tgtakaoka/RetroCyborg/schematics/mc6809/mezzanine_pin.txt

                      BionicMC6809 (backside)
              _________                       _____
 #HALT P40 40|        *|1  VSS        GND  48|    *|1   GND
  XTAL P50 39|         |2  P43 #NMI   P20  47|     |2   P10
 EXTAL P46 38|         |3  P42 #IRQ   P21  46|     |3   P11
#RESET P53 37|         |4  P45 #FIRQ  P22  45|     |4   P12
  MRDY P52 36|         |5  P51 BS     P23  44|  B  |5   P13
     Q P44 35|         |6  P55 BA     P24  43|  i  |6   P14
     E P47 34|         |7  VCC        P25  42|  o  |7   P15
 #BREQ P54 33|    M    |8  P20 A0     P26  41|  n  |8   P16
   R/W P41 32|    C    |9  P21 A1     P27  40|  i  |9   P17
    D0 P10 31|    6    |10 P22 A2      E1  39|  c  |10  E0
    D1 P11 30|    8    |11 P23 A3     P40  38|     |11  P30
    D2 P12 29|    0    |12 P24 A4     P41  37|  C  |12  P31
    D3 P13 28|    9    |13 P25 A5     P42  36|  o  |13  P32
    D4 P14 27|         |14 P26 A6     P43  35|  n  |14  P33
    D5 P15 26|         |15 P27 A7     P44  34|  n  |15  P34
    D6 P16 25|         |16 P30 A8     P45  33|  e  |16  P35
    D7 P17 24|         |17 P31 A9     P46  32|  c  |17  P36
   A15 P37 23|         |18 P32 A10    P47  31|  t  |18  P37
   A14 P36 22|         |19 P33 A11    15V  30|  o  |19  15V
   A13 P35 21|_________|20 P34 A12    P54  29|  r  |20  P50
                                      P55  28|     |21  P51
                                      P56  27|     |22  P52
                                      P57  26|     |23  P53
                                      VCC  25|_____|24  VCC
                                         Bionic Connector
