tgtakaoka/RetroCyborg/schematics/mc6801/mezzanine_pin.txt

                      BionicMC6801 (backside)
              _________                       _____
     E P47 40|        *|1  VSS        GND  48|    *|1   GND
    AS P40 39|         |2  P55 XTAL   P20  47|     |2   P10
   R/W P41 38|         |3  P46 EXTAL  P21  46|     |3   P11
   AD0 P10 37|         |4  P43 #NMI   P22  45|     |4   P12
   AD1 P11 36|         |5  P42 #IRQ1  P23  44|  B  |5   P13
   AD2 P12 35|         |6  P53 #RESET P24  43|  i  |6   P14
   AD3 P13 34|         |7  VCC        P25  42|  o  |7   P15
   AD4 P14 33|    M    |8  P50 PC0    P26  41|  n  |8   P16
   AD5 P15 32|    C    |9  P51 PC1    P27  40|  i  |9   P17
   AD6 P16 31|    6    |10 P52 PC2     E1  39|  c  |10  E0
   AD7 P17 30|    8    |11 P45 RXD    P40  38|     |11  P30
    A8 P20 29|    0    |12 P44 TXD    P41  37|  C  |12  P31
    A9 P21 28|    1    |13 P30 P10    P42  36|  o  |13  P32
   A10 P22 27|         |14 P31 P11    P43  35|  n  |14  P33
   A11 P23 26|         |15 P32 P12    P44  34|  n  |15  P34
   A12 P24 25|         |16 P33 P13    P45  33|  e  |16  P35
   A13 P25 24|         |17 P34 P14    P46  32|  c  |17  P36
   A14 P26 23|         |18 P35 P15    P47  31|  t  |18  P37
   A15 P27 22|         |19 P36 P16    15V  30|  o  |19  15V
       VCC 21|_________|20 P37 P17    P54  29|  r  |20  P50
                                      P55  28|     |21  P51
                                      P56  27|     |22  P52
                                      P57  26|     |23  P53
                                      VCC  25|_____|24  VCC
                                         Bionic Connector
