tgtakaoka/RetroCyborg/schematics/mc6800/mezzanine_pin.txt

                      BionicMC6800 (backside)
              _________                       _____
#RESET P53 40|        *|1  VSS        GND  48|    *|1   GND
   TSC P54 39|         |2  P40 #HALT  P20  47|     |2   P10
           38|         |3  P46 PHI1   P21  46|     |3   P11
  PHI2 P47 37|         |4  P42 #IRQ   P22  45|     |4   P12
   DBE P52 36|         |5  P50 VMA    P23  44|  B  |5   P13
           35|         |6  P43 #NMI   P24  43|  i  |6   P14
  R/#W P41 34|         |7  P55 BA     P25  42|  o  |7   P15
    D0 P00 33|    M    |8  VCC        P26  41|  n  |8   P16
    D1 P01 32|    C    |9  P20 A0     P27  40|  i  |9   P17
    D2 P02 31|    6    |10 P21 A1      E1  39|  c  |10  E0
    D3 P03 30|    8    |11 P22 A2     P40  38|     |11  P30
    D4 P04 29|    0    |12 P23 A3     P41  37|  C  |12  P31
    D5 P05 28|    0    |13 P24 A4     P42  36|  o  |13  P32
    D6 P06 27|         |14 P25 A5     P43  35|  n  |14  P33
    D7 P07 26|         |15 P26 A6     P44  34|  n  |15  P34
   A15 P37 25|         |16 P27 A7     P45  33|  e  |16  P35
   A14 P36 24|         |17 P30 A8     P46  32|  c  |17  P36
   A13 P35 23|         |18 P31 A9     P47  31|  t  |18  P37
   A12 P34 22|         |19 P32 A10    15V  30|  o  |19  15V
       VSS 21|_________|20 P33 A11    P54  29|  r  |20  P50
                                      P55  28|     |21  P51
                                      P56  27|     |22  P52
                                      P57  26|     |23  P53
                                      VCC  25|_____|24  VCC
                                         Bionic Connector
