tgtakaoka/RetroCyborg/schematics/mc146805e2/mezzanine_pin.txt

                     BionicMC146805E (backside)
             _________                        _____
      VDD 40|        *|1  P53 #RESETT GND  48|    *|1   GND
 OSC1 P46 39|         |2  P42 #IRQ    P20  47|     |2   P10
 OSC2     38|         |3  P51 LI      P21  46|     |3   P11
TIMER P45 37|         |4  P50 DS      P22  45|     |4   P12
  PB0     36|         |5  P41 R/W     P23  44|  B  |5   P13
  PB1     35|         |6  P40 AS      P24  43|  i  |6   P14
  PB2     34|    M    |7      PA7     P25  42|  o  |7   P15
  PB3     33|    C    |8      PA6     P26  41|  n  |8   P16
  PB4     32|    1    |9      PA5     P27  40|  i  |9   P17
  PB5     31|    4    |10     PA4      E1  39|  c  |10  E0
  PB6     30|    6    |11     PA3     P40  38|     |11  P30
  PB7     29|    8    |12     PA2     P41  37|  C  |12  P31
   B0 P10 28|    0    |13     PA1     P42  36|  o  |13  P32
   B1 P11 27|    5    |14     PA0     P43  35|  n  |14  P33
   B2 P12 26|         |15 P24 A12     P44  34|  n  |15  P34
   B3 P13 25|         |16 P23 A11     P45  33|  e  |16  P35
   B4 P14 24|         |17 P22 A10     P46  32|  c  |17  P36
   B5 P15 23|         |18 P21 A9      P47  31|  t  |18  P37
   B6 P16 22|         |19 P20 A8      15V  30|  o  |19  15V
   B7 P17 21|_________|20 VSS         P54  29|  r  |20  P50
                                      P55  28|     |21  P51
                                      P56  27|     |22  P52
                                      P57  26|     |23  P53
                                      VCC  25|_____|24  VCC
                                         Bionic Connector
