tgtakaoka/RetroCyborg/schematics/ins8070/mezzanine_pin.txt

                      BionicINS8070 (backside)
              _________                       _____
       VCC 40|        *|1  P55 #ENOUT GND  48|    *|1   GND
    SB P43 39|         |2  P54 #ENIN  P20  47|     |2   P10
    SA P42 38|         |3  P47 #BREQ  P21  46|     |3   P11
  #RST P53 37|         |4  P50 #RDS   P22  45|     |4   P12
    F3 P51 36|         |5  P52 #HOLD  P23  44|  B  |5   P13
    F2 P45 35|         |6  P41 #WDS   P24  43|  i  |6   P14
    F1 P44 34|    I    |7      XOUT   P25  42|  o  |7   P15
    D0 P10 33|    N    |8  P46 XIN    P26  41|  n  |8   P16
    D1 P11 32|    S    |9  P37 A15    P27  40|  i  |9   P17
    D2 P12 31|    8    |10 P36 A14     E1  39|  c  |10  E0
    D3 P13 30|    0    |11 P35 A13    P40  38|     |11  P30
    D4 P14 29|    7    |12 P34 A12    P41  37|  C  |12  P31
    D5 P15 28|    0    |13 P33 A11    P42  36|  o  |13  P32
    D6 P16 27|         |14 P32 A10    P43  35|  n  |14  P33
    D7 P17 26|         |15 P31 A9     P44  34|  n  |15  P34
    A0 P20 25|         |16 P30 A8     P45  33|  e  |16  P35
    A1 P21 24|         |17 P27 A7     P46  32|  c  |17  P36
    A2 P22 23|         |18 P26 A6     P47  31|  t  |18  P37
    A3 P23 22|         |19 P25 A5     15V  30|  o  |19  15V
    A4 P24 21|_________|20 GND        P54  29|  r  |20  P50
                                      P55  28|     |21  P51
                                      P56  27|     |22  P52
                                      P57  26|     |23  P53
                                      VCC  25|_____|24  VCC
                                         Bionic Connector
