tgtakaoka/RetroCyborg/BionicMC6800/breadboard_pin.txt

   Bionic Teensy 3.5 Bread board
              _________
 1        GND|*        |VIN        1
 2  P44 PTB16|         |AGND       2
 3  P45 PTB17|         |3.3V       3
 4  P10  PTD0|         |PTC2  P22  4
 5  P34 PTA12|         |PTC1  P21  5
 6  P35 PTA13|         |PTD6  P16  6
 7  P17  PTD7|         |PTD5  P15  7
 8  P14  PTD4|    T    |PTB2  P42  8
 9  P12  PTD2|    e    |PTB3  P43  9
10  P13  PTD3|    e    |PTB1  P41  10
11  P23  PTC3|    n    |PTB0  P40  11
12  P24  PTC4|    s    |PTC0  P20  12
13  P26  PTC6|    y    |PTD1  P11  13
14  P27  PTC7|         |PTC5  P25  14
15       3.3V|    3    |GND        15
16  P52 PTE26|    .    |           16
17  P53  PTA5|    5    |           17
18  P36 PTA14|         |PTA17 P55  18
19  P37 PTA15|         |PTC11 P33  19
20  P54 PTA16|         |PTC10 P32  20
21  P46 PTB18|         |PTC9  P31  21
22  P47 PTB19|         |PTC8  P30  22
23  P56 PTB10|         |PTE25 P51  23
24  P57 PTB11|_________|PTE24 P50  24
25                                 25
26                                 26
27                                 27
28                                 28
29            _________            29
30           |         |           30
31           |         |           31
32           |         |           32
33           |_________|           33
34    VSS   1|*        |40  #RESET 34
35  #HALT   2|         |39  TSC    35
36   PHI1   3|         |38  NC     36
37   #IRQ   4|         |37  PHI2   37
38    VMA   5|         |36  DBE    38
39   #NMI   6|         |35  NC     39
40     BA   7|         |34  R/W    40
41    VCC   8|    M    |33  D0     41
42     A0   9|    C    |32  D1     42
43     A1  10|    6    |31  D2     43
44     A2  11|    8    |30  D3     44
45     A3  12|    0    |29  D4     45
46     A4  13|    0    |28  D5     46
47     A5  14|         |27  D6     47
48     A6  15|         |26  D7     48
49     A7  16|         |25  A15    49
50     A8  17|         |24  A14    50
51     A9  18|         |23  A13    51
52    A10  19|         |22  A12    52
53    A11  20|_________|21  VSS    53
54                                 54
55                                 55
56              _____              56
57       1OE  1|*    |14  Vcc      57
58        1A  2|  7  |13  4OE      58
59        1Y  3|  4  |12  4A       59
60       2OE  4|  1  |11  4Y       60
61        2A  5|  2  |10  3OE      61
62        2Y  6|  6  |9   3A       62
63       GND  7|_____|8   3Y       63
