tgtakaoka/RetroCyborg/schematics/base/0-LocalLibrary/3D/ZIF-Socket-48-pin.stp

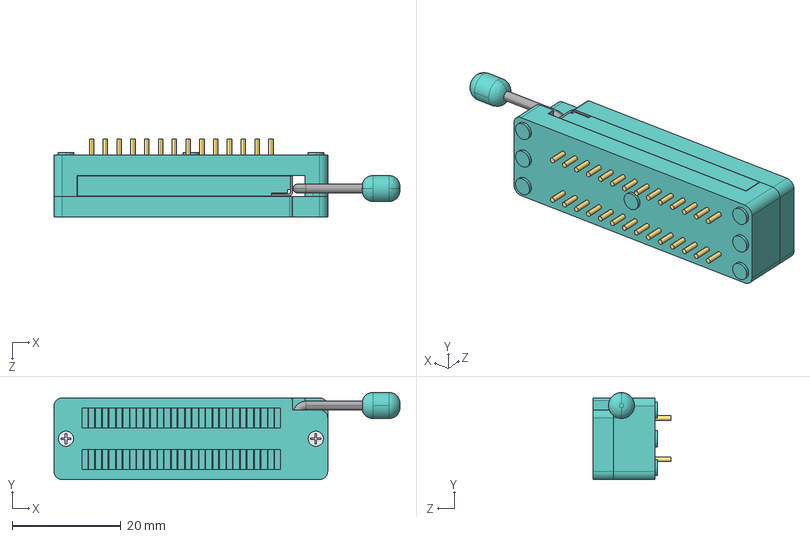
[picture p1: CAD file, 2021-11-28]
schematics/base/0-LocalLibrary/3D/ZIF-Socket-48-pin.stp
63.7 x 16.0 x 14.4 mm
Contacts
Pins001
Screw002
Bottom-Shape
Lever-Tip
Top-Shape
Push-Bar
Lever-Bar
Screw001
