tgtakaoka/RetroCyborg/(threads)

Thread 17 (2021-02-02):

[CyborgHD6309E] Clock generator can't start at power on

tgtakaoka, 2021-02-02:
Frequently on power on, the clock generator doesn't start oscillating and stuck with #INT=L.

Closed 2021-06-16.

Thread 18 (2021-02-05):

[CyborgHD6309E] Prototype5 MC6850 emulator sometimes repeats input unexpectedly

tgtakaoka, 2021-02-05:
HD63C09E suffers this issue much often than MC68B09E.
MC68B09E runs almost perfectly.
