tgtakaoka/RetroCyborg/schematics/z8800/bionic-z8800.pdf

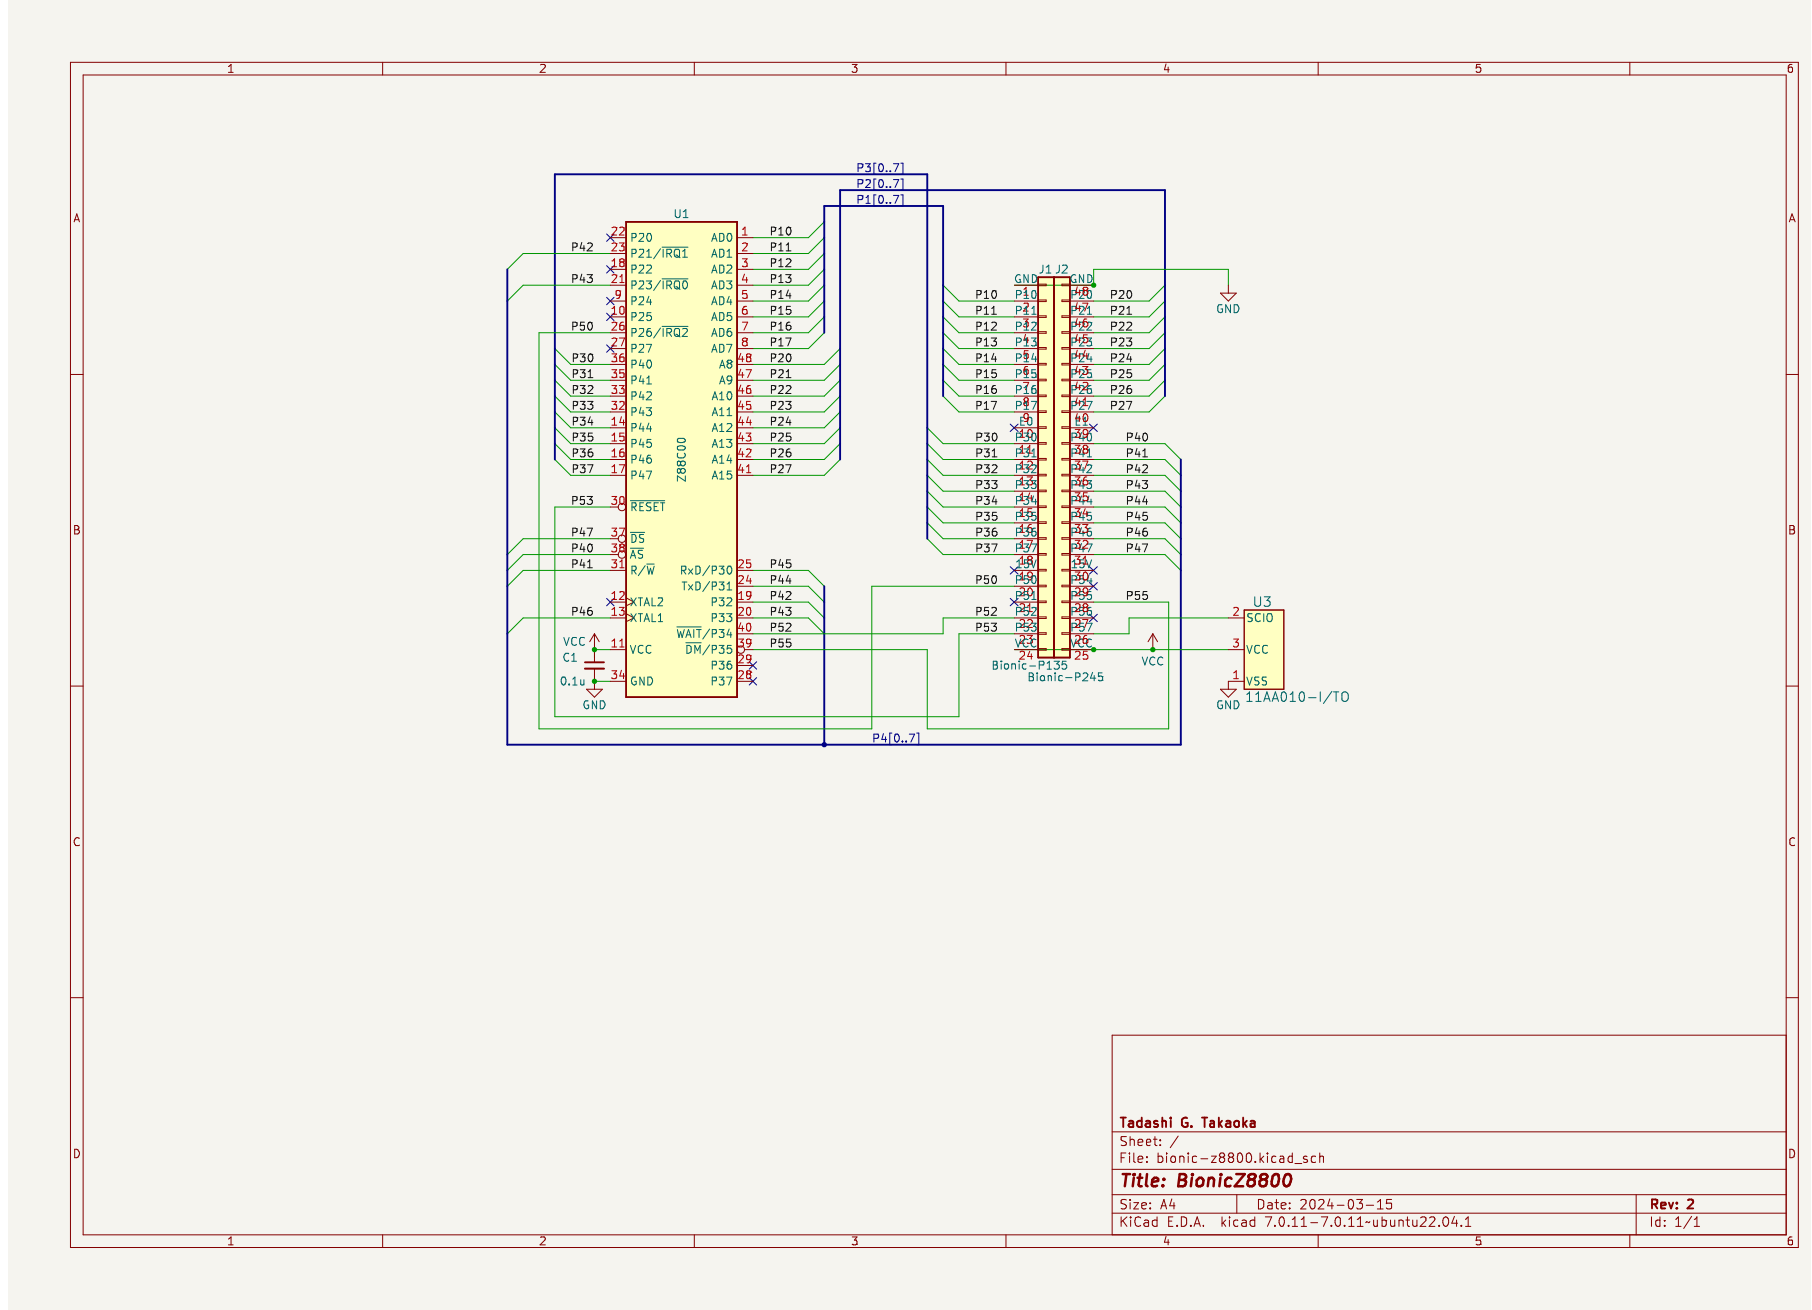
[picture p2: page 1]
