tgtakaoka/RetroCyborg/schematics/z8691/bionic-z8691.pdf

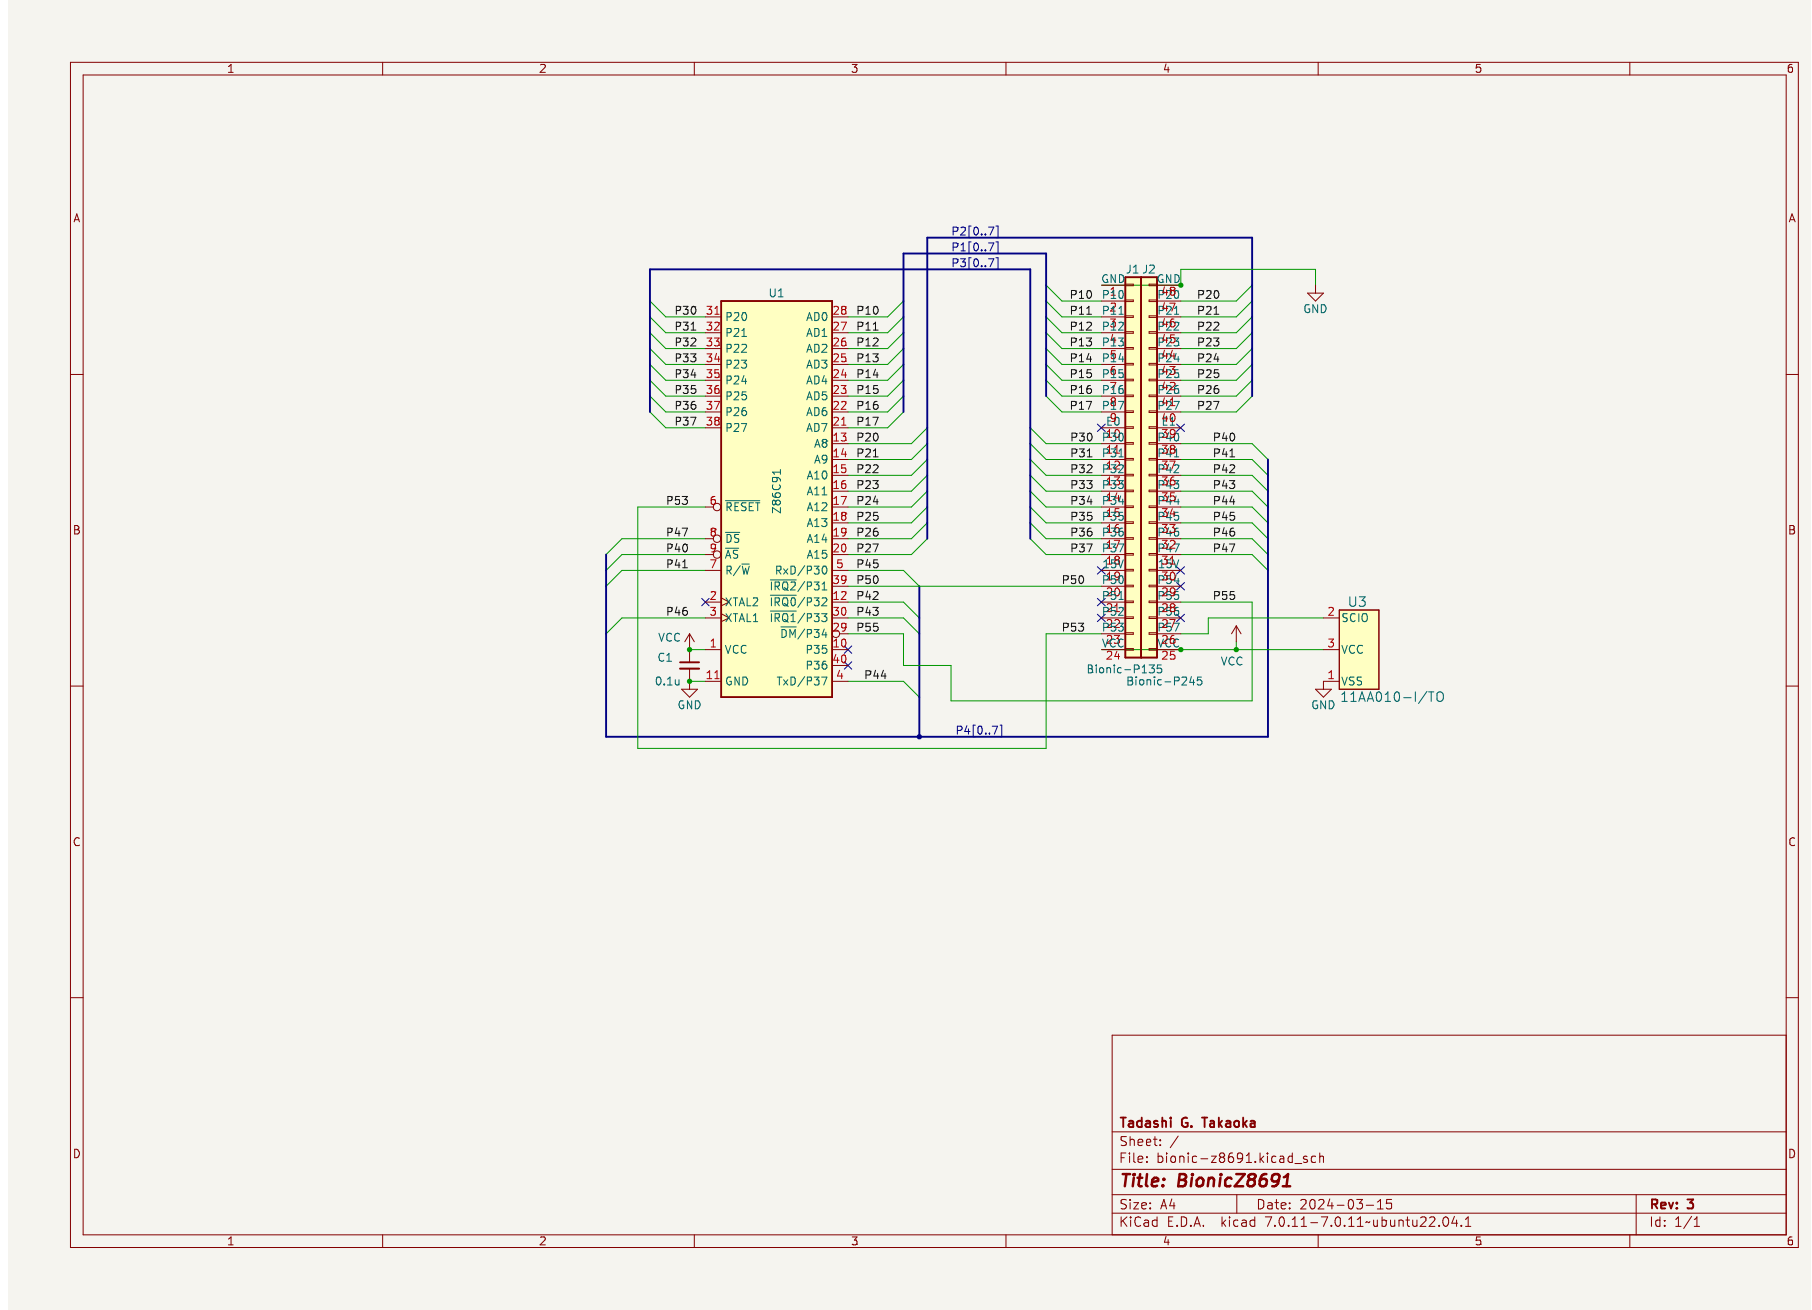
[picture p3: page 1]
