tgtakaoka/RetroCyborg/schematics/tmp90c802/bionic-tmp90c802.pdf

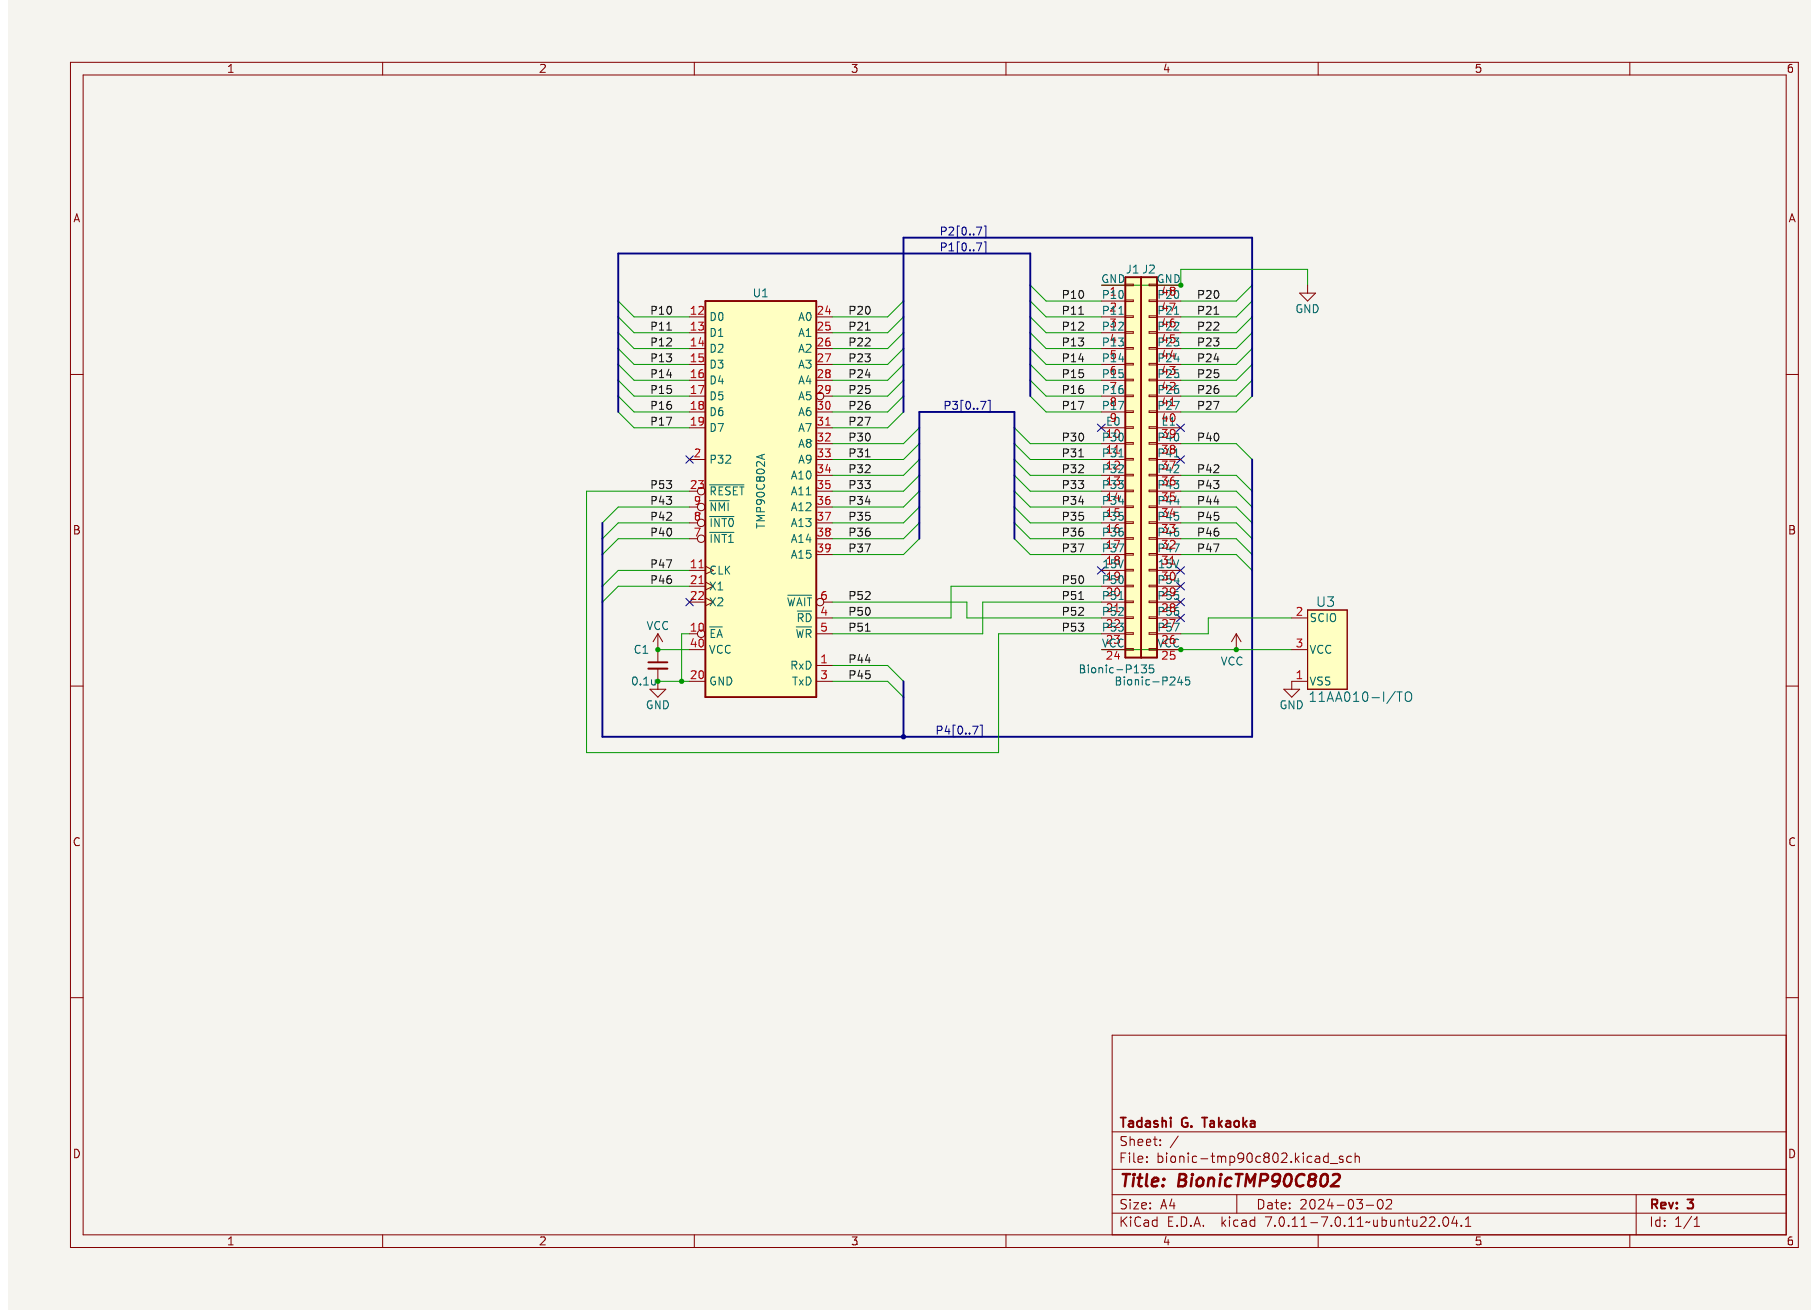
[picture p4: page 1]
