tgtakaoka/RetroCyborg/schematics/p8085/bionic-p8085.pdf

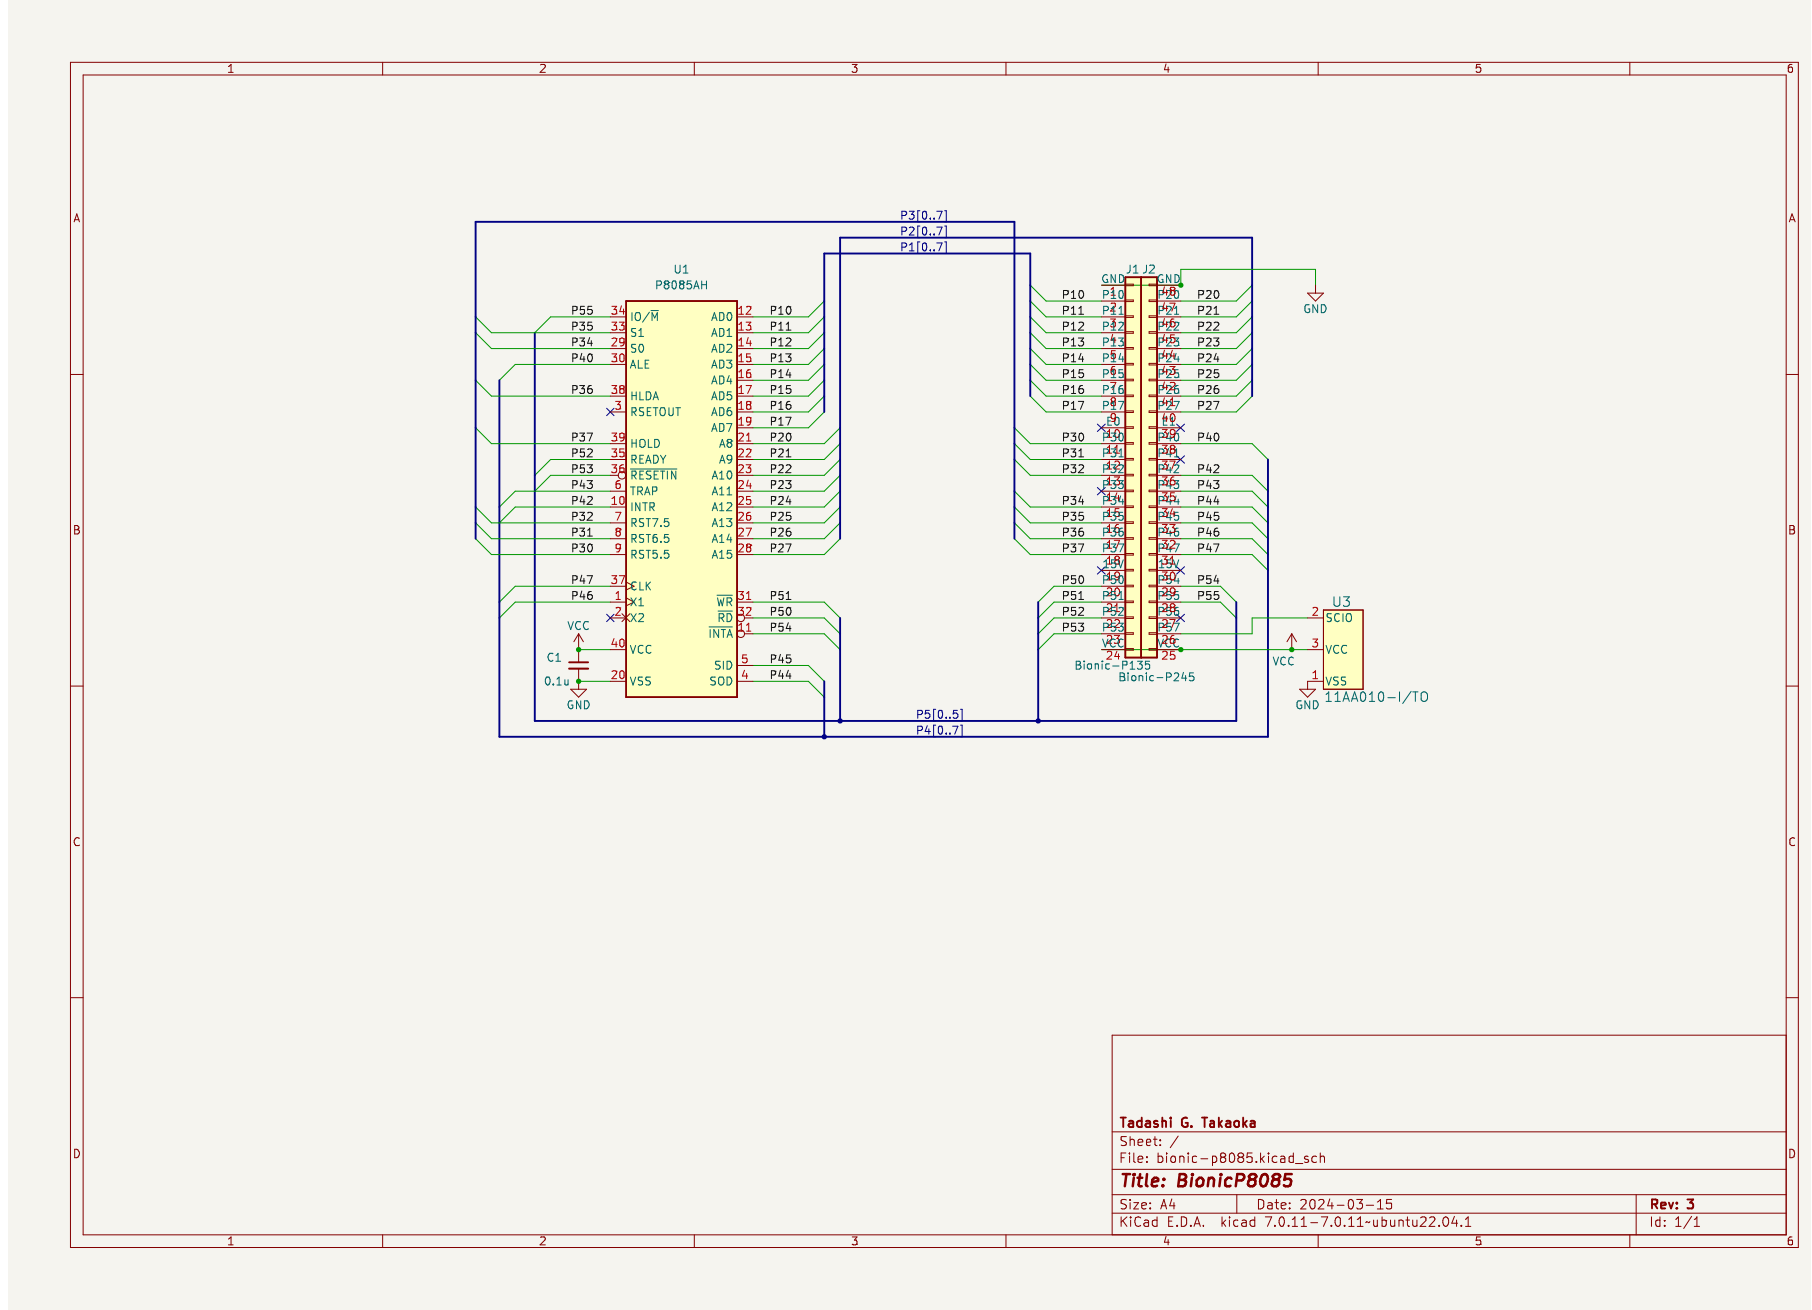
[picture p5: page 1]
