tgtakaoka/RetroCyborg/schematics/mos6502/bionic-mos6502.pdf

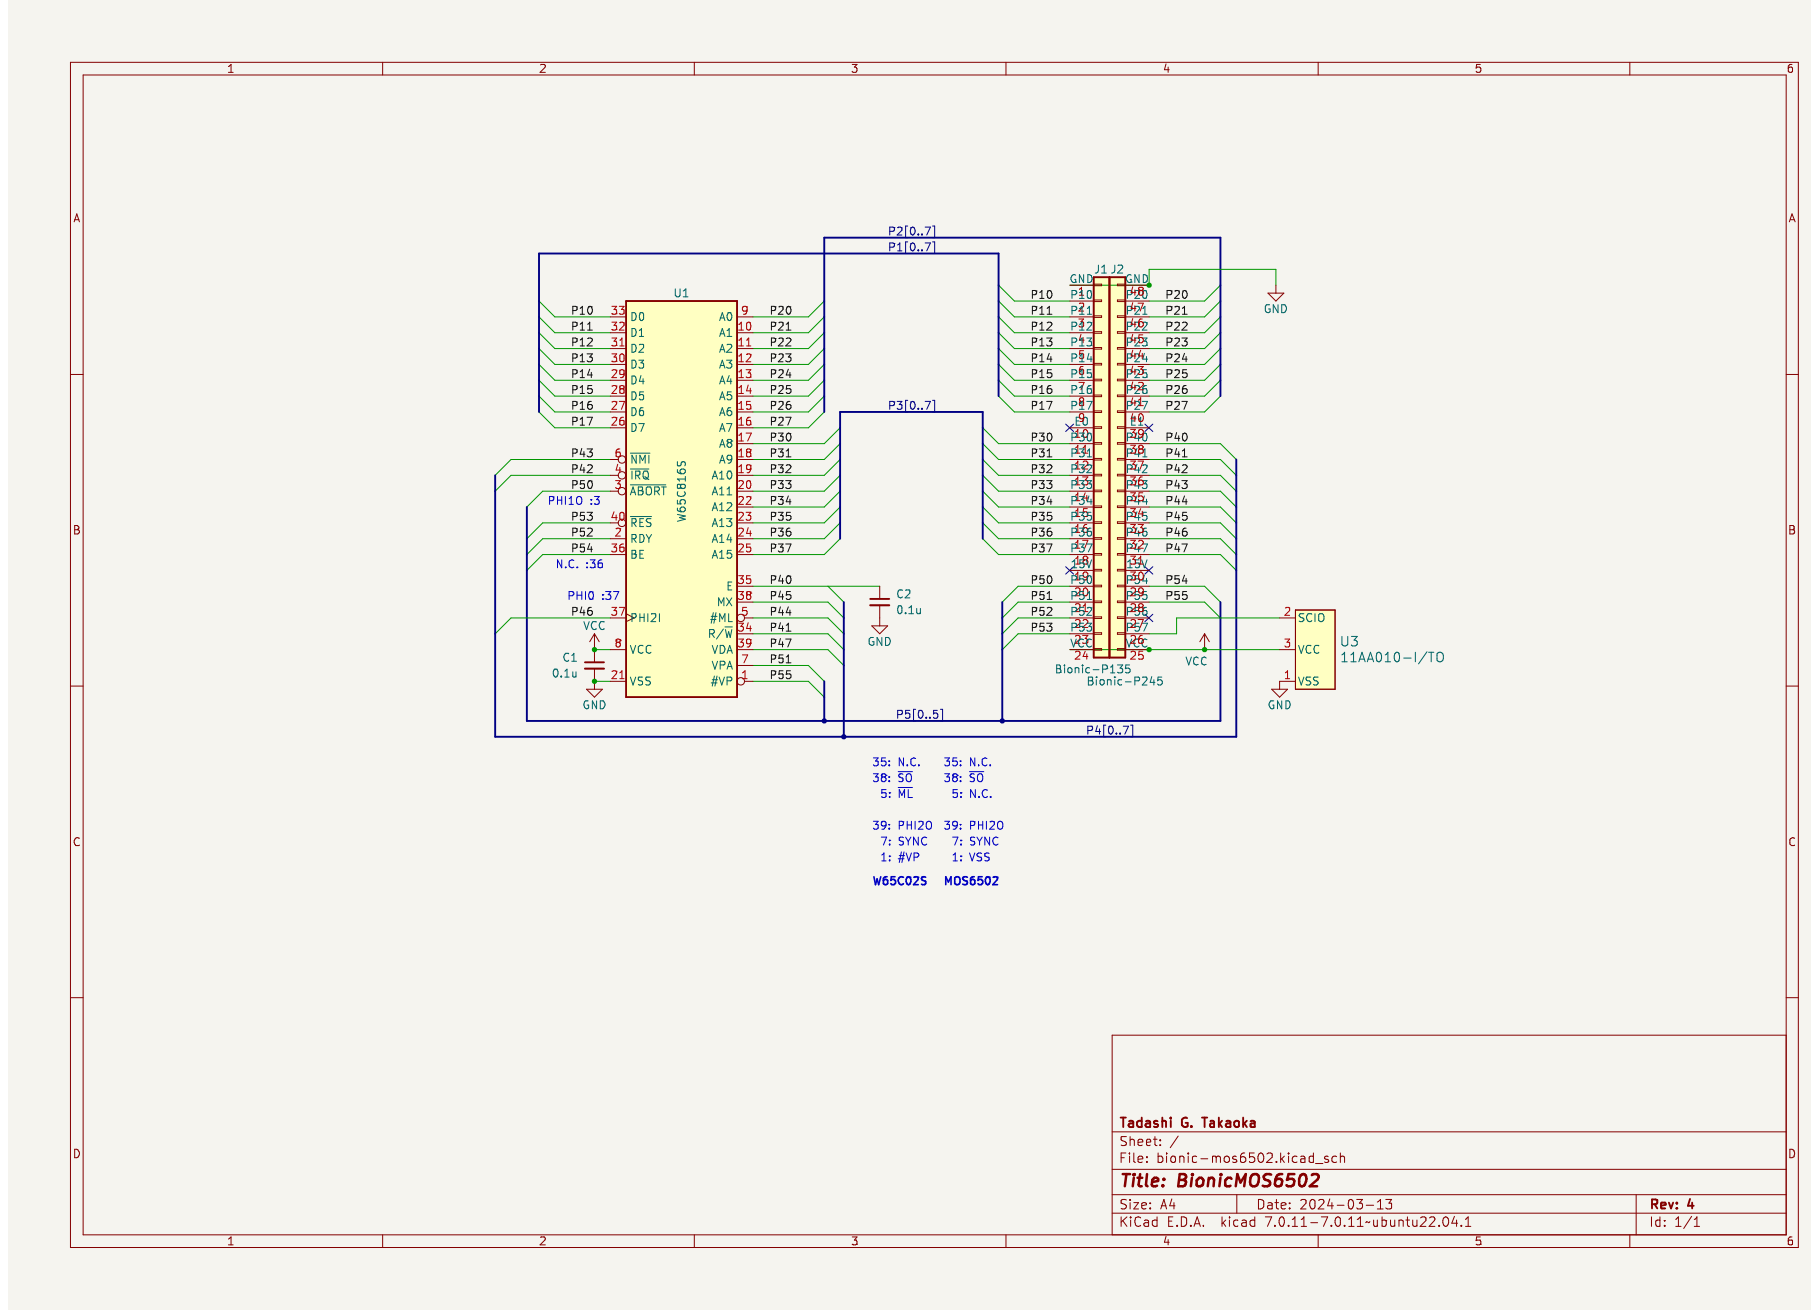
[picture p6: page 1]
