tgtakaoka/RetroCyborg/schematics/mc68hc11d/bionic-mc68hc11d.pdf

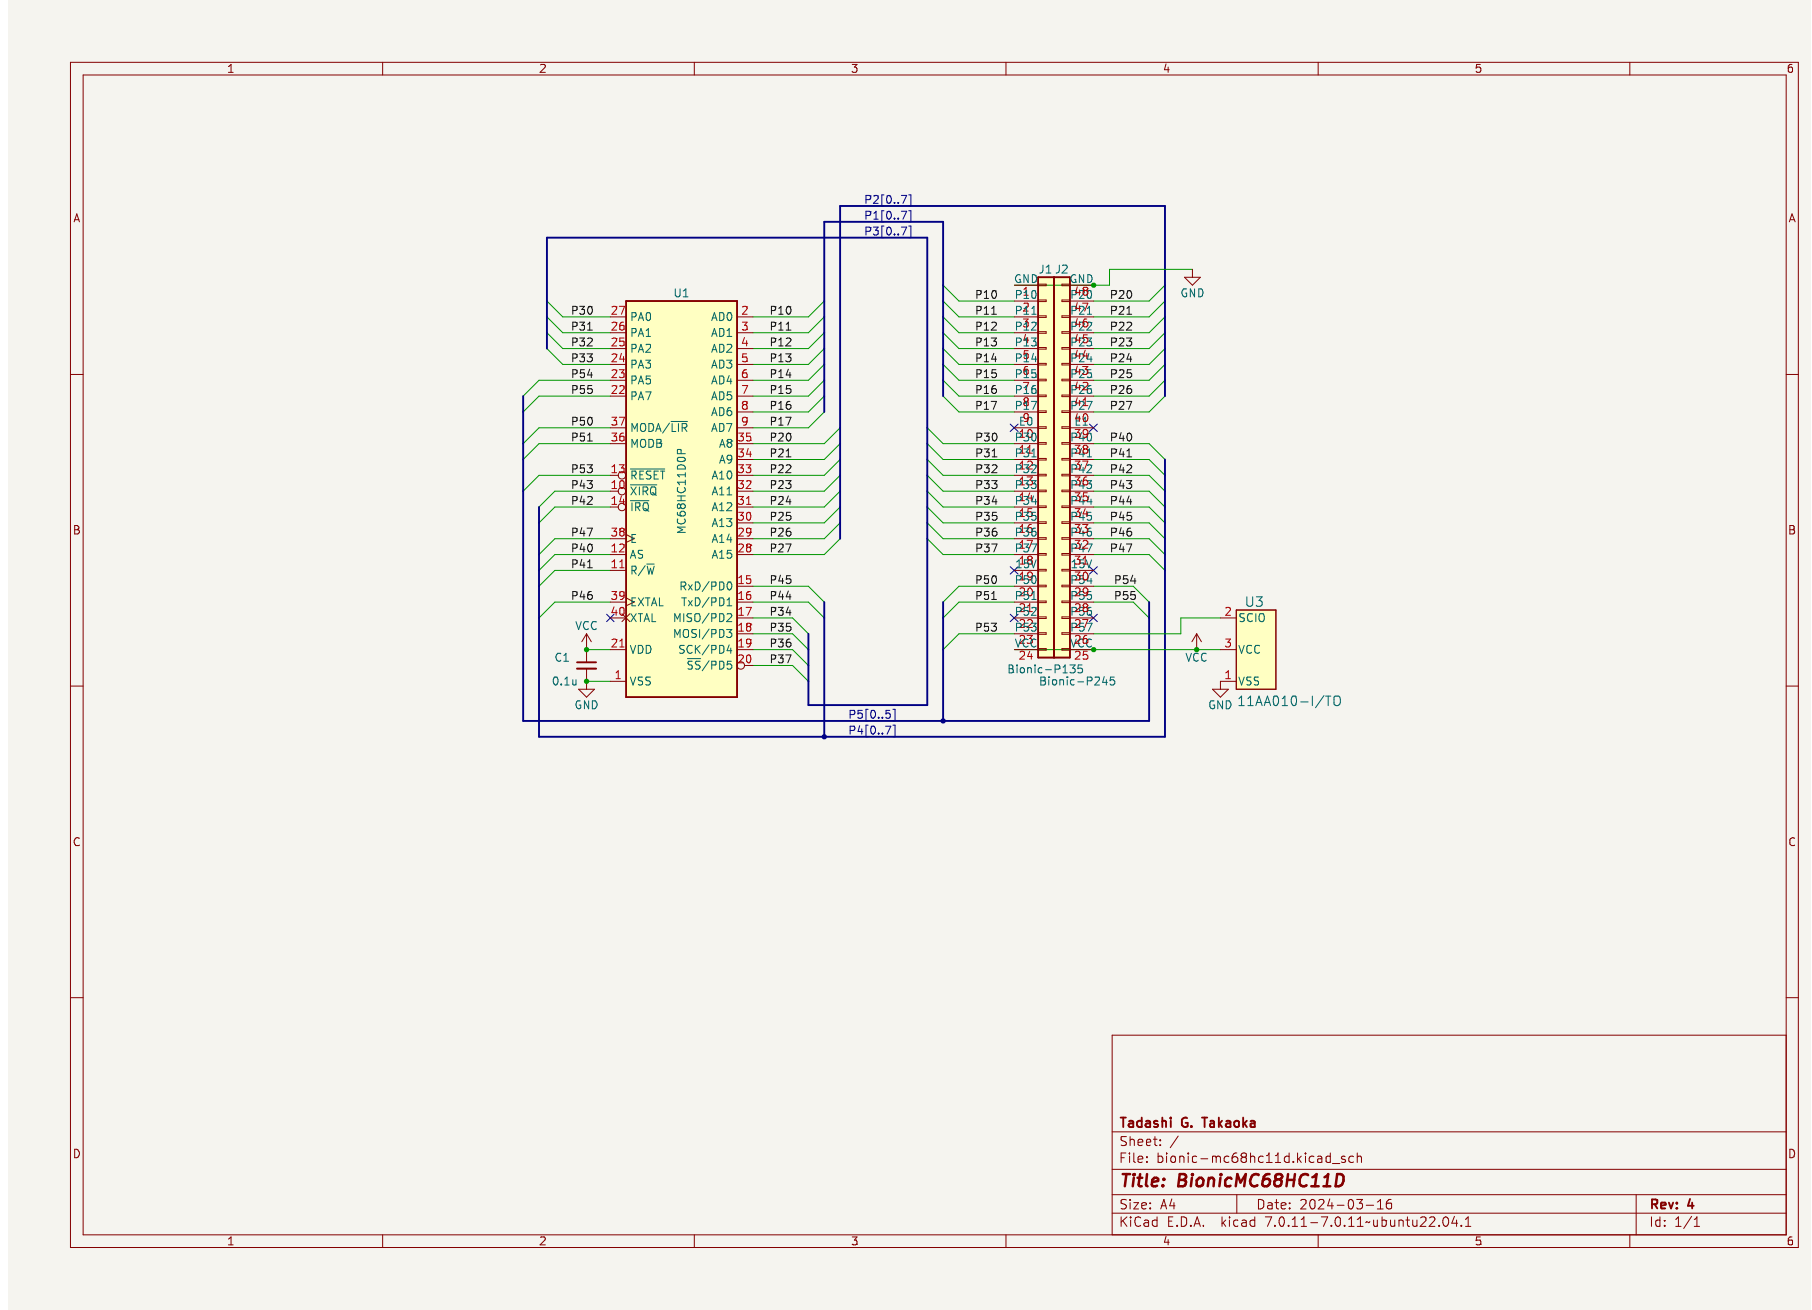
[picture p7: page 1]
