tgtakaoka/RetroCyborg/schematics/mc6809e/bionic-mc6809e.pdf

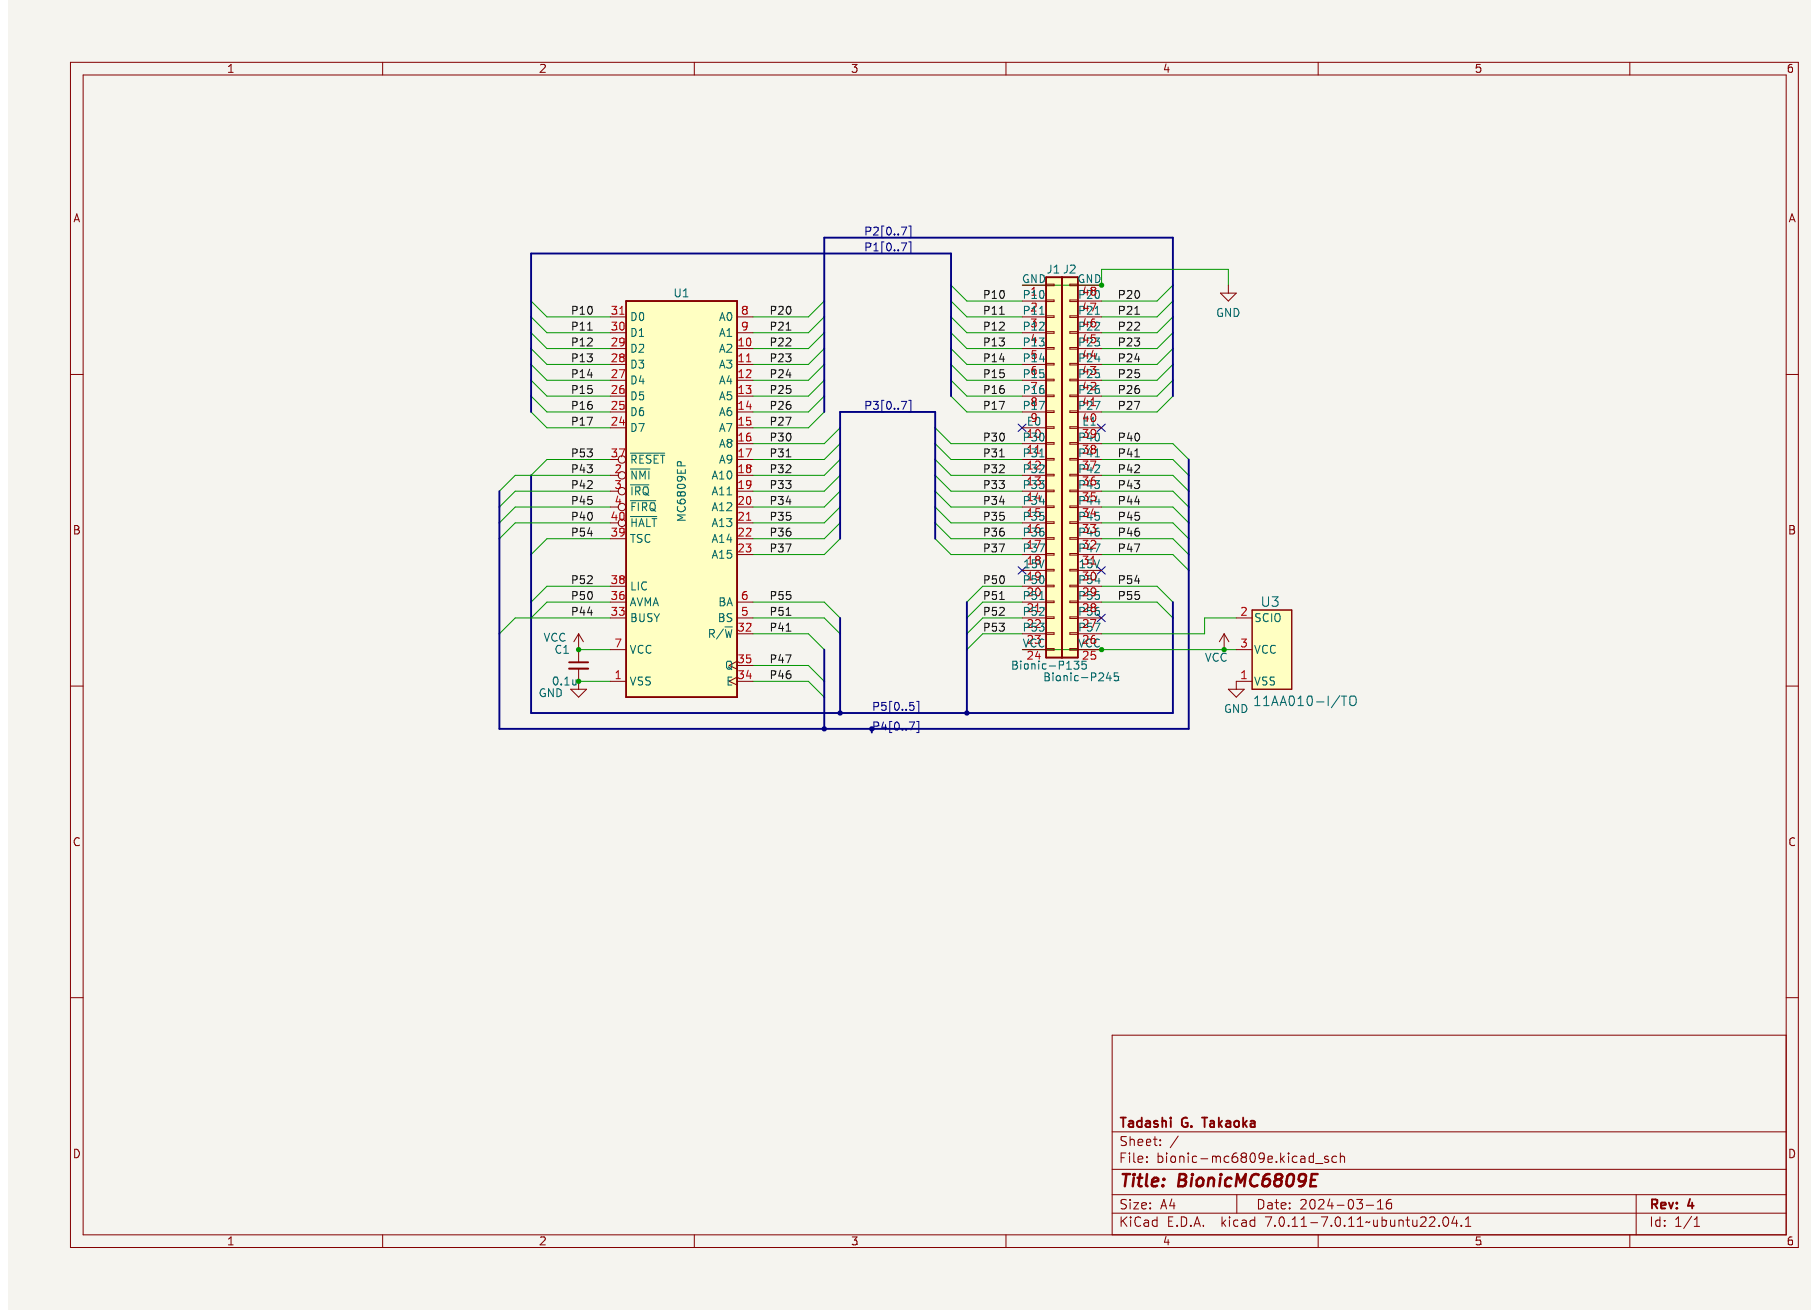
[picture p8: page 1]
