tgtakaoka/RetroCyborg/schematics/mc6809/bionic-mc6809.pdf

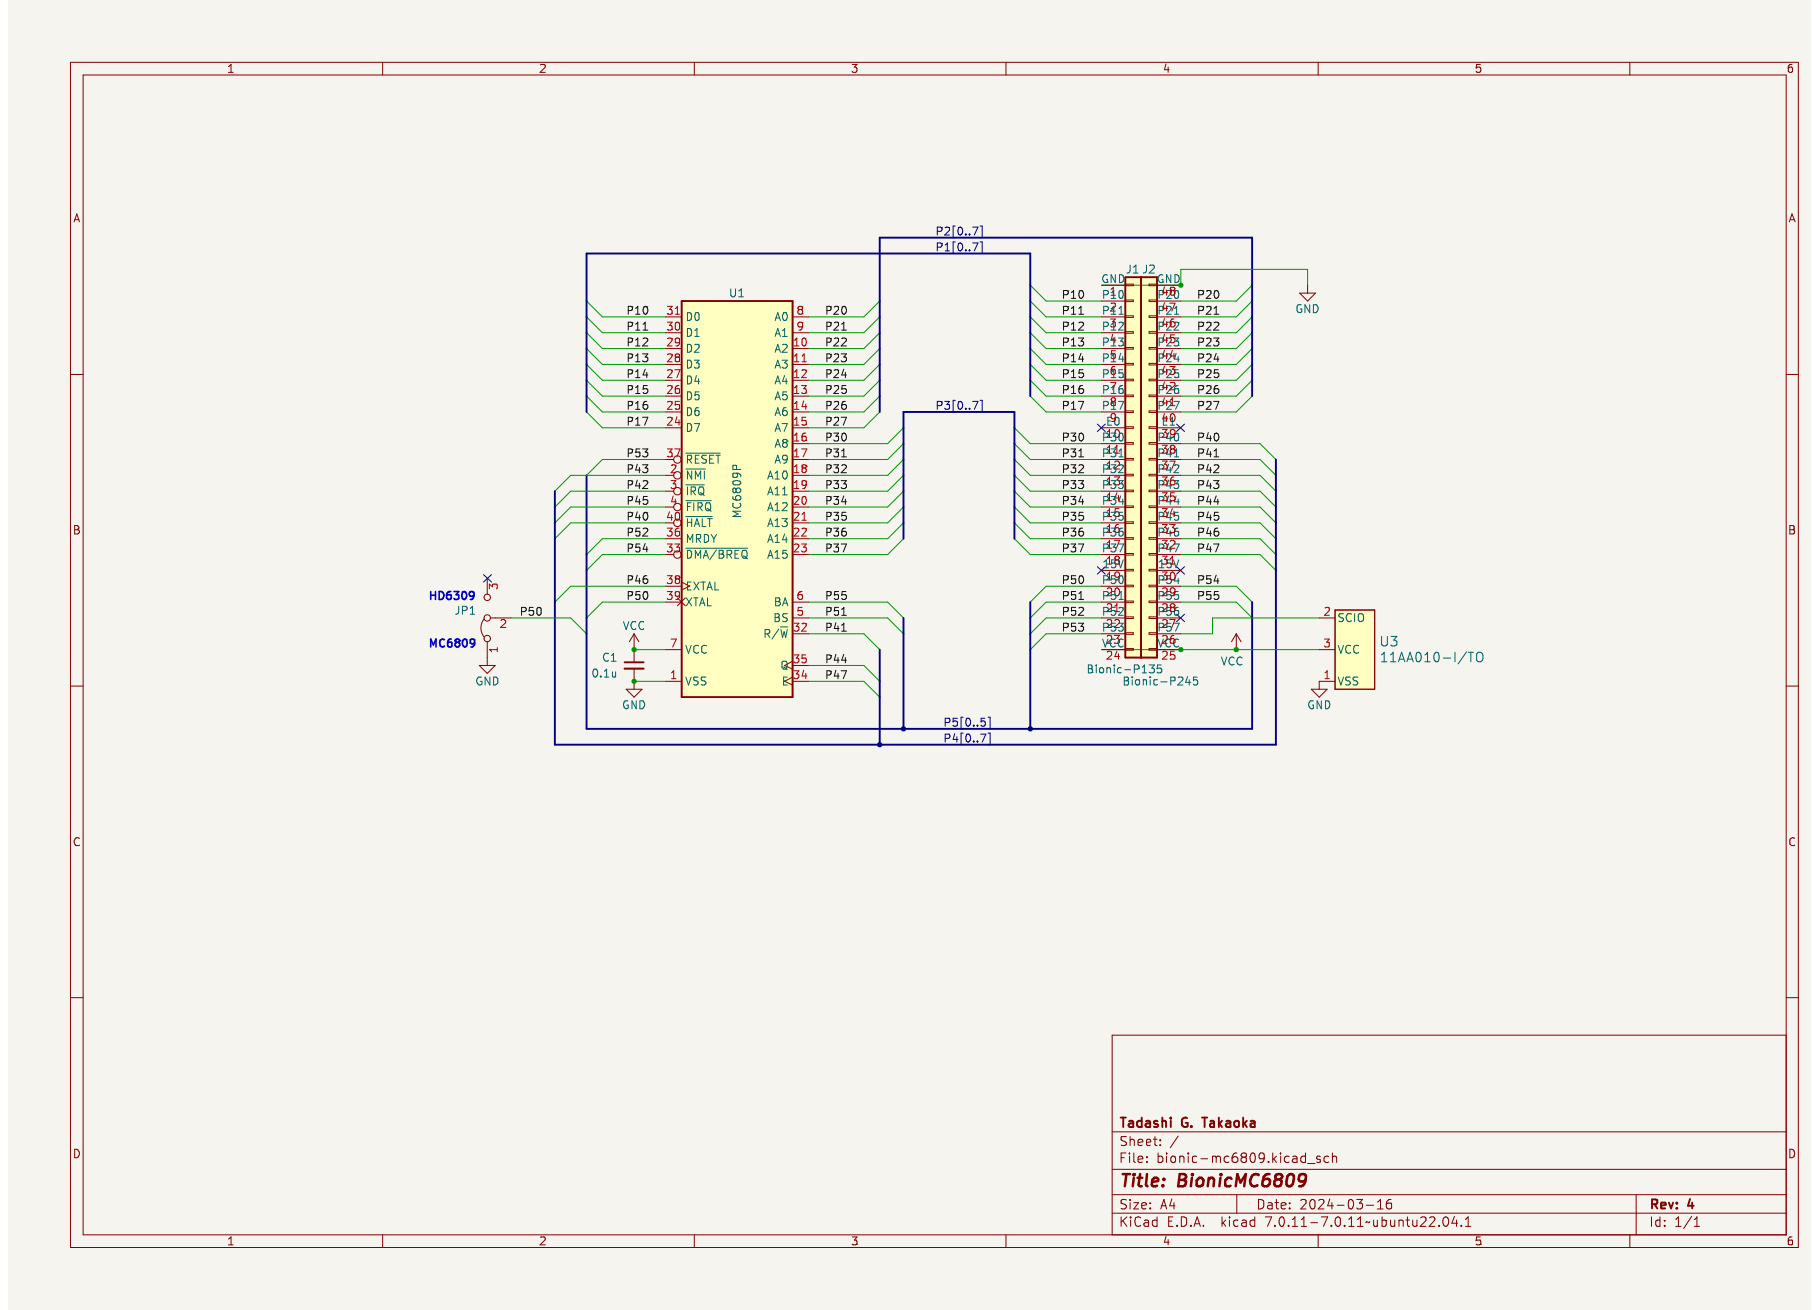
[picture p9: page 1]
