tgtakaoka/RetroCyborg/schematics/mc6802/bionic-mc6802.pdf

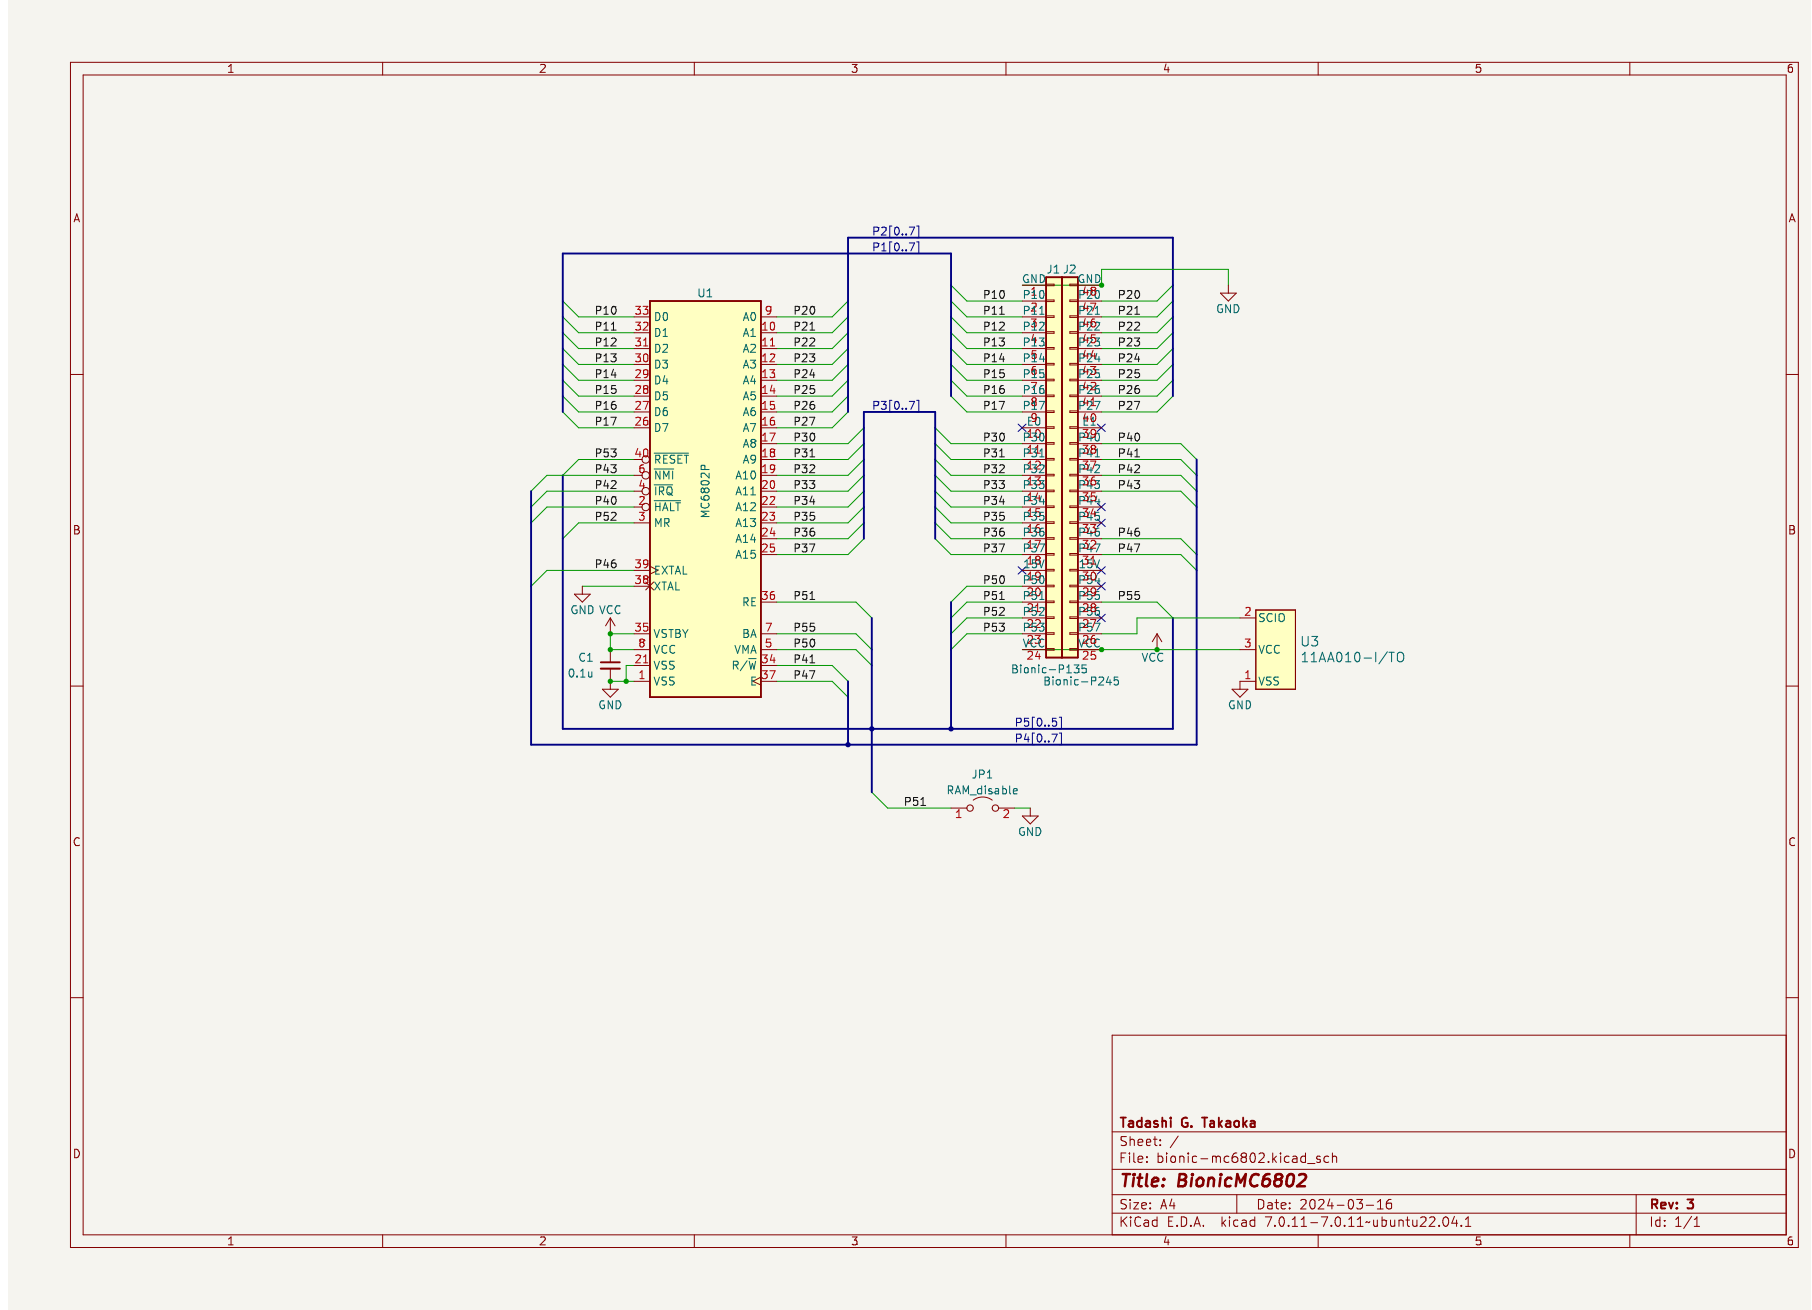
[picture p10: page 1]
