tgtakaoka/RetroCyborg/schematics/mc6801/bionic-mc6801.pdf

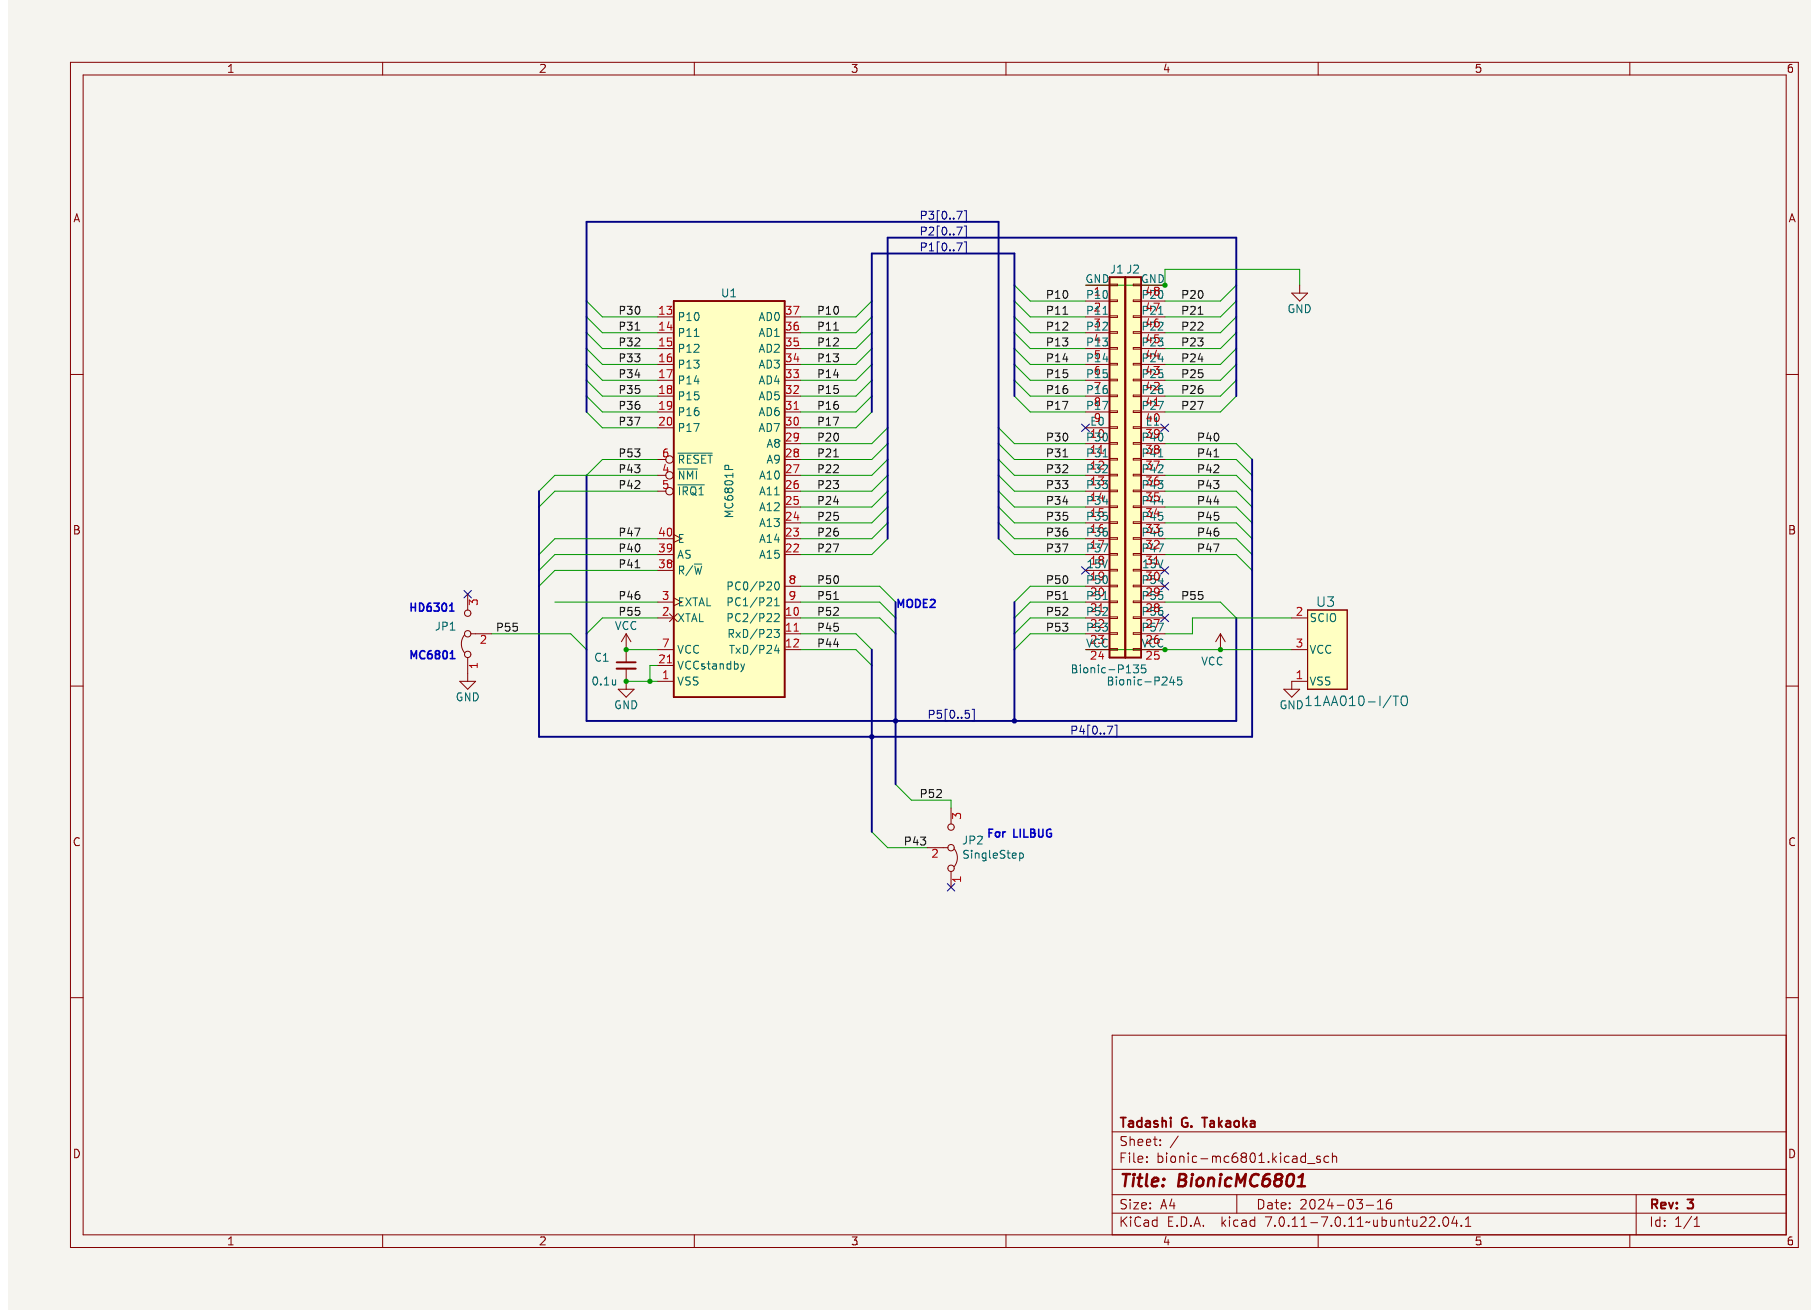
[picture p11: page 1]
