tgtakaoka/RetroCyborg/schematics/mc6800/bionic-mc6800.pdf

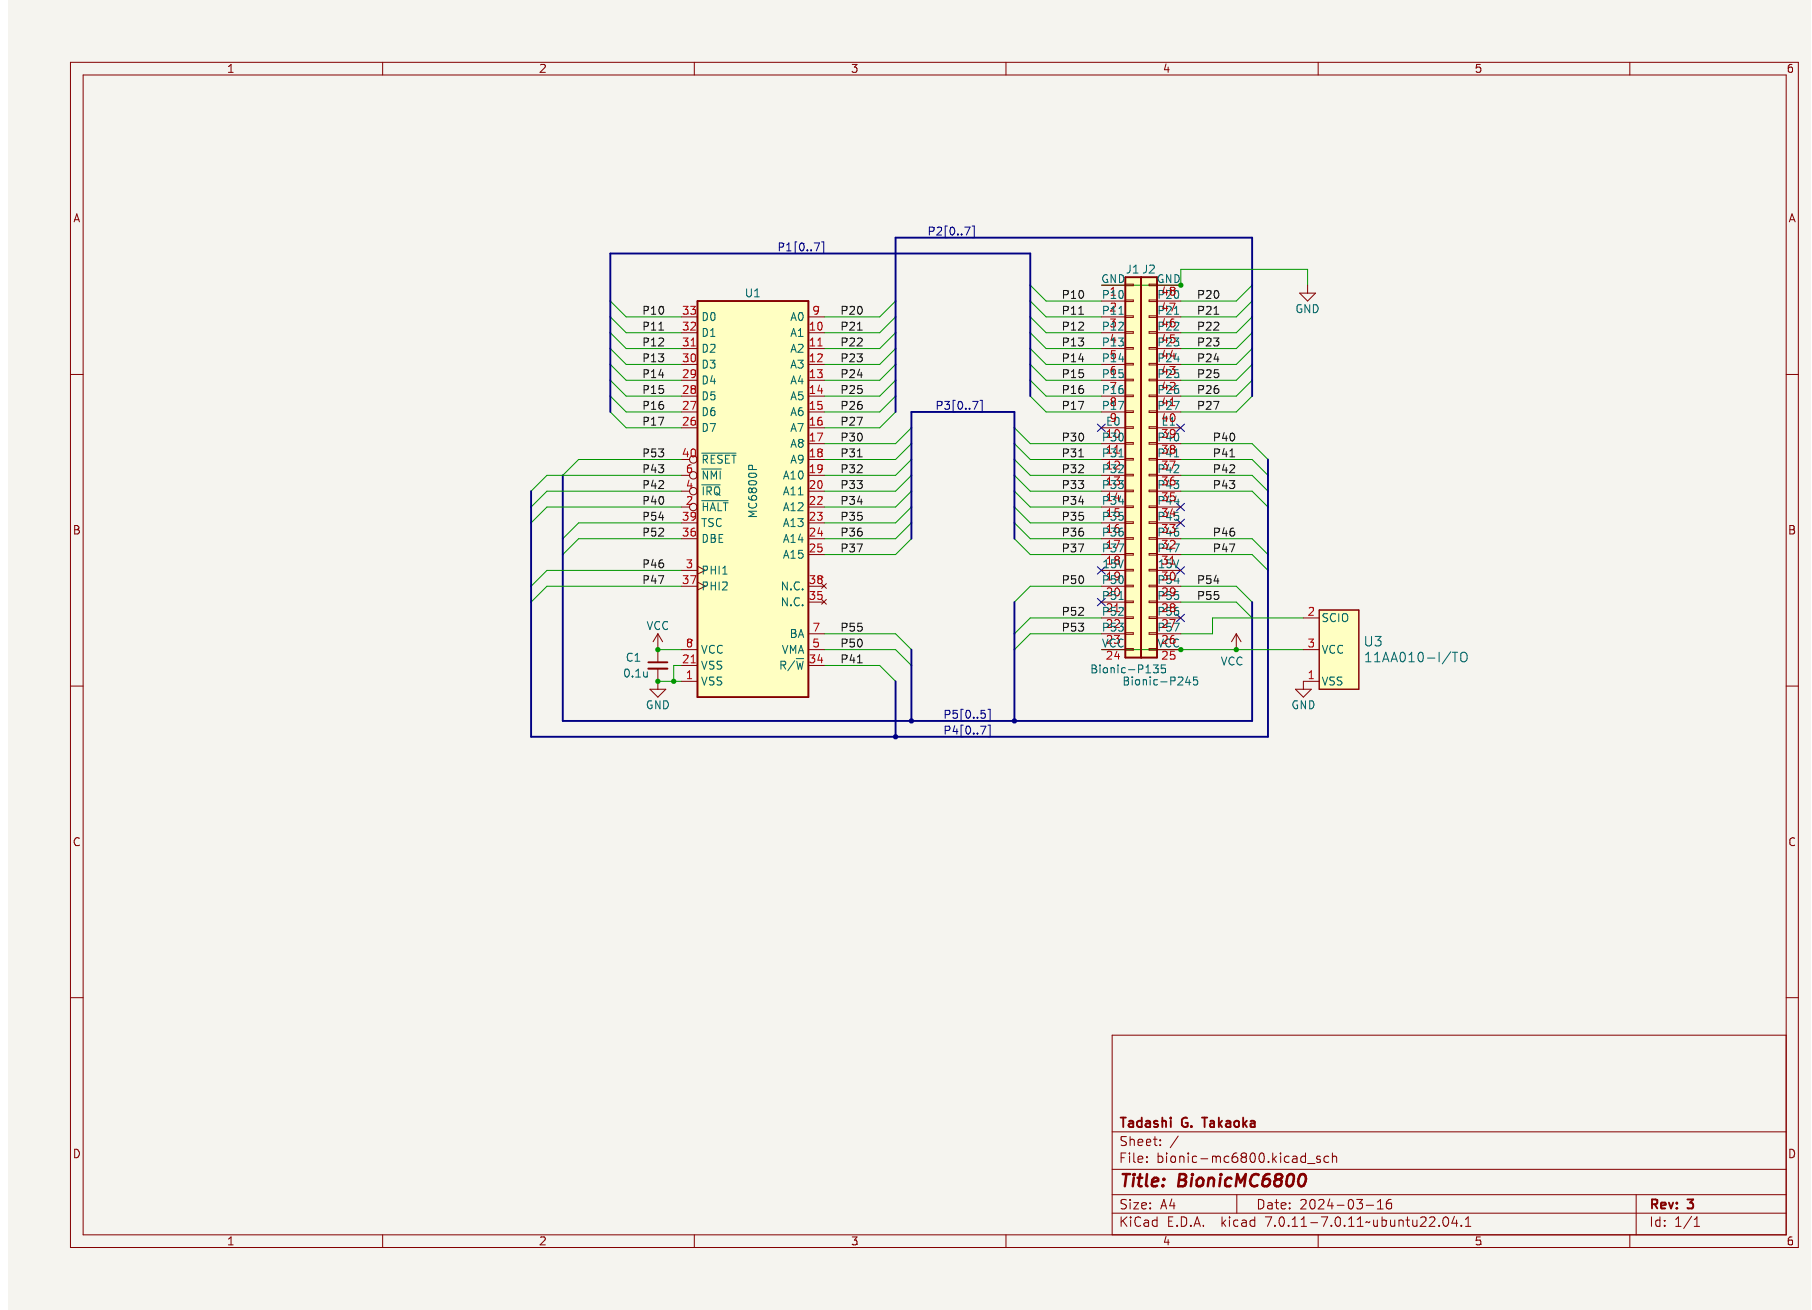
[picture p12: page 1]
