tgtakaoka/RetroCyborg/schematics/mc146805e2/bionic-mc146805e2.pdf

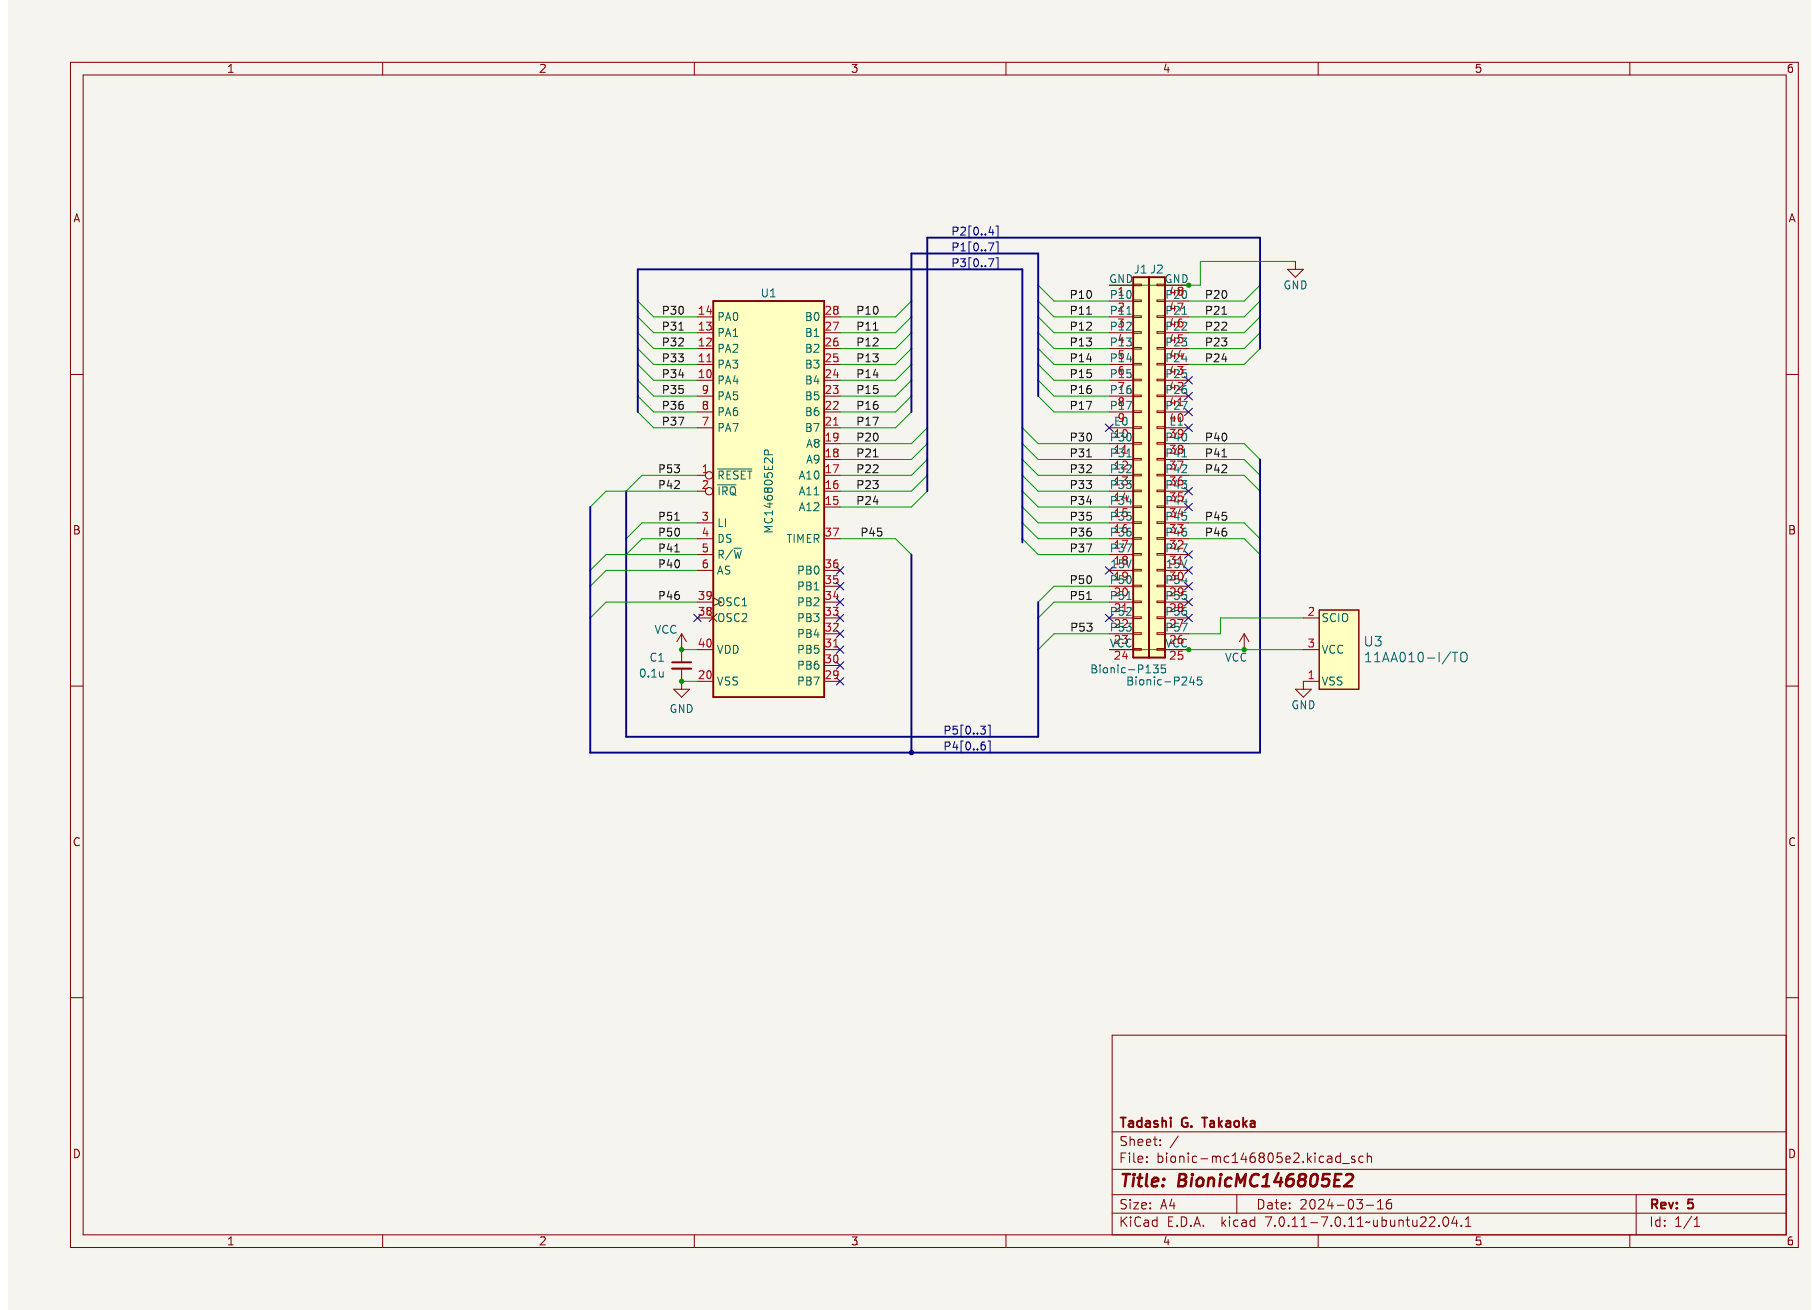
[picture p13: page 1]
