tgtakaoka/RetroCyborg/schematics/ins8070/bionic-ins8070.pdf

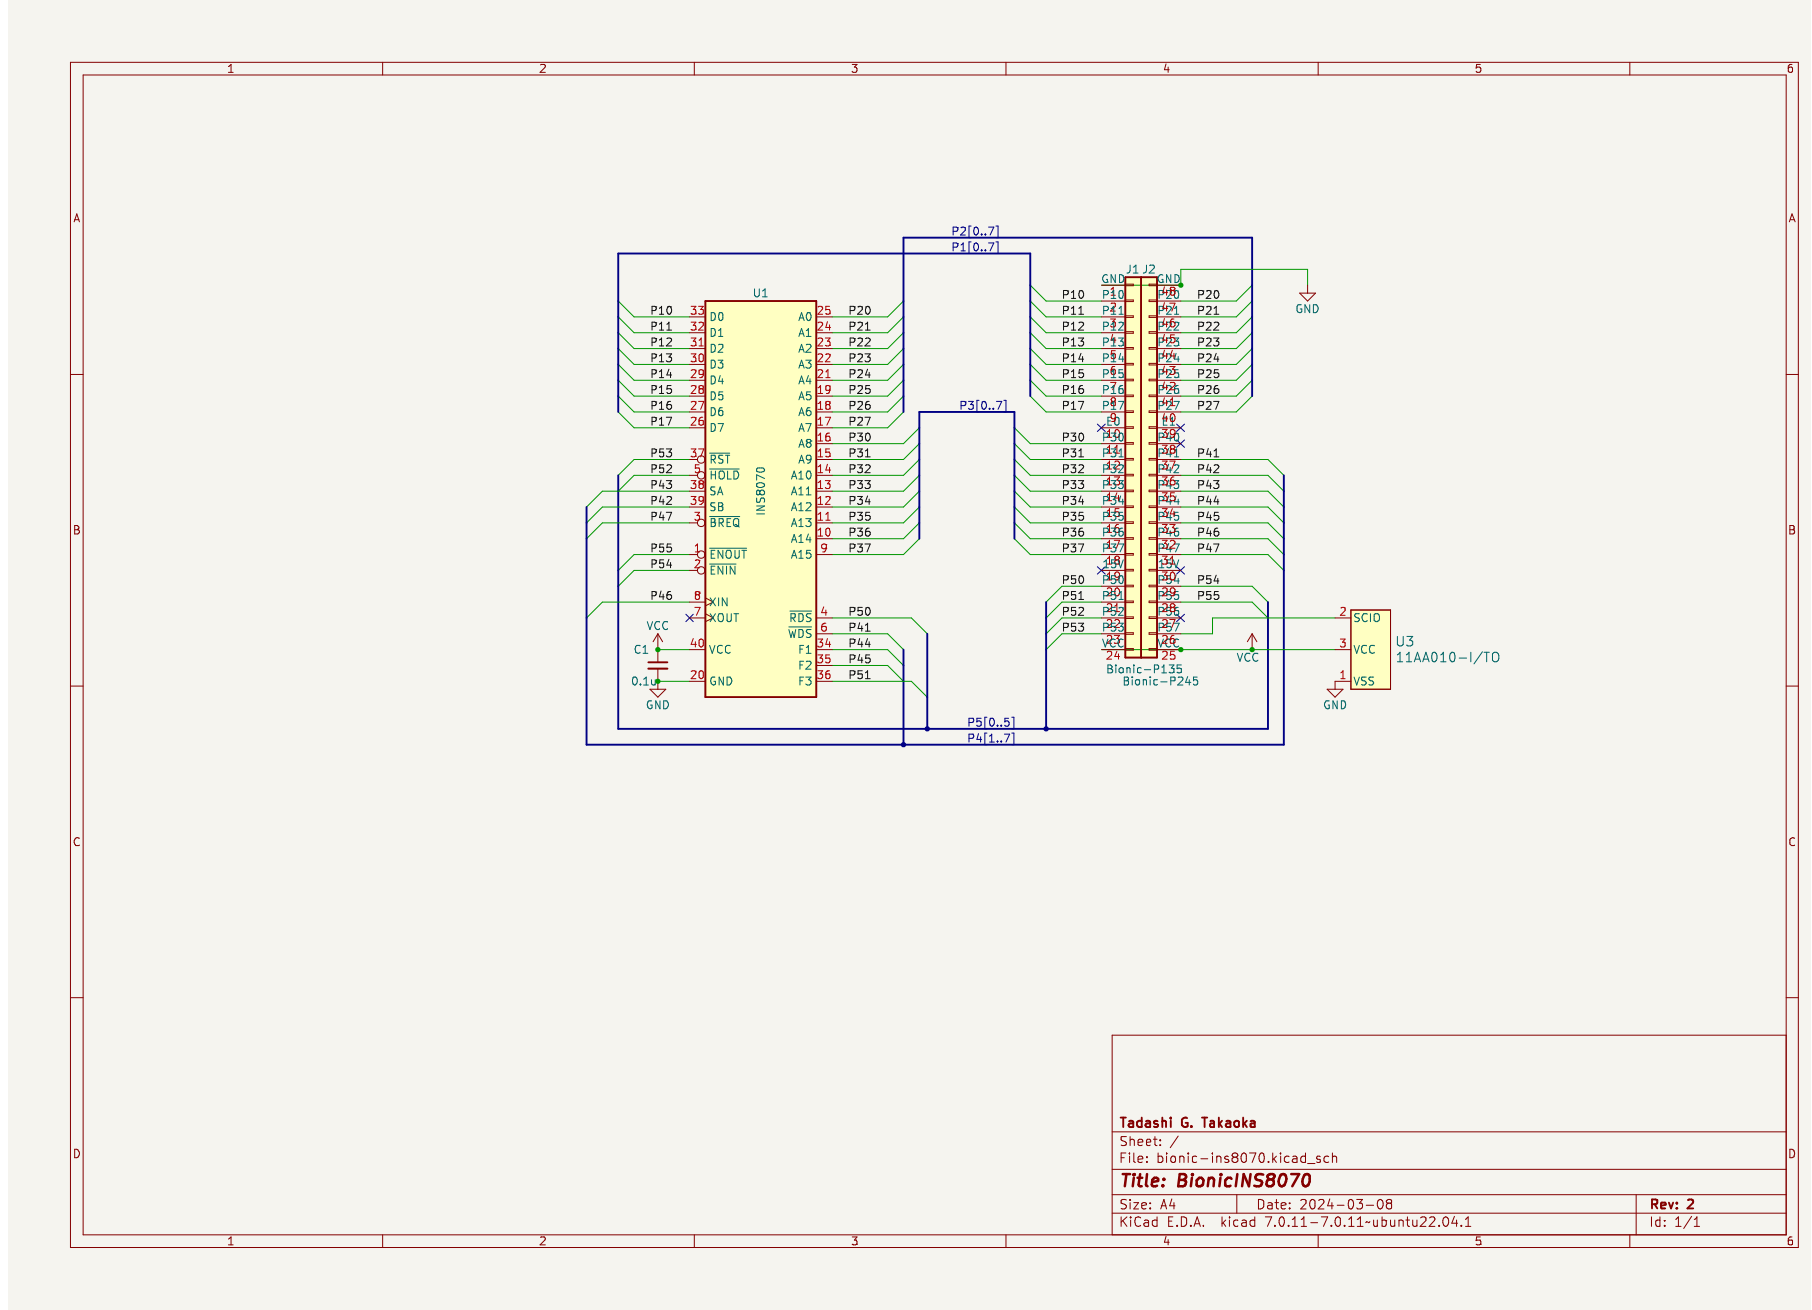
[picture p14: page 1]
