tgtakaoka/RetroCyborg/schematics/ins8060/bionic-ins8060.pdf

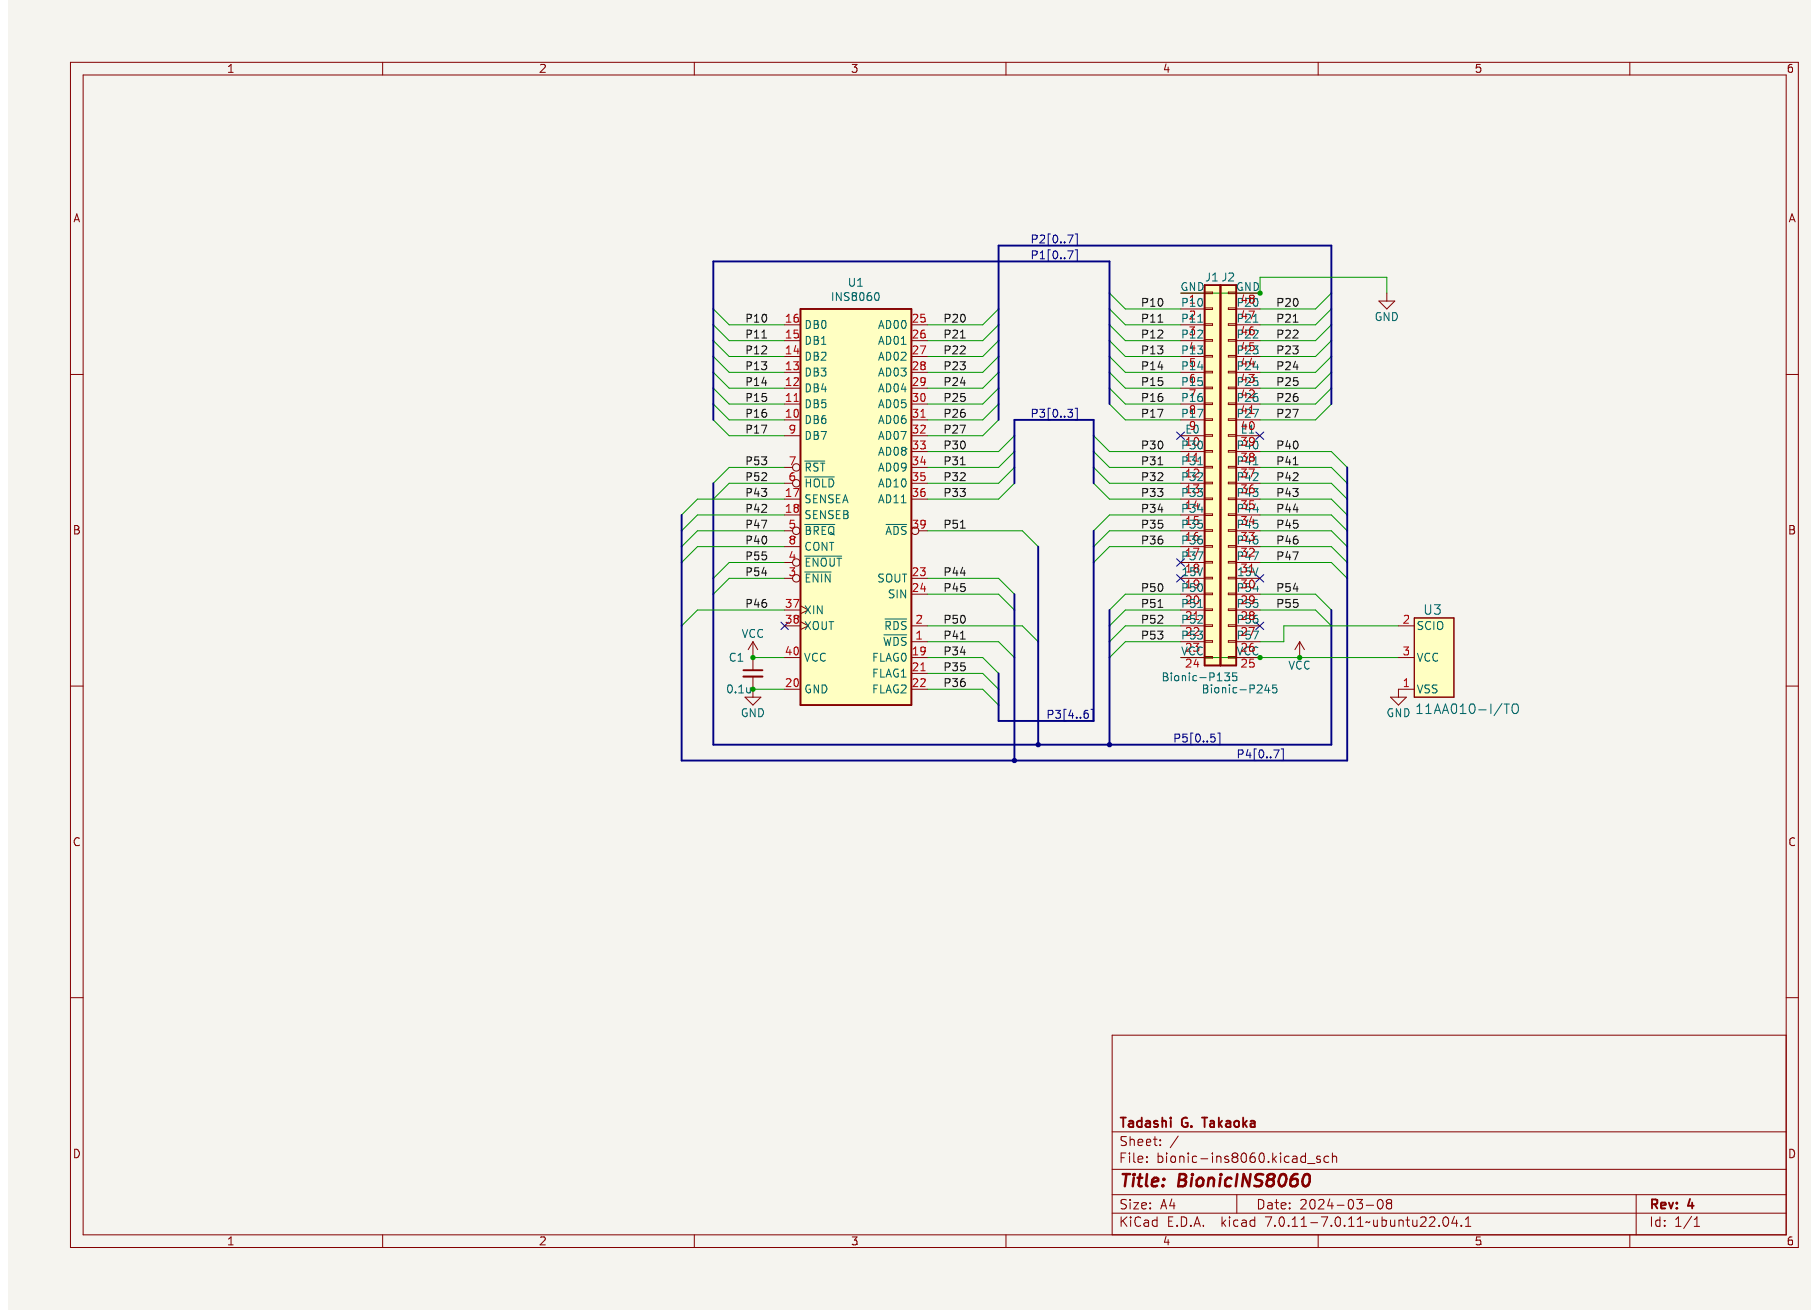
[picture p15: page 1]
