tgtakaoka/RetroCyborg/schematics/f3850/bionic-f3850.pdf

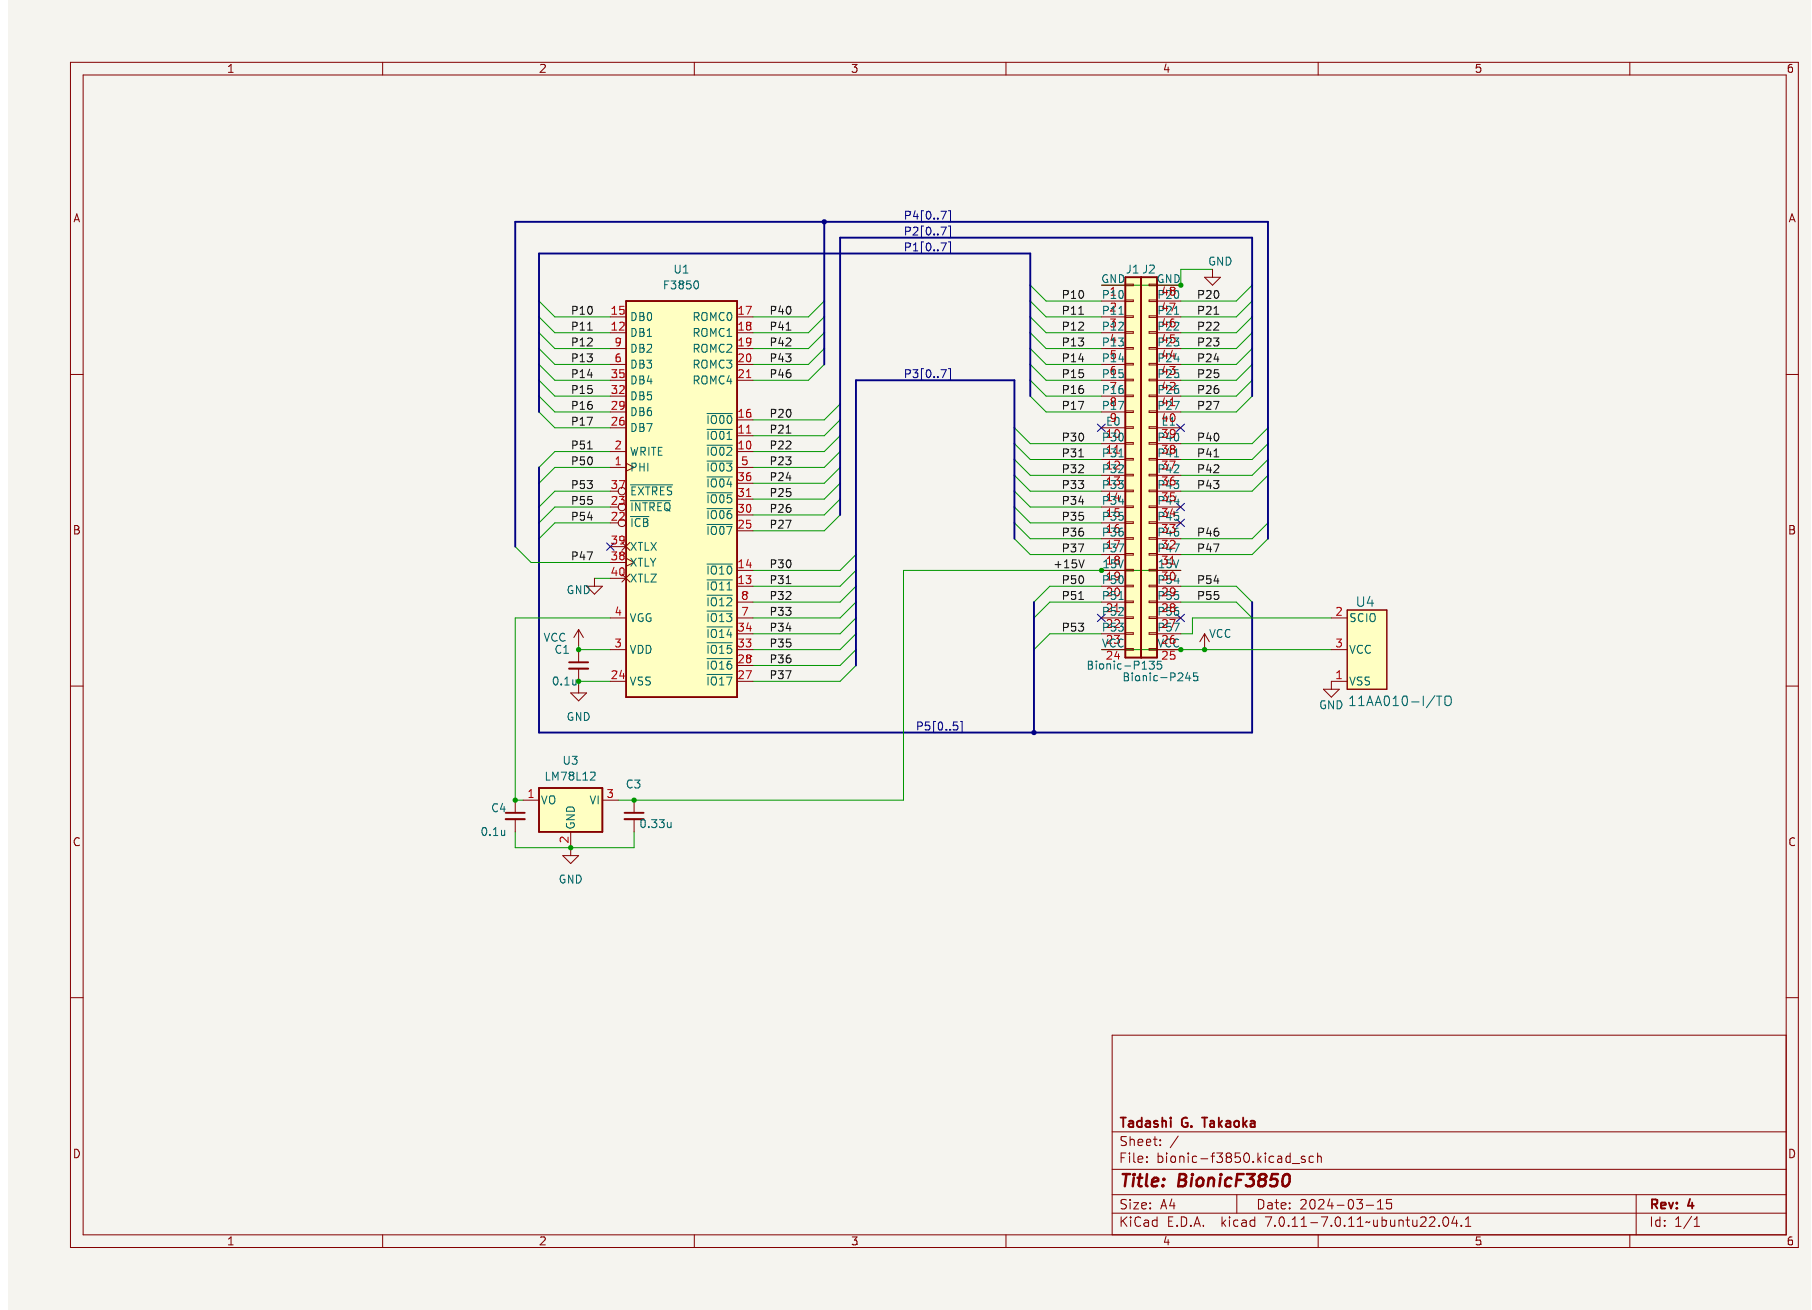
[picture p16: page 1]
