tgtakaoka/RetroCyborg/schematics/cdp1802/bionic-cdp1802.pdf

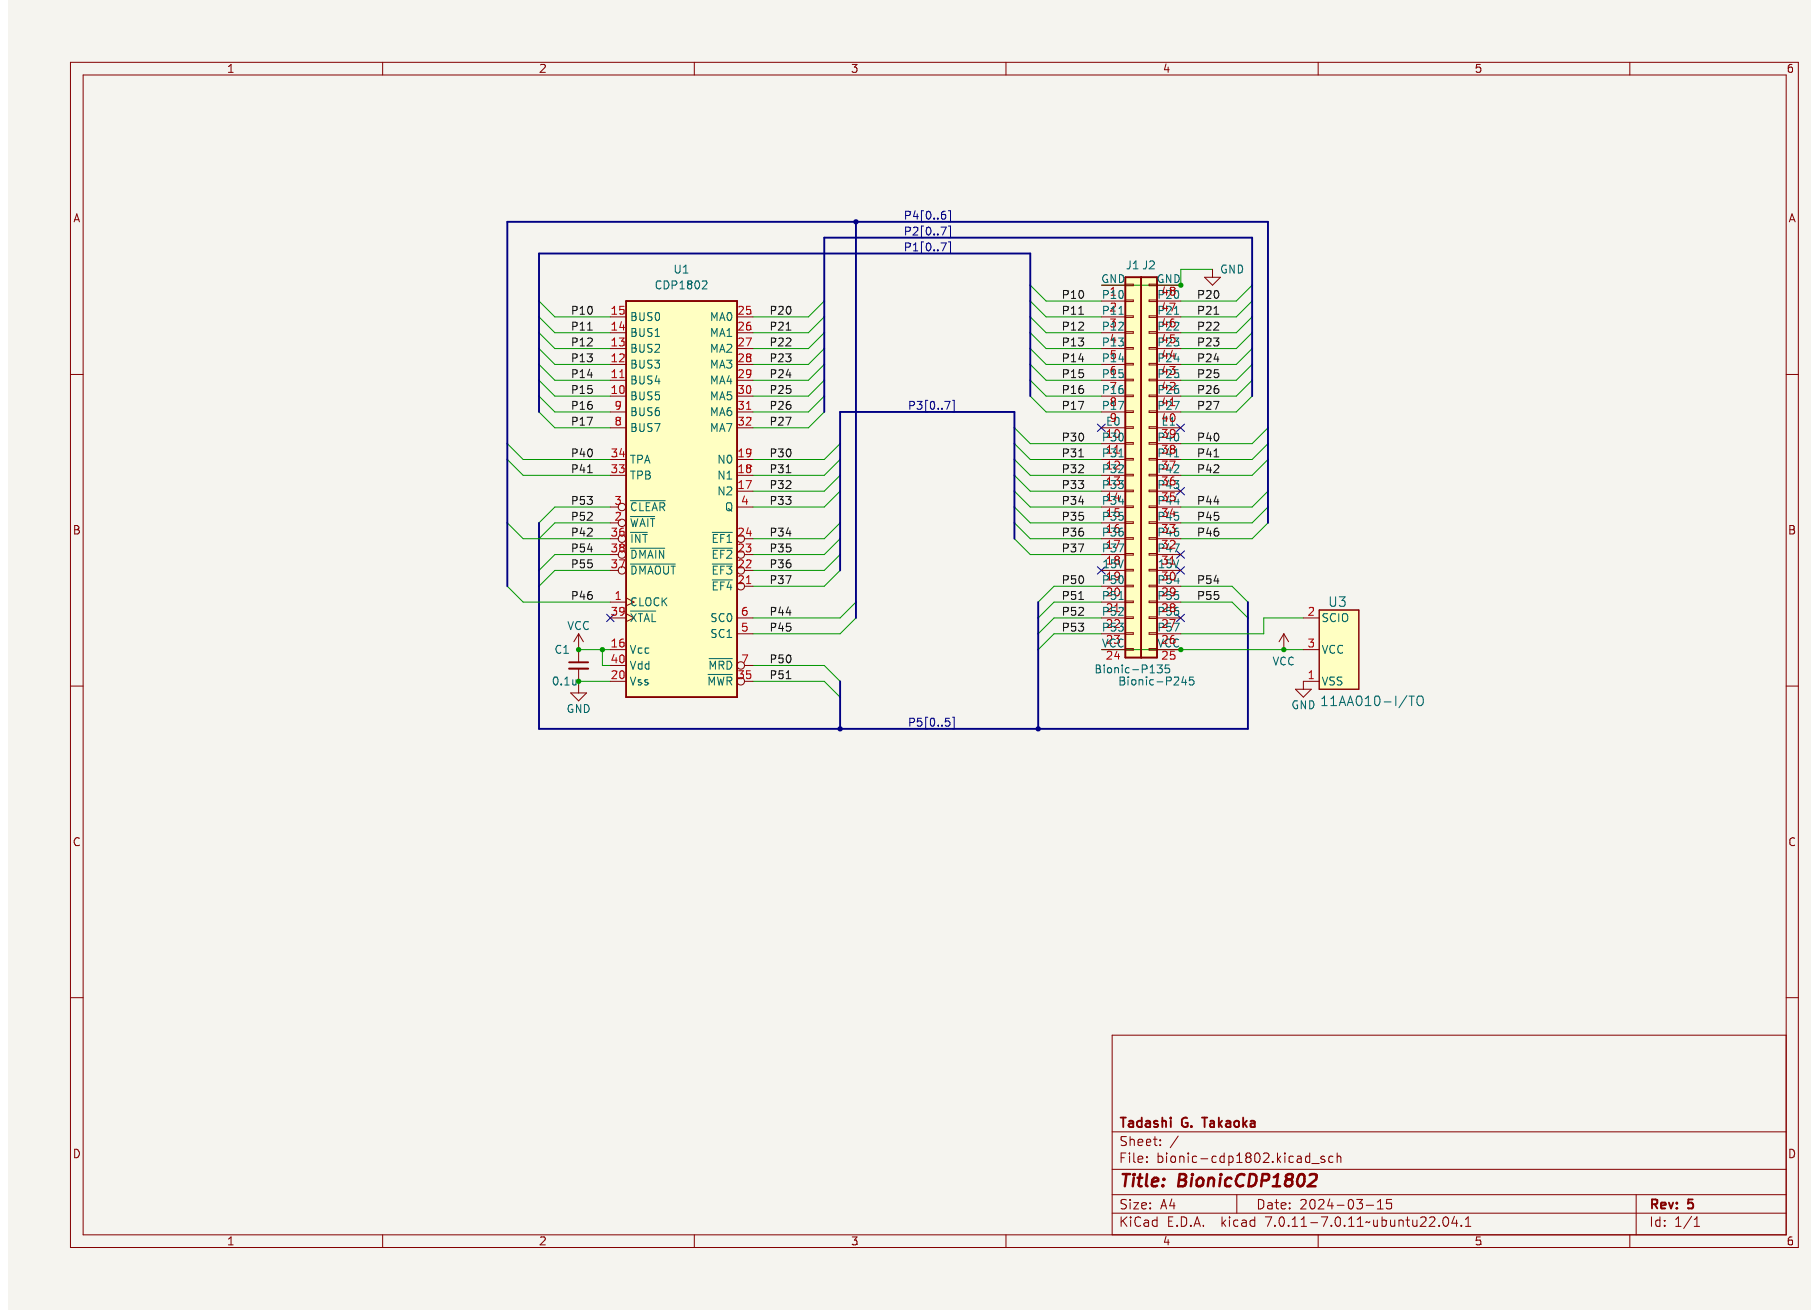
[picture p17: page 1]
