tgtakaoka/RetroCyborg/schematics/hd6120/bionic-hd6120.pdf

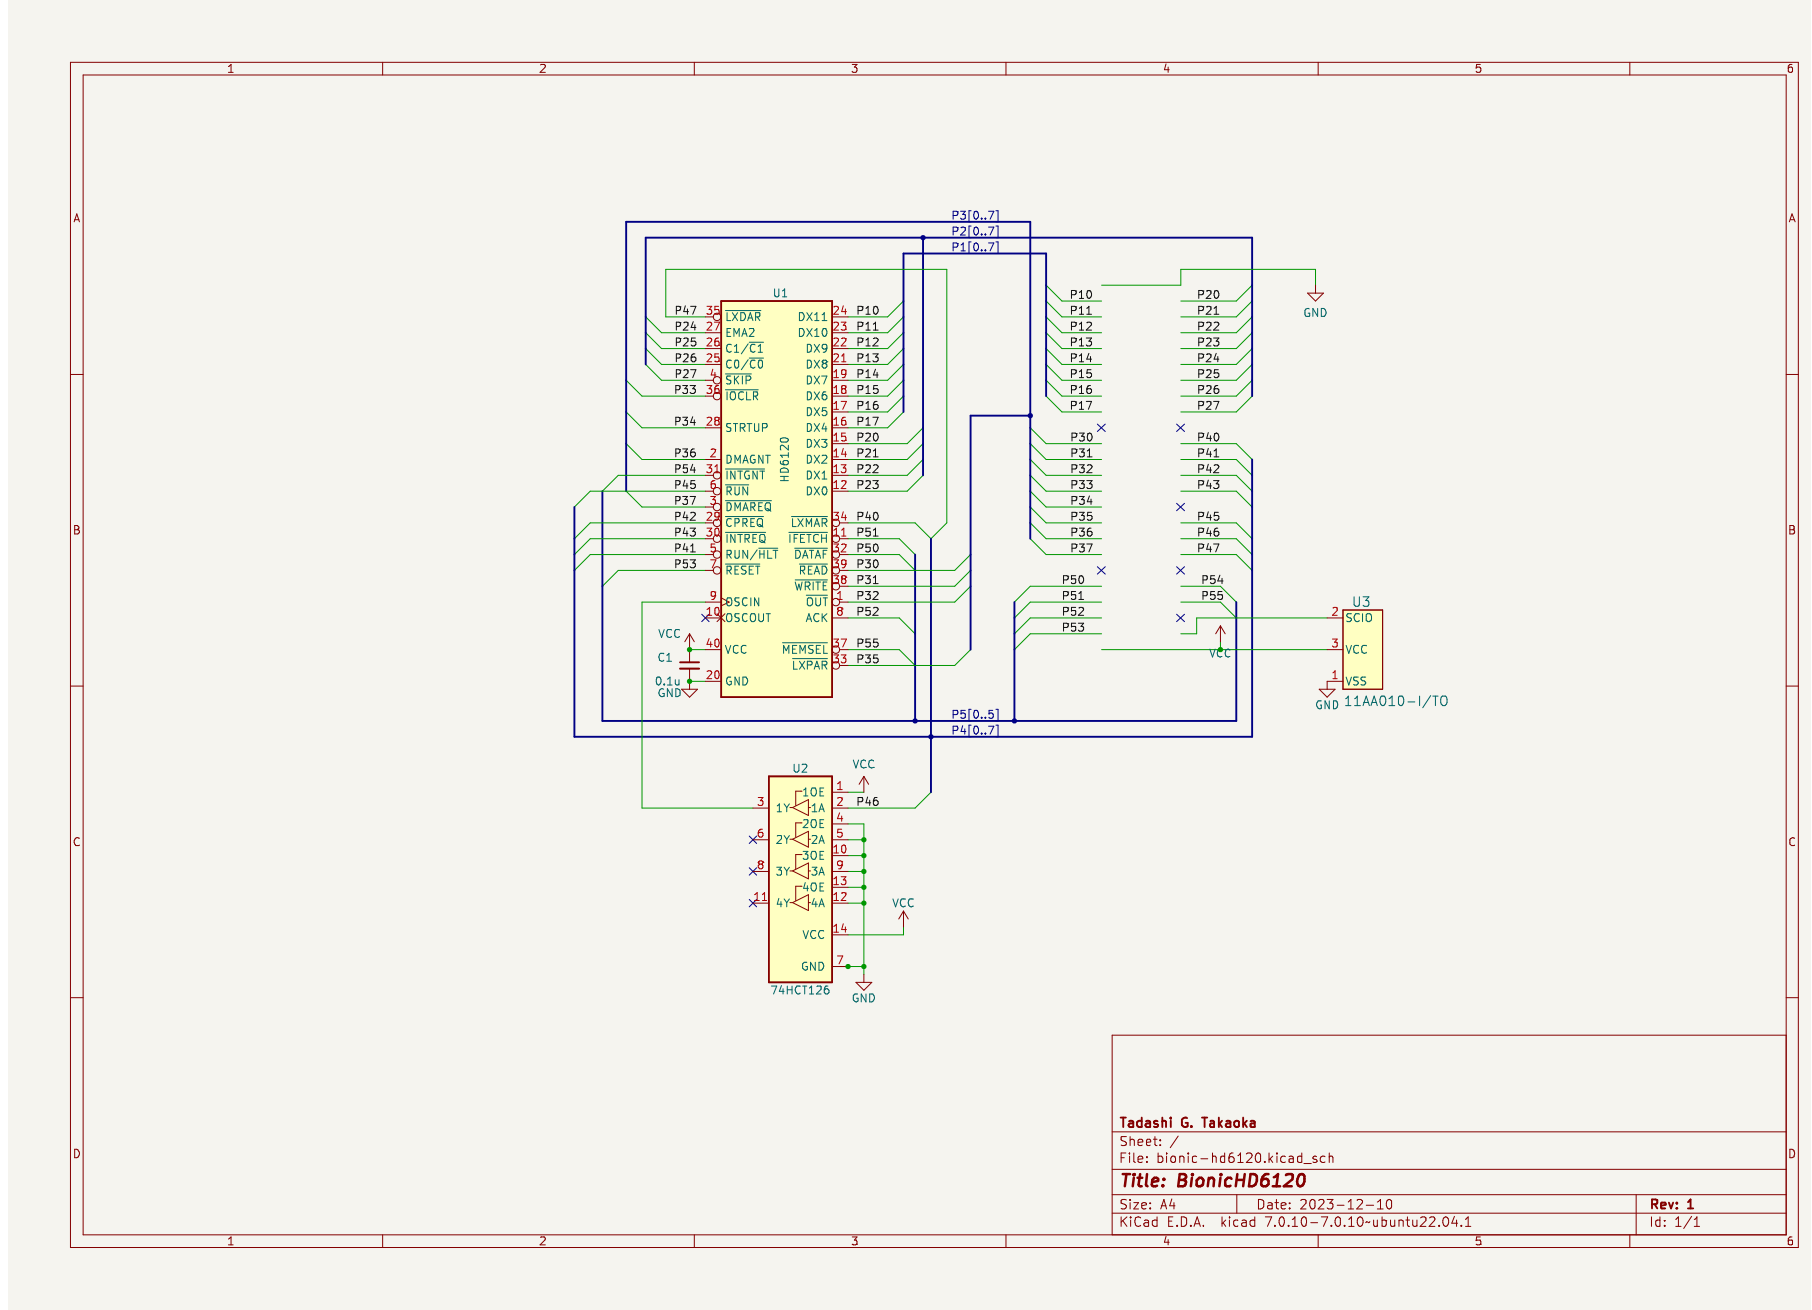
[picture p18: page 1]
