tgtakaoka/RetroCyborg/schematics/im6100/bionic-im6100.pdf

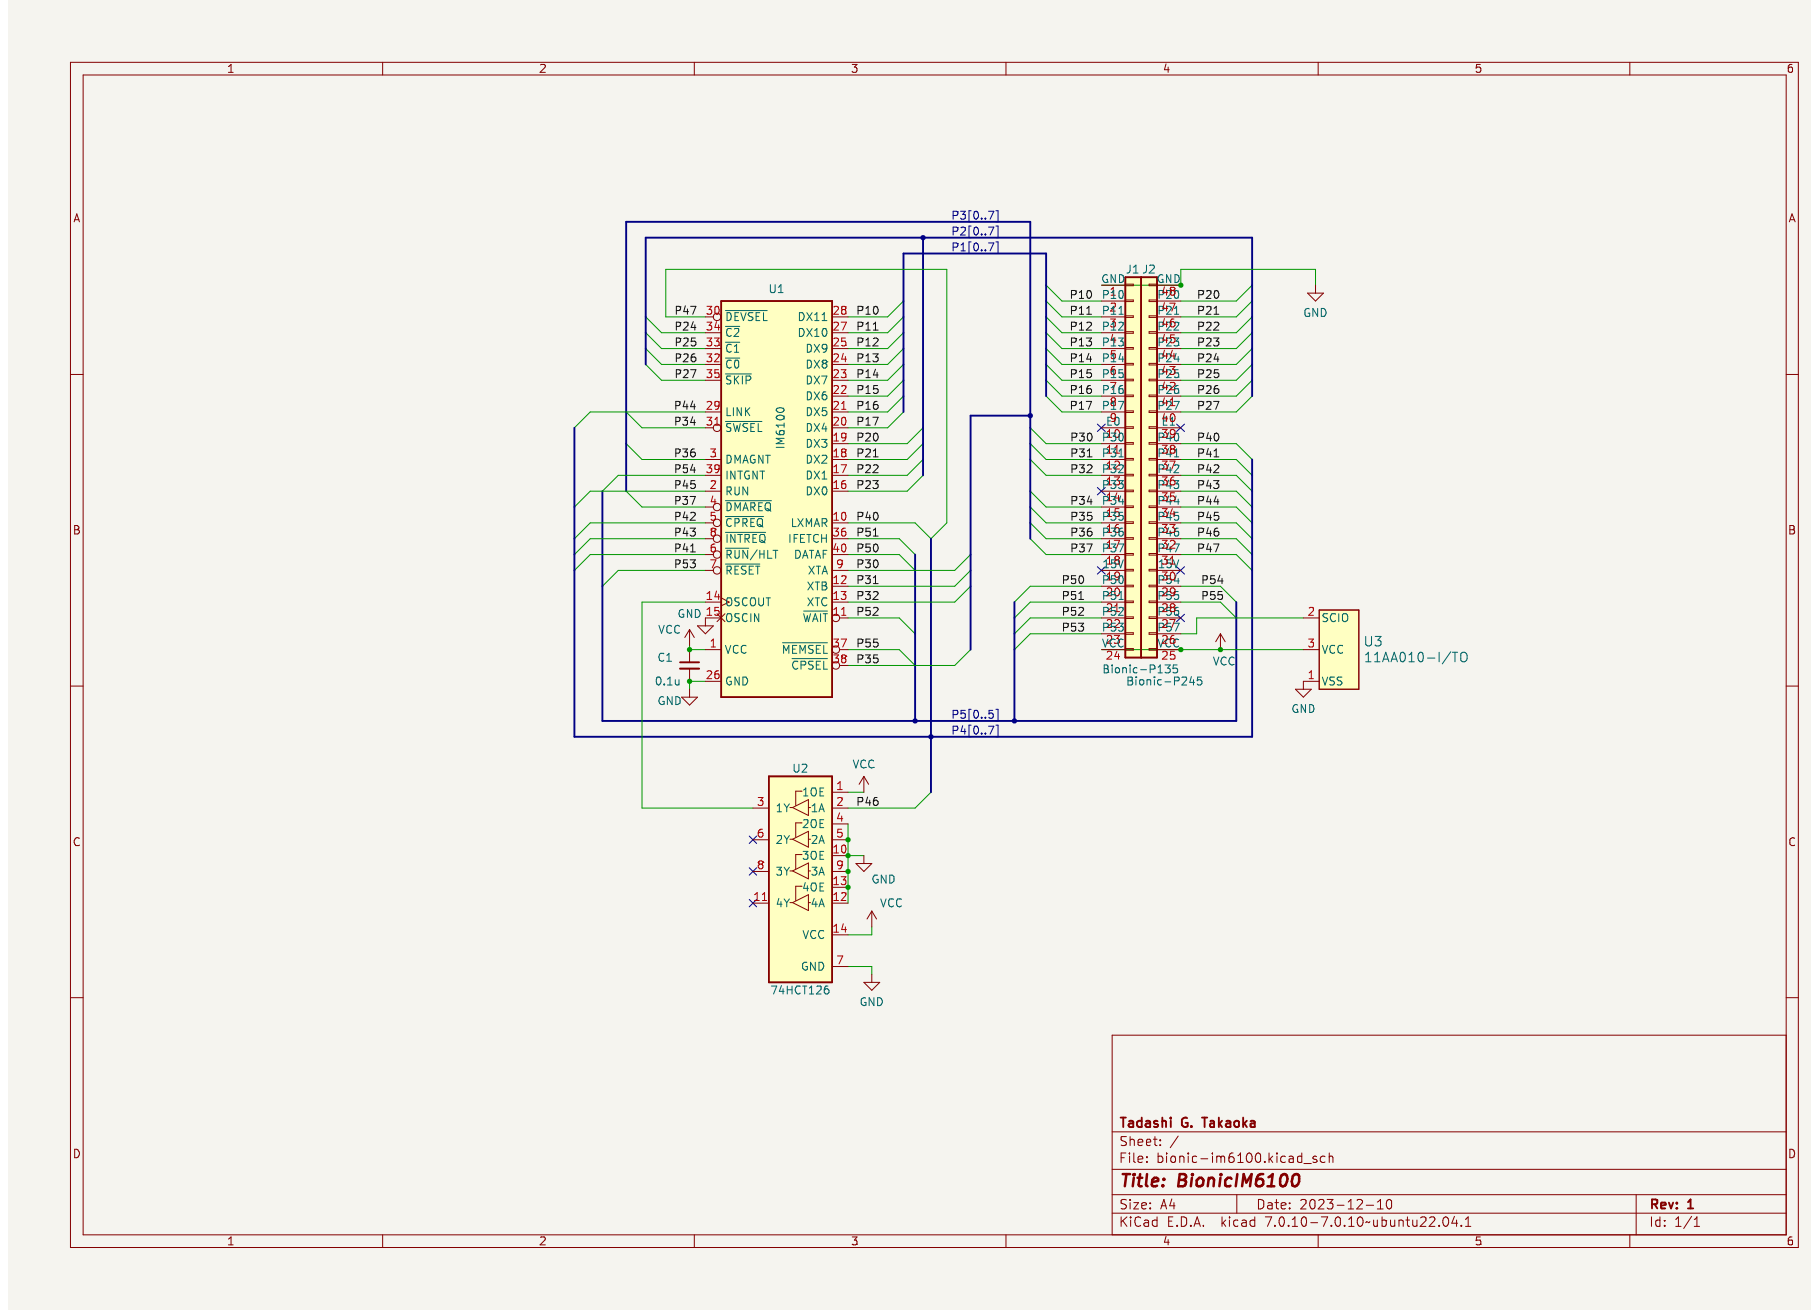
[picture p19: page 1]
