tgtakaoka/RetroCyborg/schematics/mc68008/bionic-mc68008.pdf

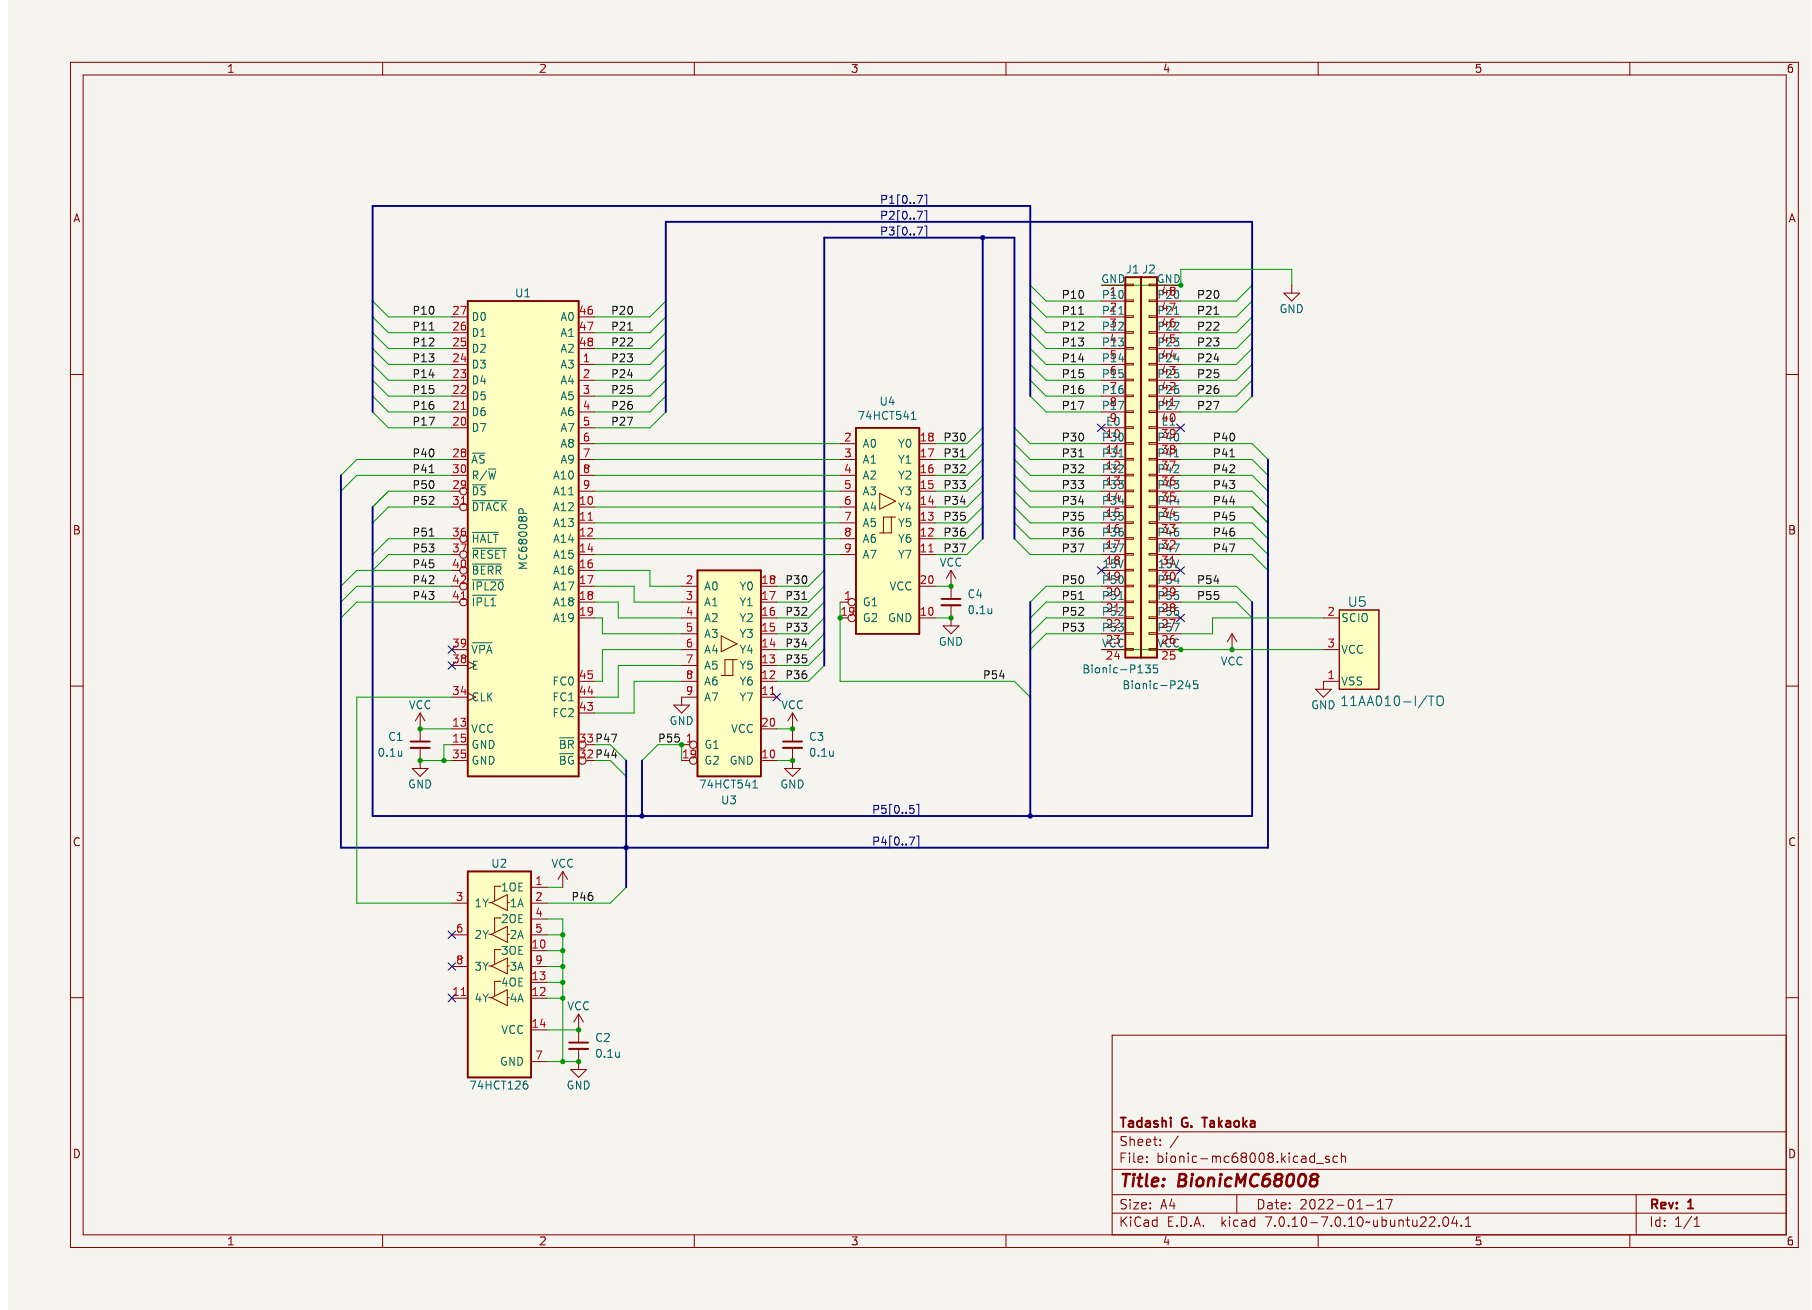
[picture p20: page 1]
