tgtakaoka/RetroCyborg/schematics/mn1613/bionic-mn1613.pdf

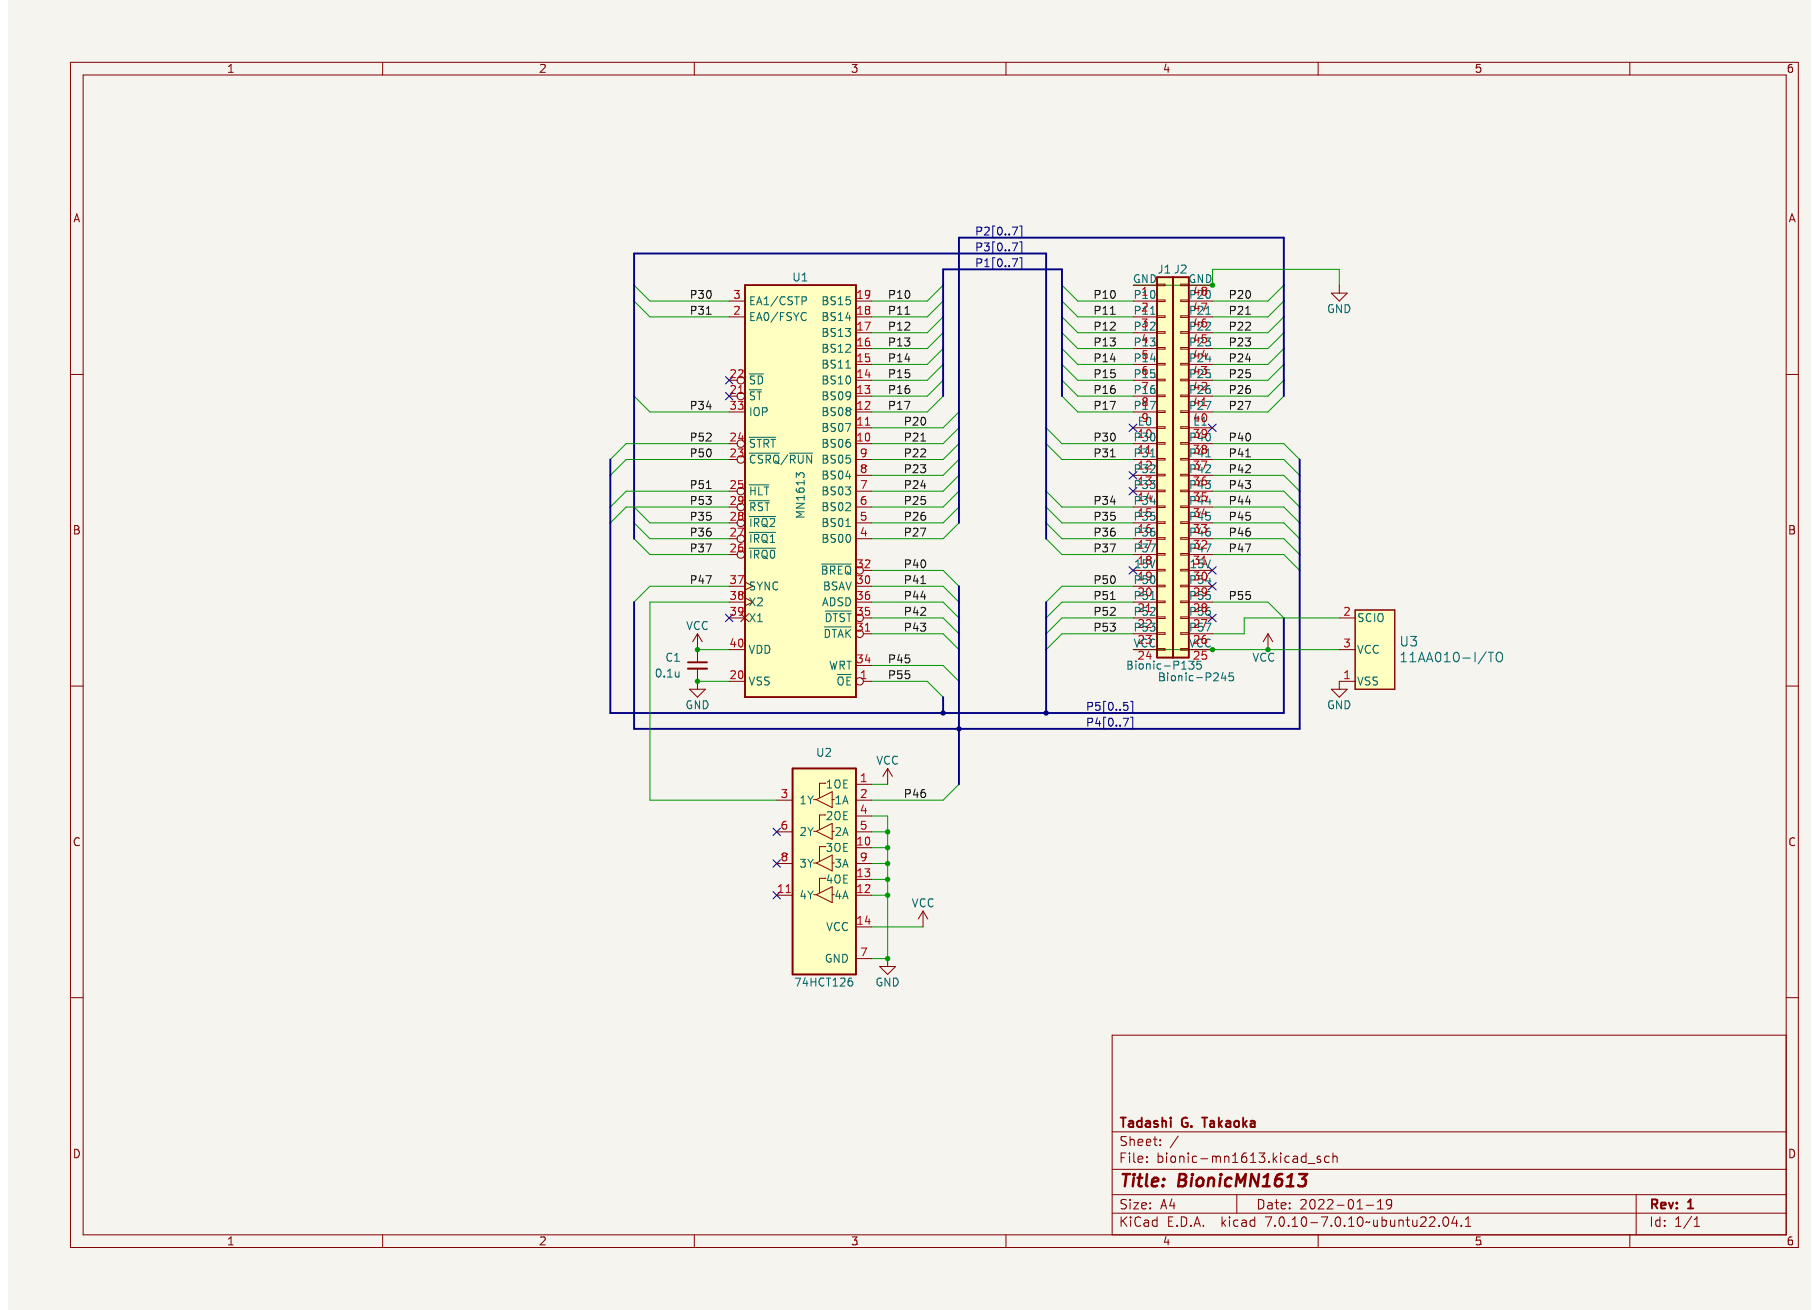
[picture p21: page 1]
