tgtakaoka/RetroCyborg/schematics/mn1613/bionic-mn1613a.pdf

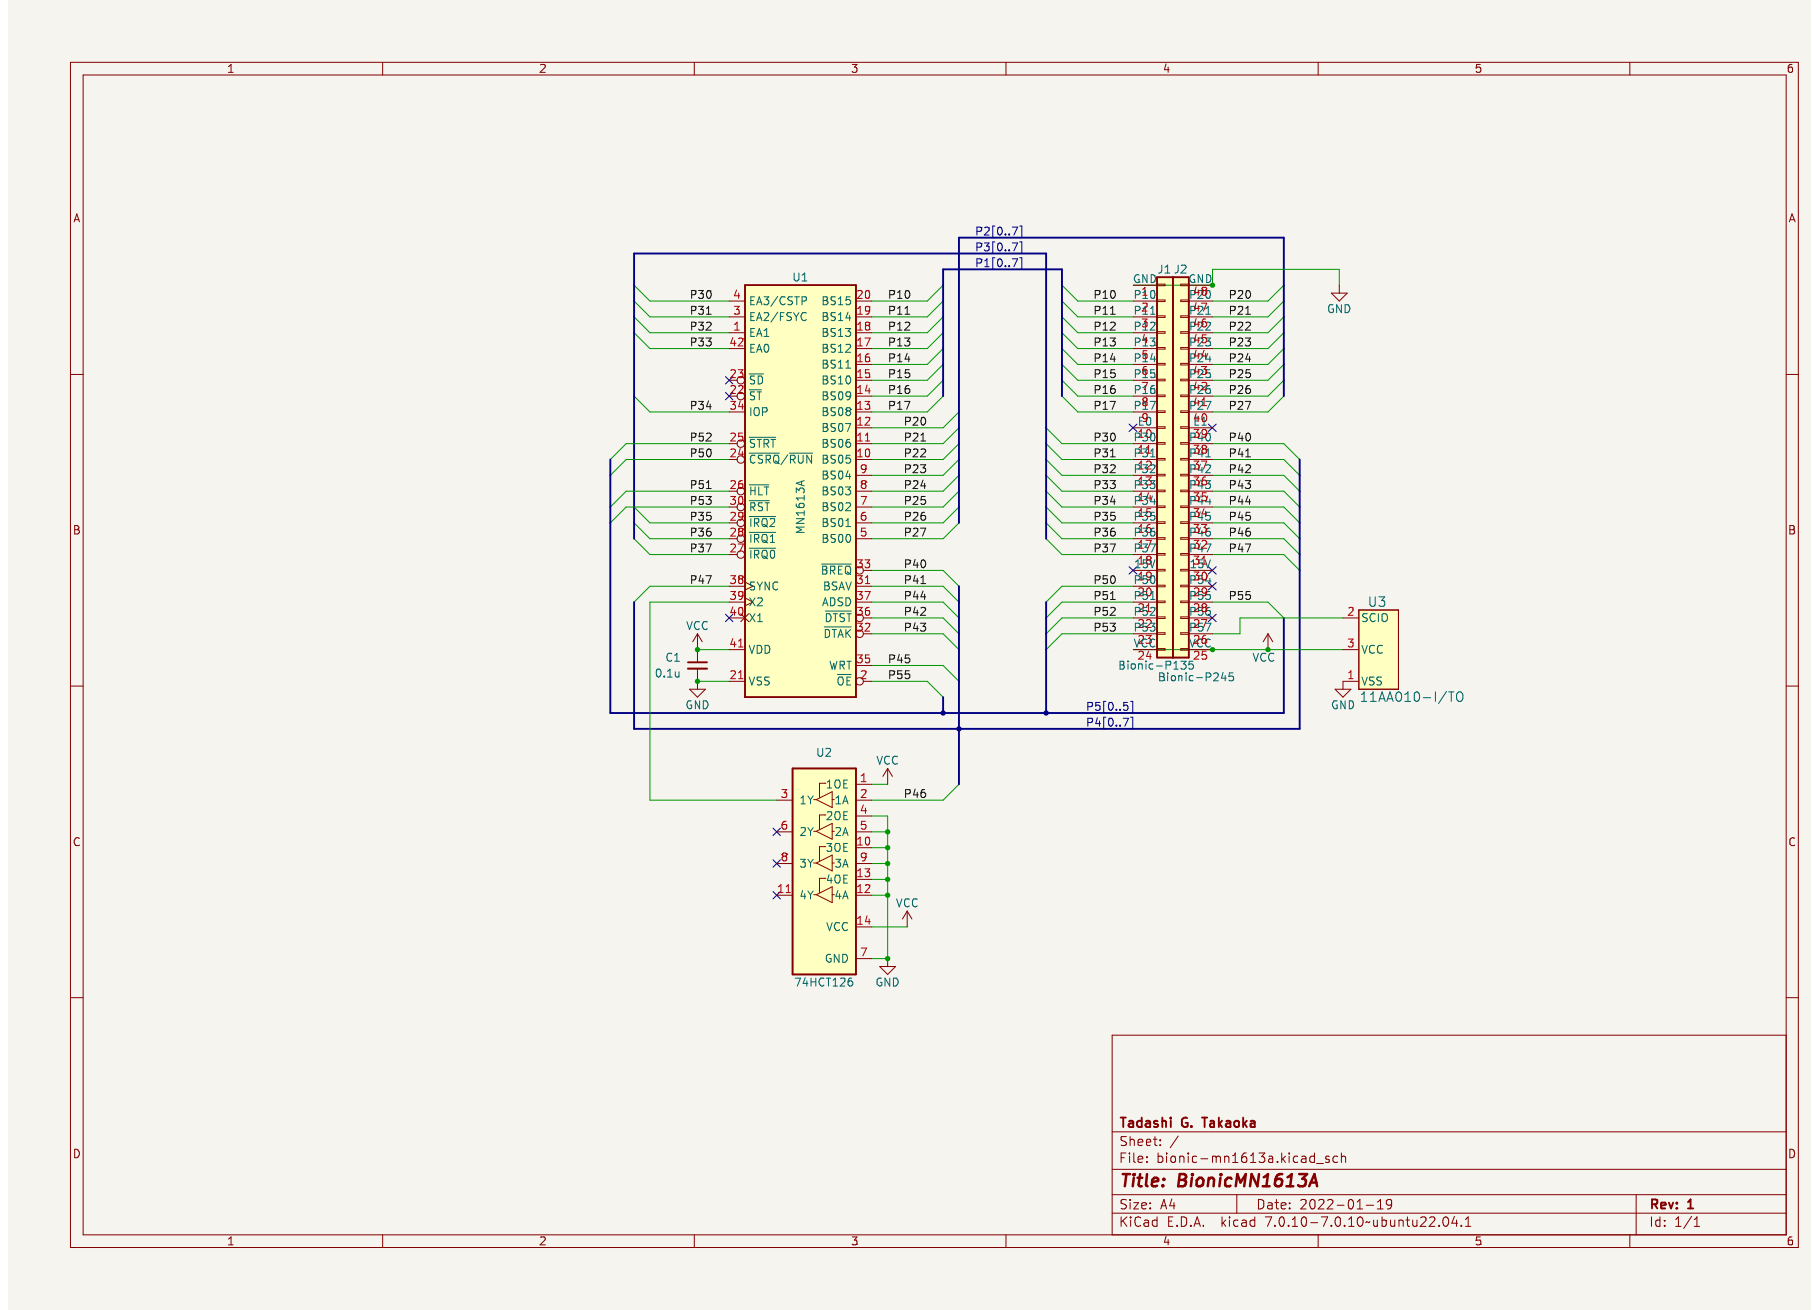
[picture p22: page 1]
