tgtakaoka/RetroCyborg/schematics/ns32016/bionic-ns32016.pdf

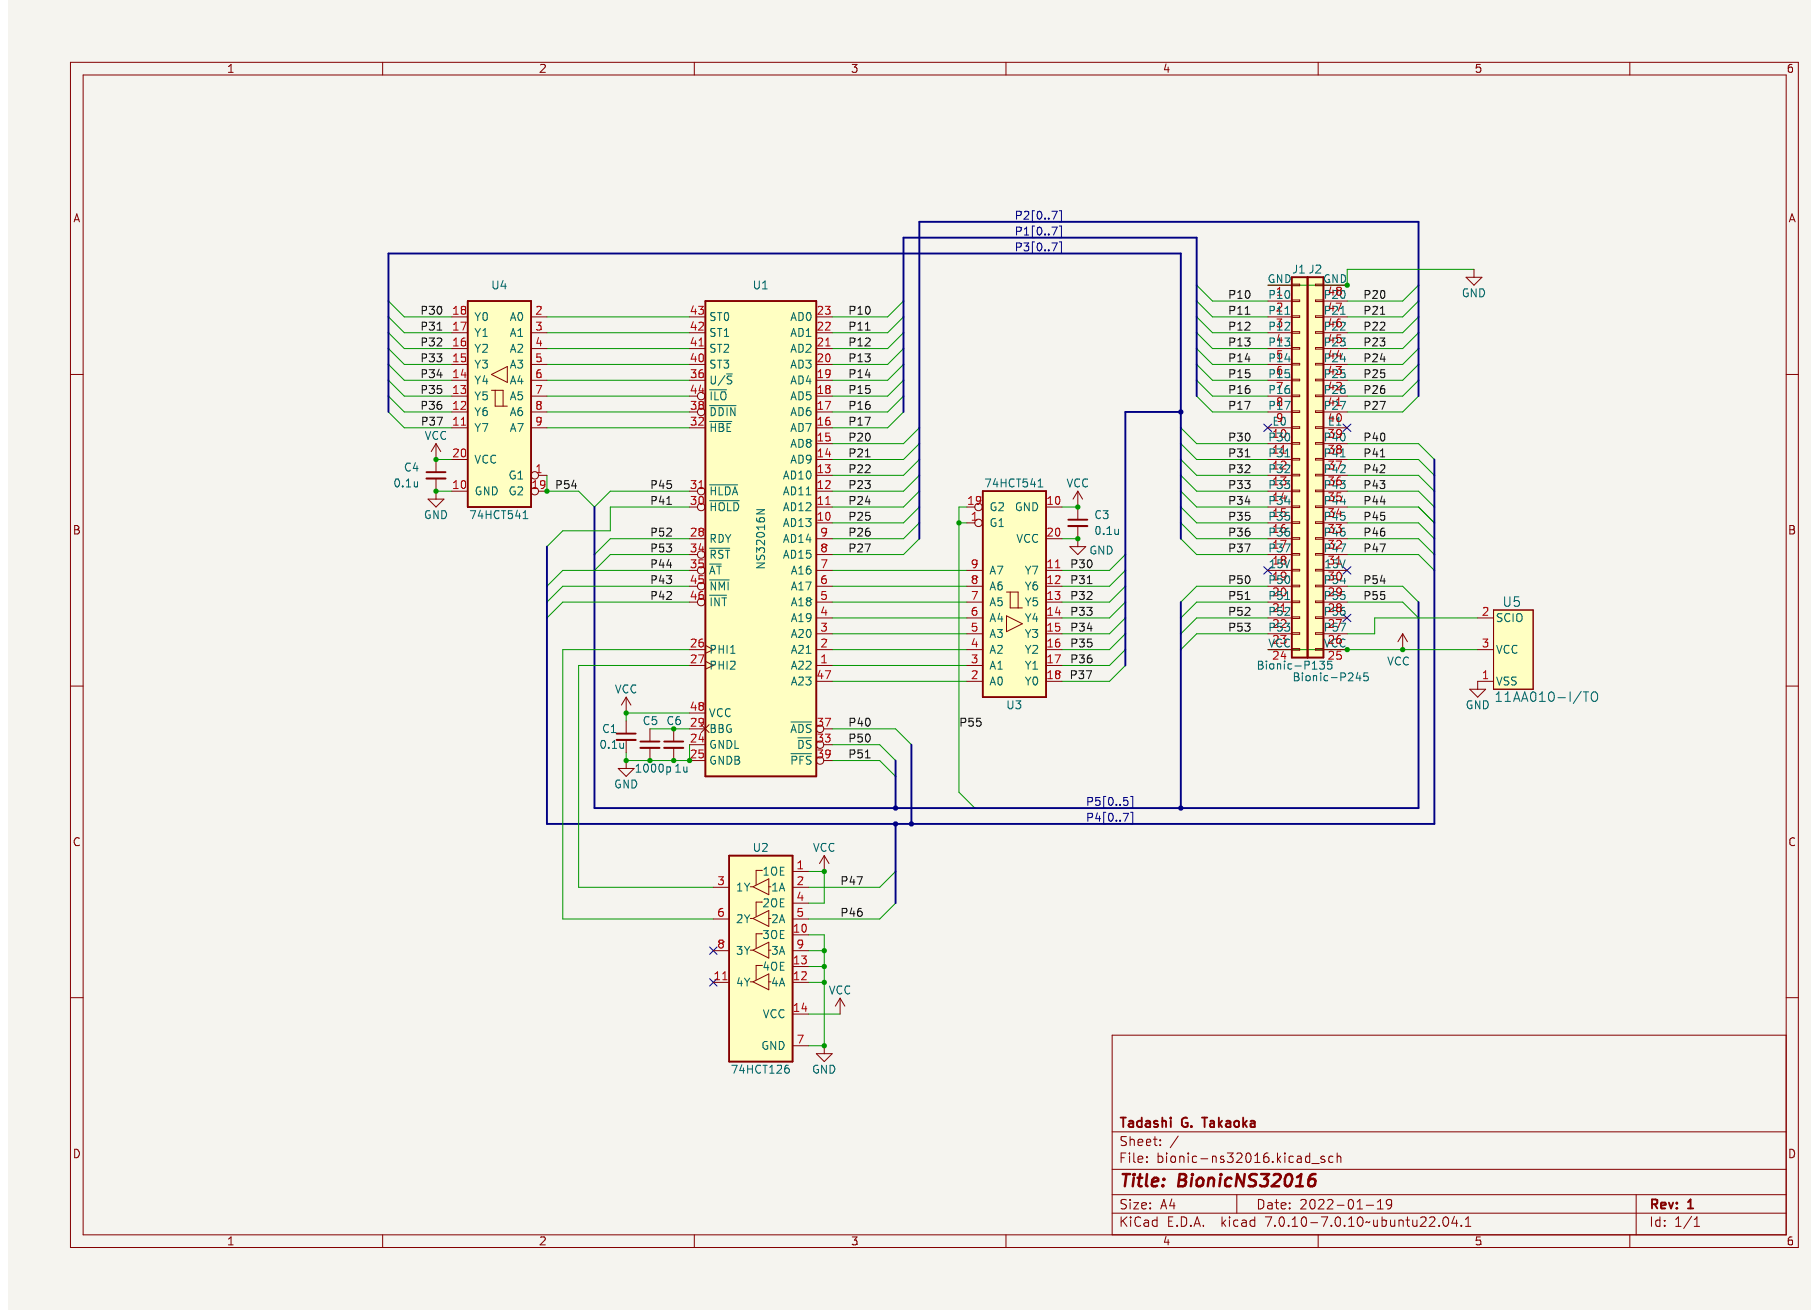
[picture p23: page 1]
