tgtakaoka/RetroCyborg/schematics/nsc800/bionic-nsc800.pdf

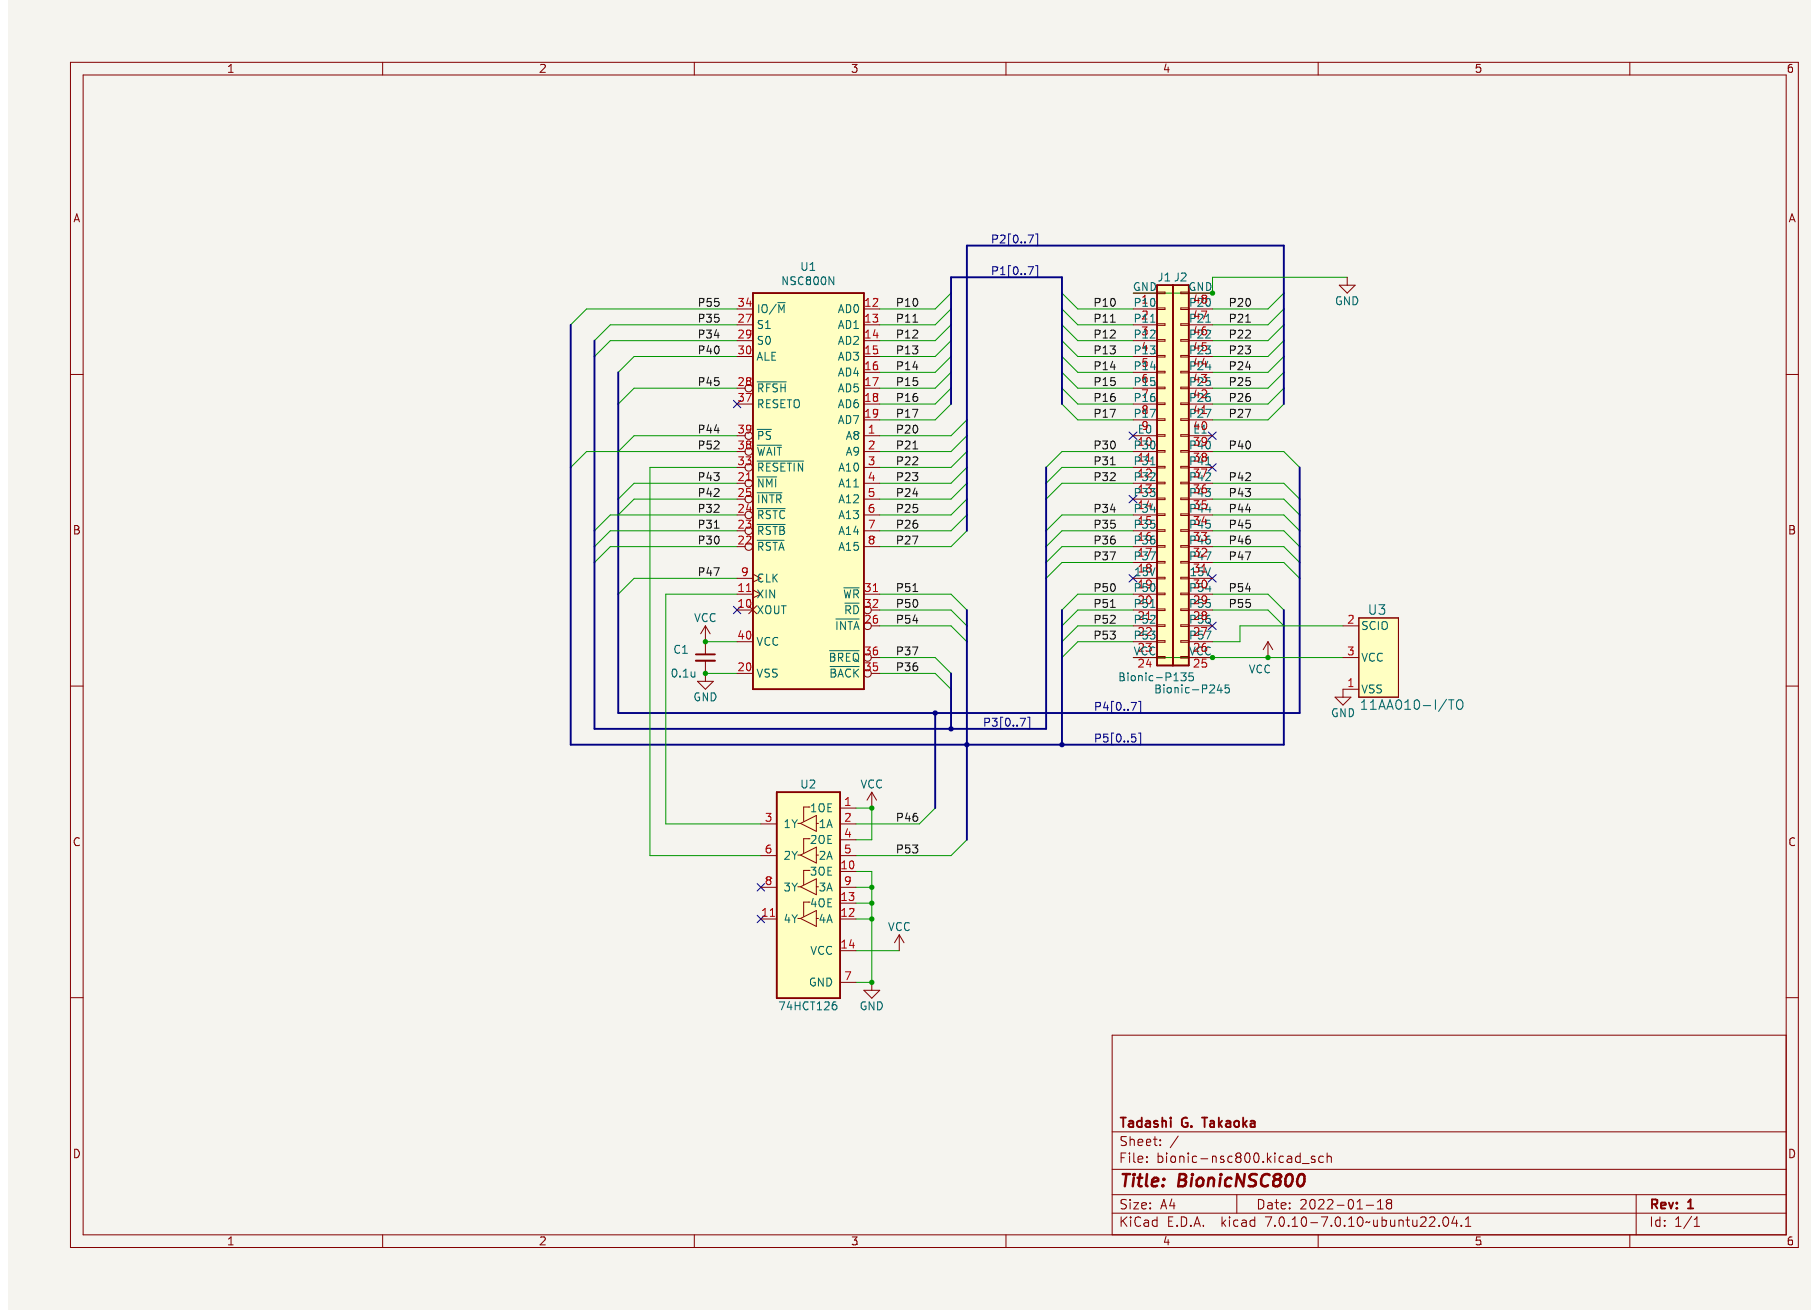
[picture p24: page 1]
