tgtakaoka/RetroCyborg/schematics/p8048/bionic-p8048.pdf

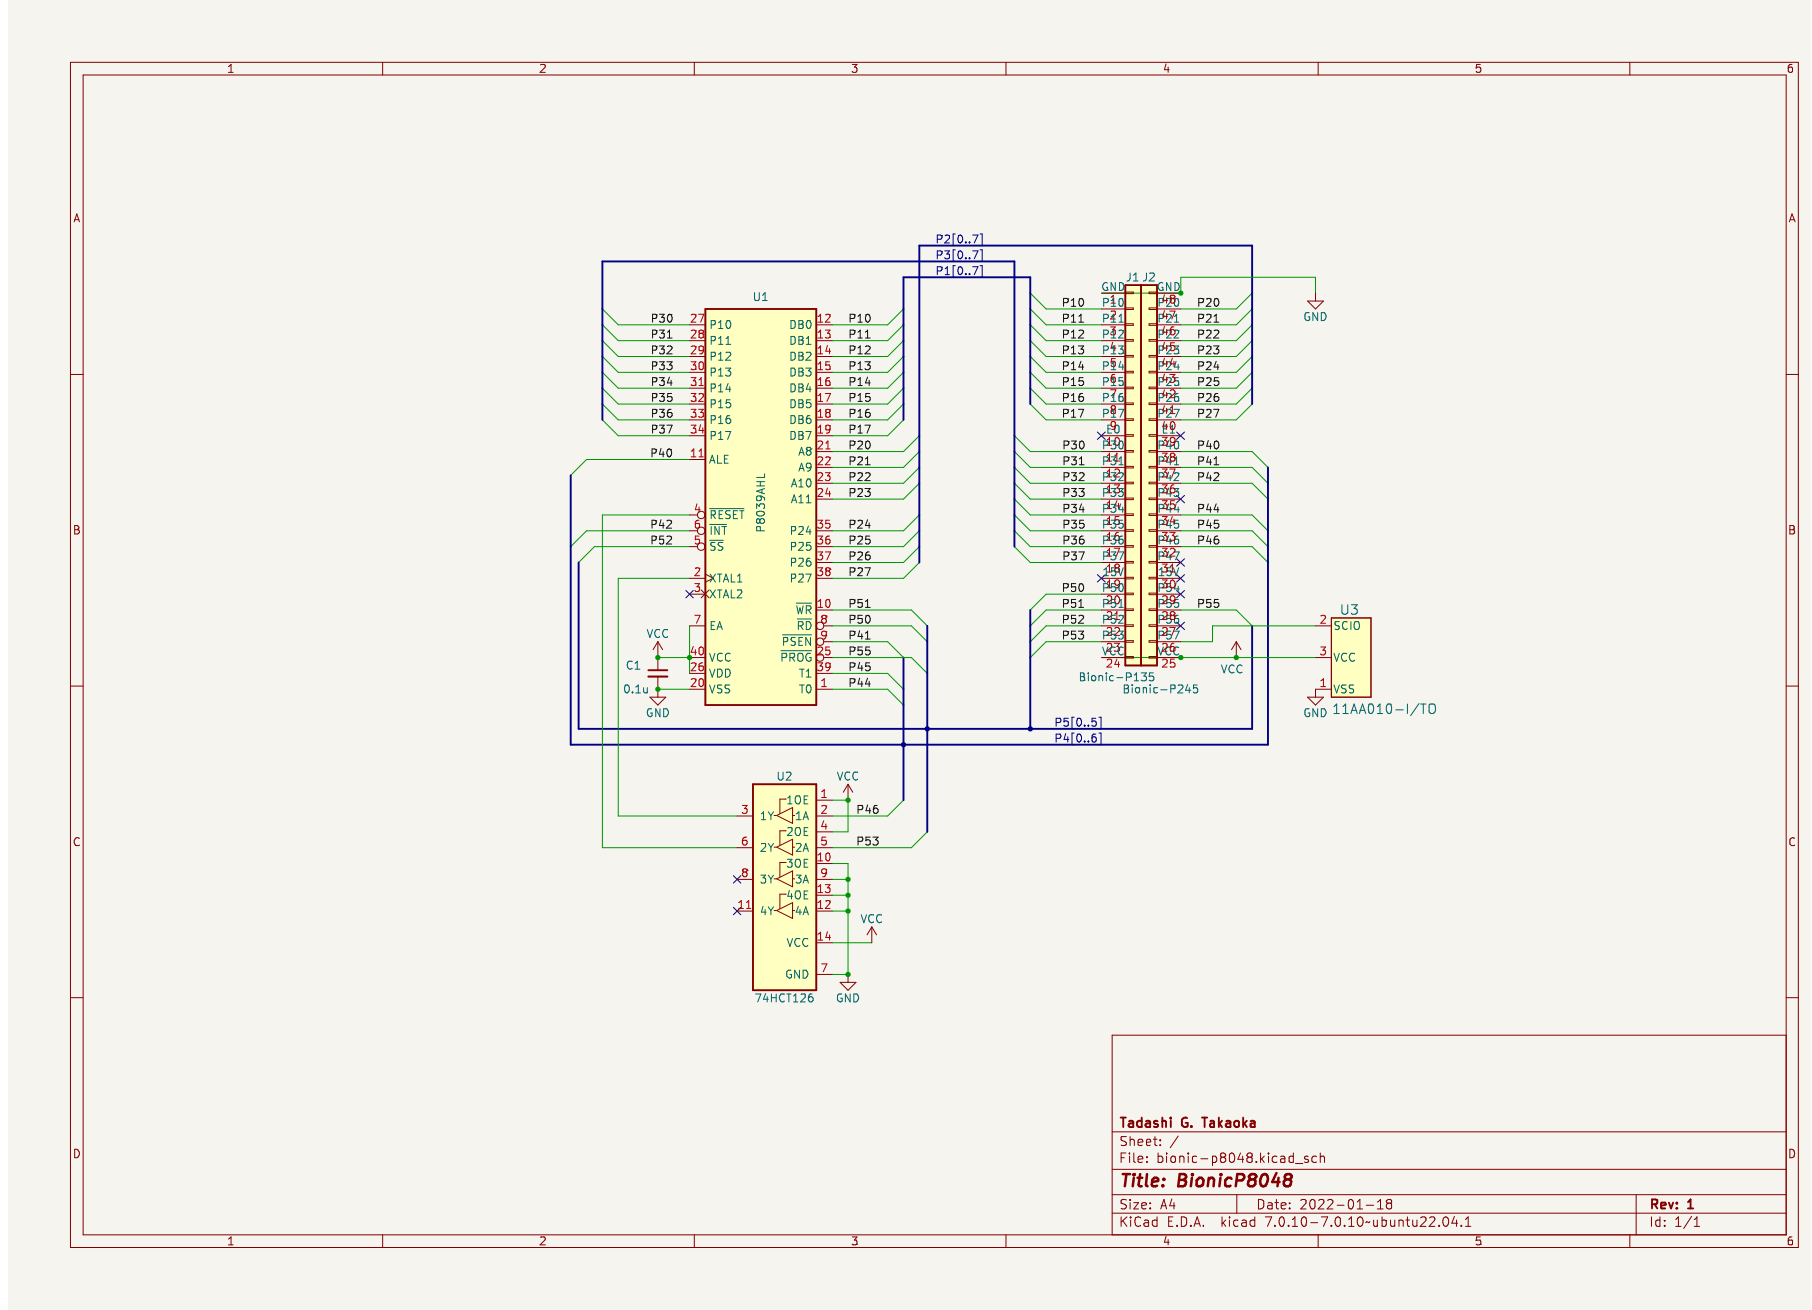
[picture p25: page 1]
