tgtakaoka/RetroCyborg/schematics/p8051/bionic-p8051.pdf

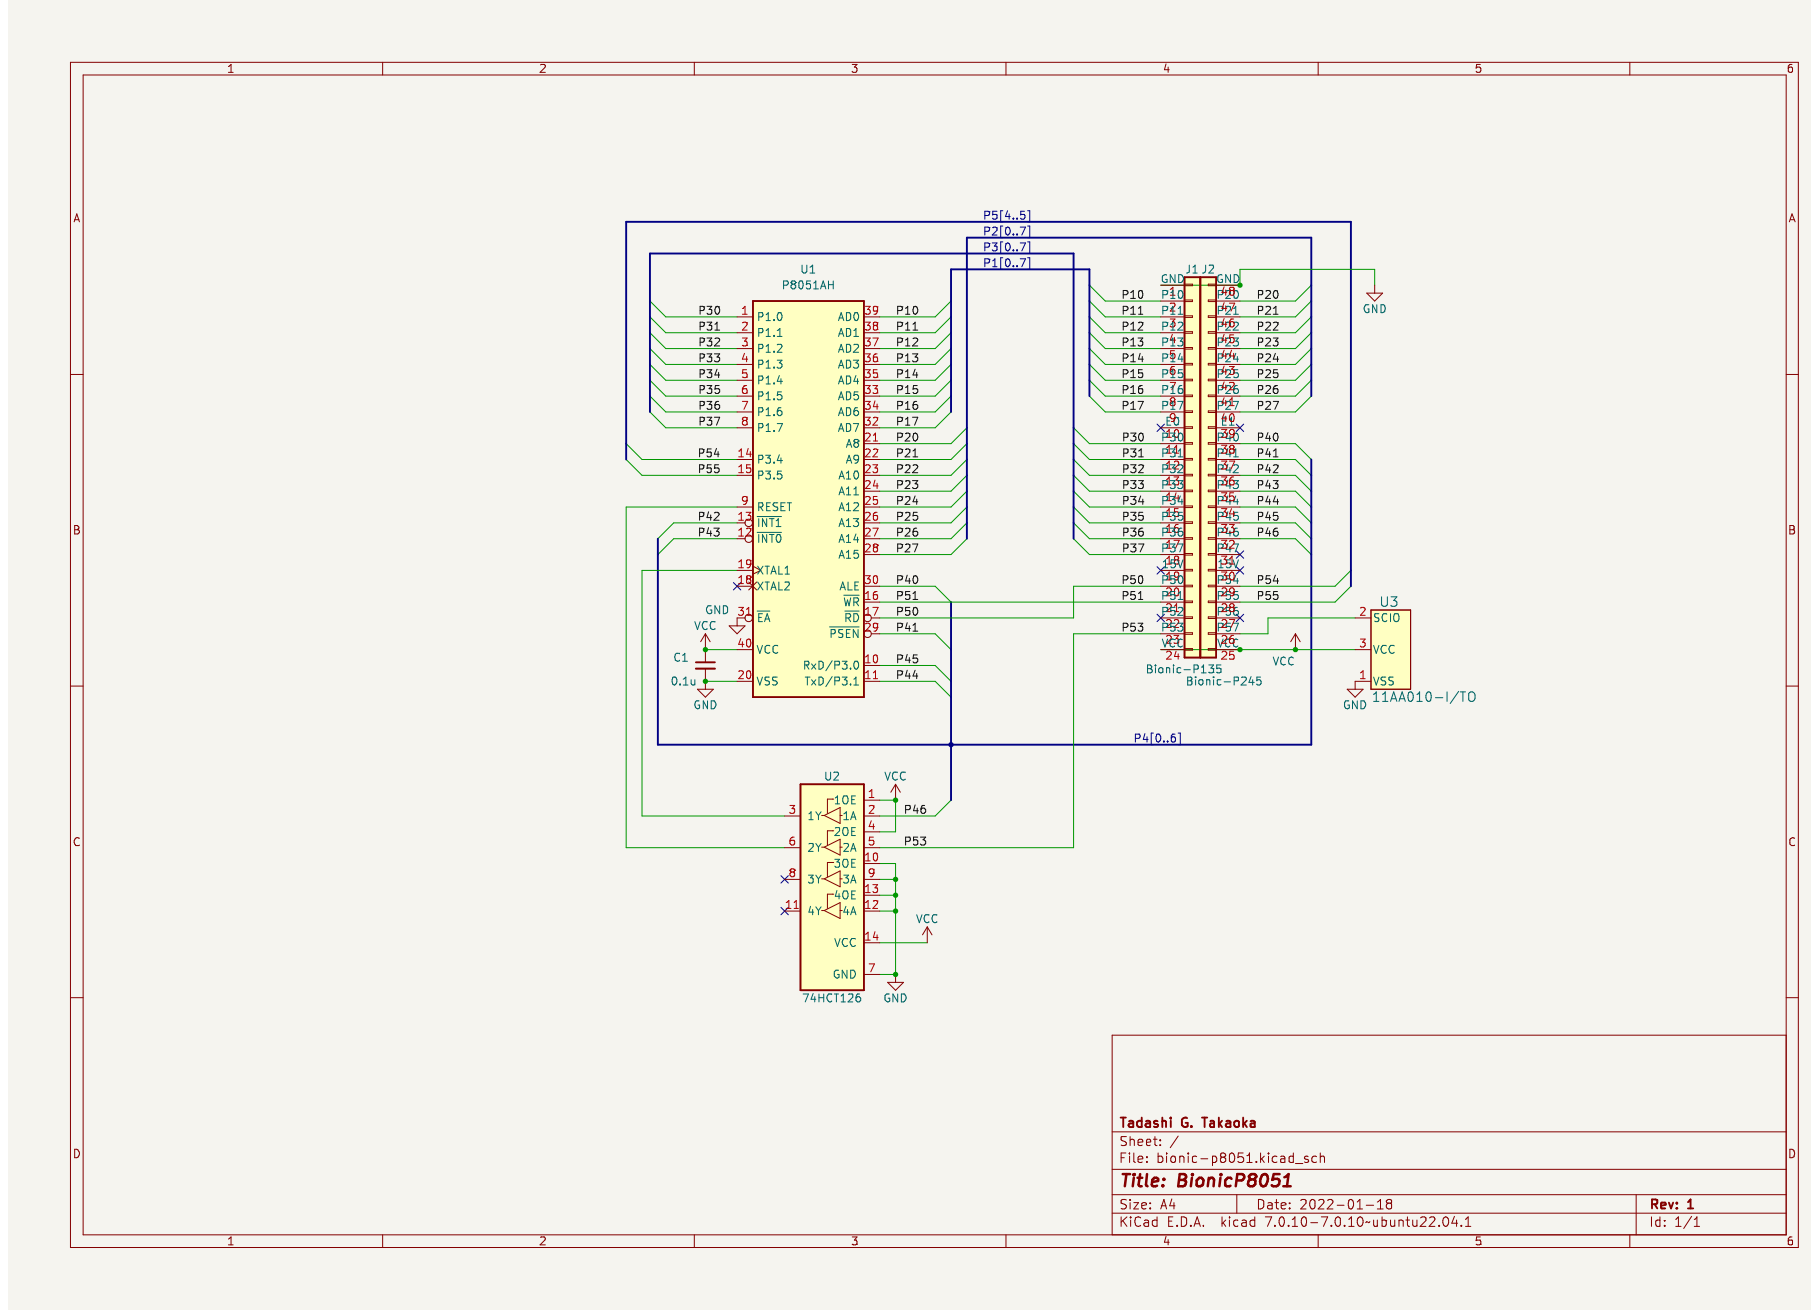
[picture p26: page 1]
