tgtakaoka/RetroCyborg/schematics/p8086/bionic-p8086.pdf

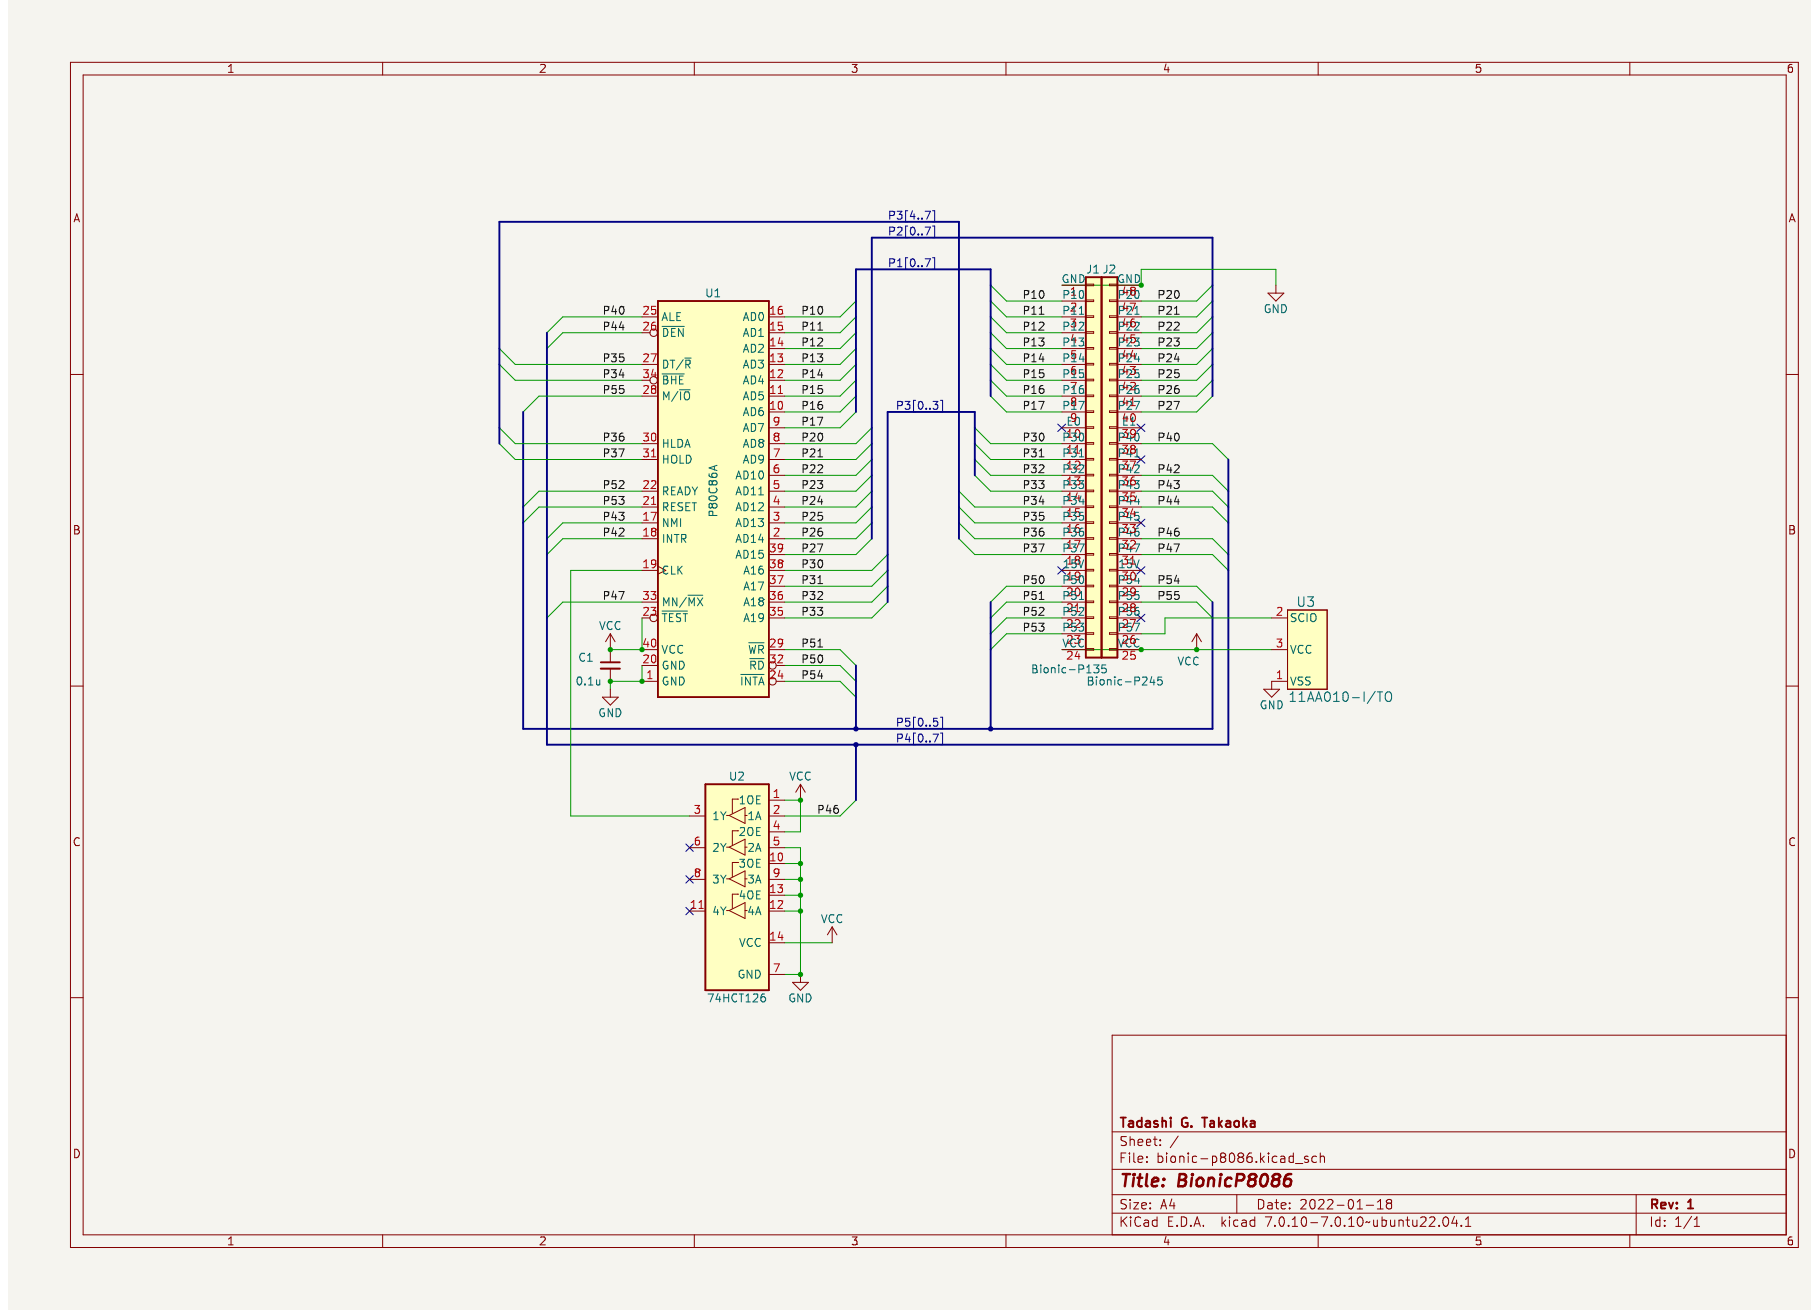
[picture p27: page 1]
