tgtakaoka/RetroCyborg/schematics/p8095/bionic-p8095.pdf

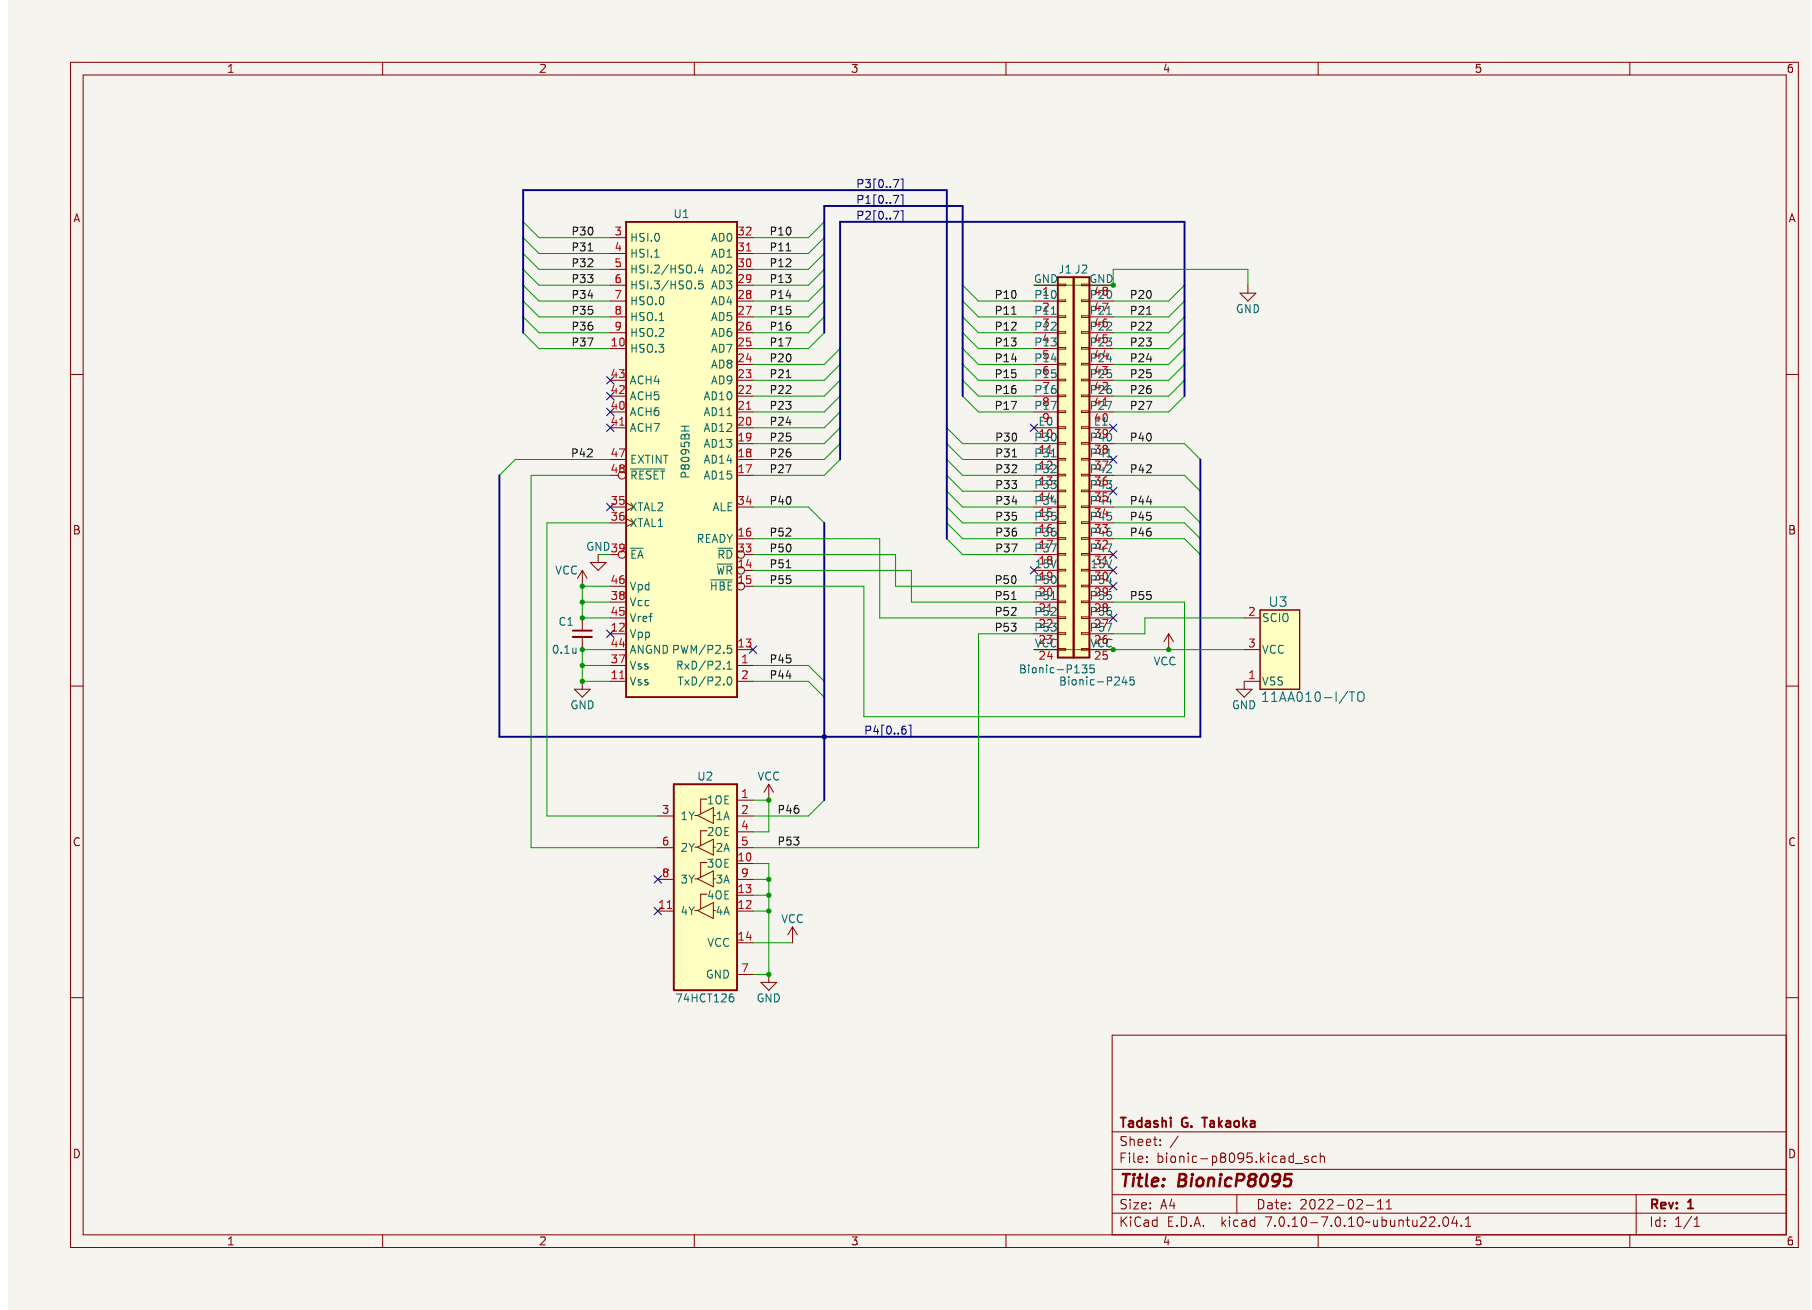
[picture p28: page 1]
