tgtakaoka/RetroCyborg/schematics/tms32010/bionic-tms32010.pdf

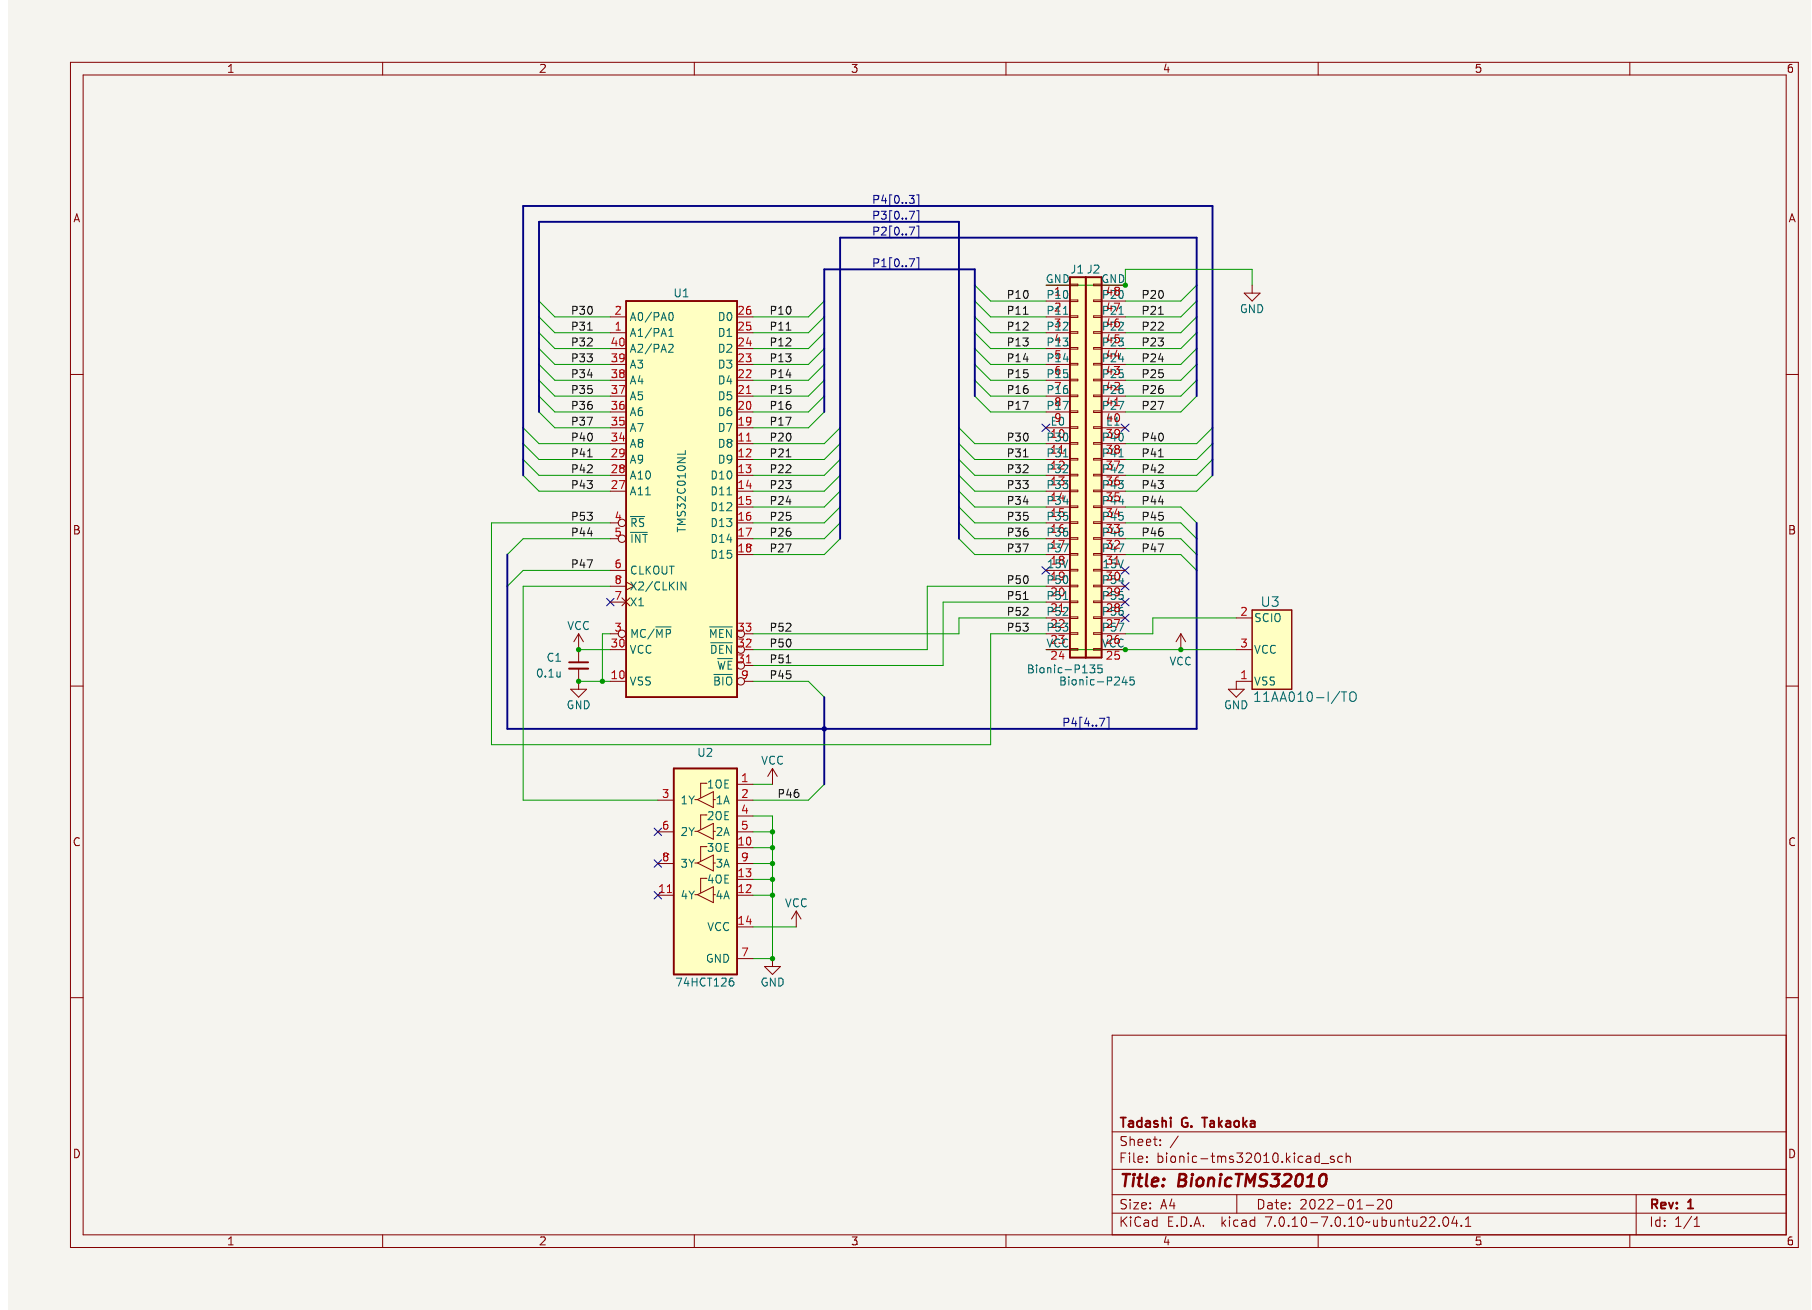
[picture p29: page 1]
