tgtakaoka/RetroCyborg/schematics/tms7000/bionic-tms7000.pdf

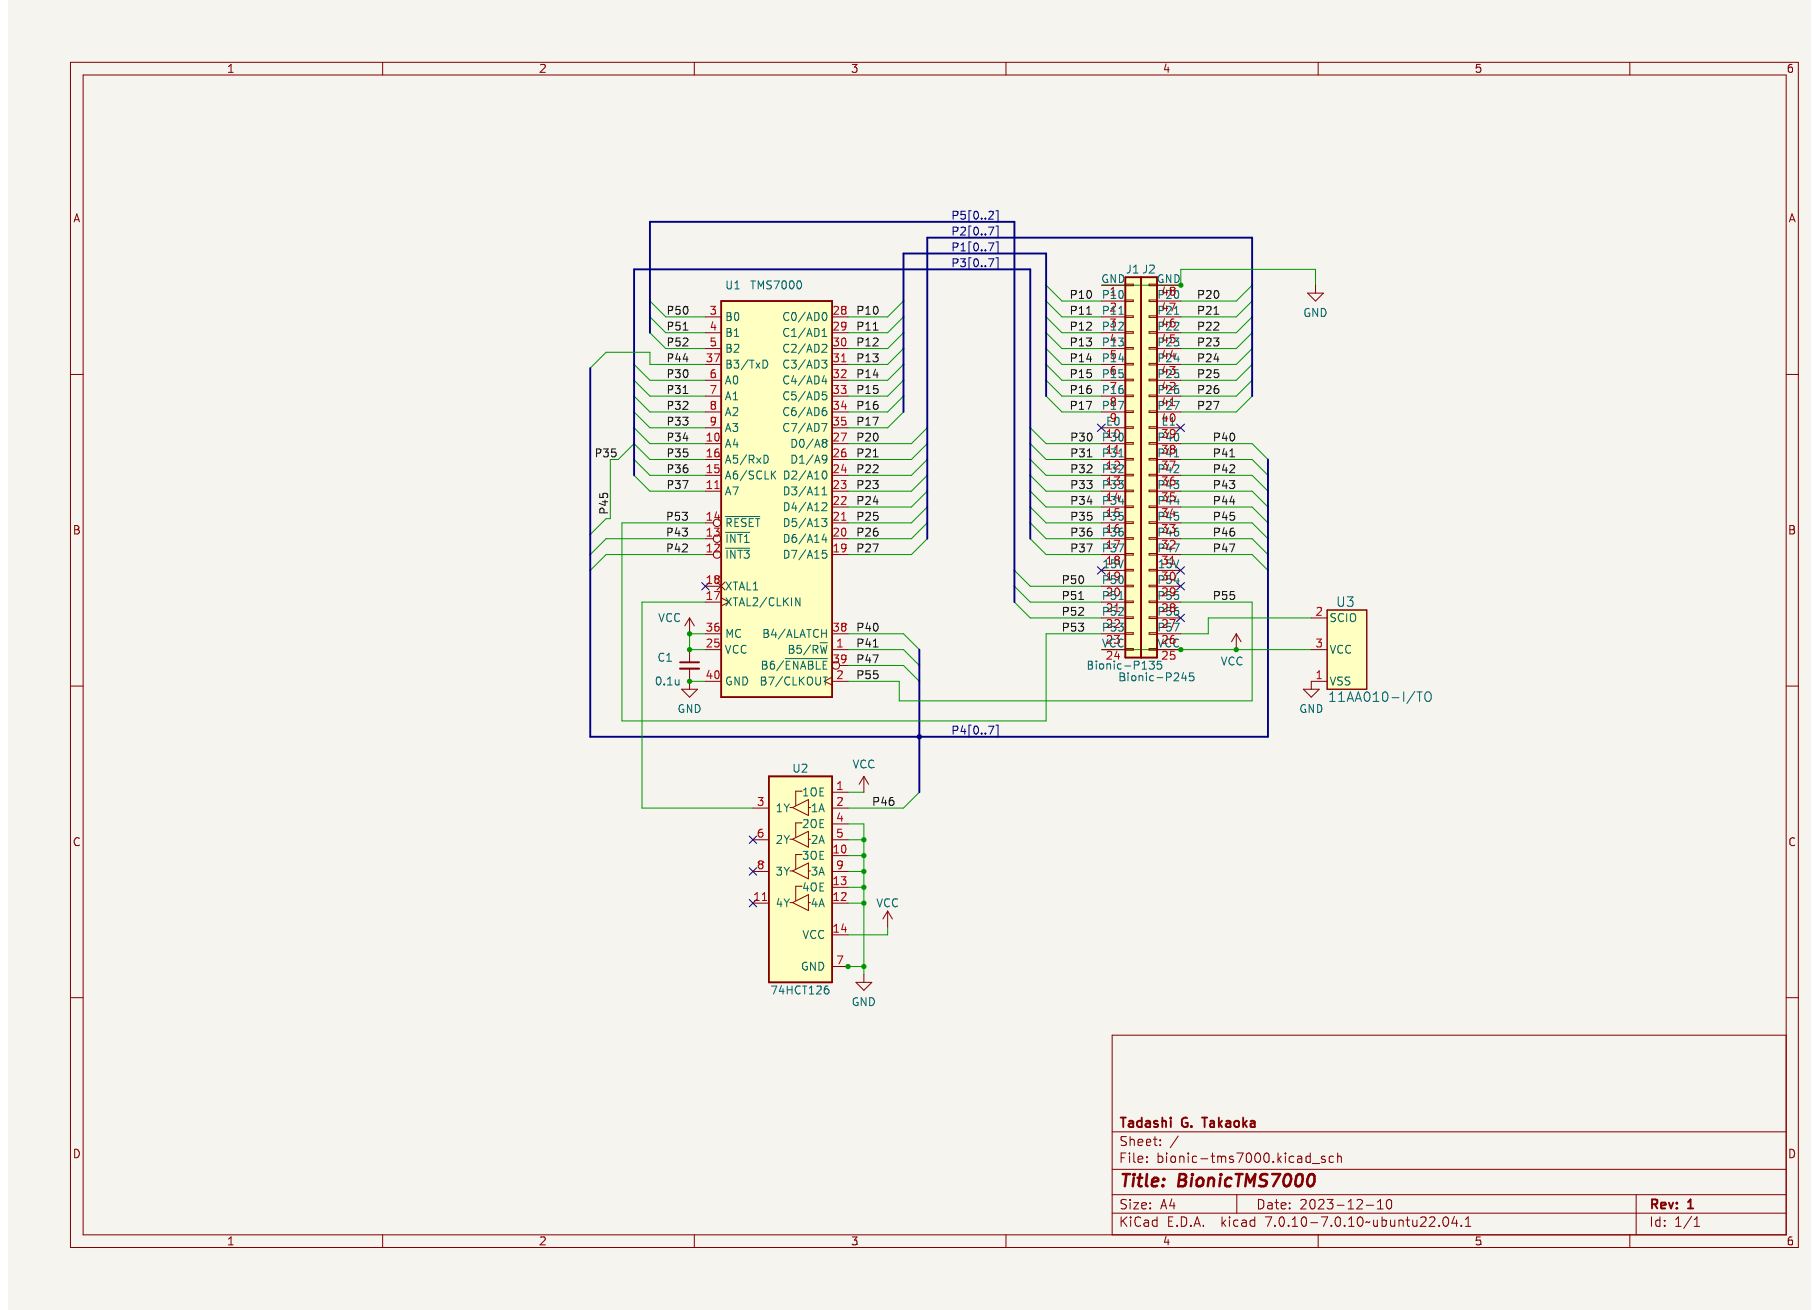
[picture p30: page 1]
