tgtakaoka/RetroCyborg/schematics/tms99105/bionic-tms99105.pdf

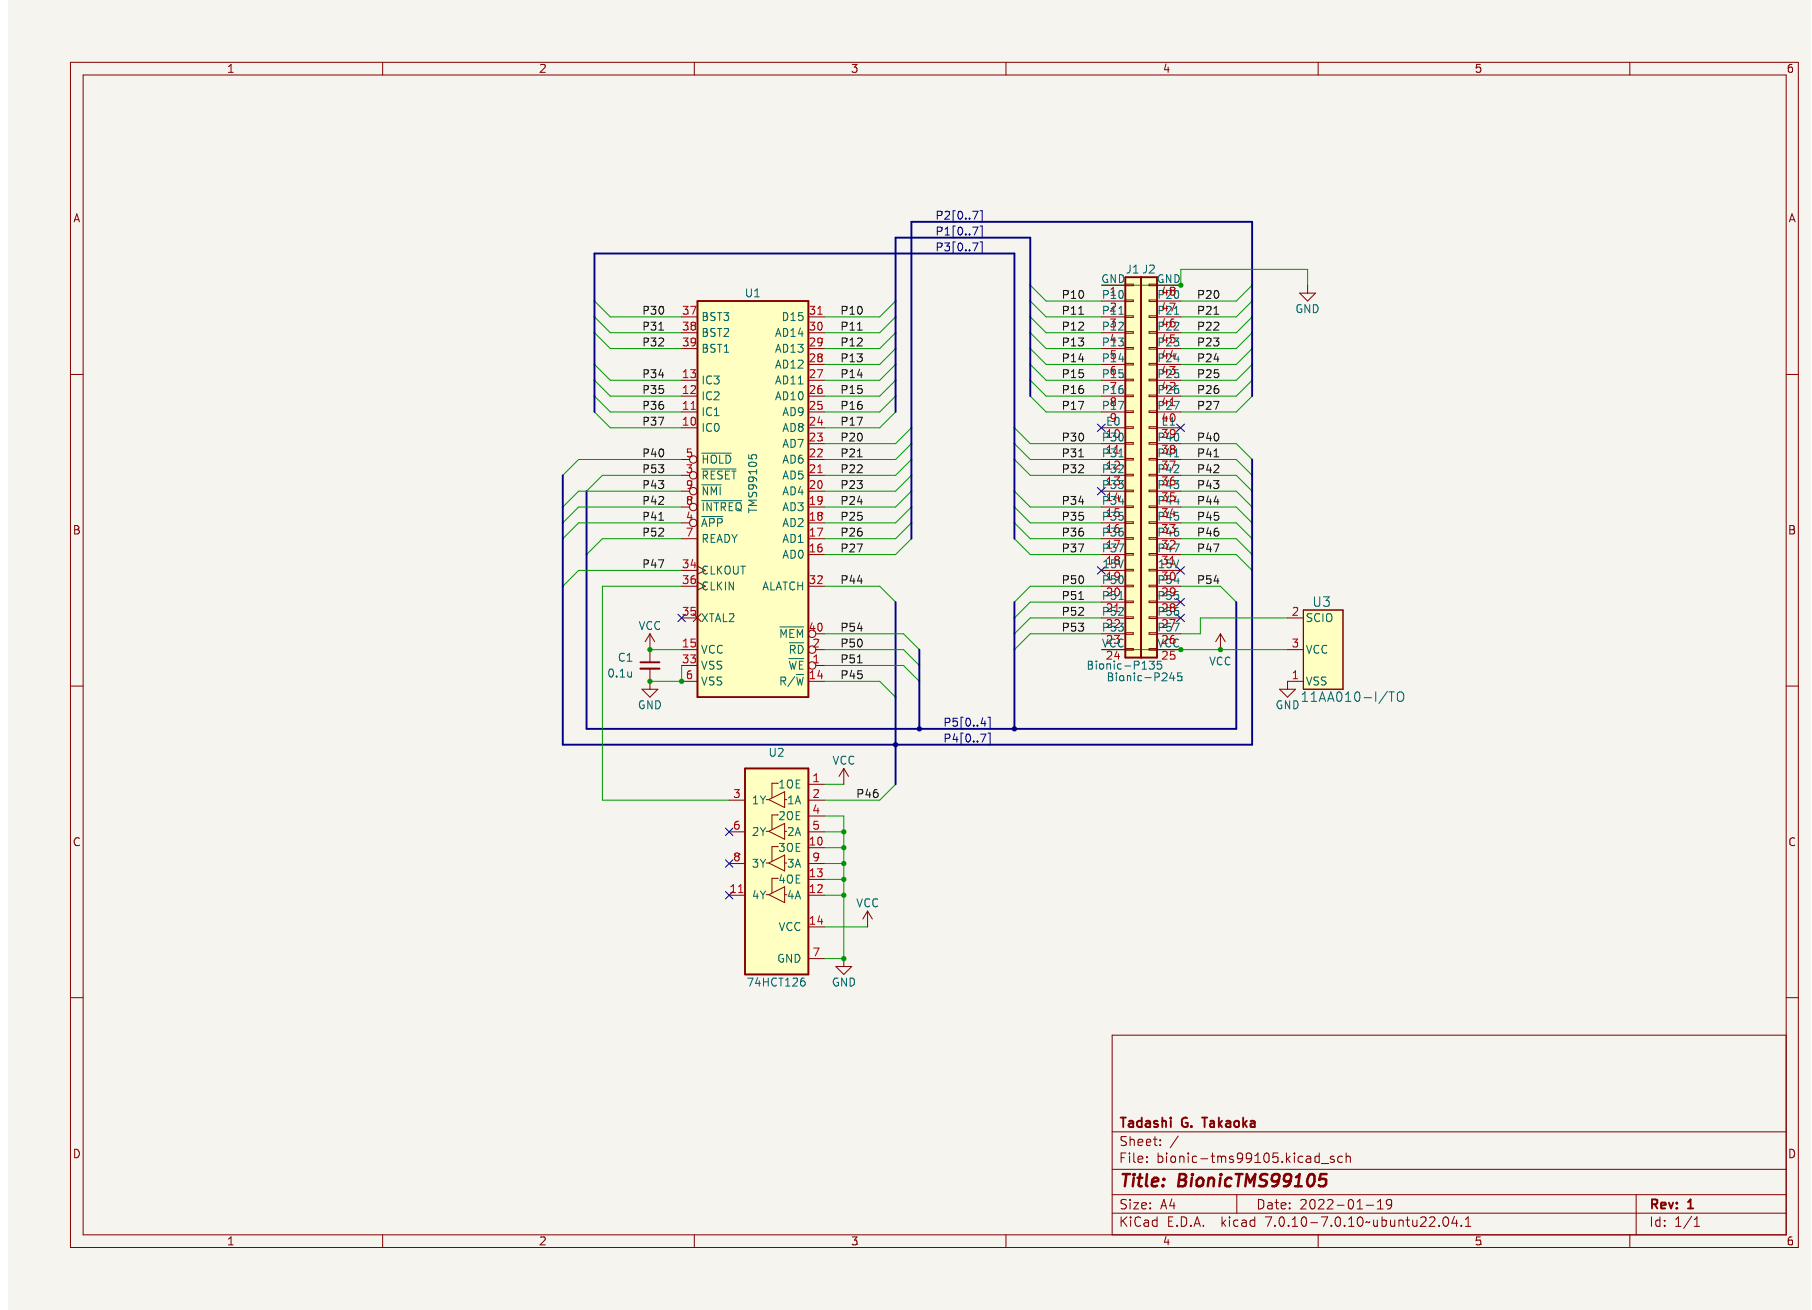
[picture p31: page 1]
