tgtakaoka/RetroCyborg/schematics/tms9981/bionic-tms9981.pdf

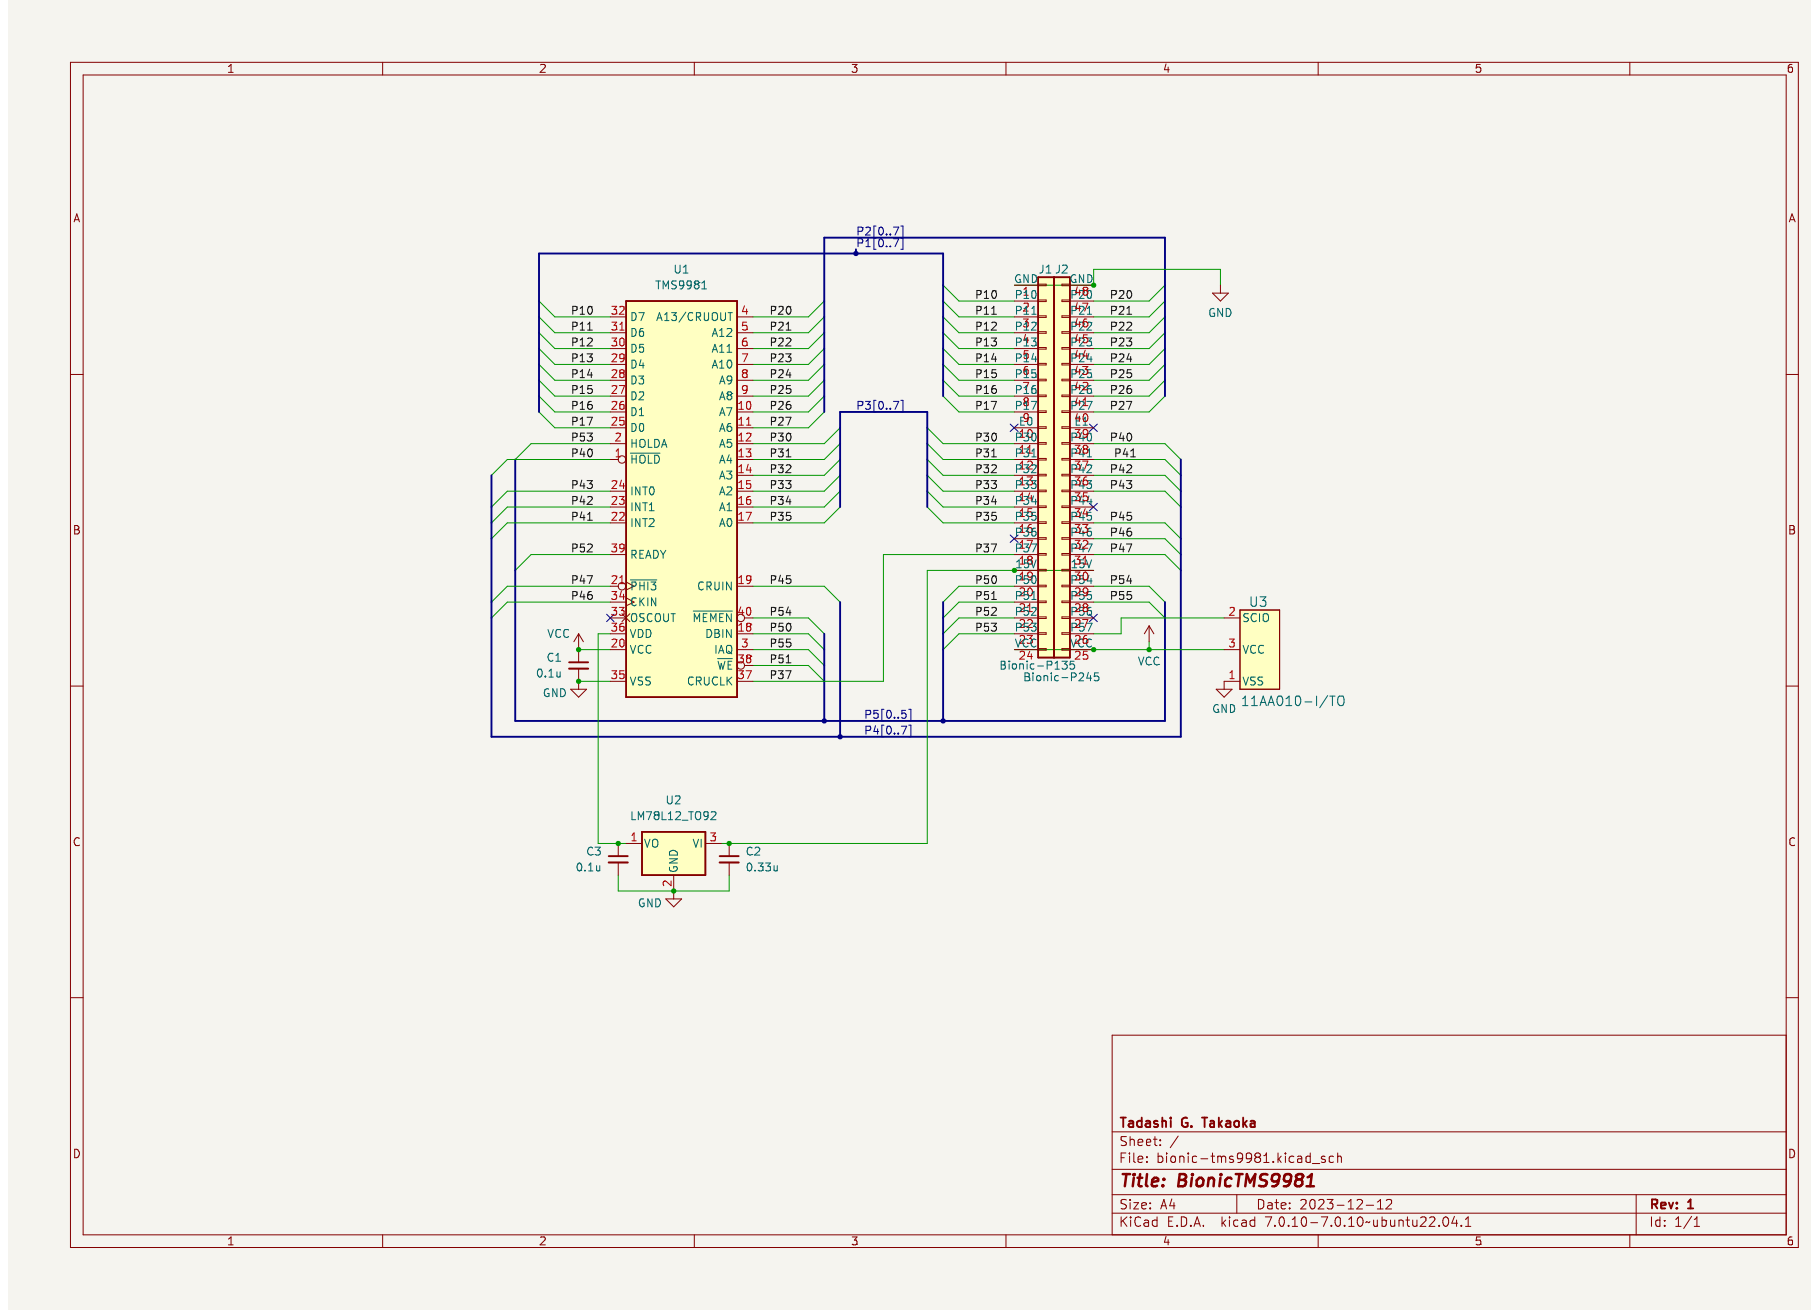
[picture p32: page 1]
