tgtakaoka/RetroCyborg/schematics/tms9995/bionic-tms9995.pdf

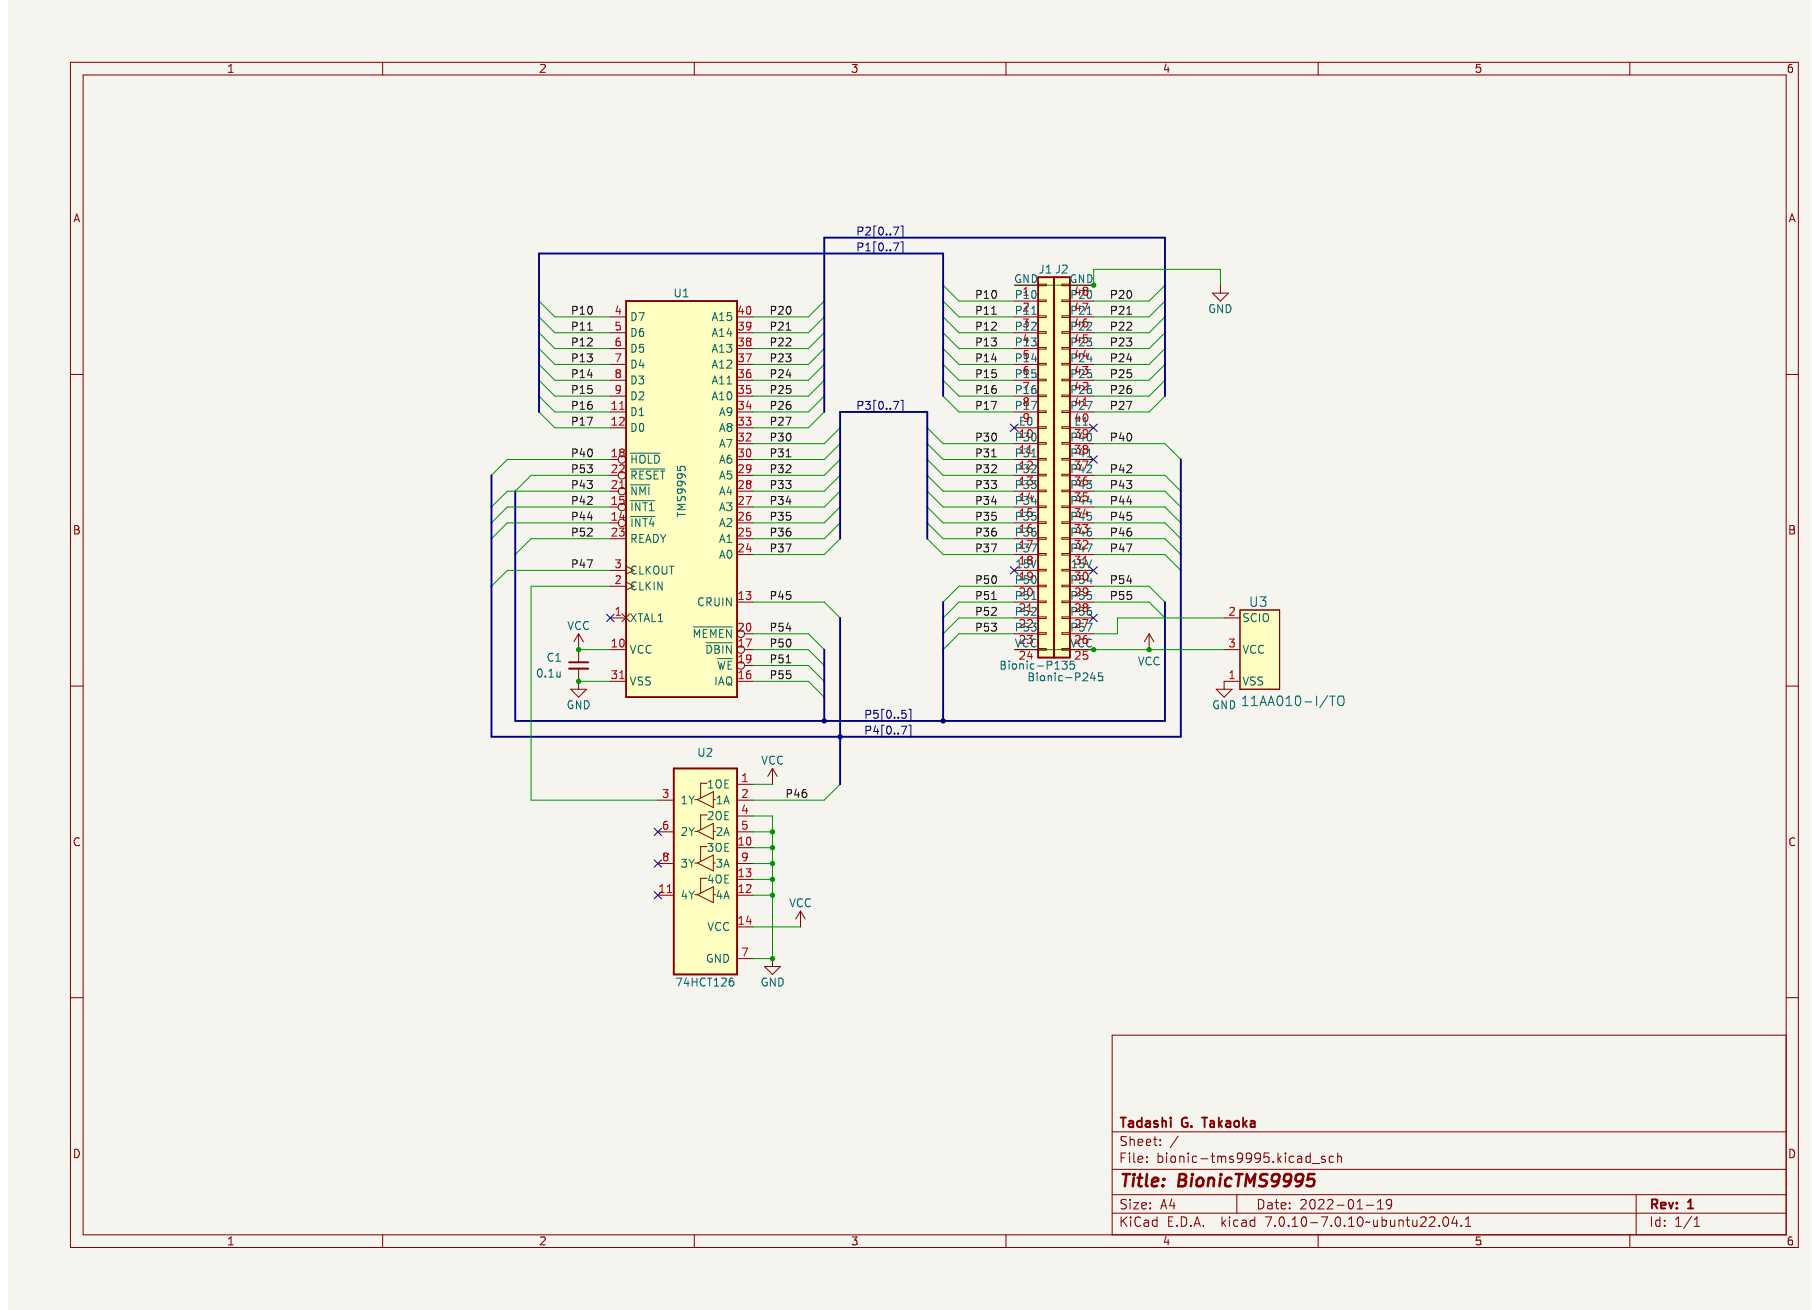
[picture p33: page 1]
