tgtakaoka/RetroCyborg/schematics/z80/bionic-z80.pdf

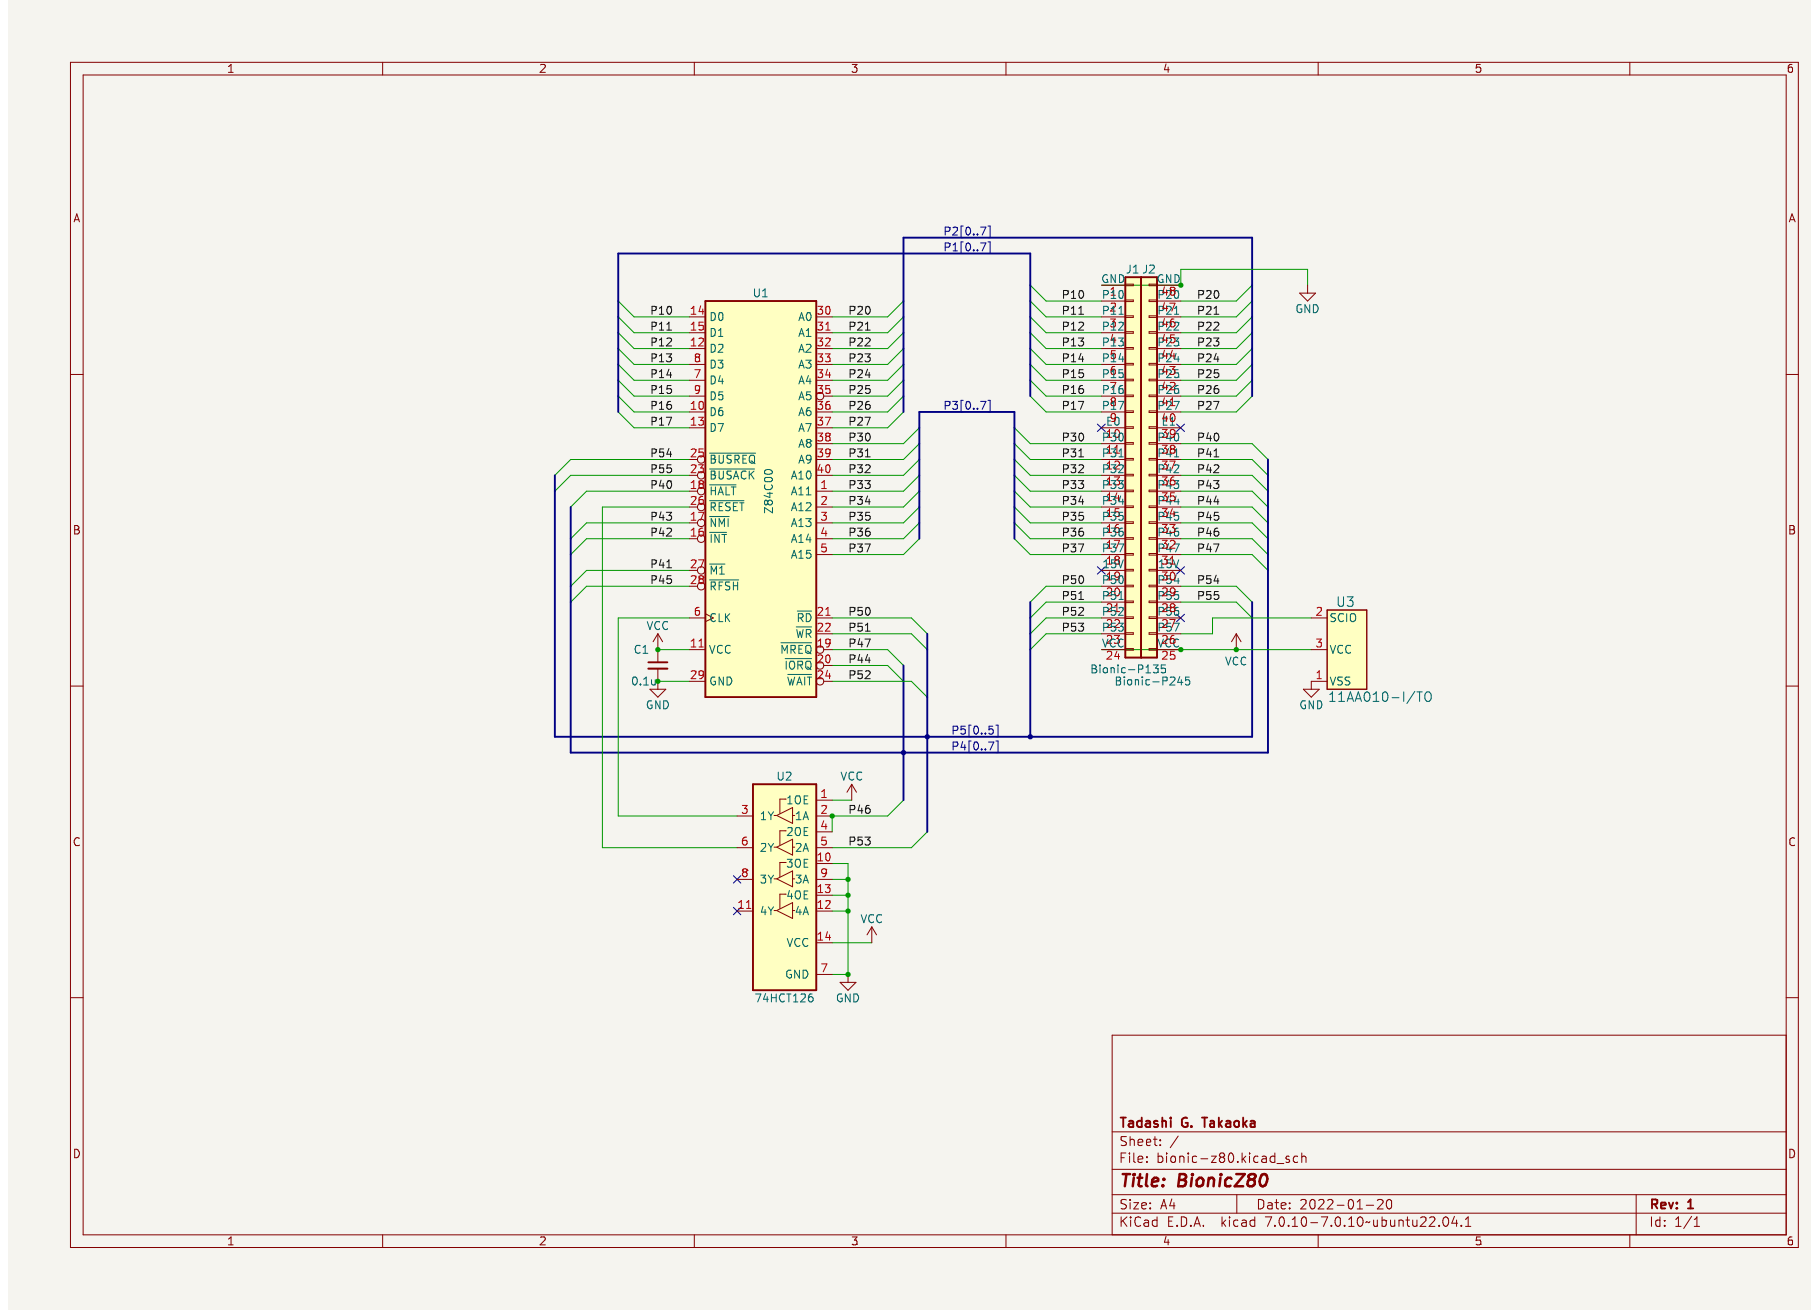
[picture p34: page 1]
