tgtakaoka/RetroCyborg/schematics/z8001/bionic-z8001.pdf

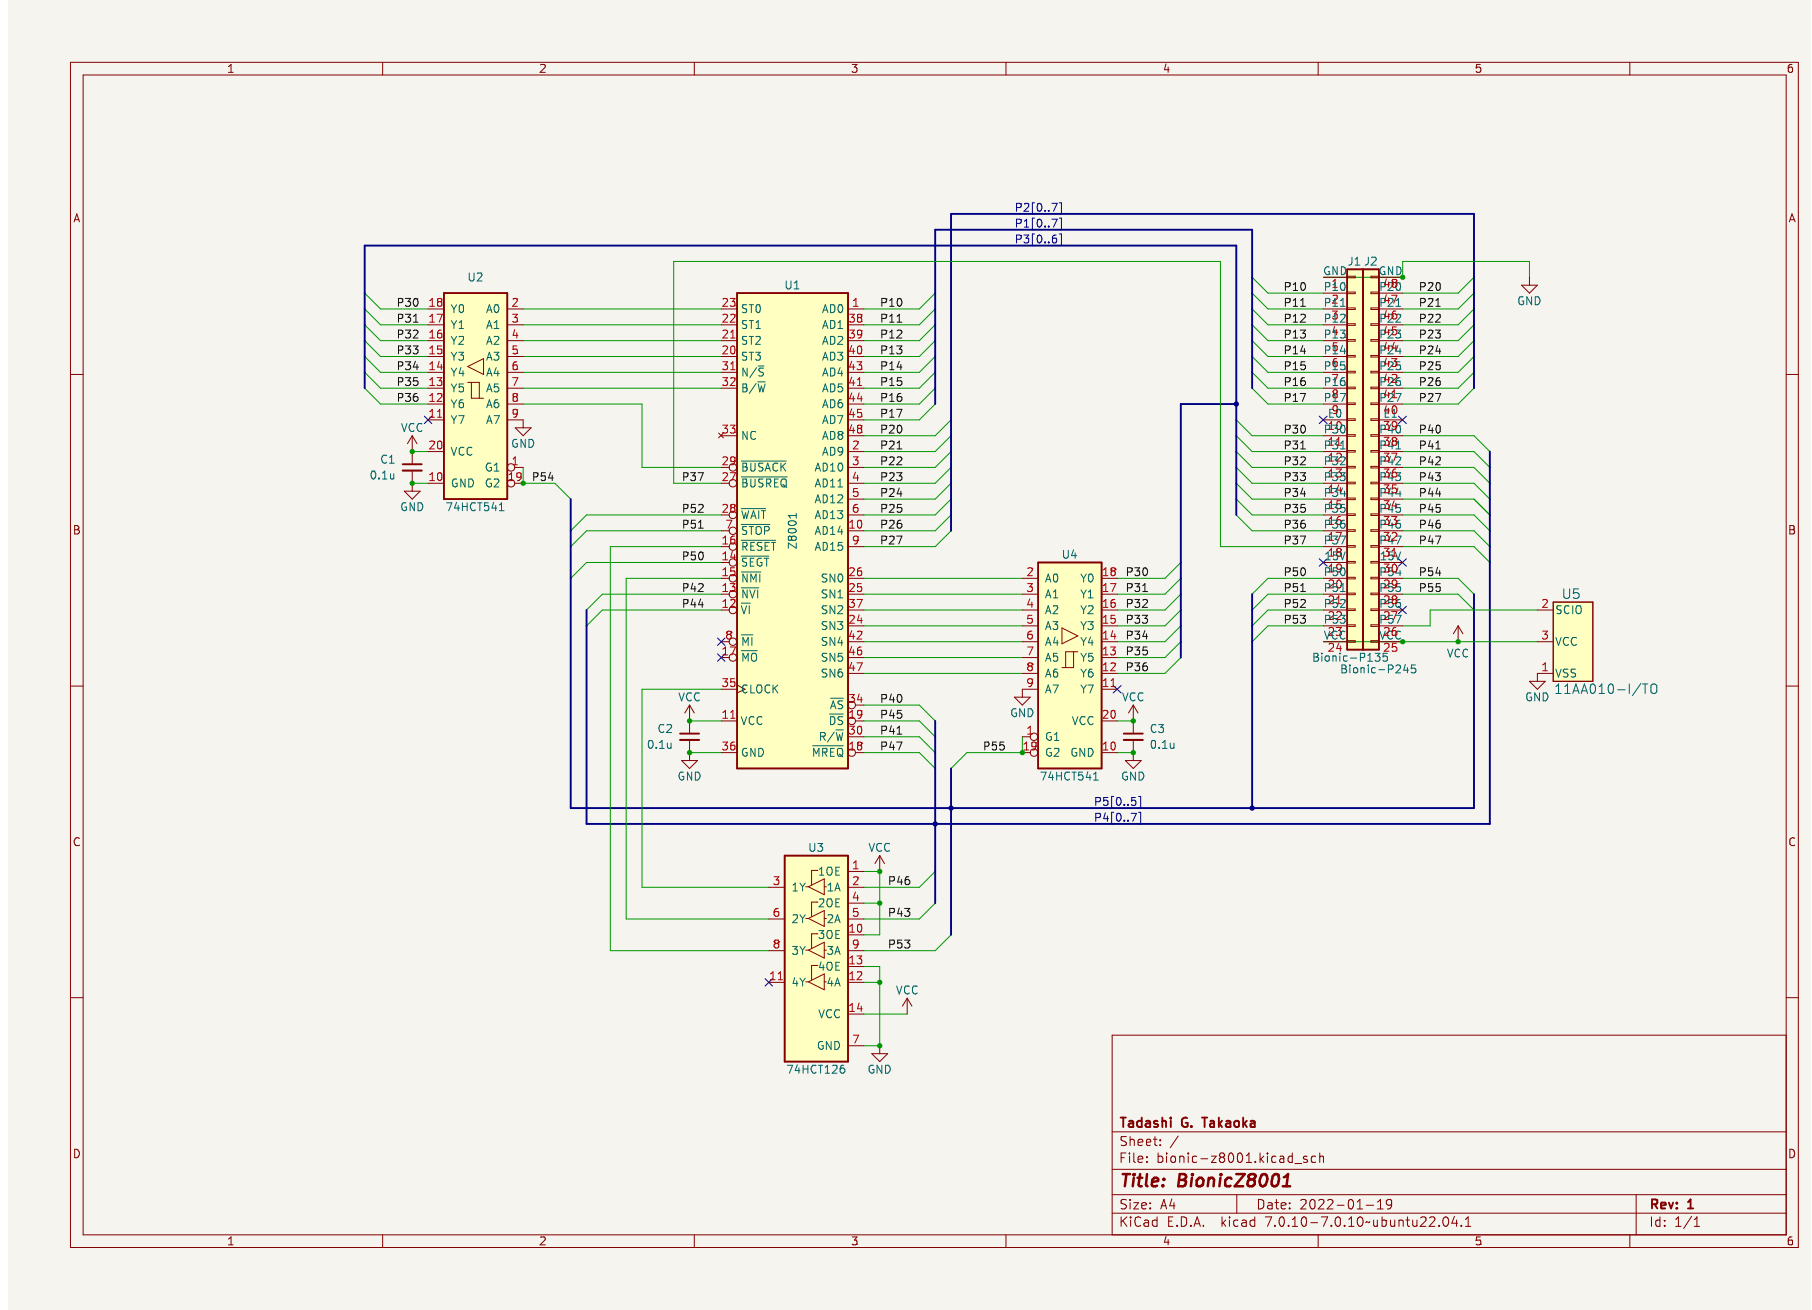
[picture p35: page 1]
