tgtakaoka/RetroCyborg/schematics/z8002/bionic-z8002.pdf

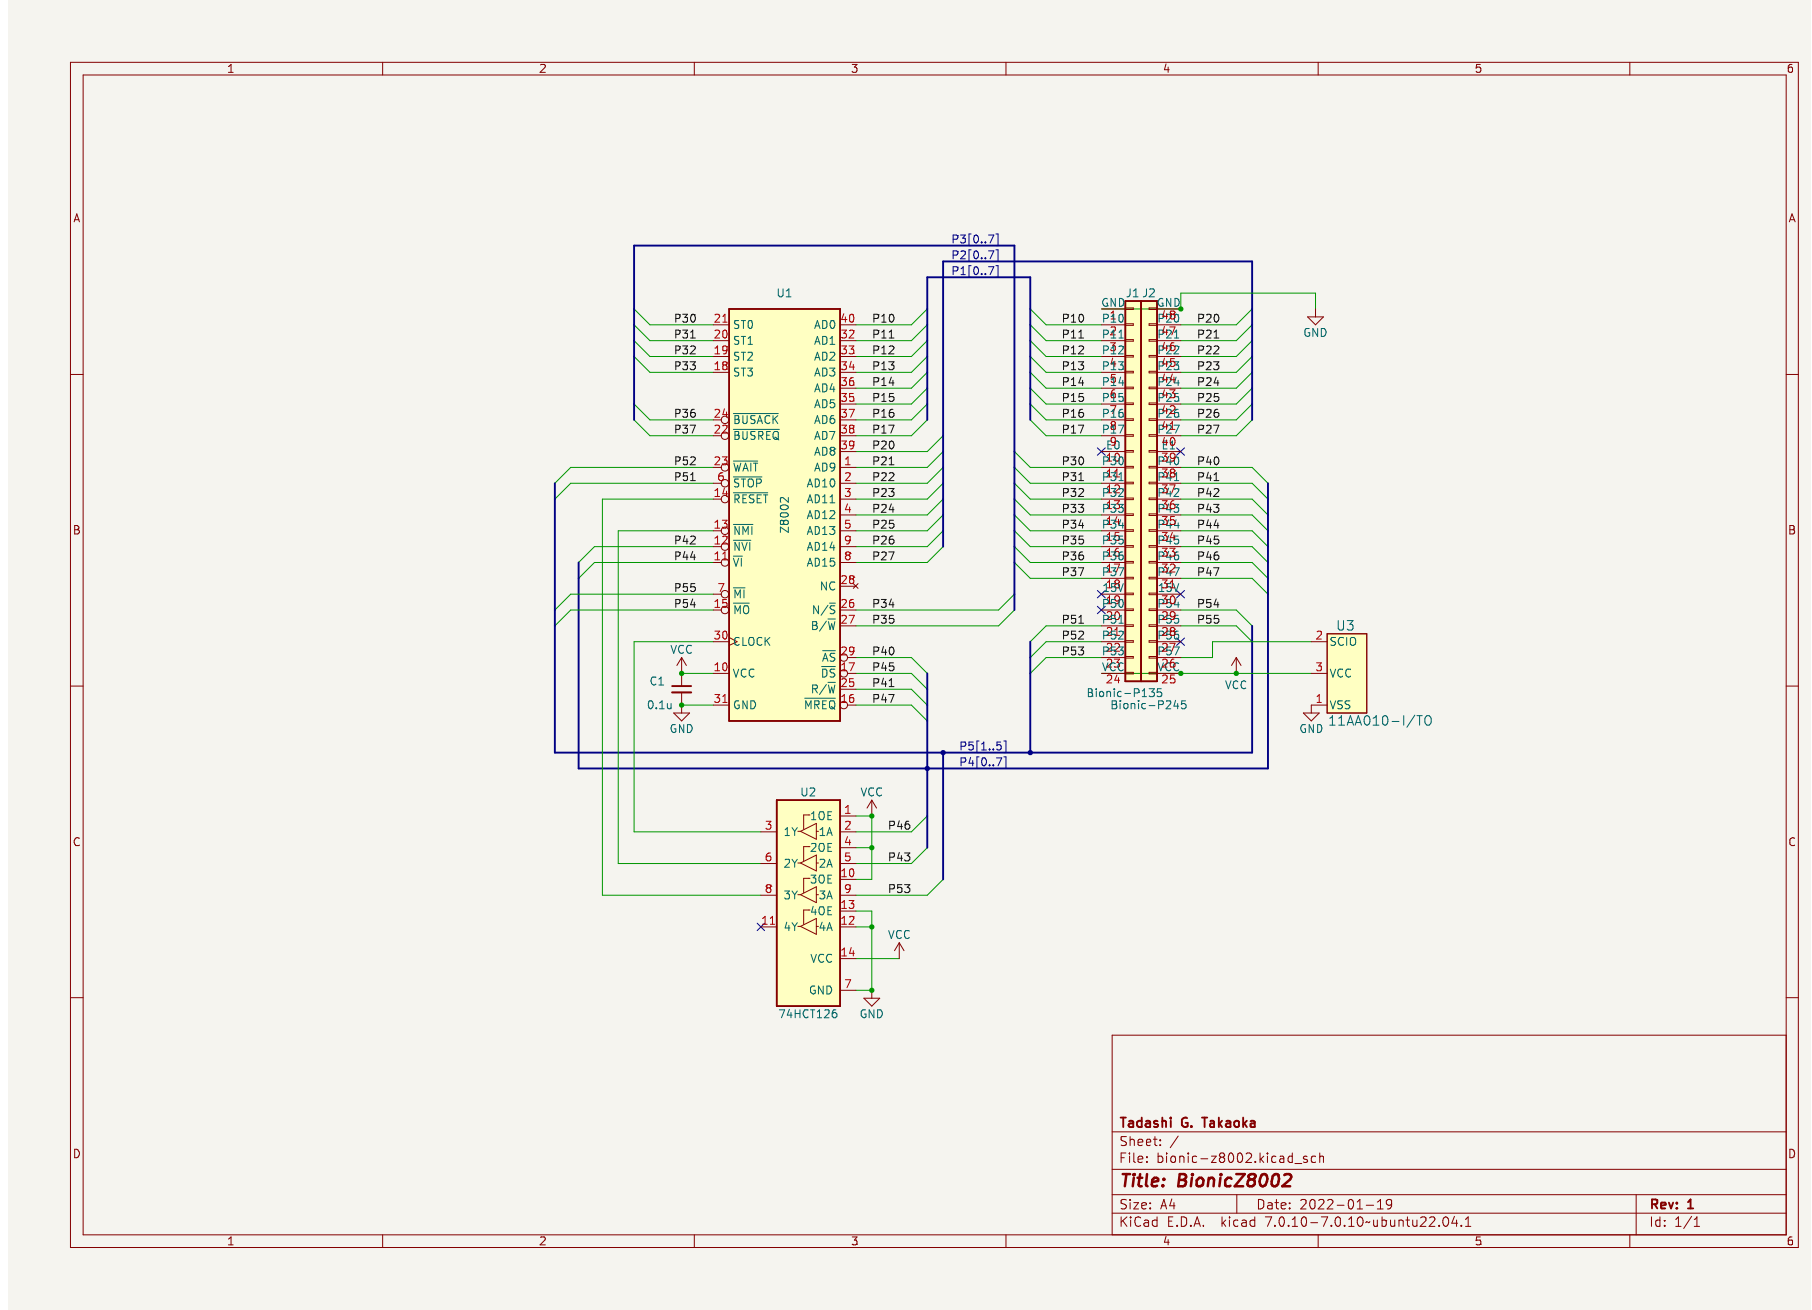
[picture p36: page 1]
