tgtakaoka/RetroCyborg/schematics/scn2650/bionic-scn2650.pdf

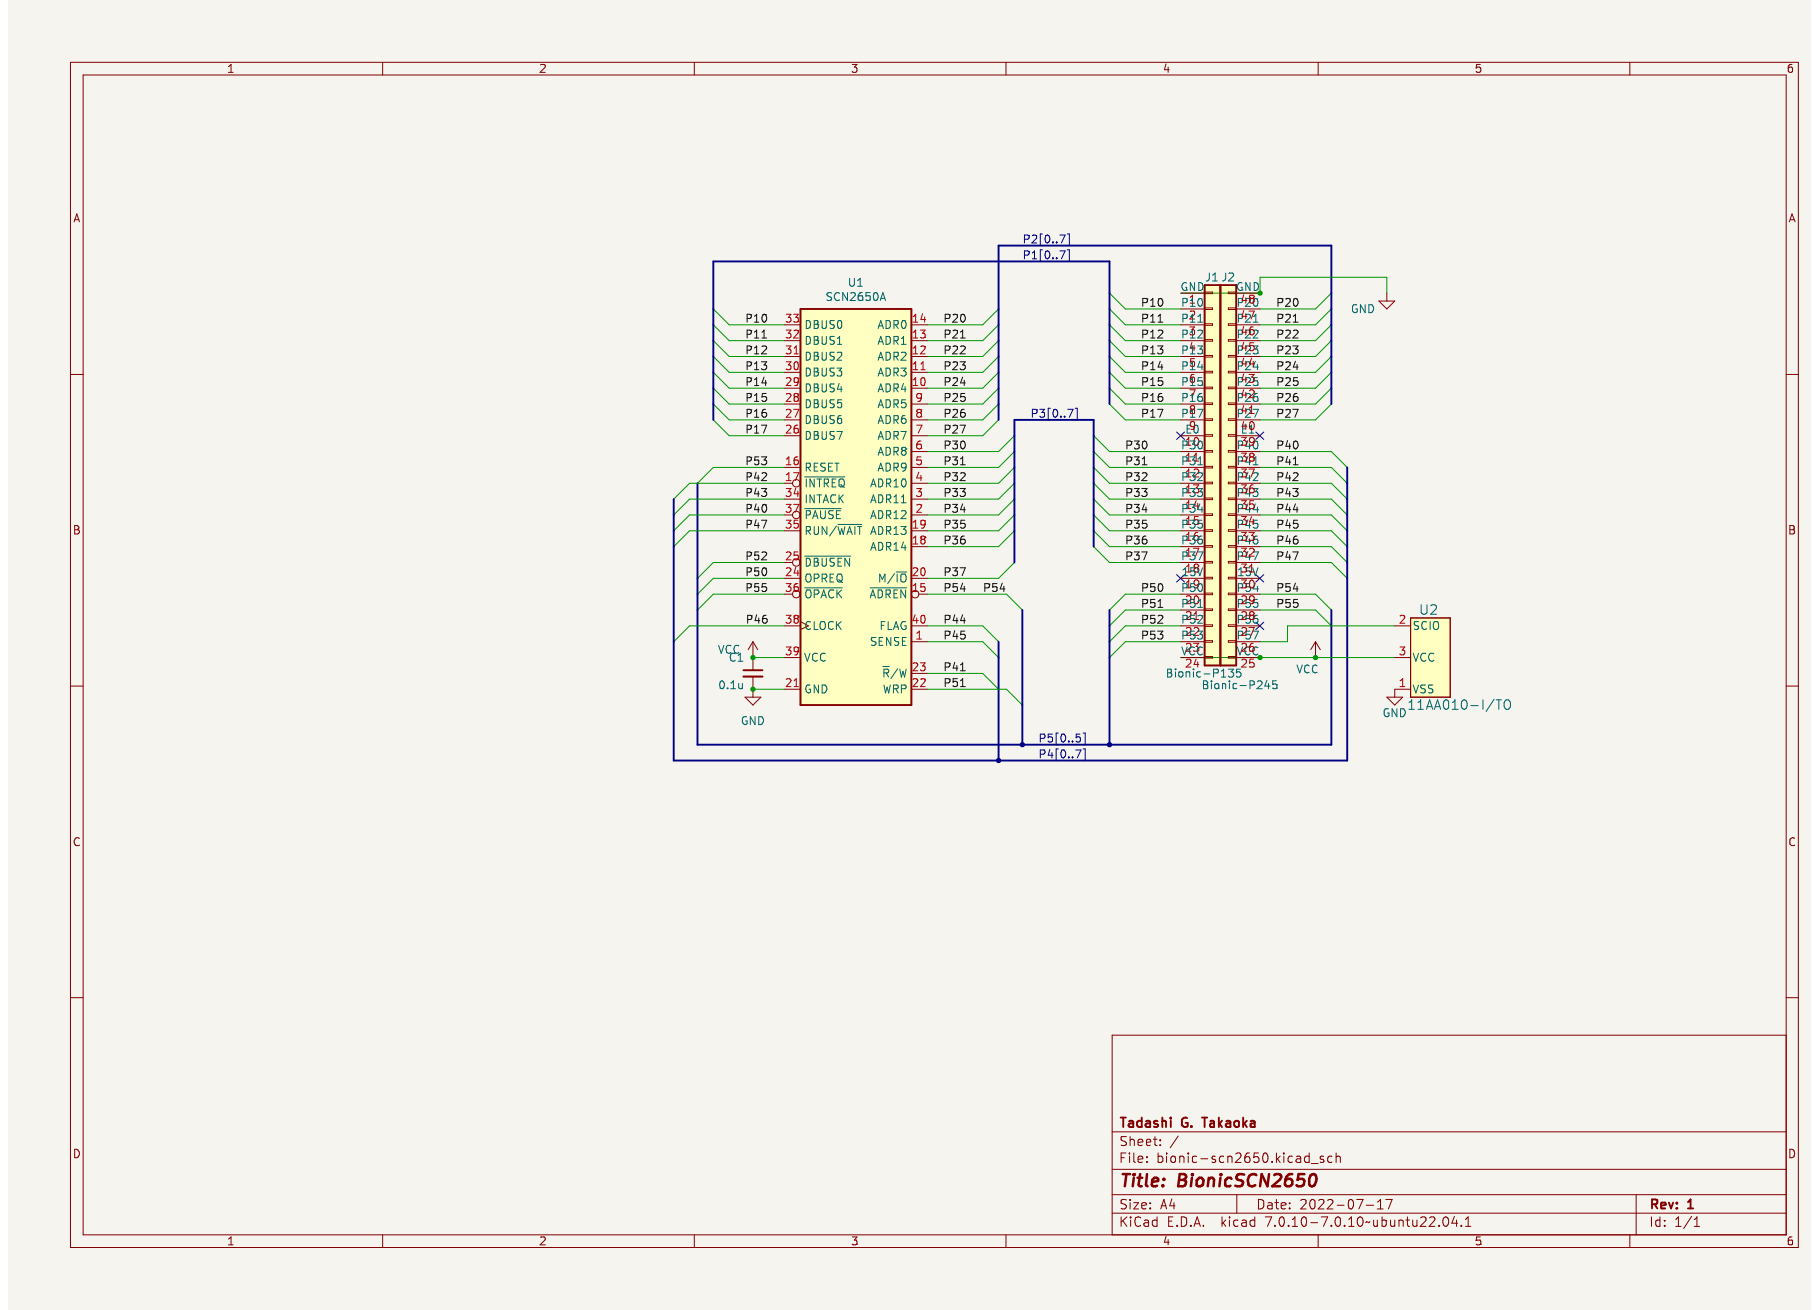
[picture p37: page 1]
