tgtakaoka/RetroCyborg/schematics/mos6502/bionic-mos6502.kicad_pcb

## KiCad design schematics/mos6502/bionic-mos6502.kicad_pcb (2024-03-21)

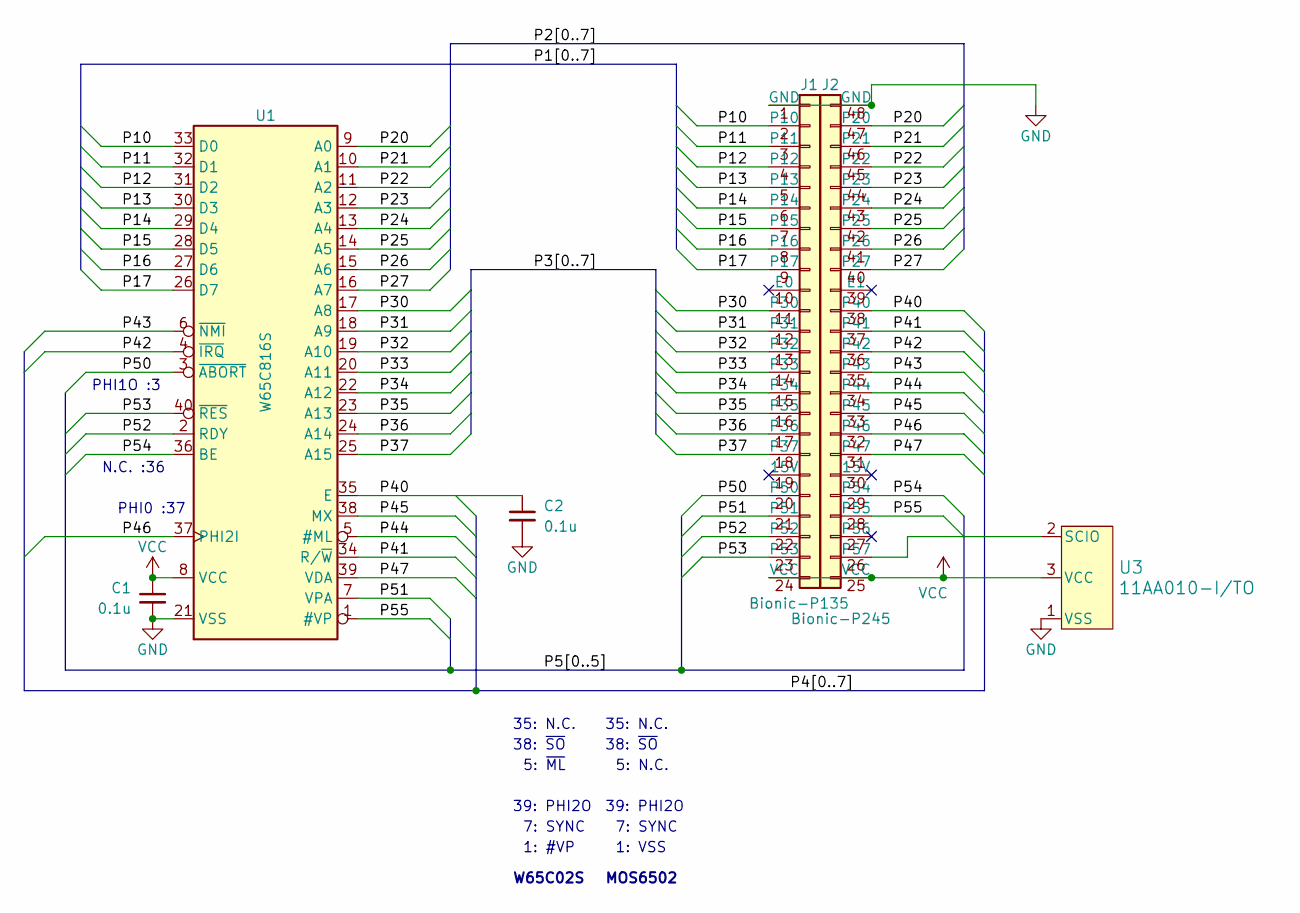
[picture p42: schematic bionic-mos6502.kicad_sch, BionicMOS6502]

Parts:
C1, C2: 0.1u; C_Disc_D3.4mm_W2.1mm_P2.50mm
J1: Bionic-P135; Bionic-P135_Vertical
J2: Bionic-P245; Bionic-P245_Vertical
U1: W65C816S; DIP-40_W15.24mm
U3: 11AA010-I/TO; TO-92_MC_MCH

Connections:
/P10: J1.2 (P10), U1.33 (D0)
/P11: J1.3 (P11), U1.32 (D1)
/P12: J1.4 (P12), U1.31 (D2)
/P13: J1.5 (P13), U1.30 (D3)
/P14: J1.6 (P14), U1.29 (D4)
/P15: J1.7 (P15), U1.28 (D5)
/P16: J1.8 (P16), U1.27 (D6)
/P17: J1.9 (P17), U1.26 (D7)
/P20: J2.47 (P20), U1.9 (A0)
/P21: J2.46 (P21), U1.10 (A1)
/P22: J2.45 (P22), U1.11 (A2)
/P23: J2.44 (P23), U1.12 (A3)
/P24: J2.43 (P24), U1.13 (A4)
/P25: J2.42 (P25), U1.14 (A5)
/P26: J2.41 (P26), U1.15 (A6)
/P27: J2.40 (P27), U1.16 (A7)
/P30: J1.11 (P30), U1.17 (A8)
/P31: J1.12 (P31), U1.18 (A9)
/P32: J1.13 (P32), U1.19 (A10)
/P33: J1.14 (P33), U1.20 (A11)
/P34: J1.15 (P34), U1.22 (A12)
/P35: J1.16 (P35), U1.23 (A13)
/P36: J1.17 (P36), U1.24 (A14)
/P37: J1.18 (P37), U1.25 (A15)
/P40: C2.1, J2.38 (P40), U1.35 (E)
/P41: J2.37 (P41), U1.34 (R/~W)
/P42: J2.36 (P42), U1.4 (~IRQ)
/P43: J2.35 (P43), U1.6 (~NMI)
/P44: J2.34 (P44), U1.5 (#ML)
/P45: J2.33 (P45), U1.38 (MX)
/P46: J2.32 (P46), U1.37 (PHI2I)
/P47: J2.31 (P47), U1.39 (VDA)
/P50: J1.20 (P50), U1.3 (~ABORT)
/P51: J1.21 (P51), U1.7 (VPA)
/P52: J1.22 (P52), U1.2 (RDY)
/P53: J1.23 (P53), U1.40 (~RES)
/P54: J2.29 (P54), U1.36 (BE)
/P55: J2.28 (P55), U1.1 (#VP)
GND: C1.2, C2.2, J1.1 (GND), J2.48 (GND), U1.21 (VSS), U3.1 (VSS)
unnamed: J2.26 (P57), U3.2 (SCIO)
VCC: C1.1, J1.24 (VCC), J2.25 (VCC), U1.8 (VCC), U3.3 (VCC)

Notes on the sheet:
N.C. :36
PHI0 :37
35: N.C.
MOS6502
5: N.C.
W65C02S
7: SYNC
PHI1O :3
39: PHI2O
1: VSS
5: ~{ML}
1: #VP
38: ~{SO}

Board: 2 copper layers, 10 parts (0 on the bottom side), 41 nets, no tracks yet.

Other parts of the board:
MH1, MH2, MH3, MH4: MountingHole_3.2mm_M3
