tgtakaoka/RetroCyborg/schematics/mc68hc11d/bionic-mc68hc11d.kicad_pcb

## KiCad design schematics/mc68hc11d/bionic-mc68hc11d.kicad_pcb (2024-03-21)

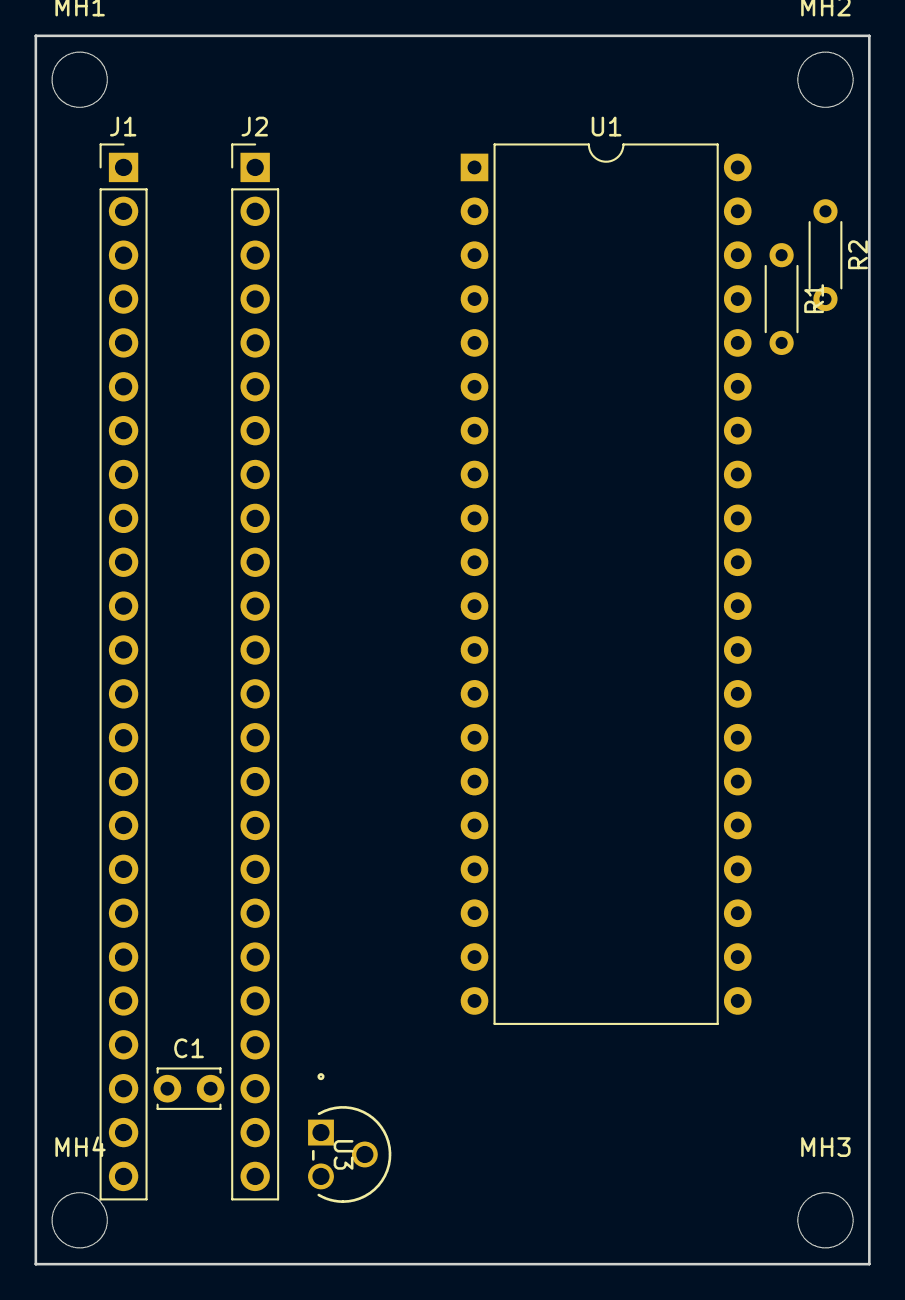
[picture p43: board bionic-mc68hc11d.kicad_pcb from above]

Board: 2 copper layers, 48.3 x 71.1 mm, 11 parts (0 on the bottom side), 40 nets, no tracks yet.

Parts:
C1: 0.1u; C_Disc_D3.4mm_W2.1mm_P2.50mm
J1: Bionic-P135; Bionic-P135_Vertical
J2: Bionic-P245; Bionic-P245_Vertical
MH1, MH2, MH3, MH4: MountingHole_3.2mm_M3
R1, R2: 10k; R_Axial_DIN0204_L3.6mm_D1.6mm_P5.08mm_Horizontal
U1: MC68HC11D0P; DIP-40_W15.24mm
U3: 11AA010-I/TO; TO-92_MC_MCH

Connections:
/P10: J1.2 (P10), U1.2 (AD0)
/P11: J1.3 (P11), U1.3 (AD1)
/P12: J1.4 (P12), U1.4 (AD2)
/P13: J1.5 (P13), U1.5 (AD3)
/P14: J1.6 (P14), U1.6 (AD4)
/P15: J1.7 (P15), U1.7 (AD5)
/P16: J1.8 (P16), U1.8 (AD6)
/P17: J1.9 (P17), U1.9 (AD7)
/P20: J2.47 (P20), U1.35 (A8)
/P21: J2.46 (P21), U1.34 (A9)
/P22: J2.45 (P22), U1.33 (A10)
/P23: J2.44 (P23), U1.32 (A11)
/P24: J2.43 (P24), U1.31 (A12)
/P25: J2.42 (P25), U1.30 (A13)
/P26: J2.41 (P26), U1.29 (A14)
/P27: J2.40 (P27), U1.28 (A15)
/P30: J1.11 (P30), U1.27 (PA0)
/P31: J1.12 (P31), U1.26 (PA1)
/P32: J1.13 (P32), U1.25 (PA2)
/P33: J1.14 (P33), U1.24 (PA3)
/P34: J1.15 (P34), U1.17 (MISO/PD2)
/P35: J1.16 (P35), U1.18 (MOSI/PD3)
/P36: J1.17 (P36), U1.19 (SCK/PD4)
/P37: J1.18 (P37), U1.20 (~SS/PD5)
/P40: J2.38 (P40), U1.12 (AS)
/P41: J2.37 (P41), U1.11 (R/~W)
/P42: J2.36 (P42), U1.14 (~IRQ)
/P43: J2.35 (P43), U1.10 (~XIRQ)
/P44: J2.34 (P44), U1.16 (TxD/PD1)
/P45: J2.33 (P45), U1.15 (RxD/PD0)
/P46: J2.32 (P46), U1.39 (EXTAL)
/P47: J2.31 (P47), U1.38 (E)
/P50: J1.20 (P50), R2.2, U1.37 (MODA/~LIR)
/P51: J1.21 (P51), R1.2, U1.36 (MODB)
/P53: J1.23 (P53), U1.13 (~RESET)
/P54: J2.29 (P54), U1.23 (PA5)
/P55: J2.28 (P55), U1.22 (PA7)
GND: C1.2, J1.1 (GND), J2.48 (GND), U1.1 (VSS), U3.1 (VSS)
unnamed: J2.26 (P57), U3.2 (SCIO)
VCC: C1.1, J1.24 (VCC), J2.25 (VCC), R1.1, R2.1, U1.21 (VDD), U3.3 (VCC)
