tgtakaoka/RetroCyborg/schematics/mc6809e/bionic-mc6809e.kicad_pcb

## KiCad design schematics/mc6809e/bionic-mc6809e.kicad_pcb (2024-03-21)

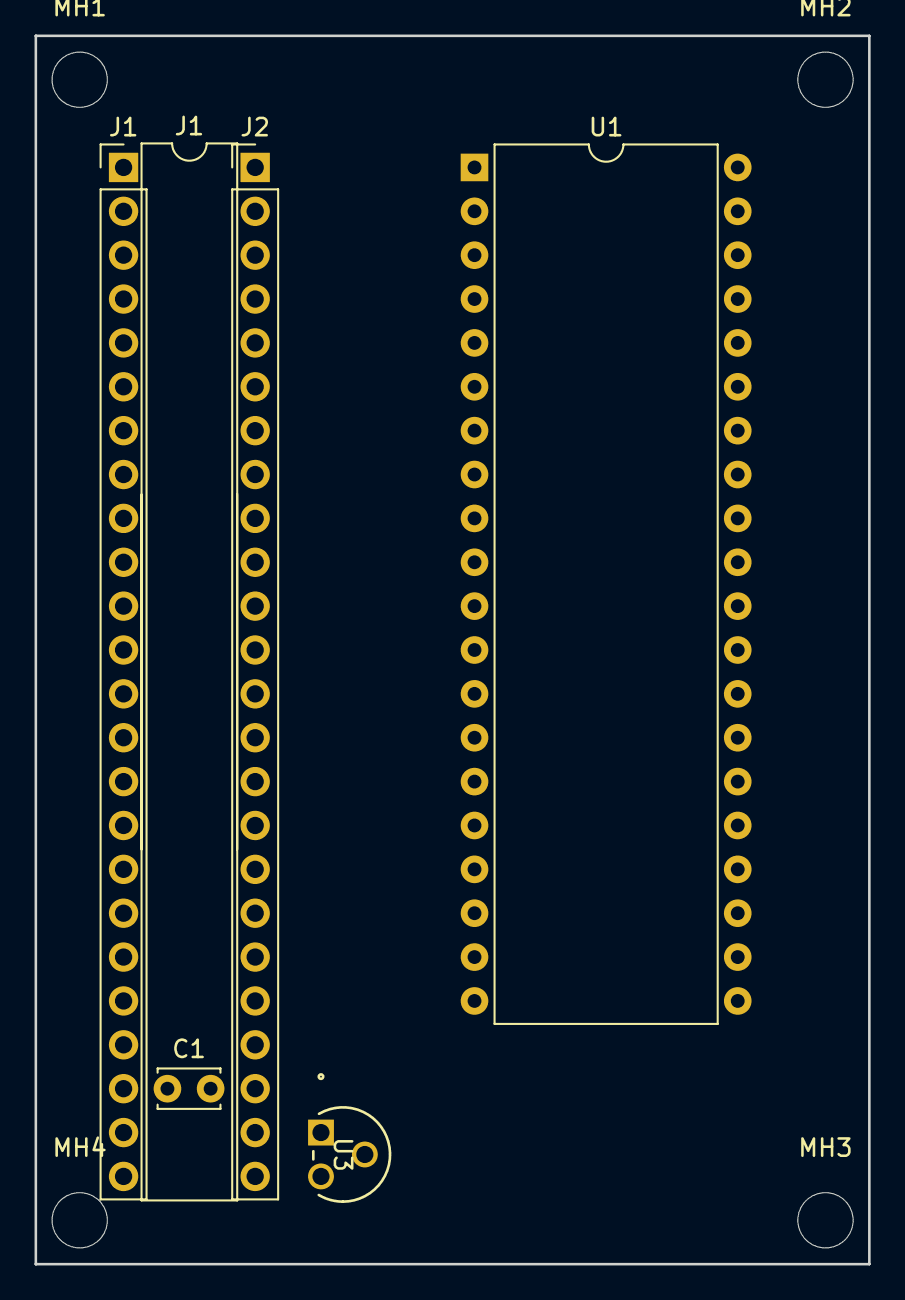
[picture p44: board bionic-mc6809e.kicad_pcb from above]

Board: 2 copper layers, 48.3 x 71.1 mm, 10 parts (0 on the bottom side), 41 nets, no tracks yet.

Parts:
C1: 0.1u; C_Disc_D3.4mm_W2.1mm_P2.50mm
J1: BionicConnector; DIP-48_W7.62mm
J1#2: Bionic-P135; Bionic-P135_Vertical
J2: Bionic-P245; Bionic-P245_Vertical
MH1, MH2, MH3, MH4: MountingHole_3.2mm_M3
U1: MC6809EP; DIP-40_W15.24mm
U3: 11AA010-I/TO; TO-92_MC_MCH

Connections:
/P10: J1.2 (P10), J1#2.2 (P10), U1.31 (D0)
/P11: J1.3 (P11), J1#2.3 (P11), U1.30 (D1)
/P12: J1.4 (P12), J1#2.4 (P12), U1.29 (D2)
/P13: J1.5 (P13), J1#2.5 (P13), U1.28 (D3)
/P14: J1.6 (P14), J1#2.6 (P14), U1.27 (D4)
/P15: J1.7 (P15), J1#2.7 (P15), U1.26 (D5)
/P16: J1.8 (P16), J1#2.8 (P16), U1.25 (D6)
/P17: J1.9 (P17), J1#2.9 (P17), U1.24 (D7)
/P20: J1.47 (P20), J2.47 (P20), U1.8 (A0)
/P21: J1.46 (P21), J2.46 (P21), U1.9 (A1)
/P22: J1.45 (P22), J2.45 (P22), U1.10 (A2)
/P23: J1.44 (P23), J2.44 (P23), U1.11 (A3)
/P24: J1.43 (P24), J2.43 (P24), U1.12 (A4)
/P25: J1.42 (P25), J2.42 (P25), U1.13 (A5)
/P26: J1.41 (P26), J2.41 (P26), U1.14 (A6)
/P27: J1.40 (P27), J2.40 (P27), U1.15 (A7)
/P30: J1.11 (P30), J1#2.11 (P30), U1.16 (A8)
/P31: J1.12 (P31), J1#2.12 (P31), U1.17 (A9)
/P32: J1.13 (P32), J1#2.13 (P32), U1.18 (A10)
/P33: J1.14 (P33), J1#2.14 (P33), U1.19 (A11)
/P34: J1.15 (P34), J1#2.15 (P34), U1.20 (A12)
/P35: J1.16 (P35), J1#2.16 (P35), U1.21 (A13)
/P36: J1.17 (P36), J1#2.17 (P36), U1.22 (A14)
/P37: J1.18 (P37), J1#2.18 (P37), U1.23 (A15)
/P40: J1.38 (P40), J2.38 (P40), U1.40 (~HALT)
/P41: J1.37 (P41), J2.37 (P41), U1.32 (R/~W)
/P42: J1.36 (P42), J2.36 (P42), U1.3 (~IRQ)
/P43: J1.35 (P43), J2.35 (P43), U1.2 (~NMI)
/P44: J1.34 (P44), J2.34 (P44), U1.33 (BUSY)
/P45: J1.33 (P45), J2.33 (P45), U1.4 (~FIRQ)
/P46: J1.32 (P46), J2.32 (P46), U1.34 (E)
/P47: J1.31 (P47), J2.31 (P47), U1.35 (Q)
/P50: J1.20 (P50), J1#2.20 (P50), U1.36 (AVMA)
/P51: J1.21 (P51), J1#2.21 (P51), U1.5 (BS)
/P52: J1.22 (P52), J1#2.22 (P52), U1.38 (LIC)
/P53: J1.23 (P53), J1#2.23 (P53), U1.37 (~RESET)
/P54: J1.29 (P54), J2.29 (P54), U1.39 (TSC)
/P55: J1.28 (P55), J2.28 (P55), U1.6 (BA)
GND: C1.2, J1.1 (GND), J1.48 (GND), J1#2.1 (GND), J2.48 (GND), U1.1 (VSS), U3.1 (VSS)
unnamed: J2.26 (P57), U3.2 (SCIO)
VCC: C1.1, J1.24 (VCC), J1.25 (VCC), J1#2.24 (VCC), J2.25 (VCC), U1.7 (VCC), U3.3 (VCC)
