tgtakaoka/RetroCyborg/schematics/mc6801/bionic-mc6801.kicad_pcb

## KiCad design schematics/mc6801/bionic-mc6801.kicad_pcb (2024-03-21)

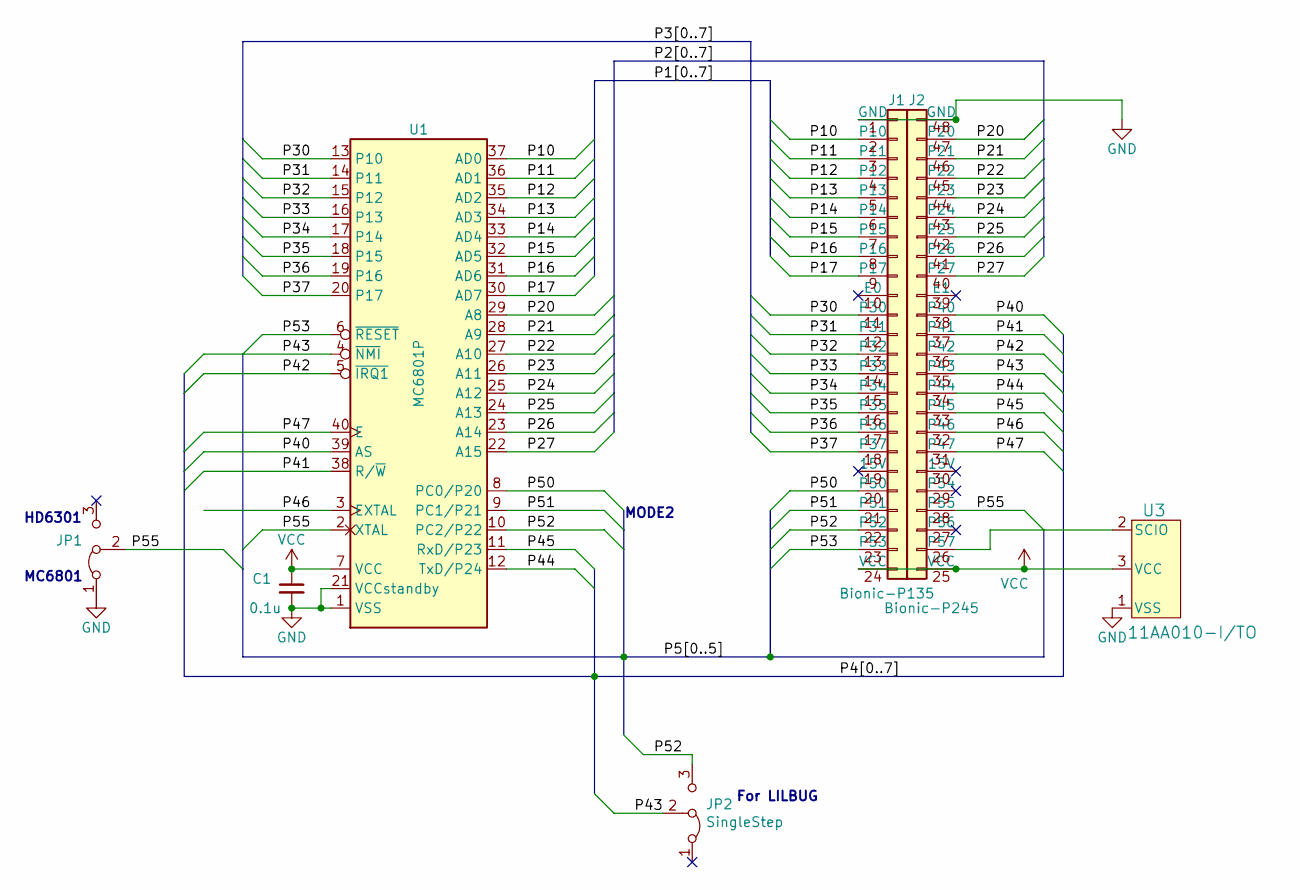
[picture p45: schematic bionic-mc6801.kicad_sch, BionicMC6801]

Parts:
C1: 0.1u; C_Disc_D3.4mm_W2.1mm_P2.50mm
J1: Bionic-P135; Bionic-P135_Vertical
J2: Bionic-P245; Bionic-P245_Vertical
JP1: MC6801; PinHeader_1x03_P2.54mm_Vertical
JP2: SingleStep; PinHeader_1x03_P2.54mm_Vertical
U1: MC6801P; DIP-40_W15.24mm
U3: 11AA010-I/TO; TO-92_MC_MCH

Connections:
/P10: J1.2 (P10), U1.37 (AD0)
/P11: J1.3 (P11), U1.36 (AD1)
/P12: J1.4 (P12), U1.35 (AD2)
/P13: J1.5 (P13), U1.34 (AD3)
/P14: J1.6 (P14), U1.33 (AD4)
/P15: J1.7 (P15), U1.32 (AD5)
/P16: J1.8 (P16), U1.31 (AD6)
/P17: J1.9 (P17), U1.30 (AD7)
/P20: J2.47 (P20), U1.29 (A8)
/P21: J2.46 (P21), U1.28 (A9)
/P22: J2.45 (P22), U1.27 (A10)
/P23: J2.44 (P23), U1.26 (A11)
/P24: J2.43 (P24), U1.25 (A12)
/P25: J2.42 (P25), U1.24 (A13)
/P26: J2.41 (P26), U1.23 (A14)
/P27: J2.40 (P27), U1.22 (A15)
/P30: J1.11 (P30), U1.13 (P10)
/P31: J1.12 (P31), U1.14 (P11)
/P32: J1.13 (P32), U1.15 (P12)
/P33: J1.14 (P33), U1.16 (P13)
/P34: J1.15 (P34), U1.17 (P14)
/P35: J1.16 (P35), U1.18 (P15)
/P36: J1.17 (P36), U1.19 (P16)
/P37: J1.18 (P37), U1.20 (P17)
/P40: J2.38 (P40), U1.39 (AS)
/P41: J2.37 (P41), U1.38 (R/~W)
/P42: J2.36 (P42), U1.5 (~IRQ1)
/P43: J2.35 (P43), JP2.2 (C), U1.4 (~NMI)
/P44: J2.34 (P44), U1.12 (TxD/P24)
/P45: J2.33 (P45), U1.11 (RxD/P23)
/P46: J2.32 (P46), U1.3 (EXTAL)
/P47: J2.31 (P47), U1.40 (E)
/P50: J1.20 (P50), U1.8 (PC0/P20)
/P51: J1.21 (P51), U1.9 (PC1/P21)
/P52: J1.22 (P52), JP2.3 (B), U1.10 (PC2/P22)
/P53: J1.23 (P53), U1.6 (~RESET)
/P55: J2.28 (P55), JP1.2 (C), U1.2 (XTAL)
GND: C1.2, J1.1 (GND), J2.48 (GND), JP1.1 (A), U1.1 (VSS), U1.21 (VCCstandby), U3.1 (VSS)
unnamed: J2.26 (P57), U3.2 (SCIO)
VCC: C1.1, J1.24 (VCC), J2.25 (VCC), U1.7 (VCC), U3.3 (VCC)

Notes on the sheet:
MODE2
For LILBUG
HD6301
MC6801

Board: 2 copper layers, 11 parts (0 on the bottom side), 40 nets, no tracks yet.

Other parts of the board:
MH1, MH2, MH3, MH4: MountingHole_3.2mm_M3
