tgtakaoka/RetroCyborg/schematics/ins8070/bionic-ins8070.kicad_pcb

## KiCad design schematics/ins8070/bionic-ins8070.kicad_pcb (2024-03-21)

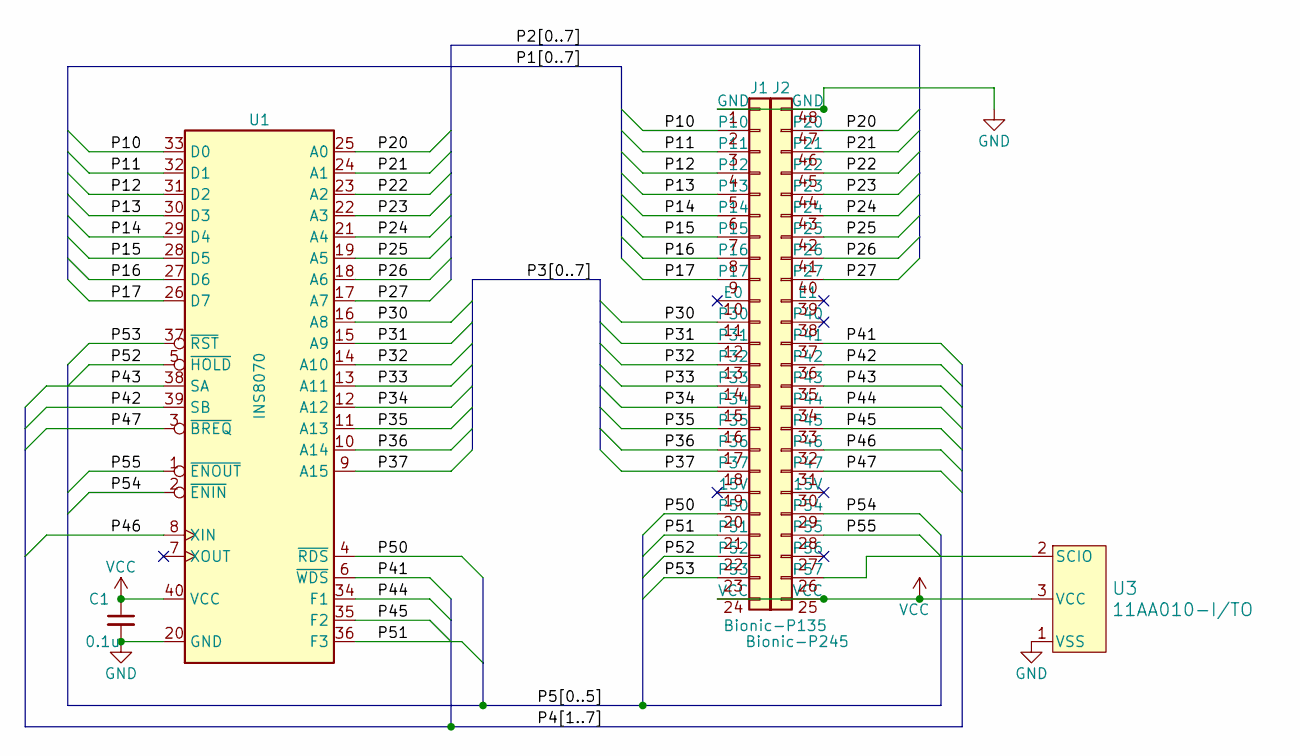
[picture p47: schematic bionic-ins8070.kicad_sch, BionicINS8070]

Parts:
C1: 0.1u; C_Disc_D3.4mm_W2.1mm_P2.50mm
J1: Bionic-P135; Bionic-P135_Vertical
J2: Bionic-P245; Bionic-P245_Vertical
U1: INS8070; DIP-40_W15.24mm
U3: 11AA010-I/TO; TO-92_MC_MCH

Connections:
/P10: J1.2 (P10), U1.33 (D0)
/P11: J1.3 (P11), U1.32 (D1)
/P12: J1.4 (P12), U1.31 (D2)
/P13: J1.5 (P13), U1.30 (D3)
/P14: J1.6 (P14), U1.29 (D4)
/P15: J1.7 (P15), U1.28 (D5)
/P16: J1.8 (P16), U1.27 (D6)
/P17: J1.9 (P17), U1.26 (D7)
/P20: J2.47 (P20), U1.25 (A0)
/P21: J2.46 (P21), U1.24 (A1)
/P22: J2.45 (P22), U1.23 (A2)
/P23: J2.44 (P23), U1.22 (A3)
/P24: J2.43 (P24), U1.21 (A4)
/P25: J2.42 (P25), U1.19 (A5)
/P26: J2.41 (P26), U1.18 (A6)
/P27: J2.40 (P27), U1.17 (A7)
/P30: J1.11 (P30), U1.16 (A8)
/P31: J1.12 (P31), U1.15 (A9)
/P32: J1.13 (P32), U1.14 (A10)
/P33: J1.14 (P33), U1.13 (A11)
/P34: J1.15 (P34), U1.12 (A12)
/P35: J1.16 (P35), U1.11 (A13)
/P36: J1.17 (P36), U1.10 (A14)
/P37: J1.18 (P37), U1.9 (A15)
/P41: J2.37 (P41), U1.6 (~WDS)
/P42: J2.36 (P42), U1.39 (SB)
/P43: J2.35 (P43), U1.38 (SA)
/P44: J2.34 (P44), U1.34 (F1)
/P45: J2.33 (P45), U1.35 (F2)
/P46: J2.32 (P46), U1.8 (XIN)
/P47: J2.31 (P47), U1.3 (~BREQ)
/P50: J1.20 (P50), U1.4 (~RDS)
/P51: J1.21 (P51), U1.36 (F3)
/P52: J1.22 (P52), U1.5 (~HOLD)
/P53: J1.23 (P53), U1.37 (~RST)
/P54: J2.29 (P54), U1.2 (~ENIN)
/P55: J2.28 (P55), U1.1 (~ENOUT)
GND: C1.2, J1.1 (GND), J2.48 (GND), U1.20 (GND), U3.1 (VSS)
unnamed: J2.26 (P57), U3.2 (SCIO)
VCC: C1.1, J1.24 (VCC), J2.25 (VCC), U1.40 (VCC), U3.3 (VCC)

Board: 2 copper layers, 9 parts (0 on the bottom side), 40 nets, no tracks yet.

Other parts of the board:
MH1, MH2, MH3, MH4: MountingHole_3.2mm_M3
