tgtakaoka/RetroCyborg/schematics/cdp1802/bionic-cdp1802.kicad_pcb

## KiCad design schematics/cdp1802/bionic-cdp1802.kicad_pcb (2024-03-21)

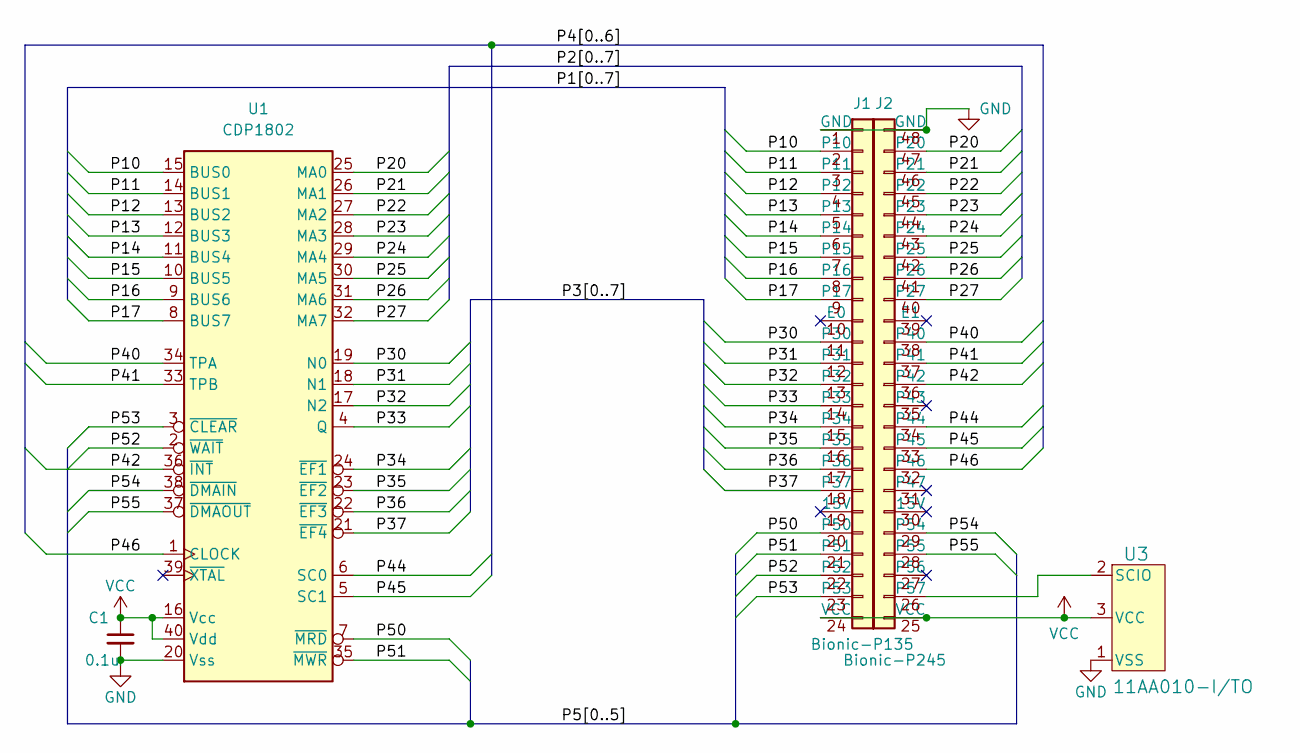
[picture p50: schematic bionic-cdp1802.kicad_sch, BionicCDP1802]

Parts:
C1: 0.1u; C_Disc_D3.4mm_W2.1mm_P2.50mm
J1: Bionic-P135; Bionic-P135_Vertical
J2: Bionic-P245; Bionic-P245_Vertical
U1: CDP1802; DIP-40_W15.24mm
U3: 11AA010-I/TO; TO-92_MC_MCH

Connections:
/P10: J1.2 (P10), U1.15 (BUS0)
/P11: J1.3 (P11), U1.14 (BUS1)
/P12: J1.4 (P12), U1.13 (BUS2)
/P13: J1.5 (P13), U1.12 (BUS3)
/P14: J1.6 (P14), U1.11 (BUS4)
/P15: J1.7 (P15), U1.10 (BUS5)
/P16: J1.8 (P16), U1.9 (BUS6)
/P17: J1.9 (P17), U1.8 (BUS7)
/P20: J2.47 (P20), U1.25 (MA0)
/P21: J2.46 (P21), U1.26 (MA1)
/P22: J2.45 (P22), U1.27 (MA2)
/P23: J2.44 (P23), U1.28 (MA3)
/P24: J2.43 (P24), U1.29 (MA4)
/P25: J2.42 (P25), U1.30 (MA5)
/P26: J2.41 (P26), U1.31 (MA6)
/P27: J2.40 (P27), U1.32 (MA7)
/P30: J1.11 (P30), U1.19 (N0)
/P31: J1.12 (P31), U1.18 (N1)
/P32: J1.13 (P32), U1.17 (N2)
/P33: J1.14 (P33), U1.4 (Q)
/P34: J1.15 (P34), U1.24 (~EF1)
/P35: J1.16 (P35), U1.23 (~EF2)
/P36: J1.17 (P36), U1.22 (~EF3)
/P37: J1.18 (P37), U1.21 (~EF4)
/P40: J2.38 (P40), U1.34 (TPA)
/P41: J2.37 (P41), U1.33 (TPB)
/P42: J2.36 (P42), U1.36 (~INT)
/P44: J2.34 (P44), U1.6 (SC0)
/P45: J2.33 (P45), U1.5 (SC1)
/P46: J2.32 (P46), U1.1 (CLOCK)
/P50: J1.20 (P50), U1.7 (~MRD)
/P51: J1.21 (P51), U1.35 (~MWR)
/P52: J1.22 (P52), U1.2 (~WAIT)
/P53: J1.23 (P53), U1.3 (~CLEAR)
/P54: J2.29 (P54), U1.38 (~DMAIN)
/P55: J2.28 (P55), U1.37 (~DMAOUT)
GND: C1.2, J1.1 (GND), J2.48 (GND), U1.20 (Vss), U3.1 (VSS)
unnamed: J2.26 (P57), U3.2 (SCIO)
VCC: C1.1, J1.24 (VCC), J2.25 (VCC), U1.16 (Vcc), U1.40 (Vdd), U3.3 (VCC)

Board: 2 copper layers, 9 parts (0 on the bottom side), 39 nets, no tracks yet.

Other parts of the board:
MH1, MH2, MH3, MH4: MountingHole_3.2mm_M3
