tgtakaoka/RetroCyborg/schematics/mc68008/bionic-mc68008.kicad_pcb

## KiCad design schematics/mc68008/bionic-mc68008.kicad_pcb (2024-03-21)

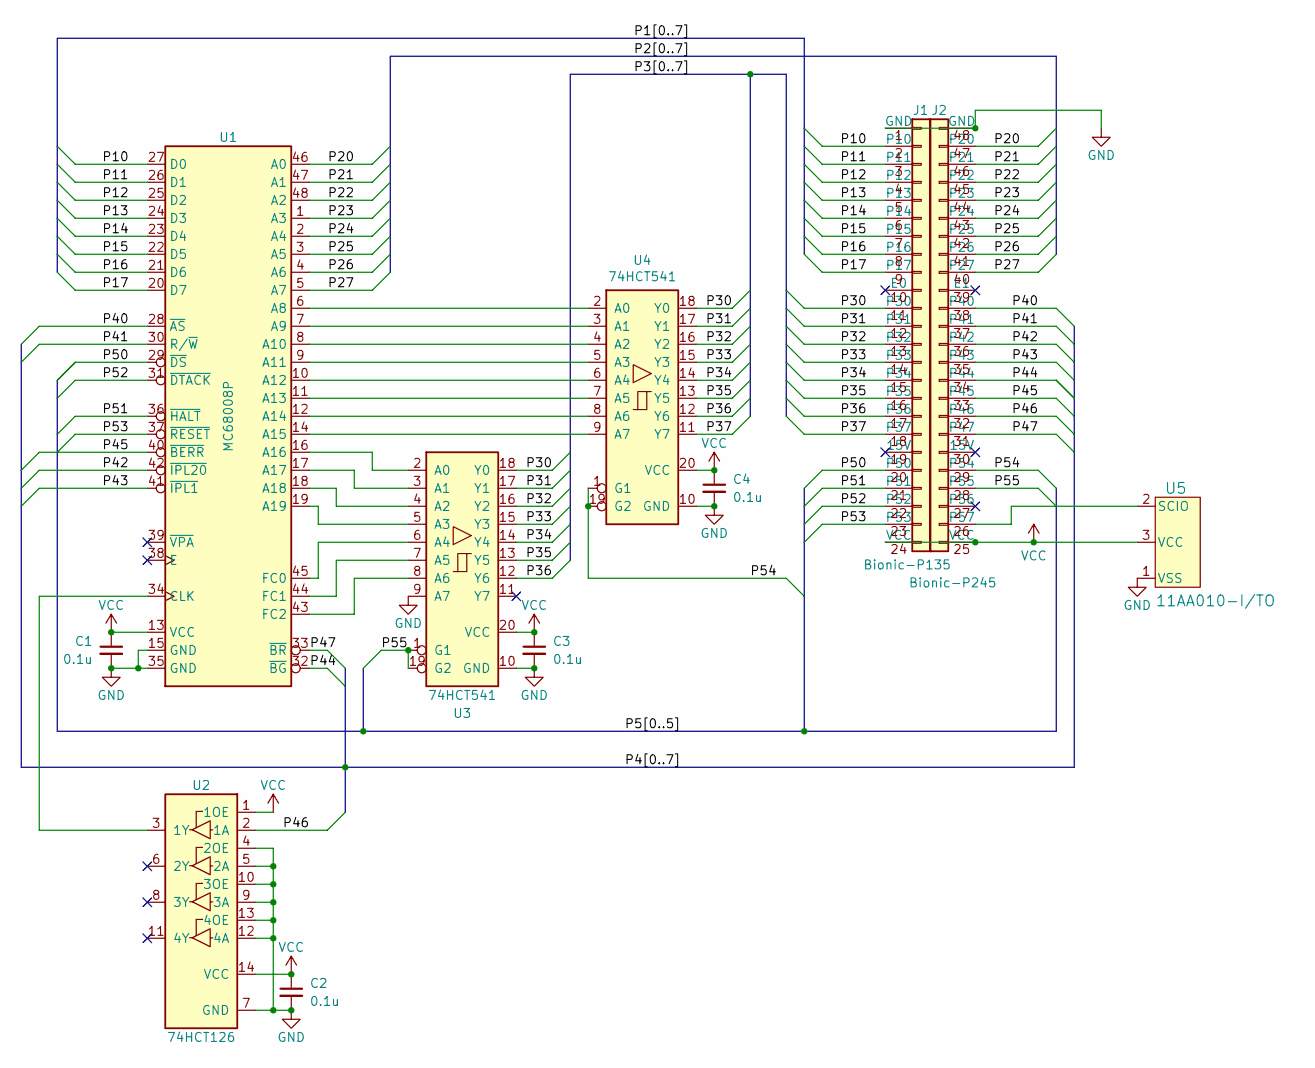
[picture p54: schematic bionic-mc68008.kicad_sch, BionicMC68008]

Parts:
C1, C2, C3, C4: 0.1u; C_Disc_D3.4mm_W2.1mm_P2.50mm
J1: Bionic-P135; Bionic-P135_Vertical
J2: Bionic-P245; Bionic-P245_Vertical
U1: MC68008P; DIP-48_W15.24mm
U2: 74HCT126; DIP-14_W7.62mm
U3, U4: 74HCT541; DIP-20_W7.62mm
U5: 11AA010-I/TO; TO-92_MC_MCH

Connections:
/P10: J1.2 (P10), U1.27 (D0); also elsewhere on the board
/P11: J1.3 (P11), U1.26 (D1); also elsewhere on the board
/P12: J1.4 (P12), U1.25 (D2); also elsewhere on the board
/P13: J1.5 (P13), U1.24 (D3); also elsewhere on the board
/P14: J1.6 (P14), U1.23 (D4); also elsewhere on the board
/P15: J1.7 (P15), U1.22 (D5); also elsewhere on the board
/P16: J1.8 (P16), U1.21 (D6); also elsewhere on the board
/P17: J1.9 (P17), U1.20 (D7); also elsewhere on the board
/P20: J1.47 (P20), J2.47 (P20), U1.46 (A0)
/P21: J1.46 (P21), J2.46 (P21), U1.47 (A1)
/P22: J1.45 (P22), J2.45 (P22), U1.48 (A2)
/P23: J1.44 (P23), J2.44 (P23), U1.1 (A3)
/P24: J1.43 (P24), J2.43 (P24), U1.2 (A4)
/P25: J1.42 (P25), J2.42 (P25), U1.3 (A5)
/P26: J1.41 (P26), J2.41 (P26), U1.4 (A6)
/P27: J1.40 (P27), J2.40 (P27), U1.5 (A7)
/P30: J1.11 (P30), U3.18 (Y0), U4.18 (Y0); also elsewhere on the board
/P31: J1.12 (P31), U3.17 (Y1), U4.17 (Y1); also elsewhere on the board
/P32: J1.13 (P32), U3.16 (Y2), U4.16 (Y2); also elsewhere on the board
/P33: J1.14 (P33), U3.15 (Y3), U4.15 (Y3); also elsewhere on the board
/P34: J1.15 (P34), U3.14 (Y4), U4.14 (Y4); also elsewhere on the board
/P35: J1.16 (P35), U3.13 (Y5), U4.13 (Y5); also elsewhere on the board
/P36: J1.17 (P36), U3.12 (Y6), U4.12 (Y6); also elsewhere on the board
/P37: J1.18 (P37), U4.11 (Y7); also elsewhere on the board
/P40: J1.38 (P40), J2.38 (P40), U1.28 (~AS)
/P41: J1.37 (P41), J2.37 (P41), U1.30 (R/~W)
/P42: J1.36 (P42), J2.36 (P42), U1.42 (~IPL20)
/P43: J1.35 (P43), J2.35 (P43), U1.41 (~IPL1)
/P44: J1.34 (P44), J2.34 (P44), U1.32 (~BG)
/P45: J1.33 (P45), J2.33 (P45), U1.40 (~BERR)
/P46: J1.32 (P46), J2.32 (P46), U2.2 (1A)
/P47: J1.31 (P47), J2.31 (P47), U1.33 (~BR)
/P50: J1.20 (P50), U1.29 (~DS); also elsewhere on the board
/P51: J1.21 (P51), U1.36 (~HALT); also elsewhere on the board
/P52: J1.22 (P52), U1.31 (~DTACK); also elsewhere on the board
/P53: J1.23 (P53), U1.37 (~RESET); also elsewhere on the board
/P54: J1.29 (P54), J2.29 (P54), U4.1 (G1), U4.19 (G2)
/P55: J1.28 (P55), J2.28 (P55), U3.1 (G1), U3.19 (G2)
GND: C1.2, C2.2, C3.2, C4.2, J1.1 (GND), J1.48 (GND), J2.48 (GND), U1.15 (GND), U1.35 (GND), U2.4 (2OE), U2.5 (2A), U2.7 (GND), U2.9 (3A), U2.10 (3OE), U2.12 (4A), U2.13 (4OE), U3.9 (A7), U3.10 (GND), U4.10 (GND), U5.1 (VSS); also elsewhere on the board
unnamed: J2.26 (P57), U5.2 (SCIO)
unnamed: U1.6 (A8), U4.2 (A0)
unnamed: U1.7 (A9), U4.3 (A1)
unnamed: U1.8 (A10), U4.4 (A2)
unnamed: U1.9 (A11), U4.5 (A3)
unnamed: U1.10 (A12), U4.6 (A4)
unnamed: U1.11 (A13), U4.7 (A5)
unnamed: U1.12 (A14), U4.8 (A6)
unnamed: U1.14 (A15), U4.9 (A7)
unnamed: U1.16 (A16), U3.2 (A0)
unnamed: U1.17 (A17), U3.3 (A1)
unnamed: U1.18 (A18), U3.4 (A2)
unnamed: U1.19 (A19), U3.5 (A3)
unnamed: U1.34 (CLK), U2.3 (1Y)
unnamed: U1.45 (FC0), U3.6 (A4)
unnamed: U1.44 (FC1), U3.7 (A5)
unnamed: U1.43 (FC2), U3.8 (A6)
VCC: C1.1, C2.1, C3.1, C4.1, J1.24 (VCC), J1.25 (VCC), J2.25 (VCC), U1.13 (VCC), U2.1 (1OE), U2.14 (VCC), U3.20 (VCC), U4.20 (VCC), U5.3 (VCC); also elsewhere on the board

Board: 2 copper layers, 16 parts (0 on the bottom side), 57 nets, no tracks yet.

Other parts of the board:
J1#2: Bionic-P135; Bionic-P135_Vertical
MH1, MH2, MH3, MH4: MountingHole_3.2mm_M3

Their connections:
/P10: J1#2.2 (P10); also elsewhere on the board
/P11: J1#2.3 (P11); also elsewhere on the board
/P12: J1#2.4 (P12); also elsewhere on the board
/P13: J1#2.5 (P13); also elsewhere on the board
/P14: J1#2.6 (P14); also elsewhere on the board
/P15: J1#2.7 (P15); also elsewhere on the board
/P16: J1#2.8 (P16); also elsewhere on the board
/P17: J1#2.9 (P17); also elsewhere on the board
/P30: J1#2.11 (P30); also elsewhere on the board
/P31: J1#2.12 (P31); also elsewhere on the board
/P32: J1#2.13 (P32); also elsewhere on the board
/P33: J1#2.14 (P33); also elsewhere on the board
/P34: J1#2.15 (P34); also elsewhere on the board
/P35: J1#2.16 (P35); also elsewhere on the board
/P36: J1#2.17 (P36); also elsewhere on the board
/P37: J1#2.18 (P37); also elsewhere on the board
/P50: J1#2.20 (P50); also elsewhere on the board
/P51: J1#2.21 (P51); also elsewhere on the board
/P52: J1#2.22 (P52); also elsewhere on the board
/P53: J1#2.23 (P53); also elsewhere on the board
GND: J1#2.1 (GND); also elsewhere on the board
VCC: J1#2.24 (VCC); also elsewhere on the board
