tgtakaoka/RetroCyborg/schematics/tms9981/bionic-tms9981.kicad_pcb

## KiCad design schematics/tms9981/bionic-tms9981.kicad_pcb (2024-03-21)

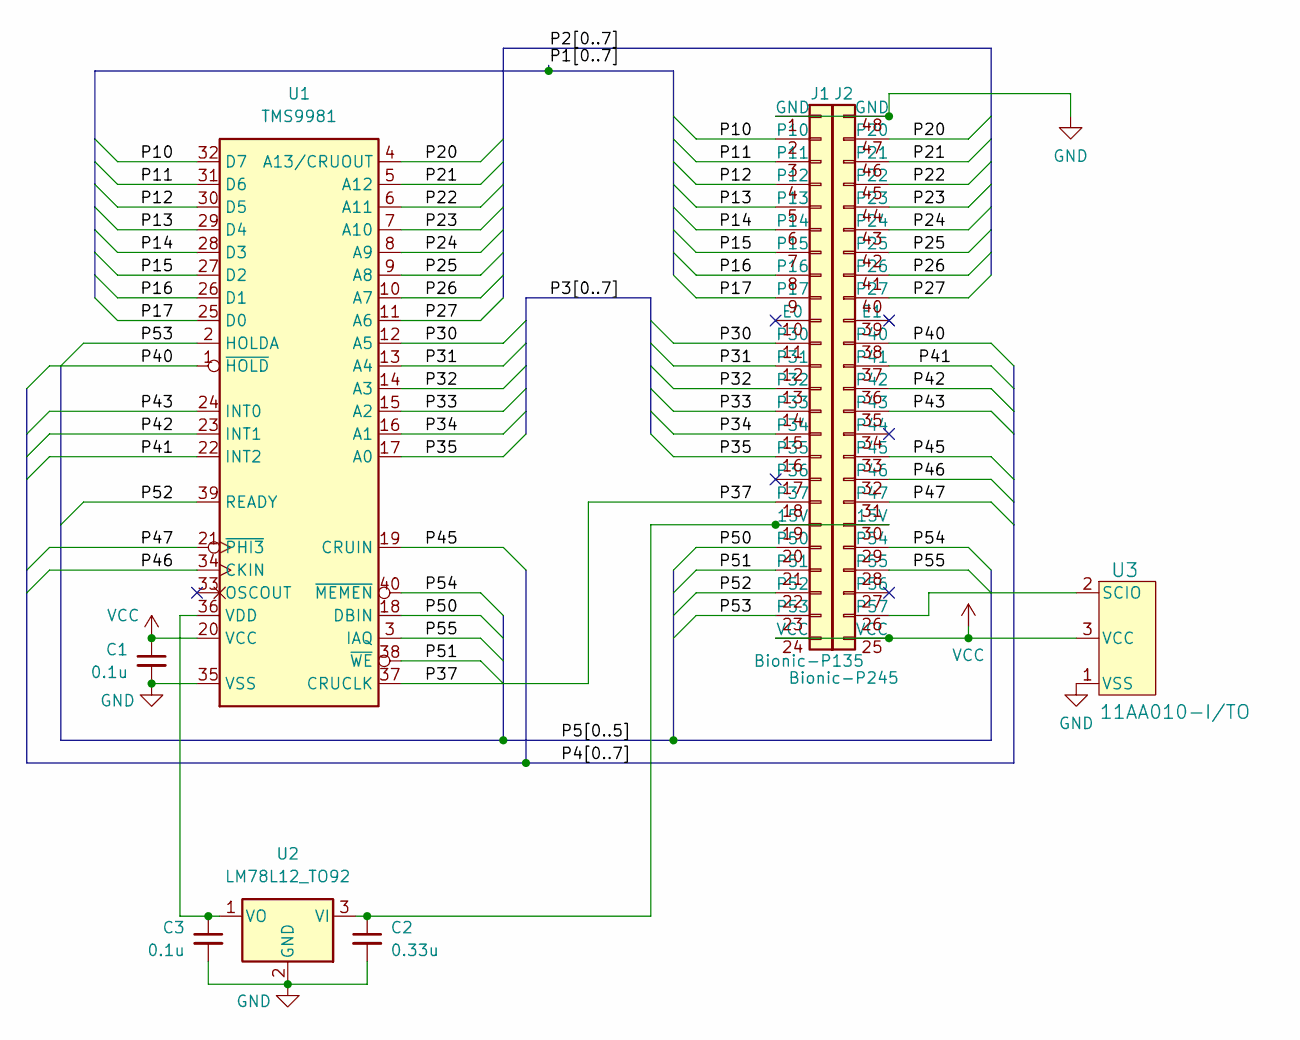
[picture p55: schematic bionic-tms9981.kicad_sch, BionicTMS9981]

Parts:
C1, C3: 0.1u; C_Disc_D3.4mm_W2.1mm_P2.50mm
C2: 0.33u; C_Disc_D3.4mm_W2.1mm_P2.50mm
J1: Bionic-P135; Bionic-P135_Vertical
J2: Bionic-P245; Bionic-P245_Vertical
U1: TMS9981; DIP-40_W15.24mm
U2: LM78L12_TO92; TO-92_Inline
U3: 11AA010-I/TO; TO-92_MC_MCH

Connections:
/P10: J1.2 (P10), U1.32 (D7); also elsewhere on the board
/P11: J1.3 (P11), U1.31 (D6); also elsewhere on the board
/P12: J1.4 (P12), U1.30 (D5); also elsewhere on the board
/P13: J1.5 (P13), U1.29 (D4); also elsewhere on the board
/P14: J1.6 (P14), U1.28 (D3); also elsewhere on the board
/P15: J1.7 (P15), U1.27 (D2); also elsewhere on the board
/P16: J1.8 (P16), U1.26 (D1); also elsewhere on the board
/P17: J1.9 (P17), U1.25 (D0); also elsewhere on the board
/P20: J1.47 (P20), J2.47 (P20), U1.4 (A13/CRUOUT)
/P21: J1.46 (P21), J2.46 (P21), U1.5 (A12)
/P22: J1.45 (P22), J2.45 (P22), U1.6 (A11)
/P23: J1.44 (P23), J2.44 (P23), U1.7 (A10)
/P24: J1.43 (P24), J2.43 (P24), U1.8 (A9)
/P25: J1.42 (P25), J2.42 (P25), U1.9 (A8)
/P26: J1.41 (P26), J2.41 (P26), U1.10 (A7)
/P27: J1.40 (P27), J2.40 (P27), U1.11 (A6)
/P30: J1.11 (P30), U1.12 (A5); also elsewhere on the board
/P31: J1.12 (P31), U1.13 (A4); also elsewhere on the board
/P32: J1.13 (P32), U1.14 (A3); also elsewhere on the board
/P33: J1.14 (P33), U1.15 (A2); also elsewhere on the board
/P34: J1.15 (P34), U1.16 (A1); also elsewhere on the board
/P35: J1.16 (P35), U1.17 (A0); also elsewhere on the board
/P37: J1.18 (P37), U1.37 (CRUCLK); also elsewhere on the board
/P40: J1.38 (P40), J2.38 (P40), U1.1 (~HOLD)
/P41: J1.37 (P41), J2.37 (P41), U1.22 (INT2)
/P42: J1.36 (P42), J2.36 (P42), U1.23 (INT1)
/P43: J1.35 (P43), J2.35 (P43), U1.24 (INT0)
/P45: J1.33 (P45), J2.33 (P45), U1.19 (CRUIN)
/P46: J1.32 (P46), J2.32 (P46), U1.34 (CKIN)
/P47: J1.31 (P47), J2.31 (P47), U1.21 (~PHI3)
/P50: J1.20 (P50), U1.18 (DBIN); also elsewhere on the board
/P51: J1.21 (P51), U1.38 (~WE); also elsewhere on the board
/P52: J1.22 (P52), U1.39 (READY); also elsewhere on the board
/P53: J1.23 (P53), U1.2 (HOLDA); also elsewhere on the board
/P54: J1.29 (P54), J2.29 (P54), U1.40 (~MEMEN)
/P55: J1.28 (P55), J2.28 (P55), U1.3 (IAQ)
GND: C1.2, C2.2, C3.2, J1.1 (GND), J1.48 (GND), J2.48 (GND), U1.35 (VSS), U2.2 (GND), U3.1 (VSS); also elsewhere on the board
unnamed: J2.26 (P57), U3.2 (SCIO)
unnamed: C3.1, U1.36 (VDD), U2.1 (VO)
VCC: C1.1, J1.24 (VCC), J1.25 (VCC), J2.25 (VCC), U1.20 (VCC), U3.3 (VCC); also elsewhere on the board

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
Board: 2 copper layers, 13 parts (0 on the bottom side), 42 nets, no tracks yet.

Other parts of the board:
J1#2: Bionic-P135; Bionic-P135_Vertical
MH1, MH2, MH3, MH4: MountingHole_3.2mm_M3

Their connections:
/P10: J1#2.2 (P10); also elsewhere on the board
/P11: J1#2.3 (P11); also elsewhere on the board
/P12: J1#2.4 (P12); also elsewhere on the board
/P13: J1#2.5 (P13); also elsewhere on the board
/P14: J1#2.6 (P14); also elsewhere on the board
/P15: J1#2.7 (P15); also elsewhere on the board
/P16: J1#2.8 (P16); also elsewhere on the board
/P17: J1#2.9 (P17); also elsewhere on the board
/P30: J1#2.11 (P30); also elsewhere on the board
/P31: J1#2.12 (P31); also elsewhere on the board
/P32: J1#2.13 (P32); also elsewhere on the board
/P33: J1#2.14 (P33); also elsewhere on the board
/P34: J1#2.15 (P34); also elsewhere on the board
/P35: J1#2.16 (P35); also elsewhere on the board
/P37: J1#2.18 (P37); also elsewhere on the board
/P50: J1#2.20 (P50); also elsewhere on the board
/P51: J1#2.21 (P51); also elsewhere on the board
/P52: J1#2.22 (P52); also elsewhere on the board
/P53: J1#2.23 (P53); also elsewhere on the board
GND: J1#2.1 (GND); also elsewhere on the board
VCC: J1#2.24 (VCC); also elsewhere on the board
