tgtakaoka/RetroCyborg/schematics/ns32016/bionic-ns32016.kicad_pcb

## KiCad design schematics/ns32016/bionic-ns32016.kicad_pcb (2024-03-21)

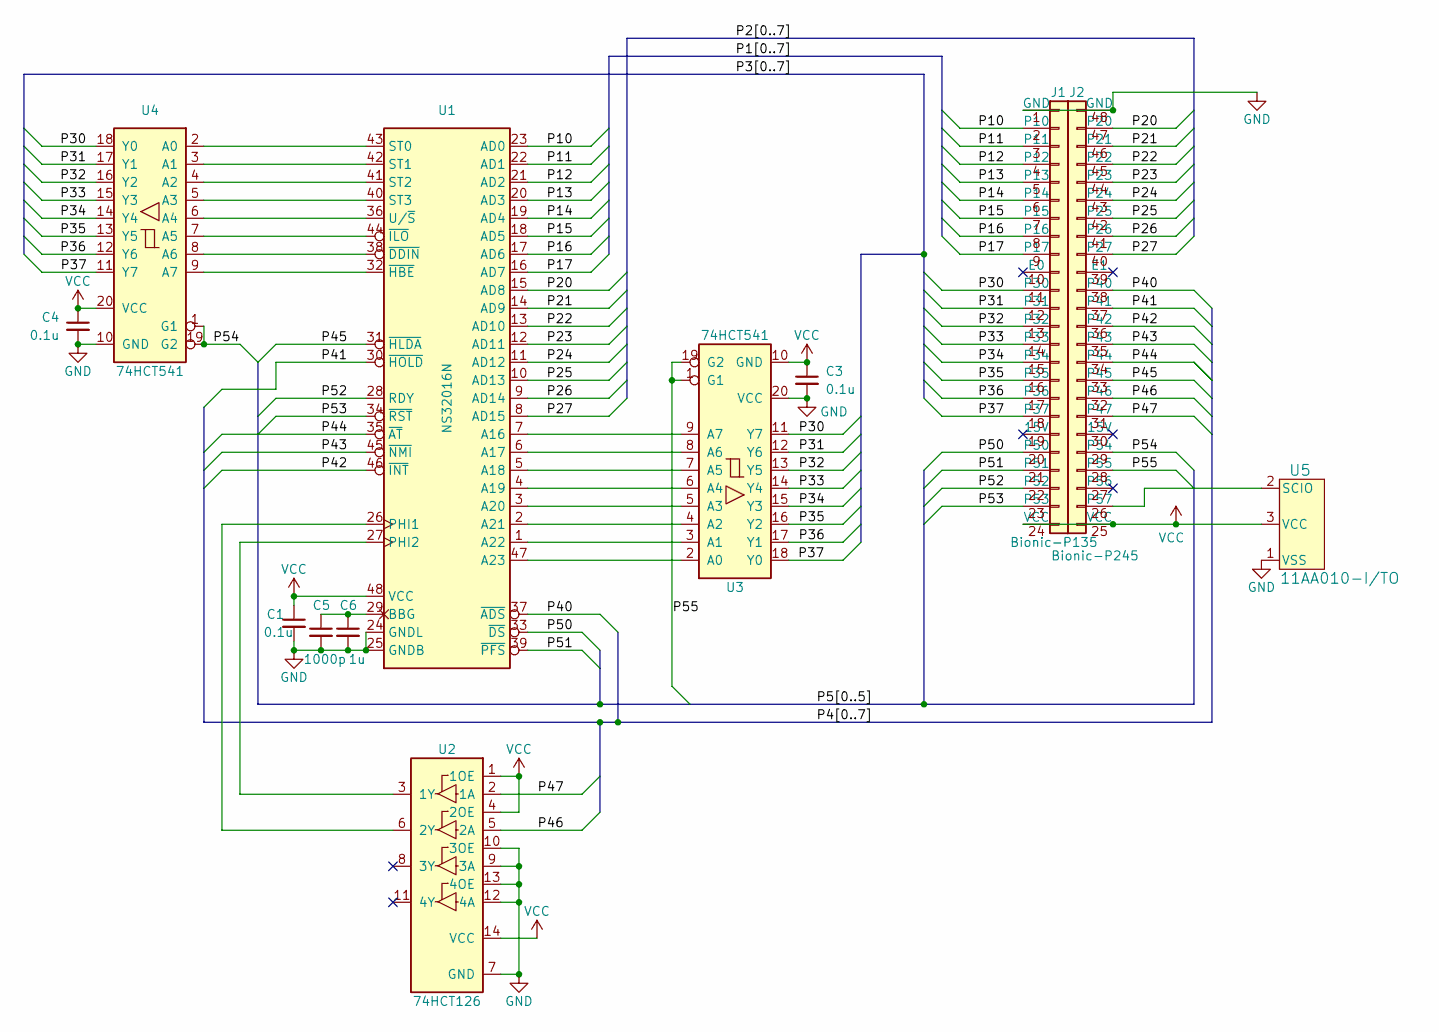
[picture p56: schematic bionic-ns32016.kicad_sch, BionicNS32016]

Parts:
C1, C3, C4: 0.1u; C_Disc_D3.4mm_W2.1mm_P2.50mm
C5: 1000p; C_Disc_D3.4mm_W2.1mm_P2.50mm
C6: 1u; C_Disc_D3.4mm_W2.1mm_P2.50mm
J1: Bionic-P135; Bionic-P135_Vertical
J2: Bionic-P245; Bionic-P245_Vertical
U1: NS32016N; DIP-48_W15.24mm
U2: 74HCT126; DIP-14_W7.62mm
U3, U4: 74HCT541; DIP-20_W7.62mm
U5: 11AA010-I/TO; TO-92_MC_MCH

Connections:
/P10: J1.2 (P10), U1.23 (AD0)
/P11: J1.3 (P11), U1.22 (AD1)
/P12: J1.4 (P12), U1.21 (AD2)
/P13: J1.5 (P13), U1.20 (AD3)
/P14: J1.6 (P14), U1.19 (AD4)
/P15: J1.7 (P15), U1.18 (AD5)
/P16: J1.8 (P16), U1.17 (AD6)
/P17: J1.9 (P17), U1.16 (AD7)
/P20: J2.47 (P20), U1.15 (AD8)
/P21: J2.46 (P21), U1.14 (AD9)
/P22: J2.45 (P22), U1.13 (AD10)
/P23: J2.44 (P23), U1.12 (AD11)
/P24: J2.43 (P24), U1.11 (AD12)
/P25: J2.42 (P25), U1.10 (AD13)
/P26: J2.41 (P26), U1.9 (AD14)
/P27: J2.40 (P27), U1.8 (AD15)
/P30: J1.11 (P30), U3.11 (Y7), U4.18 (Y0)
/P31: J1.12 (P31), U3.12 (Y6), U4.17 (Y1)
/P32: J1.13 (P32), U3.13 (Y5), U4.16 (Y2)
/P33: J1.14 (P33), U3.14 (Y4), U4.15 (Y3)
/P34: J1.15 (P34), U3.15 (Y3), U4.14 (Y4)
/P35: J1.16 (P35), U3.16 (Y2), U4.13 (Y5)
/P36: J1.17 (P36), U3.17 (Y1), U4.12 (Y6)
/P37: J1.18 (P37), U3.18 (Y0), U4.11 (Y7)
/P40: J2.38 (P40), U1.37 (~ADS)
/P41: J2.37 (P41), U1.30 (~HOLD)
/P42: J2.36 (P42), U1.46 (~INT)
/P43: J2.35 (P43), U1.45 (~NMI)
/P44: J2.34 (P44), U1.35 (~AT)
/P45: J2.33 (P45), U1.31 (~HLDA)
/P46: J2.32 (P46), U2.5 (2A)
/P47: J2.31 (P47), U2.2 (1A)
/P50: J1.20 (P50), U1.33 (~DS)
/P51: J1.21 (P51), U1.39 (~PFS)
/P52: J1.22 (P52), U1.28 (RDY)
/P53: J1.23 (P53), U1.34 (~RST)
/P54: J2.29 (P54), U4.1 (G1), U4.19 (G2)
/P55: J2.28 (P55), U3.1 (G1), U3.19 (G2)
GND: C1.2, C3.2, C4.2, C5.2, C6.2, J1.1 (GND), J2.48 (GND), U1.24 (GNDL), U1.25 (GNDB), U2.7 (GND), U2.9 (3A), U2.10 (3OE), U2.12 (4A), U2.13 (4OE), U3.20 (VCC), U4.10 (GND), U5.1 (VSS); also elsewhere on the board
unnamed: J2.26 (P57), U5.2 (SCIO)
unnamed: U1.7 (A16), U3.9 (A7)
unnamed: U1.6 (A17), U3.8 (A6)
unnamed: U1.5 (A18), U3.7 (A5)
unnamed: U1.4 (A19), U3.6 (A4)
unnamed: U1.3 (A20), U3.5 (A3)
unnamed: U1.2 (A21), U3.4 (A2)
unnamed: U1.1 (A22), U3.3 (A1)
unnamed: U1.47 (A23), U3.2 (A0)
unnamed: C5.1, C6.1, U1.29 (BBG)
unnamed: U1.26 (PHI1), U2.6 (2Y)
unnamed: U1.27 (PHI2), U2.3 (1Y)
unnamed: U1.43 (ST0), U4.2 (A0)
unnamed: U1.42 (ST1), U4.3 (A1)
unnamed: U1.41 (ST2), U4.4 (A2)
unnamed: U1.40 (ST3), U4.5 (A3)
unnamed: U1.36 (U/~S), U4.6 (A4)
unnamed: U1.38 (~DDIN), U4.8 (A6)
unnamed: U1.32 (~HBE), U4.9 (A7)
unnamed: U1.44 (~ILO), U4.7 (A5)
VCC: C1.1, C3.1, C4.1, J1.24 (VCC), J2.25 (VCC), U1.48 (VCC), U2.1 (1OE), U2.4 (2OE), U2.14 (VCC), U3.10 (GND), U4.20 (VCC), U5.3 (VCC); also elsewhere on the board

Board: 2 copper layers, 17 parts (0 on the bottom side), 60 nets, no tracks yet.

Other parts of the board:
C2: 0.1u; C_Disc_D3.4mm_W2.1mm_P2.50mm
MH1, MH2, MH3, MH4: MountingHole_3.2mm_M3

Their connections:
GND: C2.2; also elsewhere on the board
VCC: C2.1; also elsewhere on the board
