tgtakaoka/RetroCyborg/schematics/z8001/bionic-z8001.kicad_pcb

## KiCad design schematics/z8001/bionic-z8001.kicad_pcb (2024-03-21)

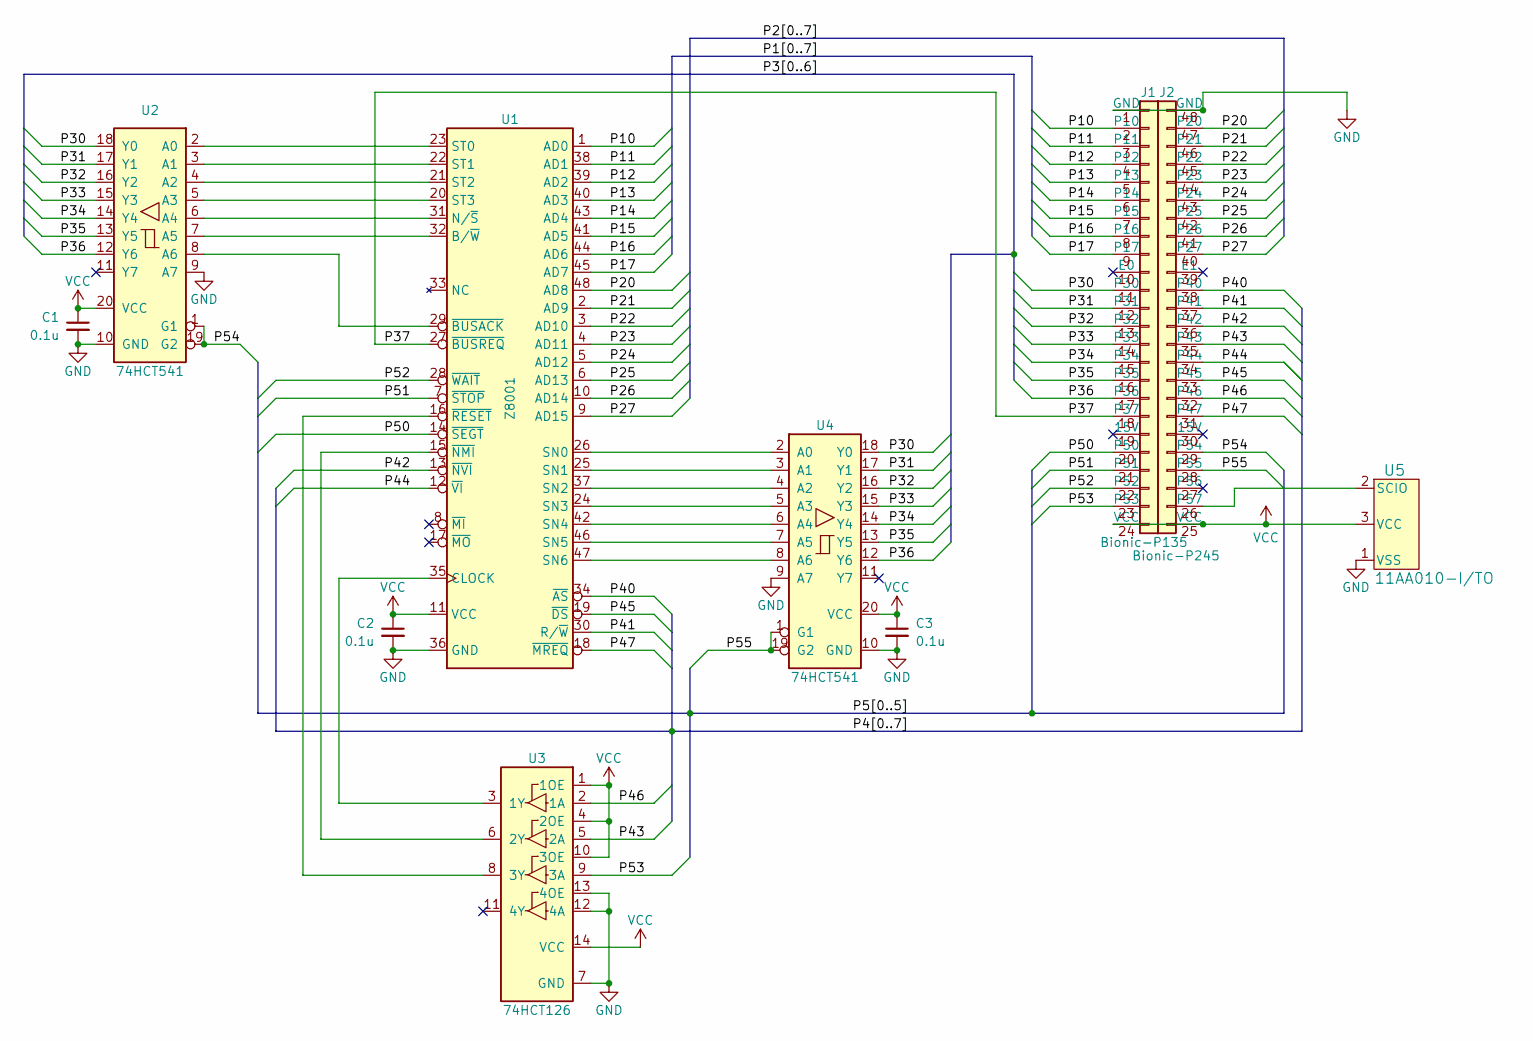
[picture p57: schematic bionic-z8001.kicad_sch, BionicZ8001]

Parts:
C1, C2, C3: 0.1u; C_Disc_D3.4mm_W2.1mm_P2.50mm
J1: Bionic-P135; Bionic-P135_Vertical
J2: Bionic-P245; Bionic-P245_Vertical
U1: Z8001; DIP-48_W15.24mm
U2, U4: 74HCT541; DIP-20_W7.62mm
U3: 74HCT126; DIP-14_W7.62mm
U5: 11AA010-I/TO; TO-92_MC_MCH

Connections:
/P10: J1.2 (P10), U1.1 (AD0)
/P11: J1.3 (P11), U1.38 (AD1)
/P12: J1.4 (P12), U1.39 (AD2)
/P13: J1.5 (P13), U1.40 (AD3)
/P14: J1.6 (P14), U1.43 (AD4)
/P15: J1.7 (P15), U1.41 (AD5)
/P16: J1.8 (P16), U1.44 (AD6)
/P17: J1.9 (P17), U1.45 (AD7)
/P20: J2.47 (P20), U1.48 (AD8)
/P21: J2.46 (P21), U1.2 (AD9)
/P22: J2.45 (P22), U1.3 (AD10)
/P23: J2.44 (P23), U1.4 (AD11)
/P24: J2.43 (P24), U1.5 (AD12)
/P25: J2.42 (P25), U1.6 (AD13)
/P26: J2.41 (P26), U1.10 (AD14)
/P27: J2.40 (P27), U1.9 (AD15)
/P30: J1.11 (P30), U2.18 (Y0), U4.18 (Y0)
/P31: J1.12 (P31), U2.17 (Y1), U4.17 (Y1)
/P32: J1.13 (P32), U2.16 (Y2), U4.16 (Y2)
/P33: J1.14 (P33), U2.15 (Y3), U4.15 (Y3)
/P34: J1.15 (P34), U2.14 (Y4), U4.14 (Y4)
/P35: J1.16 (P35), U2.13 (Y5), U4.13 (Y5)
/P36: J1.17 (P36), U2.12 (Y6), U4.12 (Y6)
/P37: J1.18 (P37), U1.27 (~BUSREQ)
/P40: J2.38 (P40), U1.34 (~AS)
/P41: J2.37 (P41), U1.30 (R/~W)
/P42: J2.36 (P42), U1.13 (~NVI)
/P43: J2.35 (P43), U3.5 (2A)
/P44: J2.34 (P44), U1.12 (~VI)
/P45: J2.33 (P45), U1.19 (~DS)
/P46: J2.32 (P46), U3.2 (1A)
/P47: J2.31 (P47), U1.18 (~MREQ)
/P50: J1.20 (P50), U1.14 (~SEGT)
/P51: J1.21 (P51), U1.7 (~STOP)
/P52: J1.22 (P52), U1.28 (~WAIT)
/P53: J1.23 (P53), U3.9 (3A)
/P54: J2.29 (P54), U2.1 (G1), U2.19 (G2)
/P55: J2.28 (P55), U4.1 (G1), U4.19 (G2)
GND: C1.2, C2.2, C3.2, J1.1 (GND), J2.48 (GND), U1.36 (GND), U2.9 (A7), U2.10 (GND), U3.7 (GND), U3.12 (4A), U3.13 (4OE), U4.9 (A7), U4.10 (GND), U5.1 (VSS)
unnamed: J2.26 (P57), U5.2 (SCIO)
unnamed: U1.32 (B/~W), U2.7 (A5)
unnamed: U1.35 (CLOCK), U3.3 (1Y)
unnamed: U1.31 (N/~S), U2.6 (A4)
unnamed: U1.26 (SN0), U4.2 (A0)
unnamed: U1.25 (SN1), U4.3 (A1)
unnamed: U1.37 (SN2), U4.4 (A2)
unnamed: U1.24 (SN3), U4.5 (A3)
unnamed: U1.42 (SN4), U4.6 (A4)
unnamed: U1.46 (SN5), U4.7 (A5)
unnamed: U1.47 (SN6), U4.8 (A6)
unnamed: U1.23 (ST0), U2.2 (A0)
unnamed: U1.22 (ST1), U2.3 (A1)
unnamed: U1.21 (ST2), U2.4 (A2)
unnamed: U1.20 (ST3), U2.5 (A3)
unnamed: U1.29 (~BUSACK), U2.8 (A6)
unnamed: U1.15 (~NMI), U3.6 (2Y)
unnamed: U1.16 (~RESET), U3.8 (3Y)
VCC: C1.1, C2.1, C3.1, J1.24 (VCC), J2.25 (VCC), U1.11 (VCC), U2.20 (VCC), U3.1 (1OE), U3.4 (2OE), U3.10 (3OE), U3.14 (VCC), U4.20 (VCC), U5.3 (VCC)

Board: 2 copper layers, 14 parts (0 on the bottom side), 58 nets, no tracks yet.

Other parts of the board:
MH1, MH2, MH3, MH4: MountingHole_3.2mm_M3
