tgtakaoka/RetroCyborg/BionicBase/schematic-teensy41/Prototype1.kicad_sch

## KiCad design BionicBase/schematic-teensy41/Prototype1.kicad_sch (2023-12-22)

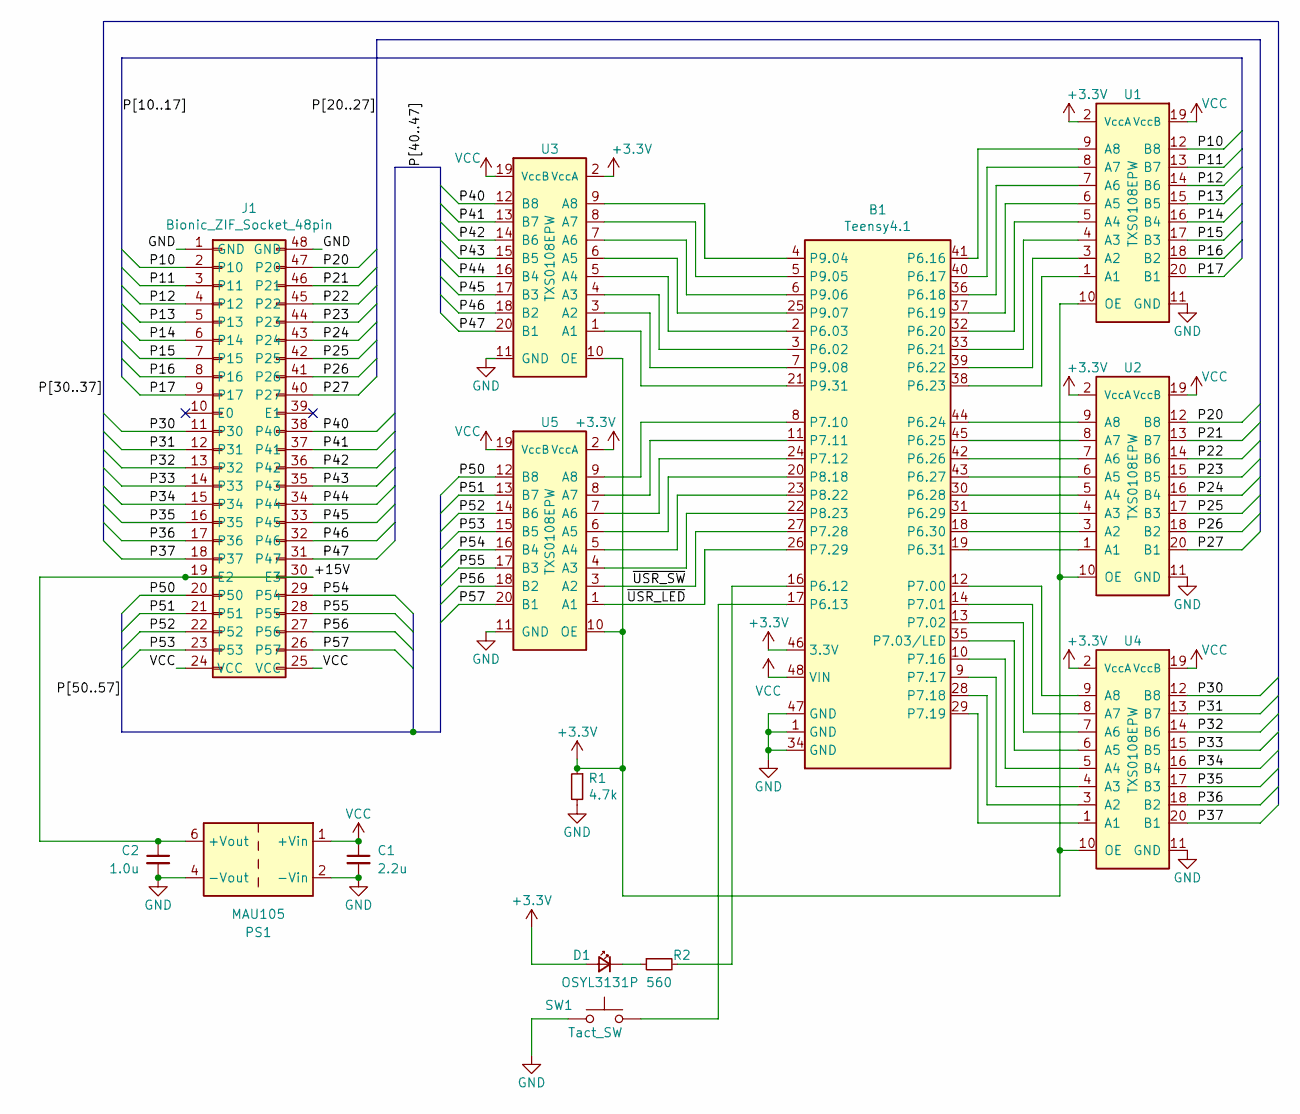
[picture p59: schematic Prototype1.kicad_sch]

Parts:
B1: Teensy4.1; DIP-48_W15.24mm_Socket
C1: 2.2u; C_Disc_D3.4mm_W2.1mm_P2.50mm
C2: 1.0u; C_Disc_D3.4mm_W2.1mm_P2.50mm
D1: OSYL3131P; LED_D3.0mm
J1: Bionic_ZIF_Socket_48pin; Aries-57-DIP48
PS1: MAU105; Converter_DCDC_Minmax_MAU100_THT
R1: 4.7k; R_Axial_DIN0204_L3.6mm_D1.6mm_P5.08mm_Horizontal
R2: 560; R_Axial_DIN0204_L3.6mm_D1.6mm_P5.08mm_Horizontal
SW1: Tact_SW; Tact_SW_6x6mm
U1, U2, U3, U4, U5: TXS0108EPW; TSSOP-20_4.4x6.5mm_P0.65mm

Connections:
+3.3V: B1.15 (3.3V), B1.46 (3.3V), D1.2 (A), R1.1, U1.2 (VccA), U1.10 (OE), U2.2 (VccA), U2.10 (OE), U3.2 (VccA), U3.10 (OE), U4.2 (VccA), U4.10 (OE), U5.2 (VccA), U5.10 (OE)
+15V: C2.1, J1.19 (E2), J1.30 (E3), PS1.6 (+Vout)
GND: B1.1 (GND), B1.34 (GND), B1.47 (GND), C1.2, C2.2, J1.1 (GND), J1.48 (GND), PS1.2 (-Vin), PS1.4 (-Vout), R1.2, SW1.2, U1.11 (GND), U2.11 (GND), U3.11 (GND), U4.11 (GND), U5.11 (GND)
unnamed: B1.2 (P6.03), U3.5 (A4)
unnamed: B1.3 (P6.02), U3.4 (A3)
unnamed: B1.4 (P9.04), U3.9 (A8)
unnamed: B1.5 (P9.05), U3.8 (A7)
unnamed: B1.6 (P9.06), U3.7 (A6)
unnamed: B1.7 (P9.08), U3.3 (A2)
unnamed: B1.8 (P7.10), U5.9 (A8)
unnamed: B1.9 (P7.17), U4.4 (A3)
unnamed: B1.10 (P7.16), U4.5 (A4)
unnamed: B1.11 (P7.11), U5.8 (A7)
unnamed: B1.12 (P7.00), U4.9 (A8)
unnamed: B1.13 (P7.02), U4.7 (A6)
unnamed: B1.14 (P7.01), U4.8 (A7)
unnamed: B1.16 (P6.12), R2.2
unnamed: B1.17 (P6.13), SW1.1
unnamed: B1.18 (P6.30), U2.3 (A2)
unnamed: B1.19 (P6.31), U2.1 (A1)
unnamed: B1.20 (P8.18), U5.6 (A5)
unnamed: B1.21 (P9.31), U3.1 (A1)
unnamed: B1.22 (P8.23), U5.4 (A3)
unnamed: B1.23 (P8.22), U5.5 (A4)
unnamed: B1.24 (P7.12), U5.7 (A6)
unnamed: B1.25 (P9.07), U3.6 (A5)
unnamed: B1.28 (P7.18), U4.3 (A2)
unnamed: B1.29 (P7.19), U4.1 (A1)
unnamed: B1.30 (P6.28), U2.5 (A4)
unnamed: B1.31 (P6.29), U2.4 (A3)
unnamed: B1.32 (P6.20), U1.5 (A4)
unnamed: B1.33 (P6.21), U1.4 (A3)
unnamed: B1.35 (P7.03/LED), U4.6 (A5)
unnamed: B1.36 (P6.18), U1.7 (A6)
unnamed: B1.37 (P6.19), U1.6 (A5)
unnamed: B1.38 (P6.23), U1.1 (A1)
unnamed: B1.39 (P6.22), U1.3 (A2)
unnamed: B1.40 (P6.17), U1.8 (A7)
unnamed: B1.41 (P6.16), U1.9 (A8)
unnamed: B1.42 (P6.26), U2.7 (A6)
unnamed: B1.43 (P6.27), U2.6 (A5)
unnamed: B1.44 (P6.24), U2.9 (A8)
unnamed: B1.45 (P6.25), U2.8 (A7)
unnamed: D1.1 (K), R2.1
P10: J1.2 (P10), U1.12 (B8)
P11: J1.3 (P11), U1.13 (B7)
P12: J1.4 (P12), U1.14 (B6)
P13: J1.5 (P13), U1.15 (B5)
P14: J1.6 (P14), U1.16 (B4)
P15: J1.7 (P15), U1.17 (B3)
P16: J1.8 (P16), U1.18 (B2)
P17: J1.9 (P17), U1.20 (B1)
P20: J1.47 (P20), U2.12 (B8)
P21: J1.46 (P21), U2.13 (B7)
P22: J1.45 (P22), U2.14 (B6)
P23: J1.44 (P23), U2.15 (B5)
P24: J1.43 (P24), U2.16 (B4)
P25: J1.42 (P25), U2.17 (B3)
P26: J1.41 (P26), U2.18 (B2)
P27: J1.40 (P27), U2.20 (B1)
P30: J1.11 (P30), U4.12 (B8)
P31: J1.12 (P31), U4.13 (B7)
P32: J1.13 (P32), U4.14 (B6)
P33: J1.14 (P33), U4.15 (B5)
P34: J1.15 (P34), U4.16 (B4)
P35: J1.16 (P35), U4.17 (B3)
P36: J1.17 (P36), U4.18 (B2)
P37: J1.18 (P37), U4.20 (B1)
P40: J1.38 (P40), U3.12 (B8)
P41: J1.37 (P41), U3.13 (B7)
P42: J1.36 (P42), U3.14 (B6)
P43: J1.35 (P43), U3.15 (B5)
P44: J1.34 (P44), U3.16 (B4)
P45: J1.33 (P45), U3.17 (B3)
P46: J1.32 (P46), U3.18 (B2)
P47: J1.31 (P47), U3.20 (B1)
P50: J1.20 (P50), U5.12 (B8)
P51: J1.21 (P51), U5.13 (B7)
P52: J1.22 (P52), U5.14 (B6)
P53: J1.23 (P53), U5.15 (B5)
P54: J1.29 (P54), U5.16 (B4)
P55: J1.28 (P55), U5.17 (B3)
P56: J1.27 (P56), U5.18 (B2)
P57: J1.26 (P57), U5.20 (B1)
VCC: B1.48 (VIN), C1.1, J1.24 (VCC), J1.25 (VCC), PS1.1 (+Vin), U1.19 (VccB), U2.19 (VccB), U3.19 (VccB), U4.19 (VccB), U5.19 (VccB)
~USR_LED: B1.26 (P7.29), U5.1 (A1)
~USR_SW: B1.27 (P7.28), U5.3 (A2)
