tgtakaoka/RetroCyborg/BionicMC146805E/schematic/Prototype1.kicad_sch

## KiCad design BionicMC146805E/schematic/Prototype1.kicad_sch (2023-03-16)

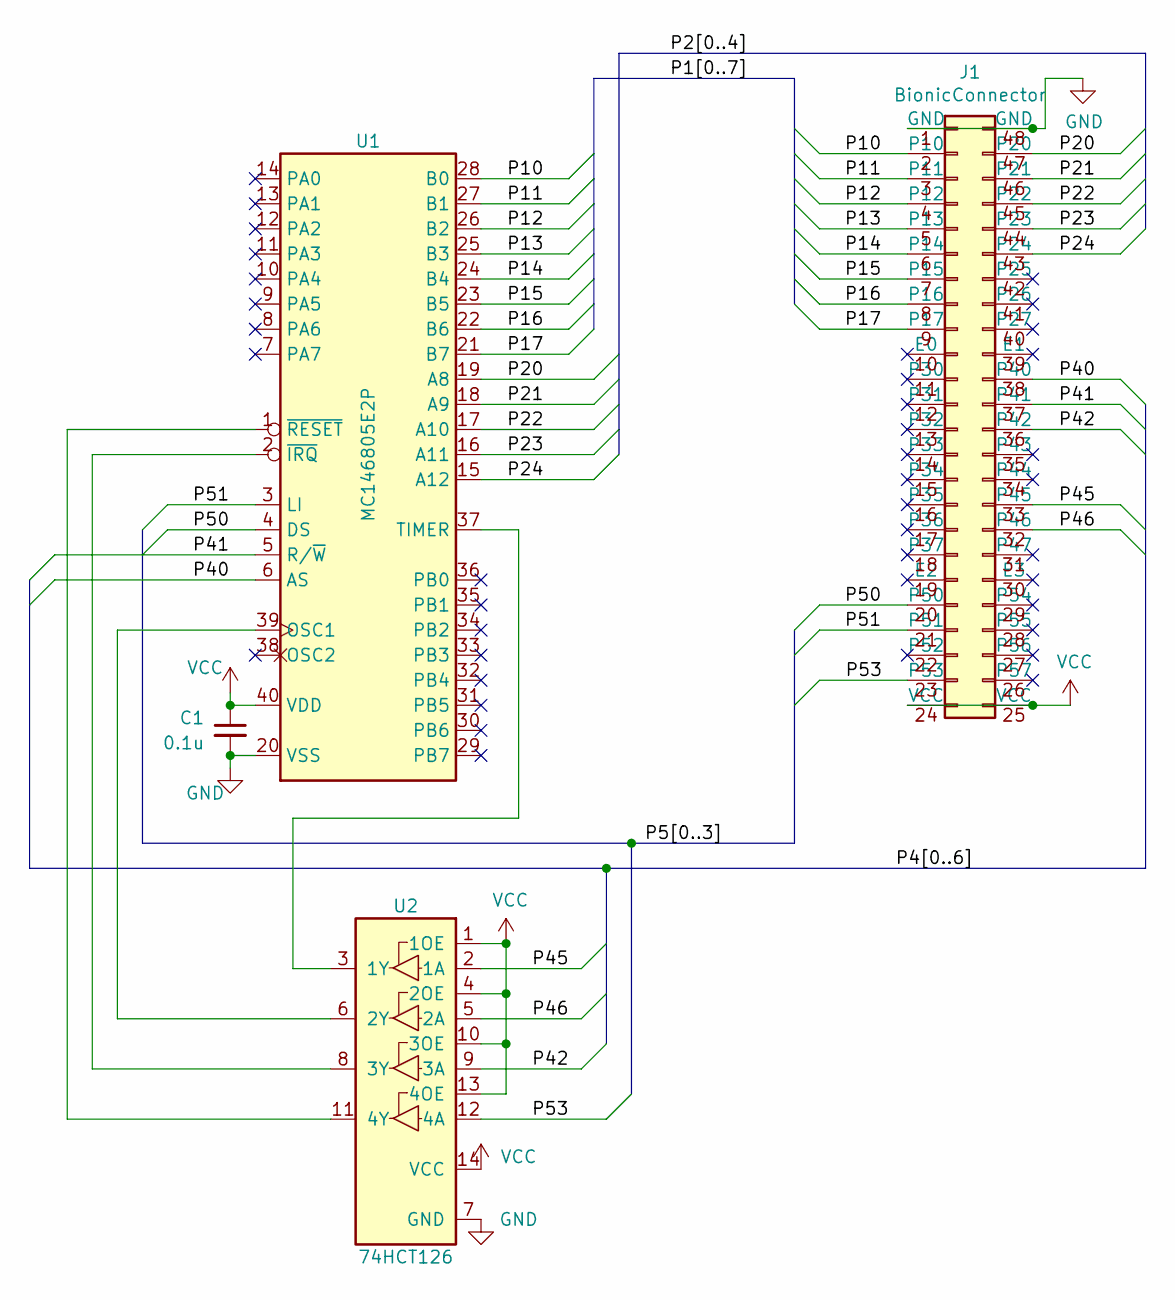
[picture p68: schematic Prototype1.kicad_sch]

Parts:
C1: 0.1u; C_Disc_D3.4mm_W2.1mm_P2.50mm
J1: BionicConnector; DIP-48_W7.62mm
U1: MC146805E2P; DIP-40_W15.24mm
U2: 74HCT126; DIP-14_W7.62mm

Connections:
GND: C1.2, J1.1 (GND), J1.48 (GND), U1.20 (VSS), U2.7 (GND)
unnamed: U1.1 (~RESET), U2.11 (4Y)
unnamed: U1.2 (~IRQ), U2.8 (3Y)
unnamed: U1.37 (TIMER), U2.3 (1Y)
unnamed: U1.39 (OSC1), U2.6 (2Y)
P10: J1.2 (P10), U1.28 (B0)
P11: J1.3 (P11), U1.27 (B1)
P12: J1.4 (P12), U1.26 (B2)
P13: J1.5 (P13), U1.25 (B3)
P14: J1.6 (P14), U1.24 (B4)
P15: J1.7 (P15), U1.23 (B5)
P16: J1.8 (P16), U1.22 (B6)
P17: J1.9 (P17), U1.21 (B7)
P20: J1.47 (P20), U1.19 (A8)
P21: J1.46 (P21), U1.18 (A9)
P22: J1.45 (P22), U1.17 (A10)
P23: J1.44 (P23), U1.16 (A11)
P24: J1.43 (P24), U1.15 (A12)
P40: J1.38 (P40), U1.6 (AS)
P41: J1.37 (P41), U1.5 (R/~W)
P42: J1.36 (P42), U2.9 (3A)
P45: J1.33 (P45), U2.2 (1A)
P46: J1.32 (P46), U2.5 (2A)
P50: J1.20 (P50), U1.4 (DS)
P51: J1.21 (P51), U1.3 (LI)
P53: J1.23 (P53), U2.12 (4A)
VCC: C1.1, J1.24 (VCC), J1.25 (VCC), U1.40 (VDD), U2.1 (1OE), U2.4 (2OE), U2.10 (3OE), U2.13 (4OE), U2.14 (VCC)
