tgtakaoka/RetroCyborg/BionicTMP90P802/schematic/Prototype1.kicad_sch

## KiCad design BionicTMP90P802/schematic/Prototype1.kicad_sch (2023-03-16)

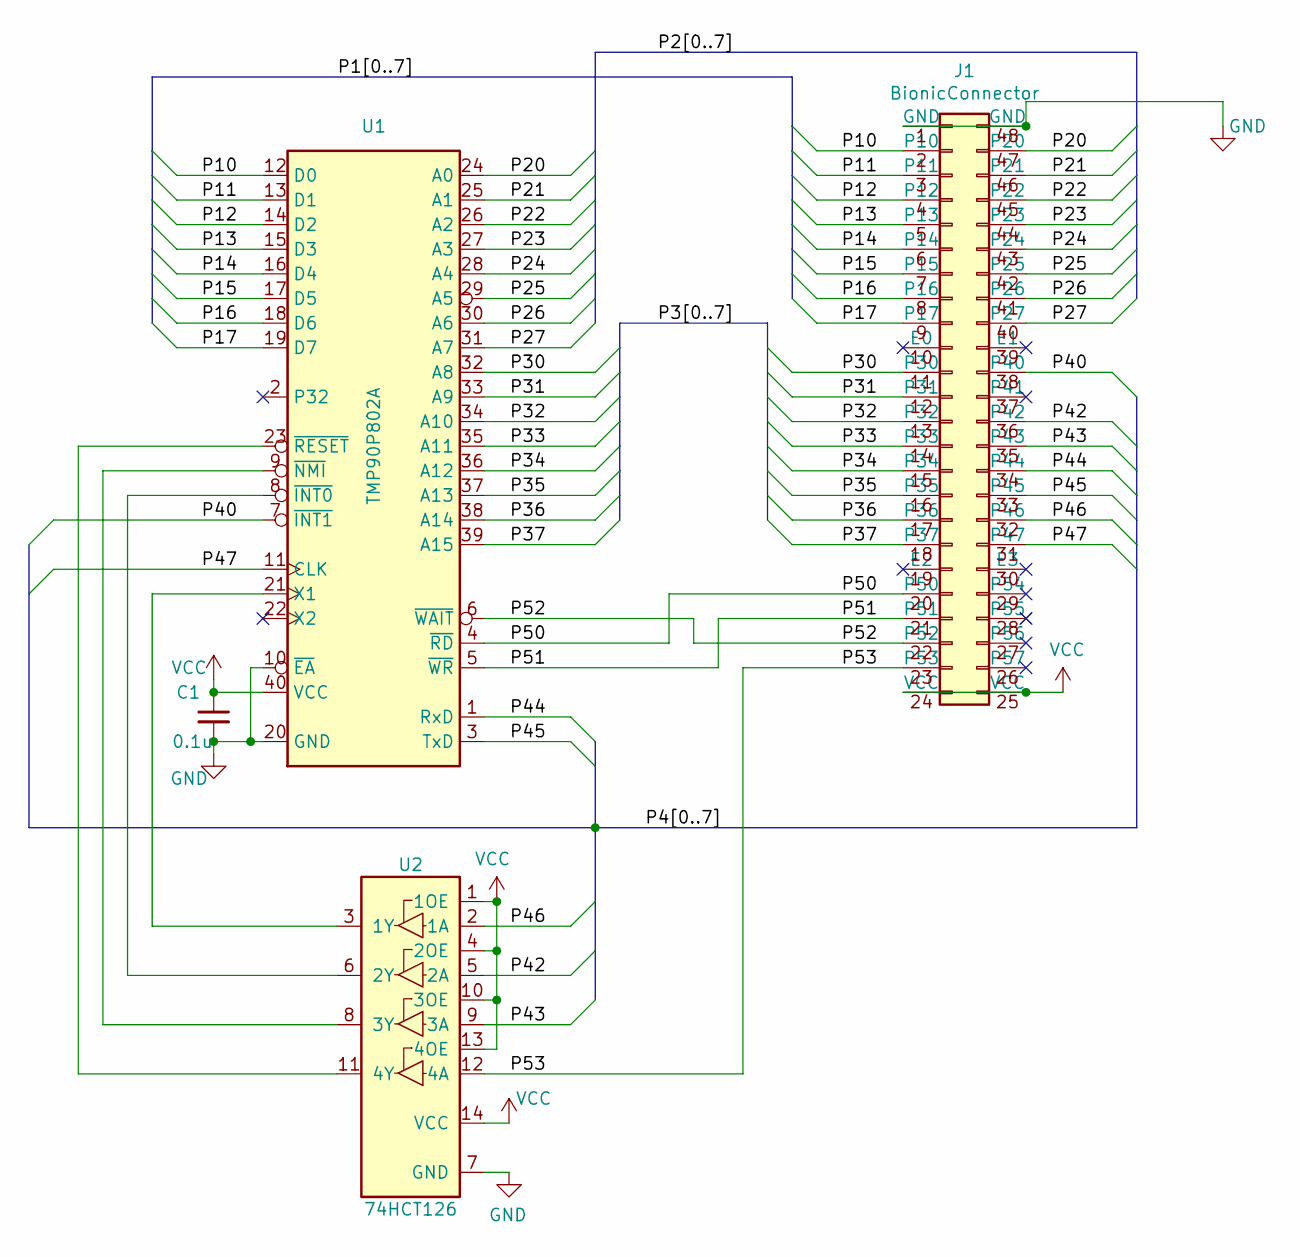
[picture p76: schematic Prototype1.kicad_sch]

Parts:
C1: 0.1u; C_Disc_D3.4mm_W2.1mm_P2.50mm
J1: BionicConnector; DIP-48_W7.62mm
U1: TMP90P802A; DIP-40_W15.24mm
U2: 74HCT126; DIP-14_W7.62mm

Connections:
GND: C1.2, J1.1 (GND), J1.48 (GND), U1.10 (~EA), U1.20 (GND), U2.7 (GND)
unnamed: U1.8 (~INT0), U2.6 (2Y)
unnamed: U1.9 (~NMI), U2.8 (3Y)
unnamed: U1.21 (X1), U2.3 (1Y)
unnamed: U1.23 (~RESET), U2.11 (4Y)
P10: J1.2 (P10), U1.12 (D0)
P11: J1.3 (P11), U1.13 (D1)
P12: J1.4 (P12), U1.14 (D2)
P13: J1.5 (P13), U1.15 (D3)
P14: J1.6 (P14), U1.16 (D4)
P15: J1.7 (P15), U1.17 (D5)
P16: J1.8 (P16), U1.18 (D6)
P17: J1.9 (P17), U1.19 (D7)
P20: J1.47 (P20), U1.24 (A0)
P21: J1.46 (P21), U1.25 (A1)
P22: J1.45 (P22), U1.26 (A2)
P23: J1.44 (P23), U1.27 (A3)
P24: J1.43 (P24), U1.28 (A4)
P25: J1.42 (P25), U1.29 (A5)
P26: J1.41 (P26), U1.30 (A6)
P27: J1.40 (P27), U1.31 (A7)
P30: J1.11 (P30), U1.32 (A8)
P31: J1.12 (P31), U1.33 (A9)
P32: J1.13 (P32), U1.34 (A10)
P33: J1.14 (P33), U1.35 (A11)
P34: J1.15 (P34), U1.36 (A12)
P35: J1.16 (P35), U1.37 (A13)
P36: J1.17 (P36), U1.38 (A14)
P37: J1.18 (P37), U1.39 (A15)
P40: J1.38 (P40), U1.7 (~INT1)
P42: J1.36 (P42), U2.5 (2A)
P43: J1.35 (P43), U2.9 (3A)
P44: J1.34 (P44), U1.1 (RxD)
P45: J1.33 (P45), U1.3 (TxD)
P46: J1.32 (P46), U2.2 (1A)
P47: J1.31 (P47), U1.11 (CLK)
P50: J1.20 (P50), U1.4 (~RD)
P51: J1.21 (P51), U1.5 (~WR)
P52: J1.22 (P52), U1.6 (~WAIT)
P53: J1.23 (P53), U2.12 (4A)
VCC: C1.1, J1.24 (VCC), J1.25 (VCC), U1.40 (VCC), U2.1 (1OE), U2.4 (2OE), U2.10 (3OE), U2.13 (4OE), U2.14 (VCC)
