tgtakaoka/RetroCyborg/BionicTMS32010/schematic/Prototype1.kicad_sch

## KiCad design BionicTMS32010/schematic/Prototype1.kicad_sch (2023-03-16)

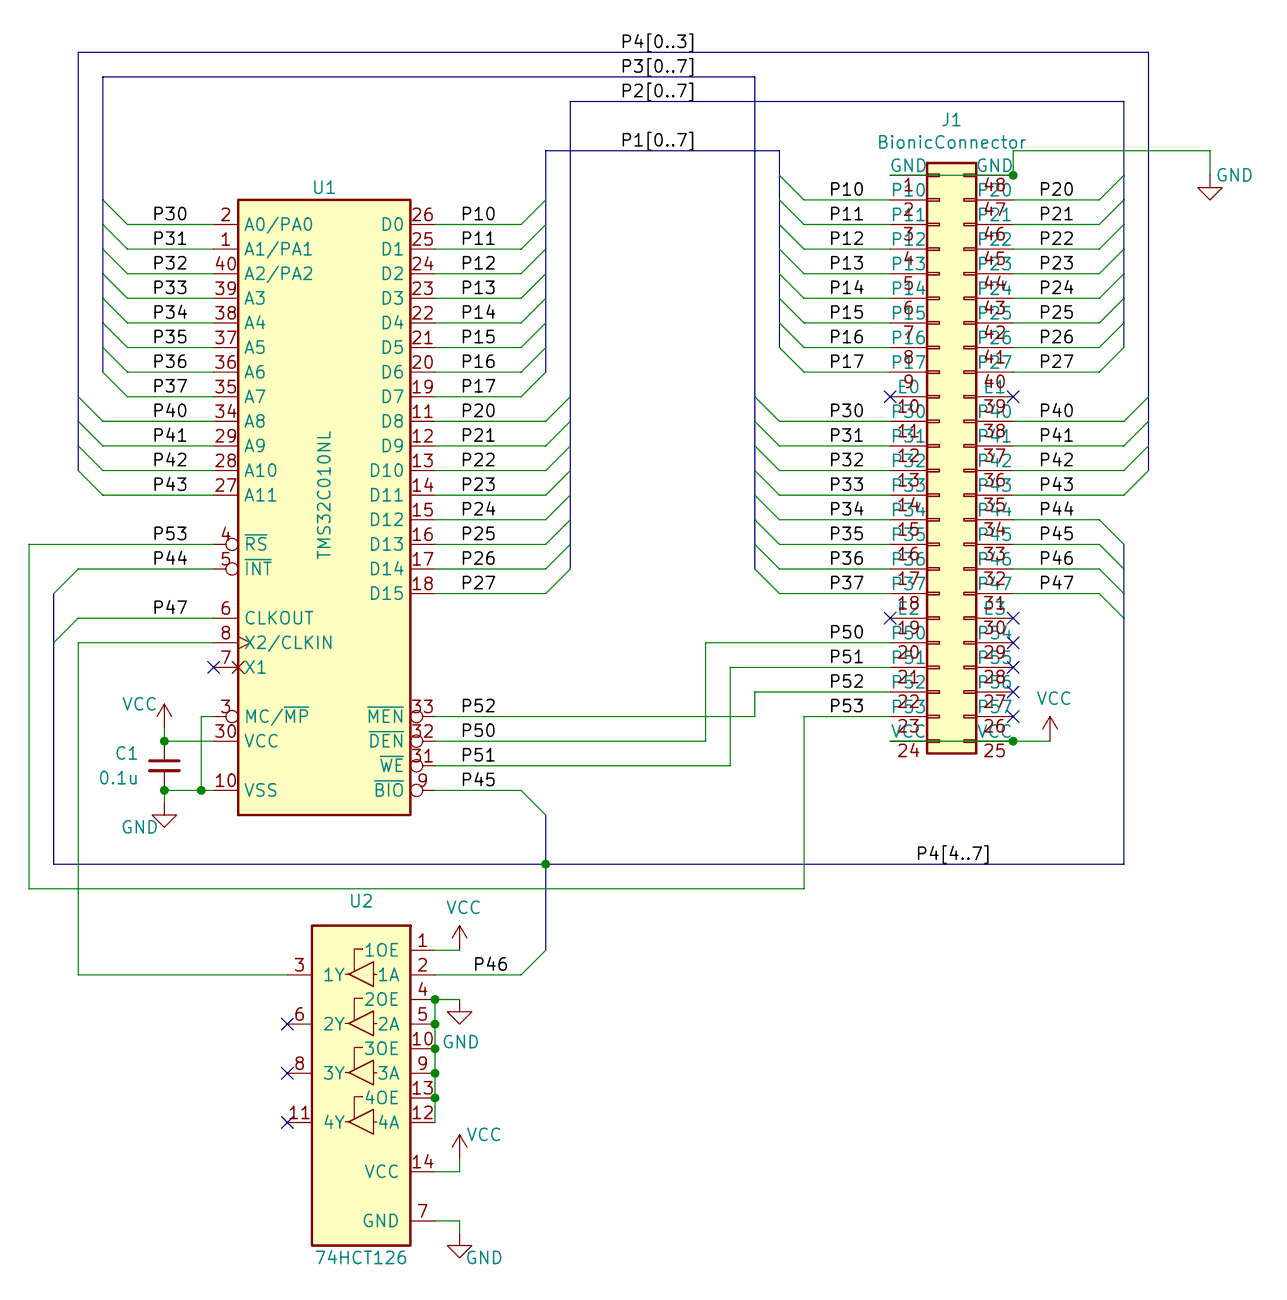
[picture p78: schematic Prototype1.kicad_sch]

Parts:
C1: 0.1u; C_Disc_D3.4mm_W2.1mm_P2.50mm
J1: BionicConnector; DIP-48_W7.62mm
U1: TMS32C010NL; DIP-40_W15.24mm
U2: 74HCT126; DIP-14_W7.62mm

Connections:
GND: C1.2, J1.1 (GND), J1.48 (GND), U1.3 (MC/~MP), U1.10 (VSS), U2.4 (2OE), U2.5 (2A), U2.7 (GND), U2.9 (3A), U2.10 (3OE), U2.12 (4A), U2.13 (4OE)
unnamed: U1.8 (X2/CLKIN), U2.3 (1Y)
P10: J1.2 (P10), U1.26 (D0)
P11: J1.3 (P11), U1.25 (D1)
P12: J1.4 (P12), U1.24 (D2)
P13: J1.5 (P13), U1.23 (D3)
P14: J1.6 (P14), U1.22 (D4)
P15: J1.7 (P15), U1.21 (D5)
P16: J1.8 (P16), U1.20 (D6)
P17: J1.9 (P17), U1.19 (D7)
P20: J1.47 (P20), U1.11 (D8)
P21: J1.46 (P21), U1.12 (D9)
P22: J1.45 (P22), U1.13 (D10)
P23: J1.44 (P23), U1.14 (D11)
P24: J1.43 (P24), U1.15 (D12)
P25: J1.42 (P25), U1.16 (D13)
P26: J1.41 (P26), U1.17 (D14)
P27: J1.40 (P27), U1.18 (D15)
P30: J1.11 (P30), U1.2 (A0/PA0)
P31: J1.12 (P31), U1.1 (A1/PA1)
P32: J1.13 (P32), U1.40 (A2/PA2)
P33: J1.14 (P33), U1.39 (A3)
P34: J1.15 (P34), U1.38 (A4)
P35: J1.16 (P35), U1.37 (A5)
P36: J1.17 (P36), U1.36 (A6)
P37: J1.18 (P37), U1.35 (A7)
P40: J1.38 (P40), U1.34 (A8)
P41: J1.37 (P41), U1.29 (A9)
P42: J1.36 (P42), U1.28 (A10)
P43: J1.35 (P43), U1.27 (A11)
P44: J1.34 (P44), U1.5 (~INT)
P45: J1.33 (P45), U1.9 (~BIO)
P46: J1.32 (P46), U2.2 (1A)
P47: J1.31 (P47), U1.6 (CLKOUT)
P50: J1.20 (P50), U1.32 (~DEN)
P51: J1.21 (P51), U1.31 (~WE)
P52: J1.22 (P52), U1.33 (~MEN)
P53: J1.23 (P53), U1.4 (~RS)
VCC: C1.1, J1.24 (VCC), J1.25 (VCC), U1.30 (VCC), U2.1 (1OE), U2.14 (VCC)
