tgtakaoka/RetroCyborg/BionicZ8002/schematic/Prototype1.kicad_sch

## KiCad design BionicZ8002/schematic/Prototype1.kicad_sch (2023-03-16)

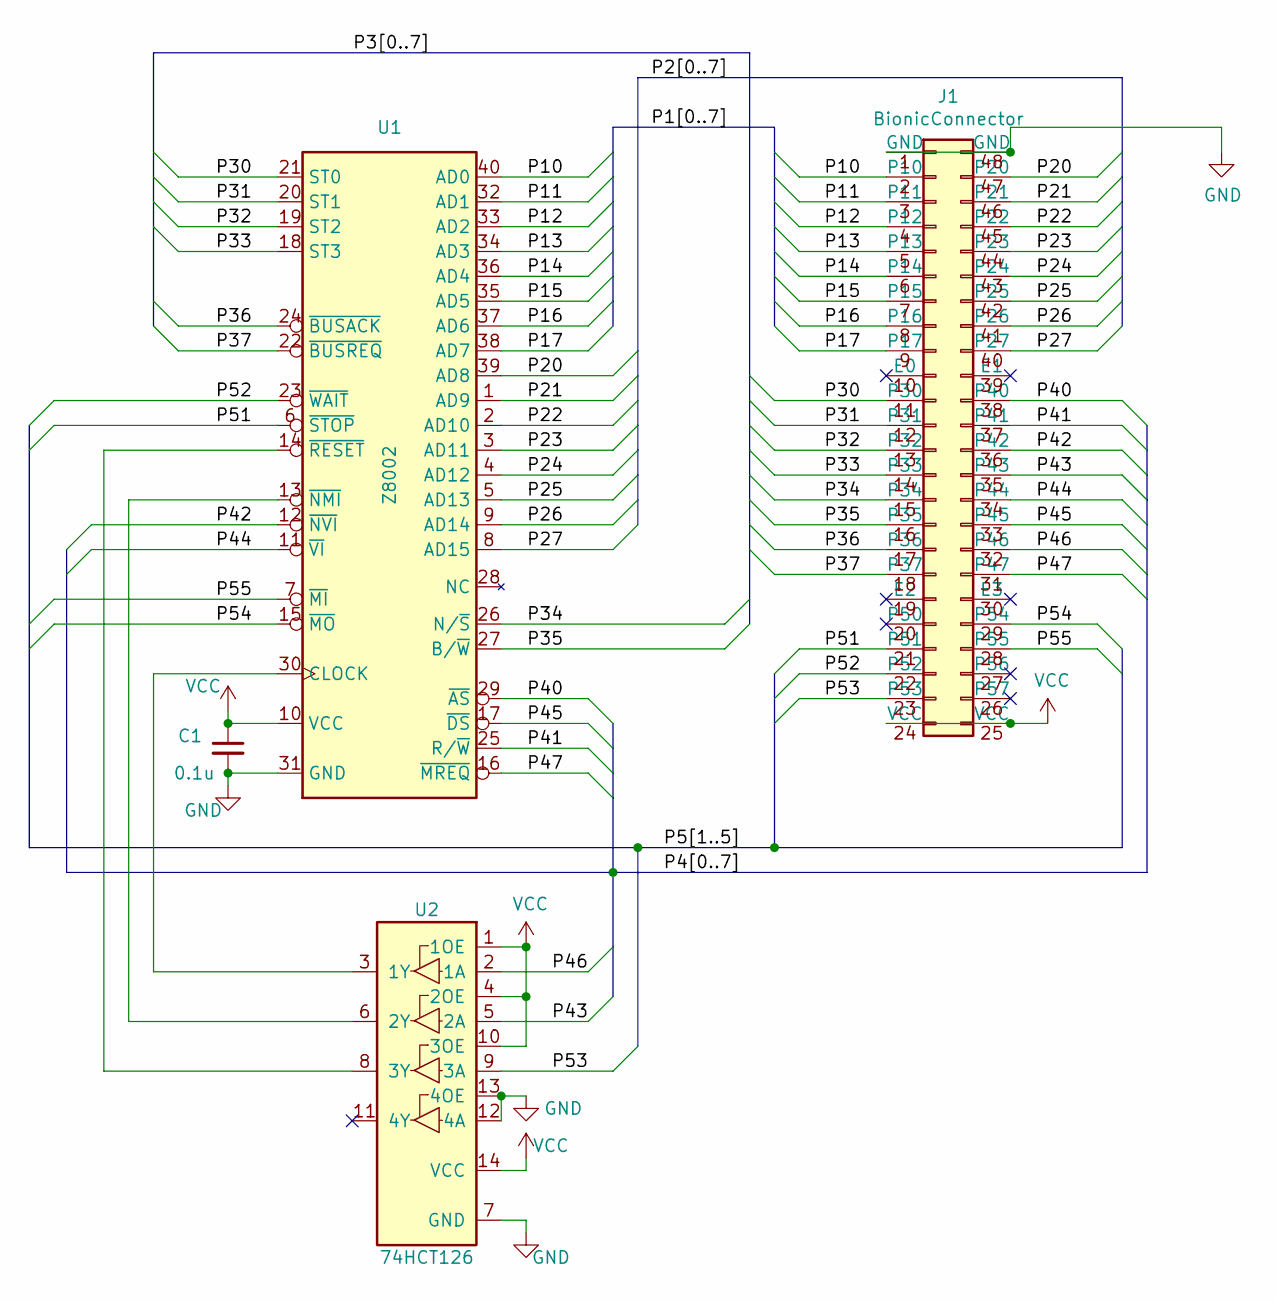
[picture p80: schematic Prototype1.kicad_sch]

Parts:
C1: 0.1u; C_Disc_D3.4mm_W2.1mm_P2.50mm
J1: BionicConnector; DIP-48_W7.62mm
U1: Z8002; DIP-40_W15.24mm
U2: 74HCT126; DIP-14_W7.62mm

Connections:
GND: C1.2, J1.1 (GND), J1.48 (GND), U1.31 (GND), U2.7 (GND), U2.12 (4A), U2.13 (4OE)
unnamed: U1.13 (~NMI), U2.6 (2Y)
unnamed: U1.14 (~RESET), U2.8 (3Y)
unnamed: U1.30 (CLOCK), U2.3 (1Y)
P10: J1.2 (P10), U1.40 (AD0)
P11: J1.3 (P11), U1.32 (AD1)
P12: J1.4 (P12), U1.33 (AD2)
P13: J1.5 (P13), U1.34 (AD3)
P14: J1.6 (P14), U1.36 (AD4)
P15: J1.7 (P15), U1.35 (AD5)
P16: J1.8 (P16), U1.37 (AD6)
P17: J1.9 (P17), U1.38 (AD7)
P20: J1.47 (P20), U1.39 (AD8)
P21: J1.46 (P21), U1.1 (AD9)
P22: J1.45 (P22), U1.2 (AD10)
P23: J1.44 (P23), U1.3 (AD11)
P24: J1.43 (P24), U1.4 (AD12)
P25: J1.42 (P25), U1.5 (AD13)
P26: J1.41 (P26), U1.9 (AD14)
P27: J1.40 (P27), U1.8 (AD15)
P30: J1.11 (P30), U1.21 (ST0)
P31: J1.12 (P31), U1.20 (ST1)
P32: J1.13 (P32), U1.19 (ST2)
P33: J1.14 (P33), U1.18 (ST3)
P34: J1.15 (P34), U1.26 (N/~S)
P35: J1.16 (P35), U1.27 (B/~W)
P36: J1.17 (P36), U1.24 (~BUSACK)
P37: J1.18 (P37), U1.22 (~BUSREQ)
P40: J1.38 (P40), U1.29 (~AS)
P41: J1.37 (P41), U1.25 (R/~W)
P42: J1.36 (P42), U1.12 (~NVI)
P43: J1.35 (P43), U2.5 (2A)
P44: J1.34 (P44), U1.11 (~VI)
P45: J1.33 (P45), U1.17 (~DS)
P46: J1.32 (P46), U2.2 (1A)
P47: J1.31 (P47), U1.16 (~MREQ)
P51: J1.21 (P51), U1.6 (~STOP)
P52: J1.22 (P52), U1.23 (~WAIT)
P53: J1.23 (P53), U2.9 (3A)
P54: J1.29 (P54), U1.15 (~MO)
P55: J1.28 (P55), U1.7 (~MI)
VCC: C1.1, J1.24 (VCC), J1.25 (VCC), U1.10 (VCC), U2.1 (1OE), U2.4 (2OE), U2.10 (3OE), U2.14 (VCC)
