tgtakaoka/RetroCyborg/BionicZ8691/debugger/config.h

#ifndef __CONFIG_H__
#define __CONFIG_H__

#include <Arduino.h>
#include <stdint.h>

#define VERSION_TEXT "0.1"
#define Console Serial

#define USART_BASE_ADDR 0xFF00

/**
 * External memory operation
 * R248:D7; %F8 Write only
 *   1 = P04~7=A12~15
 * R248:D43; %F8 Write only
 *   10 = P10~7=AD0~7
 * R248:D1; %F8 Write only
 *   1 = P00~3=A8~11
 *
 * Stack selection
 * R248:D2; %F8 Write only
 *   0 = External
 *   1 = Internal
 */
#define Z8_INTERNAL_STACK 0

/**
 * Data memory operation
 * R247:D43; %F7 Write only
 *   00 = P33=INPUT, P34=OUTPUT
 *   01 = P33=INPUT, P34=#DM
 *   10 = P33=INPUT, P34=#DM
 *
 * Serial IO
 * R247:D6; %F7 Write only
 *   1 = P30=Serial In, P37=Serial Out
 */
#define Z8_DATA_MEMORY 0

#if defined(ARDUINO_TEENSY41)
#define PORT_DATA 6    /* GPIO6 */
#define DATA_gp 16     /* P6.16-P6.23 */
#define DATA_gm 0xFF   /* P6.16-P6.23 */
#define DATA_vp 0      /* D0-D7 */
#define PIN_DATA0 19   /* P6.16 */
#define PIN_DATA1 18   /* P6.17 */
#define PIN_DATA2 14   /* P6.18 */
#define PIN_DATA3 15   /* P6.19 */
#define PIN_DATA4 40   /* P6.20 */
#define PIN_DATA5 41   /* P6.21 */
#define PIN_DATA6 17   /* P6.22 */
#define PIN_DATA7 16   /* P6.23 */
#define PORT_ADDR 6    /* GPIO6 */
#define ADDR_gp 16     /* P6.24-P6.31 */
#define ADDR_gm 0xFFFF /* P6.24-P6.31 */
#define ADDR_vp 0      /* A8-A15 */
#define PIN_ADDR0 19   /* P6.16 */
#define PIN_ADDR1 18   /* P6.17 */
#define PIN_ADDR2 14   /* P6.18 */
#define PIN_ADDR3 15   /* P6.19 */
#define PIN_ADDR4 40   /* P6.20 */
#define PIN_ADDR5 41   /* P6.21 */
#define PIN_ADDR6 17   /* P6.22 */
#define PIN_ADDR7 16   /* P6.23 */
#define PIN_ADDR8 22   /* P6.24 */
#define PIN_ADDR9 23   /* P6.25 */
#define PIN_ADDR10 20  /* P6.26 */
#define PIN_ADDR11 21  /* P6.27 */
#define PIN_ADDR12 38  /* P6.28 */
#define PIN_ADDR13 39  /* P6.29 */
#define PIN_ADDR14 26  /* P6.30 */
#define PIN_ADDR15 27  /* P6.31 */
#define PIN_AS 2       /* P9.04 */
#define PIN_RW 3       /* P9.05 */
#define PIN_IRQ1 4     /* P9.06 */
#define PIN_IRQ0 33    /* P9.07 */
#define PIN_TXD 0      /* P6.03 */
#define PIN_RXD 1      /* P6.04 */
#define PIN_XTAL1 5    /* P9.08 */
#define PIN_DS 29      /* P9.31 */
#define PIN_IRQ2 6     /* P7.10 */
#define PIN_RESET 28   /* P8.18 */
#define PIN_DM 30      /* P8.23 */
#define PIN_USRSW 24   /* P6.12 */
#define PIN_USRLED 25  /* P6.13 */
#endif

#endif

// Local Variables:
// mode: c++
// c-basic-offset: 4
// tab-width: 4
// End:
// vim: set ft=cpp et ts=4 sw=4:
