tgtakaoka/RetroCyborg/BionicF3850/debugger/commands.cpp

/*
  The Controller can accept commands represented by one letter.

  R - reset MPU.
  d - dump memory. addr [length]
  m - write memory. addr byte...
  s - step one instruction.
  S - step one instruction with printing bus cycles.
  r - print MPU registers.
  = - set MPU register. register value
  c - continuously run with printing register.
  G - Go, continuously run MPU.
  h - halt MPU.
  H - halt MPU with printing bus cycles.
  D - disassemble
  A - assemble
  F - list files in SD card
  L - load S-record file.
  ? - print version.
*/

#include <ctype.h>
#include <stdlib.h>
#include <string.h>

#include "commands.h"

#include <SD.h>
#include <libcli.h>

#include "config.h"
#include "memory.h"
#include "pins.h"
#include "regs.h"
#include "unio_eeprom.h"

using State = libcli::State;
extern libcli::Cli cli;

#define USAGE                                                                \
    F("R:eset r:egs =:setReg d:ump D:is m/M:emory A:sm s/S:tep c/C:ont G:o " \
      "h/H:alt b/B:reak F:iles L:oad U:pload I:o")

class Commands Commands;

static void commandHandler(char c, uintptr_t extra) {
    (void)extra;
    Commands.exec(c);
}

static void printPrompt() {
    cli.print(F("> "));
    cli.readLetter(commandHandler, 0);
}

static uint32_t last_addr;
static uint16_t last_length;
#define DUMP_ADDR 0
#define DUMP_LENGTH 1
#define DUMP_SPACE 2
#define DIS_ADDR 0
#define DIS_LENGTH 1

static uint8_t mem_buffer[16];
#define MEMORY_DATA(i) ((uintptr_t)(i))
#define MEMORY_ADDR static_cast<uintptr_t>(sizeof(mem_buffer) + 1)
#define MEMORY_END (MEMORY_ADDR + 1)

static char str_buffer[40];

static void dump(uint32_t addr, uint16_t len, const uint8_t *buffer) {
    const auto start = addr;
    const auto end = addr + len;
    addr &= ~0xF;
    for (auto i = 0; i < 16; i++) {
        const auto a = addr + i;
        if (a < start || a >= end) {
            cli.print(F("   "));
        } else {
            cli.print(' ');
            cli.printHex(buffer[i], 2);
        }
    }
    cli.print(' ');
    for (auto i = 0; i < 16; i++) {
        const auto a = addr + i;
        if (a < start || a >= end) {
            cli.print(' ');
        } else {
            char data = buffer[i];
            if (!isprint(data))
                data = '.';
            cli.print(data);
        }
    }
    cli.println();
}

static void memoryDump(
        uint32_t addr, uint16_t len, const char *space = nullptr) {
    auto start = addr;
    const auto end = addr + len;
    for (addr &= ~0xF; addr < end; addr += 16, start = addr) {
        cli.printHex(addr, 4);
        cli.print(':');
        for (auto i = 0; i < 16; i++) {
            const auto a = addr + i;
            if (a >= start && a < end)
                mem_buffer[i] = Memory.read(a, space);
        }
        dump(start, end, mem_buffer);
    }
}

static void handleDump(uint32_t value, uintptr_t extra, State state);

static void handleDumpSpace(char *word, uintptr_t extra, State state) {
    if (state != State::CLI_CANCEL) {
        if (state == State::CLI_DELETE) {
            cli.backspace();
            cli.readHex(handleDump, DUMP_LENGTH, UINT16_MAX, last_length);
            return;
        }
        cli.println();
        memoryDump(last_addr, last_length, word);
    }
    printPrompt();
}

static void handleDump(uint32_t value, uintptr_t extra, State state) {
    if (state == State::CLI_CANCEL)
        goto cancel;
    if (state == State::CLI_DELETE) {
        if (extra == DUMP_LENGTH) {
            cli.backspace();
            cli.readHex(handleDump, DUMP_ADDR, Regs.maxAddr(), last_addr);
        }
        return;
    }
    if (extra == DUMP_LENGTH) {
        last_length = value;
        if (state == State::CLI_SPACE) {
            cli.readWord(handleDumpSpace, DUMP_SPACE, str_buffer,
                    sizeof(str_buffer));
            return;
        }
    } else if (extra == DUMP_ADDR) {
        last_addr = value;
        if (state == State::CLI_SPACE) {
            cli.readHex(handleDump, DUMP_LENGTH, UINT16_MAX);
            return;
        }
        last_length = 16;
    }
    cli.println();
    memoryDump(last_addr, last_length);
    last_addr += last_length;
cancel:
    printPrompt();
}

static void handleDisassemble(uint32_t value, uintptr_t extra, State state) {
    if (state == State::CLI_CANCEL)
        goto cancel;
    if (state == State::CLI_DELETE) {
        if (extra == DIS_LENGTH) {
            cli.backspace();
            cli.readHex(handleDisassemble, DIS_ADDR, Regs.maxAddr(), last_addr);
        }
        return;
    }
    if (extra == DIS_ADDR) {
        last_addr = value;
        if (state == State::CLI_SPACE) {
            cli.readDec(handleDisassemble, DIS_LENGTH, UINT16_MAX);
            return;
        }
        value = 10;
        ;
    }
    cli.println();
    last_addr = Memory.disassemble(last_addr, value);
cancel:
    printPrompt();
}

static void handleMemory(uint32_t value, uintptr_t extra, State state) {
    if (state == State::CLI_DELETE) {
        if (extra == MEMORY_ADDR)
            return;
        cli.backspace();
        uint16_t index = extra;
        if (index == 0) {
            cli.readHex(handleMemory, MEMORY_ADDR, Regs.maxAddr(), last_addr);
        } else {
            index--;
            cli.readHex(handleMemory, MEMORY_DATA(index), UINT8_MAX,
                    mem_buffer[index]);
        }
        return;
    }
    if (state != State::CLI_CANCEL) {
        if (extra == MEMORY_ADDR) {
            last_addr = value;
            cli.readHex(handleMemory, MEMORY_DATA(0), UINT8_MAX);
            return;
        }
        uint16_t index = extra;
        mem_buffer[index++] = value;
        if (state == State::CLI_SPACE) {
            if (index < sizeof(mem_buffer)) {
                cli.readHex(handleMemory, MEMORY_DATA(index), UINT8_MAX);
                return;
            }
        }
        cli.println();
        Memory.write(last_addr, mem_buffer, index);
        memoryDump(last_addr, index);
        last_addr += index;
    }
    printPrompt();
}

static void handleAssembleLine(char *line, uintptr_t extra, State state) {
    (void)extra;
    if (state == State::CLI_CANCEL || *line == 0) {
        cli.println(F("end"));
        printPrompt();
        return;
    }
    cli.println();
    last_addr = Memory.assemble(last_addr, line);
    cli.printHex(last_addr, 4);
    cli.print('?');
    cli.readLine(handleAssembleLine, 0, str_buffer, sizeof(str_buffer));
}

static void handleAssembler(uint32_t value, uintptr_t extra, State state) {
    if (state == State::CLI_DELETE)
        return;
    if (state == State::CLI_CANCEL) {
        printPrompt();
        return;
    }
    last_addr = value;
    cli.println();
    cli.printHex(last_addr, 4);
    cli.print('?');
    cli.readLine(handleAssembleLine, 0, str_buffer, sizeof(str_buffer));
}

static void listDirectory(File dir, const char *parent = nullptr) {
    while (true) {
        File entry = dir.openNextFile();
        if (!entry)
            break;
        if (entry.isDirectory()) {
            listDirectory(entry, entry.name());
        } else {
            if (parent) {
                cli.print(parent);
                cli.print('/');
            }
            cli.printStr(entry.name(), -20);
            cli.printlnDec(entry.size(), 6);
        }
        entry.close();
    }
}

static void handleFileListing(char *line, uintptr_t extra, State state) {
    if (state == State::CLI_CANCEL) {
        printPrompt();
        return;
    }
    cli.println();
    const char *dir = (*line == 0) ? "/" : line;
    SD.begin(BUILTIN_SDCARD);
    File root = SD.open(dir);
    listDirectory(root);
    root.close();
    printPrompt();
}

static uint8_t toInt(const char c) {
    return isDigit(c) ? c - '0' : c - 'A' + 10;
}

static uint8_t toInt8Hex(const char *text) {
    return (toInt(text[0]) << 4) | toInt(text[1]);
}

static uint16_t toInt16Hex(const char *text) {
    return ((uint16_t)toInt8Hex(text) << 8) | toInt8Hex(text + 2);
}

static uint32_t toInt24Hex(const char *text) {
    return ((uint32_t)toInt16Hex(text) << 8) | toInt8Hex(text + 4);
}

static uint32_t toInt32Hex(const char *text) {
    return ((uint32_t)toInt24Hex(text) << 8) | toInt8Hex(text + 6);
}

static int loadIHexRecord(const char *line) {
    const auto num = toInt8Hex(line + 1);
    const uint16_t addr = toInt16Hex(line + 3);
    const auto type = toInt8Hex(line + 7);
    // TODO: Support 32bit Intel Hex
    if (type == 0) {
        uint8_t buffer[num];
        for (int i = 0; i < num; i++) {
            buffer[i] = toInt8Hex(line + i * 2 + 9);
        }
        Memory.write(addr, buffer, num);
        cli.printHex(addr, 4);
        cli.print(':');
        cli.printHex(num, 2);
    }
    return num;
}

static int loadS19Record(const char *line) {
    const int num = toInt8Hex(line + 2) - 3;
    uint32_t addr;
    switch (line[1]) {
    case '1':
        addr = toInt16Hex(line + 4);
        line += 8;
        break;
    case '2':
        addr = toInt24Hex(line + 4);
        line += 10;
        break;
    case '3':
        addr = toInt32Hex(line + 4);
        line += 12;
        break;
    default:
        return 0;
    }
    uint8_t buffer[num];
    for (int i = 0; i < num; i++) {
        buffer[i] = toInt8Hex(line + i * 2);
    }
    Memory.write(addr, buffer, num);
    cli.printHex(addr, 4);
    cli.print(':');
    cli.printHex(num, 2);
    return num;
}

static void handleLoadFile(char *line, uintptr_t extra, State state) {
    (void)extra;
    if (state == State::CLI_CANCEL) {
        printPrompt();
        return;
    }
    cli.println();
    if (*line) {
        SD.begin(BUILTIN_SDCARD);
        File file = SD.open(line);
        if (!file) {
            cli.print(line);
            cli.println(F(" not found"));
        } else {
            uint16_t size = 0;
            char buffer[80];
            char *p = buffer;
            while (file.available() > 0) {
                const char c = file.read();
                if (c == '\n') {
                    *p = 0;
                    if (*buffer == 'S') {
                        cli.print(buffer);
                        cli.print(' ');
                        size += loadS19Record(buffer);
                        cli.println();
                    } else if (*buffer == ':') {
                        cli.print(buffer);
                        cli.print(' ');
                        size += loadIHexRecord(buffer);
                        cli.println();
                    }
                    p = buffer;
                } else if (c != '\r' && p < buffer + sizeof(buffer) - 1) {
                    *p++ = c;
                }
            }
            file.close();
            cli.println();
            cli.print(size);
            cli.println(F(" bytes loaded"));
        }
    }
    printPrompt();
}

static struct UploadContext {
    uint32_t size;
    char buffer[80];
    uintptr_t extra() { return reinterpret_cast<uintptr_t>(this); }
    static UploadContext *context(uintptr_t extra) {
        return reinterpret_cast<UploadContext *>(extra);
    }
} upload_context;

static void handleUploadFile(char *line, uintptr_t extra, State state) {
    UploadContext *context = UploadContext::context(extra);
    if (state == State::CLI_CANCEL) {
        printPrompt();
        return;
    }
    const auto c = context->buffer[0];
    if (c == 'S') {
        context->size += loadS19Record(context->buffer);
    } else if (c == ':') {
        context->size += loadIHexRecord(context->buffer);
    } else if (c == 0) {
        cli.println();
        cli.print(context->size);
        cli.println(F(" bytes uploaded"));
        printPrompt();
        return;
    }
    cli.println();
    cli.readLine(handleUploadFile, context->extra(), context->buffer,
            sizeof(context->buffer));
}

static void handleRegisterValue(uint32_t, uintptr_t, State);

static void handleSetRegister(char *word, uintptr_t extra, State state) {
    if (state == State::CLI_DELETE)
        return;
    char reg;
    if ((reg = Regs.validUint8Reg(word)) != 0) {
        cli.print('?');
        cli.readHex(handleRegisterValue, (uintptr_t)reg, UINT8_MAX);
        return;
    }
    if ((reg = Regs.validUint16Reg(word)) != 0) {
        cli.print('?');
        cli.readHex(handleRegisterValue, (uintptr_t)reg, UINT16_MAX);
        return;
    }
    if ((reg = Regs.validUint32Reg(word)) != 0) {
        cli.print('?');
        cli.readHex(handleRegisterValue, (uintptr_t)reg, UINT32_MAX);
        return;
    }
    Regs.printRegList();
    printPrompt();
}

static void handleRegisterValue(uint32_t value, uintptr_t reg, State state) {
    if (state == State::CLI_DELETE) {
        cli.backspace(2);  // ' ', '?'
        cli.readWord(
                handleSetRegister, 0, str_buffer, sizeof(str_buffer), true);
        return;
    }
    if (state != State::CLI_CANCEL) {
        Regs.setRegValue(reg, value);
        cli.println();
        Regs.print();
    }
    printPrompt();
}

static void handleIo(char *line, uintptr_t extra, State state);

static void handleBaseAddr(uint32_t val, uintptr_t extra, State state) {
    if (state != State::CLI_CANCEL) {
        const auto dev = static_cast<Pins::Device>(extra);
        if (state == State::CLI_DELETE) {
            cli.backspace();
            Pins.getDeviceName(dev, str_buffer);
            cli.readWord(handleIo, 0, str_buffer, sizeof(str_buffer), true);
            return;
        }
        Pins.setDeviceBase(dev, static_cast<uint16_t>(val));
        Pins.printDevices();
    }
    printPrompt();
}

static void handleIo(char *line, uintptr_t extra, State state) {
    if (state == State::CLI_DELETE)
        return;
    if (state != State::CLI_CANCEL) {
        const auto dev = Pins.parseDevice(line);
        if (state == State::CLI_SPACE) {
            if (dev != Pins::Device::NONE) {
                cli.readHex(handleBaseAddr, static_cast<uintptr_t>(dev),
                        Regs.maxAddr());
                return;
            }
        }
        Pins.setDeviceBase(dev);
        Pins.printDevices();
    }
    printPrompt();
}

static void handleRomArea(uint32_t value, uintptr_t extra, State state) {
    if (state == State::CLI_DELETE) {
        if (extra == MEMORY_END) {
            cli.backspace();
            cli.readHex(handleRomArea, MEMORY_END, Regs.maxAddr(), last_addr);
        }
        return;
    }
    if (state != State::CLI_CANCEL) {
        if (state == State::CLI_SPACE && extra == MEMORY_ADDR) {
            last_addr = value;
            cli.readHex(handleRomArea, MEMORY_END, Regs.maxAddr());
            return;
        }
        if (extra == MEMORY_END)
            Pins.setRomArea(last_addr, value);
        cli.println();
        Pins.printRomArea();
    }
    printPrompt();
}

static void handleSetBreak(uint32_t value, uintptr_t extra, State state) {
    if (state != State::CLI_CANCEL) {
        if (Pins.setBreakPoint(value)) {
            cli.println(F("Set"));
        } else {
            cli.println(F("Full"));
        }
        Pins.printBreakPoints();
    }
    printPrompt();
}

static void handleClearBreak(char *line, uintptr_t extra, State state) {
    if (state != State::CLI_CANCEL) {
        if (str_buffer[0]) {
            const auto index = atoi(str_buffer);
            if (Pins.clearBreakPoint(index))
                cli.print(F(" Clear"));
        }
        cli.println();
        Pins.printBreakPoints();
    }
    printPrompt();
}

static void printIdentity() {
    extern unio::UnioBus unioBus;
    unio::Eeprom rom{unioBus};
    uint8_t buffer[16];
    const auto valid = rom.read(0, sizeof(buffer), buffer);
    const auto *identity = reinterpret_cast<const char *>(buffer);
    cli.print(F("* Bionic"));
    if (valid) {
        cli.print(identity);
    } else {
        cli.print(F("?????"));
    }
    if (strcasecmp(identity, Regs.cpuName())) {
        cli.print(F(" (CPU: "));
        cli.print(Regs.cpuName());
        cli.print(')');
    }
    cli.println(F(" * " VERSION_TEXT));
    cli.println(USAGE);
}

void Commands::exec(char c) {
    switch (c) {
    case 'R':
        cli.println(F("Reset"));
        Pins.reset(false);
        goto regs;
    case 'd':
        cli.print(F("Dump? "));
        cli.readHex(handleDump, DUMP_ADDR, Regs.maxAddr());
        return;
    case 'D':
        cli.print(F("Disassemble? "));
        cli.readHex(handleDisassemble, DIS_ADDR, Regs.maxAddr());
        return;
    case 'A':
        cli.print(F("Assemble? "));
        cli.readHex(handleAssembler, 0, Regs.maxAddr());
        return;
    case 'm':
        cli.print(F("Memory? "));
        cli.readHex(handleMemory, MEMORY_ADDR, Regs.maxAddr());
        return;
    case 'M':
        Pins.printRomArea();
        cli.print(F("  ROM area? "));
        cli.readHex(handleRomArea, MEMORY_ADDR, Regs.maxAddr());
        return;
    case 'B':
        cli.print(F("Set break? "));
        cli.readHex(handleSetBreak, 0, Regs.maxAddr());
        return;
    case 'b':
        cli.print(F("Clear break? "));
        cli.readLine(handleClearBreak, 0, str_buffer, sizeof(str_buffer));
        return;
    case 'r':
        cli.println(F("Registers"));
    regs:
        Regs.print();
        Memory.disassemble(Regs.nextIp(), 1);
        break;
    case '=':
        cli.print(F("Set register? "));
        cli.readWord(handleSetRegister, 0, str_buffer, sizeof(str_buffer));
        return;
    case 'S':
    case 's':
        if (_target != HALT) {
            halt(c == 'S');
            return;
        }
        cli.println(F("Step"));
        Pins.step(c == 'S');
        goto regs;
    case 'H':
    case 'h':
        if (_target != HALT) {
            halt(c == 'H');
            return;
        }
        break;
    case 'c':
    case 'C':
        cli.println(F("Continue"));
        _target = STEP;
        _showRegs = (c == 'C');
        return;
    case 'G':
        if (_target != RUN) {
            cli.println(F("Go"));
            _target = RUN;
            _showRegs = false;
            Pins.run();
        }
        return;
    case 'F':
        cli.print(F("Files? "));
        cli.readLine(handleFileListing, 0, str_buffer, sizeof(str_buffer));
        return;
    case 'L':
        cli.print(F("Load? "));
        cli.readLine(handleLoadFile, 0, str_buffer, sizeof(str_buffer));
        return;
    case 'U':
        cli.println(F("Upload waiting..."));
        upload_context.size = 0;
        cli.readLine(handleUploadFile, upload_context.extra(),
                upload_context.buffer, sizeof(upload_context.buffer));
        return;
    case 'I':
        cli.print(F("Io? "));
        cli.readWord(handleIo, 0, str_buffer, sizeof(str_buffer));
        return;
    case '?':
        printIdentity();
        break;
    case '\r':
        cli.println();
    case '\n':
        break;
    default:
        return;
    }
    printPrompt();
}

void Commands::halt(bool show) {
    _target = HALT;
    Pins.halt(show);
    if (!_showRegs)
        Regs.print();
    Memory.disassemble(Regs.nextIp(), 1);
    printPrompt();
}

void Commands::begin() {
    printPrompt();
    _target = HALT;
}

void Commands::loop() {
    if (_target == STEP) {
        Pins.step();
        if (_showRegs)
            Regs.print();
    } else {
        Pins.loop();
    }
}

// Local Variables:
// mode: c++
// c-basic-offset: 4
// tab-width: 4
// End:
// vim: set ft=cpp et ts=4 sw=4:
