tgtakaoka/RetroCyborg/BionicMC6800/debugger/signals.cpp

#include "signals.h"

#include <libcli.h>

#include "digital_fast.h"
#include "pins.h"
#include "regs.h"
#include "string_util.h"

extern libcli::Cli cli;

uint8_t Signals::_cycles;
Signals Signals::_signals[MAX_CYCLES + 1];

void Signals::clear() {
    // fields including _debug will be written in Pins::cycle().
    _inject = _capture = false;
}

void Signals::printCycles(const Signals *end) {
    if (end == nullptr)
        end = &currCycle();
    for (const auto *signals = _signals; signals < end; signals++) {
        signals->print();
        Pins.idle();
    }
}

Signals &Signals::currCycle() {
    return _signals[_cycles];
}

void Signals::resetCycles() {
    _signals[_cycles = 0].clear();
}

void Signals::nextCycle() {
    if (_cycles < MAX_CYCLES)
        _cycles++;
    _signals[_cycles].clear();
}

void Signals::flushWrites(const Signals *end) {
    for (const auto *signals = _signals; signals < end; signals++) {
        if (signals->rw == LOW)
            Memory.write(signals->addr, signals->data);
    }
}

void Signals::getDirection() {
    rw = digitalReadFast(PIN_RW);
    vma = digitalReadFast(PIN_VMA);
}

void Signals::getAddr() {
    addr = busRead(AL)
#if defined(AM_vp)
           | busRead(AM)
#endif
           | busRead(AH);
}

void Signals::getData() {
    data = busRead(D);
}

void Signals::inject(uint8_t val) {
    Signals &curr = currCycle();
    curr._inject = true;
    curr.data = val;
    curr.debug('i');
}

void Signals::capture() {
    Signals &curr = currCycle();
    curr._capture = true;
    curr.debug('c');
}

void Signals::print() const {
    // clang-format off
    static char buffer[] = {
        ' ', ' ',                  // _debug=0
        'V',                       // vma=2
        'W',                       // rw=3
        ' ', 'A', '=', 0, 0, 0, 0, // addr=7
        ' ', 'D', '=', 0, 0,       // data=14
        0,
    };
    // clang-format on
    buffer[0] = _debug;
    buffer[2] = (vma == LOW) ? ' ' : 'V';
    buffer[3] = (rw == LOW) ? 'W' : 'R';
    outHex16(buffer + 7, addr);
    outHex8(buffer + 14, data);
    cli.println(buffer);
}

Signals &Signals::debug(char c) {
    _debug = c;
    return *this;
}

// Local Variables:
// mode: c++
// c-basic-offset: 4
// tab-width: 4
// End:
// vim: set ft=cpp et ts=4 sw=4:
