tgtakaoka/RetroCyborg/(commit log)

2019-03-20 Add empty Prototype1 schematic
    [Prototype1.kicad_pcb, Prototype1.sch]
2019-04-05 Add Arduino sketch for ProtoType1
2019-04-06 Re-organize Prototype1 directory structure
    Prototype1/schematic/<KiCad files>
    /sketch/sketck.ino
    [Prototype1.kicad_pcb, Prototype1.sch]
2019-04-07 Add logisim simulation file
    [simulation.circ]
2019-04-07 Update Prototype1/sketch to 0.1
2019-04-18 Oscilator hold make E high
    This behavior can be achived by controlling E and Q by Arduino.
    [simulation.circ]
2019-04-18 Use Digital simulator instead of Logisim
    https://github.com/hneemann/Digital
    [ClockGenerator.csv, simulation.circ]
2019-04-18 Add Adafruit ItsyBitsy 32u4 5V pins
2019-04-22 Add Prototype1 schematic
    [Prototype1.sch]
2019-04-24 Update clock generator with 7473
    Now clock generator can be made of
    x1 7473 dual JK flip-flop
    x1 7400 quad 2-input NAND
    x1 7402 quad 2-input NOR
    [ClockGenerator.csv]
2019-04-27 Add RAM enable pin
    Only for ItsuBitsy since ProMicro is lacking pin.
2019-04-29 Add 256kB RAM
    [Prototype1.sch]
2019-05-19 Fix 6309E TSC and interrupts connection
    [Prototype1.sch]
2019-05-19 Prepare for Prototype2
    [ClockGenerator.csv, Prototype2.kicad_pcb, Prototype2.sch]
2019-05-30 Clock generator by AVR
    Here two clock generators implemented by ATTiny85 and ATTiny2313 are
    added.
    * ATTiny2313 running with external 20MHz XTAL.
    * has ADR15~ADR6 for detecting I/O address space (0xFFA0~0xFFBF).
    * ATTiny85 running with internl 16MHz PLL
    * has #IOR to report I/O address space.
    * needs setting RSTDISBL fuse which needs HVP to recover.
    Both genarators have functionalities such as
    * Generates E and Q clock nearly 1MHz.
    * Has #STEP input that can stretch E:H/Q:L period when asserted.
    * E clock gets Low by asserting #ACK.
    * Q clock gets High and next cycle starts by negating #ACK.
    * Has I/O address space detection that can stretch E:H/Q:L period.
    * #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
2019-05-30 Add clock generator made by ATTiny2313
    A clock generating ATTiny2313 should run cgen6309e sketch on it.
    [Prototype2.sch]
2019-05-31 Use ATTiny2313 PA2/RESET for #STEP
    [pins.cpp]
2019-05-31 Update ATmega32u4 pin assignment
2019-06-07 Fix cgen6309e/ATtiny2313/ATTiny85 pin configuration
    This CL fixes pin assignment of
    - PA2/RESET of ATTiny2313 from STEP to A6
    - PB5/RESET of ATTiny85 from STEP to IOR
    so that we can optionaly set RSTDISBL fuse while maintaining main
    features of clock generator.
    [Prototype2.sch]
2019-06-07 Copy Prototype1/debugger to Prototype2
2019-06-10 Use ATtiny85 cgen6309e clock generator for Prototype2
    [Prototype2.sch]
2019-06-10 Use PORT/PIN instead of digitalWrite/digitalRead
    Debugger version 1.1
2019-06-12 Use digitalRead and digitalWrite macros instead of PIN/PORT
2019-06-14 Introduce 0-LocalLibrary to Prototype1 and 2
    [Prototype1.sch, Prototype2.kicad_pcb, Prototype2.sch]
2019-06-14 Add ATmega32A (ATmega1284P) pin mapping
2019-06-17 Prototype3 uses ATmega32A (ATmega1284P) as debugger
    [Prototype3.kicad_pcb, Prototype3.sch]
2019-06-20 Use 0.35mm for fill clearance
    [Prototype3.kicad_pcb]
2019-07-12 Add AVR ISP connectors
    [Prototype3.sch]
2019-07-13 Add keepout zones around connector and board edges
    [Prototype3.kicad_pcb]
2019-07-15 Swap ~INT~ and ~DBG_RTS~
    [Prototype3.kicad_pcb, Prototype3.sch]
2019-07-15 Remove BUSY from Prototype 1 and 2
    So that Pro Micro can support both Prototypes.
2019-08-21 Fix load/store register using push/pull
    [commands.cpp, commands.h, pins.cpp, pins.h, regs.cpp]
2019-08-21 Add assembler
2019-08-22 Fix disassemble length as byte length
    [commands.cpp]
2019-09-03 Add pin diagrams
2019-09-13 Update libasm to template version
    Debugger uses HD6309 version for disassemble and MC6809 version for
    assemble.
2019-09-13 Add HM628128DLP pin diagram
2019-09-14 Fix Load command feedback
    Also fix compiler warnings.
    [commands.cpp, regs.cpp]
2019-10-16 Simplify pin map specification
2019-11-16 Add User SW/LED that halt CPU
    [Prototype3.sch]
2019-11-23 Support MC6850 interrupt
    TODO: Send intterrupt should work, though it needs conformations.
2019-11-28 Use Macro Assembler asl instead of sbasm
    http://john.ccac.rwth-aachen.de:8000/as/
2019-12-07 Update libasm as Arduino library
2019-12-18 Re-initialize SD library
    We can eject and insert SD card without reset or power cycling.
    [commands.cpp, debugger.ino]
2019-12-18 Use libasm as Arduino library
2019-12-19 Move target MPU samples to root dir.
2020-01-15 [sample] Get rid of macro
2020-02-01 Add ASCII art mandelblot BASIC sample
2020-02-01 [debugger] Move Mc6850 emulation from debugger to Pins
    Now we can enable/disable #INT interrupt for I/O access depending on
    whether CPU is freely running or not.
2020-02-15 [debugger] Fix Go/Halt/UserSwitch behavior
    [commands.cpp, commands.h, pins.cpp, pins.h]
2020-02-15 [debugger] version 1.9.1
    Fix HALT by user switch and GO behavior.
    [commands.cpp]
2020-03-12 Fix user switch halt
    Check user swicth asserted while in
    - Pins.loop.
    - Before returning virtual I/O handler.
    [commands.cpp, pins.cpp, pins.h]
2020-03-12 [sample] Fix queue_init
2020-04-03 [WIP] Prototyp4
    Use ATmega4809 as debugger, ATtiny3216 as cgen6309e
    [Prototype4.kicad_pcb, Prototype4.sch]
2021-10-28 Rename to RetroCyborg
    Since there are a couple of MPUs to be revived as CyborgHD6309 is
    doing, this repository is renamed as RetroCyborg. The MPUs in plan are
    - HD6309E
    - Z84C00
    - R65C02, W65C02S, W65C816S
    - TMS9995
    - MC68008
    [ClockGenerator.csv, Prototype1.kicad_pcb, Prototype1.sch, Prototype2.kicad_pcb, Prototype2.sch, Prototype3.kicad_pcb, Prototype3.sch, Prototype4.kicad_pcb]
2021-10-28 [Z84C00] Add prototype schematics
    [Prototype1.kicad_pcb, Prototype1.sch]
2021-10-28 [HD6309E] Use ATtiny414 + 7430 + 74688 for clock generator
    [Prototype4.kicad_pcb, Prototype4.sch]
2021-10-28 [HD6309E] Update Arduino IDE setting comment
2021-10-28 Add retro CPU's pin out
    - CDP1802
    - HD6301V/HD6303R
    - INS8060
    - INS8070
    - MC68008P
    - MC6800
    - MC6801/MC6803
    - MC68HC001
    - MC68HC11A0
    - MC68HC11D0
    - NS32016N
    - P8085AH
    - P80C32
    - P80C86A
    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
2021-10-28 Restore CyborgHD6309E/Prototype3 code
2021-10-28 Add NSC800N pin out
    NSC800N has Z80 software architecture and 8051-like hardware signals.
2021-10-28 Add TLCS-90 pin out
2021-10-28 [CyborgZ84C00] update debugger code
    [Prototype1.sch]
2021-10-28 Add CDP1806 pin out taht is identical with CDP1802
2021-10-28 Add MC6802/MC6808 pin out
2021-10-28 Add MC6809/HD6309 pin out
2021-10-28 [CyborgZ84C00] Update schematics symbols
    [Prototype1.kicad_pcb, Prototype1.sch]
2021-10-28 [CyborgHD6309E] Update pin_maps.h and schematics
    - Add DBG_RTS for hard flowcontrol of console.
    - Use port A for data bus and port D for controls.
    [Prototype4.kicad_pcb, Prototype4.sch]
2021-10-28 [CyborgHD6309E] Add sample for HD6309
2021-10-28 [CyborgZ84C00] Update pin mapping
    [Prototype1.kicad_pcb, Prototype1.sch]
2021-10-28 [CyborgHD6309E] Batch capture and print
2021-10-28 [CyborgHD6309E] Refactor Pins.cycle()
    Now HD6309's native mode works correctly.
    [pins.cpp, pins.h, regs.cpp]
2021-10-28 Add Teensy 3.5/4.1, Nano Every pin out
2021-10-28 [CyborgHD6309E] Update pins map
    [Prototype4.kicad_pcb, Prototype4.sch]
2021-10-28 [CyborgHD6309E] Restore Prototype3
    [Prototype3.kicad_pcb, Prototype3.sch]
2021-10-28 [CyborgHD6309E] Update Prototype3 to libcli 1.0.4
    [Prototype3.sch]
2021-10-28 [CyborgHD6309E] Reorganize Prototype4
    [Prototype4.kicad_pcb, Prototype4.sch]
2021-10-28 [CyborgHD6309E] Update Prototype4 pins to compatible with Prototype5
2021-10-28 [CyborgHD6309E] Add Prototype5
    [Prototype5.kicad_pcb, Prototype5.sch]
2021-10-28 [CynorgHD6309E] Add board pin map
2021-10-28 [CyborgHD6309E] Update Prototype3 pins
    [Prototype3.kicad_pcb, Prototype3.sch]
2021-10-28 [CyborgHD6309E] Prototype3 modify pins map
2021-10-28 [CyborgHD6309E] Update Prototype3 debugger to 2.1.0
    Import debugger from Prototype4 and now Prototype can handle HD6309E
    correctly.
    [commands.cpp, debugger.ino, pins.cpp, pins.h, regs.cpp, regs.h]
2021-10-28 [CyborgHD6309E] Consolidate Prototype3/4 debugger
2021-10-28 [CyborgHD6309E] Modify Prototype4 pin maps to upcomming Prototype5
    [Prototype4.kicad_pcb, Prototype4.sch]
2021-10-28 [CyborgHD6309E] Prototype4/cgen6309e PlatformIO supported
2021-10-28 [CyborgHD6309E] Add Prototype5 cgen6309e-test
2021-10-28 [CyborgHD6309E] Copy debugger to Prototype5
2021-10-28 [CyborgHD6309E] Prorotype5 debugger
    [Prototype3.kicad_pcb, Prototype4.kicad_pcb, Prototype5.kicad_pcb, Prototype5.sch]
2021-10-28 [CyborgHD6309E] Fix register endian handling
    Values in captured buffer from stack frame is little endian which is
    accidentally equals to AVR's endianess.
    [commands.cpp, regs.cpp, regs.h]
2021-10-28 [BionicHD6303] Add clock generator test running on Teensy 3.5
2021-10-28 [BionicMC6803] Add schematics
    [Prototype1.kicad_pcb, Prototype1.sch]
2021-10-29 [BionicMc6803] Add MC6801 SCI handler and samples
2021-10-29 [BionicMc6803] Add switching IO device command
2021-10-29 [BionicHD6303] Add schematic
    [Prototype1.kicad_pcb, Prototype1.sch]
2021-10-29 [BionicHD6303] Replace MC6803 name with HD6303
    [config.h, debugger.ino, pins.cpp, pins.h]
2021-10-29 [BionicMC6803/HD6303] Fix bus injection timing
    [pins.cpp]
2021-10-29 [BionicMC6803/BionicHD6303] Update samples
2021-10-29 [CyborgHD6309E] Update sample
2021-10-29 [BionicMC146805E] Add schematics
    [Prototype1.kicad_pcb, Prototype1.sch]
2021-10-29 [BionicMC146805E] Fixup for MC146805E
    [commands.cpp, config.h, debugger.ino, pins.cpp, pins.h, regs.cpp, regs.h, signals.cpp]
2021-10-29 [BionicMC146805E] Add MC6850 sample
2021-10-29 [BionicMC6802] Add schematics
    [Prototype1.kicad_pcb, Prototype1.sch]
2021-10-29 [BionicMC6802] Fixup for MC6802/MC6808
    [commands.cpp, config.h, debugger.ino, digital_fast.h, pins.cpp, pins.h, regs.cpp, regs.h]
2021-10-29 [BionicMC6802] Add MC6850 ACIA samples
2021-11-08 [BionicMC6803] Update to BionicBase/Teensy35 configuration
    [Prototype1.kicad_pcb, Prototype1.sch]
2021-11-08 [BionicHD6303] Update to BionicBase/Teensy35 configuration
    [Prototype1.kicad_pcb, Prototype1.sch]
2021-11-08 [BionicMC146805E] Update to BionicBase/Teensy35 configuration
    [Prototype1.kicad_pcb, Prototype1.sch]
2021-11-08 [BionicMC6802] Update to BionicBase/Teensy35 configuration
    [Prototype1.kicad_pcb, Prototype1.sch]
2021-11-28 [BionicBase] Add schematics
    [Prototype1.kicad_pcb, Prototype1.sch, ZIF-Socket-40-pin.stp, ZIF-Socket-48-pin.stp]
2021-11-28 [BionicMezzanine] Add schematics
    [Prototype1.kicad_pcb, Prototype1.sch, ZIF-Socket-40-pin.stp, ZIF-Socket-48-pin.stp]
2021-11-28 [BionicMC6803] Mezzanine board
    [Prototype1.kicad_pcb, Prototype1.sch]
2021-11-28 [BionicHD6303] Mezzanine board
    [Prototype1.kicad_pcb, Prototype1.sch]
2021-11-28 [BionicMC146805E] Mezzanine board
    [Prototype1.kicad_pcb, Prototype1.sch]
2021-11-28 [BionicMC6802] Mezzanine board
    [Prototype1.kicad_pcb, Prototype1.sch]
2021-11-28 [BionicMC6809] Add schematics
    [Prototype1.kicad_pcb, Prototype1.sch]
2021-11-28 [BionicMC6809] Fixup for MC6809
    [commands.cpp, config.h, debugger.ino, pins.cpp, regs.cpp, regs.h, signals.cpp, signals.h]
2021-11-28 [BionicMC6809] Add MC6850 samples
2021-11-28 [BionicMC6809E] Copy BionicMC6809 project
    [Prototype1.kicad_pcb, Prototype1.sch]
2021-11-28 [BionicMC6809E] Mezzanine board
    [Prototype1.kicad_pcb, Prototype1.sch]
2021-11-28 [BionicMC6800] Copy from BionicMC6802
    [Prototype1.kicad_pcb, Prototype1.sch]
2021-11-28 [BionicMC6800] Mezzanine board
    [Prototype1.kicad_pcb, Prototype1.sch]
2021-11-28 [Teensy4.1] Do not use TEENSY_OPT_FASTEST_LTO
2021-11-28 [BionicMC6803] Add Teensy 4.1 breadboard and mezzanine
2021-11-28 [BionicHD6303] Add Teensy 4.1 breadboard and mezzanine
2021-11-28 [BionicMC146805E] Add Teensy 4.1 breadboard and mezzanine
2021-11-28 [BionicMC6802] Add Teensy 4.1 breadboard and mezzanine
2021-11-28 [BionicMC6809E] Add Teensy 4.1 breadboard and mezzanine
2021-11-28 [BionicMC6809] Add Teensy 4.1 breadboard and mezzanine
2021-11-28 [BionicMC6800] Add Teensy 4.1 breadboard and mezzanine
2021-11-28 [BionicMC6802] Add jumper pin to disable internal RAM
    This CL also make RE pin input from the jumper pin and can switch
    between MC6802 and MC6808.
    [Prototype1.kicad_pcb, Prototype1.sch]
2021-11-29 [BionicMC68HC11D] Add schematics
    [Prototype1.kicad_pcb, Prototype1.sch]
2021-11-29 [BionicMC68HC11D] Add samples from BionicMC6801
2021-11-29 [BionicMC68HC11D] Fixup samples for MC68HC11D
2021-11-29 [BionicMC68HC11D] Refactor samples to use 6811 instructions
2021-11-29 [BionicMC6801] Consolidate with BionicHD6303
    And renamed to BionicMC6801
    [Prototype1.kicad_pcb, Prototype1.sch]
2021-12-04 [BionicMC6801] Tune bus cycle
    - Teensy 4.1: EXTAL ~3.5MHz, E ~880kHz
    - Teensy 3.5: EXTAL ~1.2MHz, E ~300kHz
2021-12-04 [BionicMC146805E] Tune bus cycle
    - Teensy 4.1: OSC1 ~ 4MHz, AS/DS ~ 800kHz
    - Teensy 3.5: OSC1 ~ 1MHz, AS/DS ~ 200kHz
    [Prototype1.kicad_pcb, Prototype1.sch]
2021-12-04 [BionicMC6802] Tune bus cycle
    - Teensy 4.1: EXTAL ~ 3.5MHz, E ~ 880kHz
    - Teensy 3.5: EXTAL ~ 1.0MHz, E ~ 250kHz
2021-12-04 [BionicMC6800] Fix to drive DBE
    [commands.cpp, config.h, digital_fast.h, pins.cpp, regs.cpp, string_util.cpp, string_util.h]
2021-12-04 [BionicMC6800] Tune bus cycle
    - Teensy4.1: PHI ~ 900kHz
    - Teensy3.5: PHI ~ 260kHz
    [Prototype1.kicad_pcb]
2021-12-06 [BionicMC6809] Tune bus cycle
    - Teensy 4.1: Q/E ~ 780kHz
    - Teensy 3.5: Q/E ~ 250kHz
    [Prototype1.kicad_pcb, Prototype1.sch]
2021-12-06 [BionicMC6809E] Tune bus cycle
    - Teensy 4.1: Q/E ~ 1.0MHz
    - Teensy 3.5: Q/E ~ 230kHz
    [Prototype1.kicad_pcb, Prototype1.sch]
2021-12-06 [BionicMC68HC11D] Fixup for MC68HC11
    - Teensy 4.1: E ~ 780kHz
    - Teensy 3.5: E ~ 250kHz
    [commands.cpp, config.h, debugger.ino, mc68hc11_sci_handler.h, pins.cpp, pins.h, regs.cpp, regs.h]
2021-12-12 [CyborgHD6309E] Refactor print out
2022-02-01 [BionicINS8070] Add schematics
    [Prototype1.kicad_pcb, Prototype1.sch]
2022-02-01 [BionicINS8070] Fixup for INS8070
    [commands.cpp, config.h, debugger.ino, pins.cpp, pins.h, regs.cpp, regs.h, signals.cpp]
2022-02-01 [BionicINS8070] Add samples
2022-02-01 Refactor Commands class
    - refactor out assembler/disassembler to regs.cpp
    - refactor out device to Pins
2022-02-01 [BionicMOS6502] Add schematics
    [Prototype1.kicad_pcb, Prototype1.sch]
2022-02-01 [BionicMOS6502] Add samples
2022-02-01 [BionicMOS6502] Fixup for MOS6502 and variants
    TODO: support native mode of W65C816S.
    [config.h, pins.cpp, pins.h, regs.cpp, regs.h, signals.cpp, signals.h]
2022-02-01 [BionicMOS6502] Add bypass capaciters to prevent sprious #NMI
    [Prototype1.kicad_pcb, Prototype1.sch]
2022-02-12 [BionicINS8070] Add INS8070 software UART handler
    NSC Tiny Basic (INS8073) implements console using F1 as #TxD and SA as
    RxD.
2022-02-12 Fix Bionic connector pin outs
    [Prototype1.kicad_pcb, Prototype1.sch]
2022-02-12 Add other schematics
    - BionicCDP1802
    - BionicINS8060
    - BionicMC68008
    - BionicMN1613
    - BionicNS32016
    - BionicNSC800
    - BionicP8048
    - BionicP8051
    - BionicP8085
    - BionicP8086
    - BionicP8088
    - BionicTMP90P802
    - BionicTMS32010
    - BionicTMS99105
    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
    [Prototype1.kicad_pcb, Prototype1.sch]
2022-02-12 [BionicINS8060] Fixup for INS8060
    [commands.cpp, config.h, pins.cpp, pins.h, regs.cpp, regs.h, signals.cpp, signals.h]
2022-02-12 [BionicINS8060] Add bitbang soft UART handler
    Some INS8060 software, for example NIBL Tiny Basic, uses
    FLAG0(inverted TxD) and SENSEB(RxD) as serial IO.
    This handler currently supports only 110 and 1200 bps and inverted
    TxD.
    [pins.cpp, pins.h]
2022-02-12 [BionicINS8060] Add samples
2022-02-12 Fix interrupt sample code
2022-02-12 [Regs] Move assemble code from Commands
2022-02-12 [BionicCDP1802] Fixup for CDP1802
    [config.h, pins.cpp, pins.h, regs.cpp, regs.h, signals.cpp, signals.h]
2022-02-12 [BionicCDP1802] Add bitbang software UART handler
2022-02-12 [BionicCDP1802] Add RCA Basic 3 and sample
    From http://www.sunrise-ev.com/1802.htm
    - I)o Bitbang
    - L)oad MCBASCI3.HEX
    - R)eset and Go)
    - Type carriage return key, and type 'C' for cold start
2022-02-12 [BionicCDP1802] Add sample code
2022-02-12 [CyborgHD6309E] Make Prototype5 final
    [Prototype5.kicad_pcb, Prototype5.sch]
2022-02-12 Fix char signess issue
    [commands.cpp]
2022-02-12 [BionicMC6800/BionicMC6802] Fix bus signal print
    [signals.cpp]
2022-07-18 Add P8095BH pin out
2022-07-18 [BionicP8095] Add schematics
    [Prototype1.kicad_pcb, Prototype1.sch]
2022-07-18 Add uPD70116/uPD70108 (V30/V20) pin out
2022-07-18 Add SCN2650 pin out
2022-07-18 [BionicSCN2650] Add schematics
    [Prototype1.kicad_pcb, Prototype1.sch]
2022-10-26 Migrate to KiCad 6.0
    [Prototype1.kicad_pcb, Prototype1.kicad_sch, Prototype1.sch, Prototype3.kicad_pcb, Prototype3.kicad_sch, Prototype3.sch, Prototype4.kicad_pcb, Prototype4.kicad_sch]
2022-10-26 [BionicBase] Fix Teensy 4.1 base board
    [Prototype1.kicad_pcb, Prototype1.kicad_sch]
2023-03-16 [BionicBase] Add schematics using surface mount devices
    [Prototype1.kicad_pcb, Prototype1.kicad_sch, ZIF-Socket-40-pin.stp, ZIF-Socket-48-pin.stp]
2023-03-16 Satisfy Electrical Rules Checker
    [Prototype1.kicad_sch, Prototype3.kicad_sch, Prototype4.kicad_sch, Prototype5.kicad_sch]
2023-03-16 [CyborgHD6309] Fix old PORTMUX constants
    https://forum.arduino.cc/t/old-iom4809-header-file-is-used/699152
    [pins.cpp]
2023-05-18 [BionicP8085] Fixup for P8085
    [config.h, debugger.ino, pins.cpp, pins.h, regs.cpp, regs.h, signals.cpp]
2023-05-18 [BioniocP8085] Add SIO sample
2023-06-23 [BionicZ8691] Add Port2 connections
    [Prototype1.kicad_pcb, Prototype1.kicad_sch]
2023-09-18 [BionicZ8691] Fixup for Z86C91
    [config.h, pins.cpp, pins.h, regs.cpp, regs.h, signals.cpp]
2023-09-18 [BionicZ8691] Support interrupt acknowledge
2023-11-26 [BionicZ8691] Add Z8 SIO Handler and sample sources
2023-11-26 [TMS7000] Add TMS7000 pin out
2023-11-26 [IM6100] Add IM6100 pin out
2023-11-26 [HD-6120] Add HD-6120 pin out
2023-11-26 [TMS9981] Add TMS9981 pin out
2023-11-26 [BionicZ8800] Fixup for Z88C00
    [commands.cpp, config.h, pins.cpp, pins.h, regs.cpp, regs.h, signals.cpp]
2023-11-26 [BionicZ8800] Add upload command
    Add 'U' (Upload) command to upload Intel Hex or Motorola S-record from console.
2023-11-26 [BionicZ8800] Add Z88C00 UART handler
2023-11-26 [BionicSCN2650] Remove 74HCT126
    [Prototype1.kicad_pcb, Prototype1.kicad_sch]
2023-11-26 [BionicSCN2650] Fixup for SCN2650
    [config.h, i8251.cpp, i8251.h, pins.cpp, pins.h, regs.cpp, regs.h]
2023-11-26 [BionicBase] Add DC-DC Converter for +15V
    [Prototype1.kicad_pcb, Prototype1.kicad_sch]
2023-12-05 [BionicTLCS90] Rename from BionicTMP90P802
    [Prototype1.kicad_pcb, Prototype1.kicad_sch]
2023-12-06 [BionicTLCS90] Fixup for TLCS90
    [commands.cpp, config.h, i8251.cpp, i8251.h, pins.cpp, pins.h, regs.cpp]
2023-12-06 [BionicTLCS90] Add TLCS90 UART Handler
2023-12-07 [BionicF3850] Add F3850 Bionic prototype
    [Prototype1.kicad_pcb, Prototype1.kicad_sch]
2023-12-22 [BionicF3850] Fixup for F3850
    [commands.cpp, config.h, i8251.cpp, i8251.h, pins.cpp, pins.h, regs.cpp]
2023-12-22 Remove Teensy 3.5
2023-12-22 [BionicBase] Add ID EEPROM and change SW and LED conections
    [Prototype1.kicad_pcb, Prototype1.kicad_sch, ZIF-Socket-40-pin.stp, ZIF-Socket-48-pin.stp]
2023-12-29 Split CyborgHD6309E and CyborgZ84C00 repositories
    https://github.com:tgtakaoka/CyborgHD6309E.git
    https://github.com:tgtakaoka/CyborgZ84C00.git
    Using git subtree command.
    See https://medium.com/@jeevansathisocial/extract-subdirectory-from-git-repository-without-losing-history-3de8aed359a4
    [Prototype1.kicad_pcb, Prototype1.kicad_sch, Prototype3.kicad_pcb, Prototype3.kicad_sch, Prototype4.kicad_pcb, Prototype4.kicad_sch, Prototype5.kicad_pcb, Prototype5.kicad_sch]
2024-01-09 [BionicCDP1802] Update schematics
    Remove pullup registers
    [Prototype1.kicad_pcb, Prototype1.kicad_sch]
2024-02-20 [CDP1802] Move schematics directory
    [bionic-cdp1802.kicad_pcb, bionic-cdp1802.kicad_sch]
2024-02-21 [F3850] Move schematics directory
    [bionic-f3850.kicad_pcb, bionic-f3850.kicad_sch]
2024-02-21 [INS8060] Move schematics directory
    [Prototype1.kicad_pcb, bionic-ins8060.kicad_pcb, bionic-ins8060.kicad_sch]
2024-02-21 [INS8070] Move schematics directory
    [Prototype1.kicad_pcb, bionic-ins8070.kicad_pcb, bionic-ins8070.kicad_sch]
2024-02-21 [MC146805E2] Move schematics directory
    [Prototype1.kicad_pcb, bionic-mc146805e2.kicad_pcb, bionic-mc146805e2.kicad_sch]
2024-02-21 [MC6800] Move schematics directory
    [Prototype1.kicad_pcb, bionic-mc6800.kicad_pcb, bionic-mc6800.kicad_sch]
2024-03-21 [MC6801] Move schematics directory
    [Prototype1.kicad_pcb, bionic-mc6801.kicad_pcb, bionic-mc6801.kicad_sch]
2024-03-21 [MC6802] Move schematics directory
    [bionic-mc6802.kicad_pcb, bionic-mc6802.kicad_sch]
2024-03-21 [MC6809] Move schematics directory
    [Prototype1.kicad_pcb, bionic-mc6809.kicad_pcb, bionic-mc6809.kicad_sch]
2024-03-21 [MC6809E] Move schematics directory
    [Prototype1.kicad_pcb, bionic-mc6809e.kicad_pcb, bionic-mc6809e.kicad_sch]
2024-03-21 [MC68HC11D] Move schematics directory
    [Prototype1.kicad_pcb, Prototype1.kicad_sch, bionic-mc68hc11d.kicad_pcb, bionic-mc68hc11d.kicad_sch]
2024-03-21 [MOS6502] Move schematics directory
    [Prototype1.kicad_pcb, Prototype1.kicad_sch, bionic-mos6502.kicad_pcb, bionic-mos6502.kicad_sch]
2024-03-21 [P8085] Move schematics directory
    [Prototype1.kicad_pcb, bionic-p8085.kicad_pcb, bionic-p8085.kicad_sch]
2024-03-21 [SCN2650] Move schematics directory
    [Prototype1.kicad_pcb, bionic-scn2650.kicad_pcb, bionic-scn2650.kicad_sch]
2024-03-21 [TMP90C802] Move schematics directory
    [Prototype1.kicad_pcb, bionic-tmp90c802.kicad_pcb, bionic-tmp90c802.kicad_sch]
2024-03-21 [Z8691] Move schematics directory
    [Prototype1.kicad_pcb, bionic-z8691.kicad_pcb, bionic-z8691.kicad_sch]
2024-03-21 [Z8800] Move schematics directory
    [Prototype1.kicad_pcb, bionic-z8800.kicad_pcb, bionic-z8800.kicad_sch]
2024-03-21 [MC68008] Move schematics directory
    [Prototype1.kicad_pcb, bionic-mc68008.kicad_pcb, bionic-mc68008.kicad_sch]
2024-03-21 [MN1613] Move schematics directory
    [Prototype1.kicad_pcb, bionic-mn1613.kicad_pcb, bionic-mn1613.kicad_sch, bionic-mn1613a.kicad_pcb, bionic-mn1613a.kicad_sch]
2024-03-21 [NS32016] Move schematics directory
    [Prototype1.kicad_pcb, bionic-ns32016.kicad_pcb, bionic-ns32016.kicad_sch]
2024-03-21 [NSC800] Move schematics directory
    [Prototype1.kicad_pcb, bionic-nsc800.kicad_pcb, bionic-nsc800.kicad_sch]
2024-03-21 [P8048] Move schematics directory
    [Prototype1.kicad_pcb, Prototype1.kicad_sch, bionic-p8048.kicad_pcb, bionic-p8048.kicad_sch]
2024-03-21 [P8051] Move schematics directory
    [Prototype1.kicad_pcb, Prototype1.kicad_sch, bionic-p8051.kicad_pcb, bionic-p8051.kicad_sch]
2024-03-21 [P8086] Move schematics directory
    [Prototype1.kicad_pcb, Prototype1.kicad_sch, bionic-p8086.kicad_pcb, bionic-p8086.kicad_sch]
2024-03-21 [P8095] Move schematics directory
    [Prototype1.kicad_pcb, Prototype1.kicad_sch, bionic-p8095.kicad_pcb, bionic-p8095.kicad_sch]
2024-03-21 [TMS32010] Move schematics directory
    [Prototype1.kicad_pcb, bionic-tms32010.kicad_pcb, bionic-tms32010.kicad_sch]
2024-03-21 [TMS99105] Move schematics directory
    [Prototype1.kicad_pcb, bionic-tms99105.kicad_pcb, bionic-tms99105.kicad_sch]
2024-03-21 [TMS9995] Move schematics directory
    [Prototype1.kicad_pcb, bionic-tms9995.kicad_pcb, bionic-tms9995.kicad_sch]
2024-03-21 [Z8001] Move schematics directory
    [Prototype1.kicad_pcb, bionic-z8001.kicad_pcb, bionic-z8001.kicad_sch]
2024-03-21 [Z8002] Move schematics directory
    [Prototype1.kicad_pcb, bionic-z8002.kicad_pcb, bionic-z8002.kicad_sch]
2024-03-21 [Z80] Move schematics directory
    [Prototype1.kicad_pcb, bionic-z80.kicad_pcb, bionic-z80.kicad_sch]
2024-03-21 [IM6100] Add IM6100 Bionic Prototype
    [bionic-im6100.kicad_pcb, bionic-im6100.kicad_sch]
2024-03-21 [HD6120] Add HD-6120 Bionic prototype
    [bionic-hd6120.kicad_pcb, bionic-hd6120.kicad_sch]
2024-03-21 [TMS9981] Add TMS9981 bionic prototype
    [bionic-tms9981.kicad_pcb, bionic-tms9981.kicad_sch]
2024-03-21 [TMS7000] Add TMS7000 Bionic prototype
    [bionic-tms7000.kicad_pcb, bionic-tms7000.kicad_sch]
2024-03-21 Remove mezzanine board schematics
    [Prototype1.kicad_pcb, Prototype1.kicad_sch, ZIF-Socket-40-pin.stp, ZIF-Socket-48-pin.stp]
2024-03-21 [Base] Move schematics directory
    [ZIF-Socket-40-pin.stp, ZIF-Socket-48-pin.stp, base.kicad_pcb, base.kicad_sch, universal.kicad_pcb, universal.kicad_sch]
2024-03-21 [CDP1802] Remove HC126
    [bionic-cdp1802.kicad_pcb, bionic-cdp1802.kicad_sch]
2024-03-21 [F3850] Remove HC126
    [bionic-f3850.kicad_pcb, bionic-f3850.kicad_sch]
2024-03-21 [INS8060] Remove HC126
    [bionic-ins8060.kicad_pcb, bionic-ins8060.kicad_sch]
2024-03-21 [INS8070] Remove HC126
    [bionic-ins8070.kicad_pcb, bionic-ins8070.kicad_sch]
2024-03-21 [MC146805E2] Remove HC126
    [bionic-mc146805e2.kicad_pcb, bionic-mc146805e2.kicad_sch]
2024-03-21 [MC6800] Remove HC126
    [bionic-mc6800.kicad_pcb, bionic-mc6800.kicad_sch]
2024-03-21 [MC6801] Remove HC126
    [bionic-mc6801.kicad_pcb, bionic-mc6801.kicad_sch]
2024-03-21 [MC6802] Remove HC126
    [bionic-mc6802.kicad_pcb, bionic-mc6802.kicad_sch]
2024-03-21 [MC6809] Remove HC126
    [bionic-mc6809.kicad_pcb, bionic-mc6809.kicad_sch]
2024-03-21 [MC6809E] Remove HC126
    [bionic-mc6809e.kicad_pcb, bionic-mc6809e.kicad_sch]
2024-03-21 [MC68HC11D] Remove HC126
    [bionic-mc68hc11d.kicad_pcb, bionic-mc68hc11d.kicad_sch]
2024-03-21 [MOS6502] Remove HC126
    [bionic-mos6502.kicad_pcb, bionic-mos6502.kicad_sch]
2024-03-21 [P8085] Remove HC126
    [bionic-p8085.kicad_pcb, bionic-p8085.kicad_sch]
2024-03-21 [TMP90C802] Remove HC126
    [bionic-tmp90c802.kicad_pcb, bionic-tmp90c802.kicad_sch]
2024-03-21 [Z8691] Remove HC126
    [bionic-z8691.kicad_pcb, bionic-z8691.kicad_sch]
2024-03-21 [Z8800] Remove HC126
    [bionic-z8800.kicad_pcb, bionic-z8800.kicad_sch]
